crazyskater9/Diplomarbeit/5_TTVerstaerker.tex

\newpage
\section{Tieftöner-Verstärker}\label{kap:5.3}
\subsection{Allgemeines}\label{kap:5.3.1}
Nach dem Filtern des Signals soll dieses vor dem Abstrahlen am Lautsprecher verstärkt werden. Es wurde eine analoge Verstärker-Schaltung verwendet, da diese einfacher und mit weniger Problemen realisiert werden hat können. Mit Hilfe bereits bekannter, bewährter Schaltungen konnte ein Layout für diese Schaltung designet werden. Ein wichtiger Baustein in dieser Schaltung ist der Verstärker \enquote{TDA2030}, wie in Kapitel \ref{kap:5.3.3} beschrieben.  Des weiteren wurden zwei Leistungstransistoren verbaut die höhere Ströme schalten können, falls der maximale Schaltstrom des TDA2030 erreicht wird.

\subsection{Zielsetzung}\label{kap:5.3.2}
Das Eingangssignal soll Verstärkt werden um am Ausgang der Schaltung höhere Spannungs-Amplituden und höheren Ströme aufzuweisen. Es soll nach diesem Schritt möglich sein den Tieftöner in einer der zwei Satellitenboxen mit ausreichend Signal zu versorgen, um einen Schalldruck von zumindest Zimmerlautstärke zu erhalten. 

\subsection{TDA2030}\label{kap:5.3.3}
Der TDA2030 ist ein für den Audio-Frequenzbereich optimierter OPV. Dieser kann symmetrisch sowie auch asymmetrisch versorgt werden. Eine typische Beschaltung ist im Datenblatt auch vorgegeben, welche auch verwendet wurde. Der TDA2030 besitzt ein Pentawatt-Gehäuse, welches deshalb auch eine Kühlfläche besitzt. Diese Kühlfläche hat das selbe Potential wie der mittlere Anschlusspin (Abb. \ref{5.3.3.1}).\\
Es wird auch für geringfügigen Betrieb ein Kühlkörper empfohlen!
\begin{figure} [ht]
	\centering
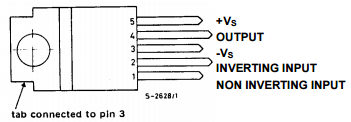
[picture p10: img/Print5/TDA2030Pinning.PNG]
	
	\caption{TDA2030-Pinning}
	\label {fig:abb5.3.3.1}
\end{figure}
\subsubsection{Absolute Maximalwerte}
Diese Werte wurden zu aller erst mit den Bedingungen an der Schaltung verglichen, da sie ein sehr genaue, kurze Übersicht über den Baustein liefern.
\begin{figure} [ht]
	\centering
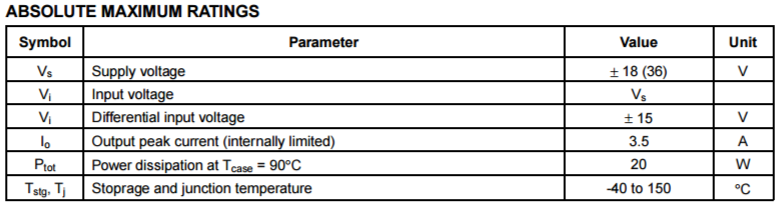
[picture p11: img/Print5/TDA2030MaximumRatings.PNG]
	
	\caption{TDA2030-Pinning}
	\label {fig:abb5.3.3.2}
\end{figure}

\begin{comment}
\begin{figure} [ht]
	\centering	
	
	\caption{Butterworth-Hochpass-Filter 2. Ordnung}
	\label {fig:abb5.2.3.2}
\end{figure}

\subsection{Schaltung}\label{kap:5.2.4}

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

\subsection{PCB}\label{kap:5.2.5}
Es wurden die grundlegenden Regeln zur Leiterplattenentflechtung angewandt (\ref{}). Bei dem Design (Abb. \ref{fig:abb5.2.5.1}) wurde auf hohe Variierbarkeit geachtet um auch zB. Kondensatoren mit unterschiedlichen Footprint verwenden zu können.\\
Es wurden wieder nahe an den IC's ELKOs in der Spannungsversorgungsleitung verbaut, um Störungen zu verhindern.

\begin{figure} [ht]
	\centering	
	
	\caption{Tieftöner- und Hochtönerweichen - PCB}
	\label {fig:abb5.2.5.1}
\end{figure}

\begin{comment}
%% Altium und Einstellungserklärung + Wichtige Layout-Faktoren
%Beim designen des Leiterplattenlayouts wurden die allgemeinen Altium-Einstellungen vorgenommen und auf die zu berücksichtigenden Layoutpunkte geachtet.
Beim \enquote{Layouten} der Schaltung mussten einige wichtige Faktoren berücksichtigt werden.\\
Wie da wären:\\
\begin{itemize}
	\item EMV-Technische-Faktoren, wie kurze Leiterbahnen
	\item Ausnützen der Printfläche
	\item Mehrfach-Footprints ermöglichen für verschiedene Bauteile
	\item Mechanische Aufhängebohrungen vorsehen
	\item Massefläche bei Möglichkeit vorsehen
\end{itemize}
Leiterplattenspezifische Einstellungen wurden aus den Kriterien der schuleigenen Leiterplattenfertigung übernommen. Zu diesen Einstellungen zählen:\\
\begin{itemize}
	\item Leiterbahnbreite
	\item Leiterbahnabstände untereinander
	\item Restring bei Bohrungen
	\item 
\end{itemize}
\end{comment}
