crazyskater9/Diplomarbeit/tex/Anhang.tex

\section{Arbeitsnachweis}\label{sec:8.9}
\responsible{Markus Bointner}
\subsection{Aufschlüsselung - Bointner}
\begin{figure} [H]
	\centering
	
\end{figure}
\begin{figure} [H]
	\centering
	
\end{figure}
\begin{figure} [H]
	\centering
	
\end{figure}

\newpage
\responsible{Andreas Macsek}
\subsection{Aufschlüsselung - Macsek}
\begin{figure} [H]
	\centering
	
\end{figure}
\begin{figure} [H]
	\centering
	
\end{figure}
\begin{figure} [H]
	\centering
	
\end{figure}

\newpage
\section{Fertigungsunterlagen - Elektronik}\label{sec:8.10}
\subsection{0\_BTAdapter}
\subsubsection*{Schaltung}
\begin{figure} [H]
	\centering
	
	\caption{0\_BTAdapter - Schaltung}
	\label {fig:8.10.1}
\end{figure}

\newpage
\subsubsection*{Bestückungsplan}
\begin{figure} [H]
	\centering
	
	\caption{0\_BTAdapter - Bestückungsplan}
	\label {fig:8.10.2}
\end{figure}

\subsubsection*{Stückliste}
\begin{figure} [H]
	\centering
	
	\caption{0\_BTAdapter - Stückliste}
	\label {fig:8.10.3}
\end{figure}

\subsection{1\_BTFrontplatine}
\subsubsection*{Schaltung}
\begin{figure} [H]
	\centering
	
	\caption{1\_BTFrontplatine - Schaltung}
	\label {fig:8.10.4}
\end{figure}

\newpage
\subsubsection*{Bestückungsplan}
\begin{figure} [H]
	\centering
	
	\caption{1\_BTFrontplatine - Bestückungsplan}
	\label {fig:8.10.5}
\end{figure}
\subsubsection*{Stückliste}
\begin{figure} [H]
	\centering
	
	\caption{1\_BTFrontplatine - Stückliste}
	\label {fig:8.10.6}
\end{figure}

\begin{sidewaysfigure}
	\subsection{2\_Hauptplatine}
	\subsubsection*{Schaltung}
	\begin{figure} [H]
		\centering
		
		\caption{2\_Hauptplatine - Schaltung}
		\label {fig:8.10.7}
	\end{figure}
\end{sidewaysfigure}

\begin{sidewaysfigure}
	\subsubsection*{Bestückungsplan}
	\begin{figure} [H]
		\centering
		
		\caption{2\_Hauptplatine - Bestückungsplan}
		\label {fig:8.10.8}
	\end{figure}
\end{sidewaysfigure}

\begin{sidewaysfigure}
	\subsubsection*{Stückliste}
	\begin{figure} [H]
		\centering
		
		\caption{2\_Hauptplatine - Stückliste}
		\label {fig:8.10.9}
	\end{figure}
\end{sidewaysfigure}

\begin{sidewaysfigure}
	\subsection{3\_mTT-Weiche und Addierer}
	\subsubsection*{Schaltung}
	\begin{figure} [H]
		\centering
		
		\caption{3\_mTT-Weiche und Addierer - Schaltung}
		\label {fig:8.10.10}
	\end{figure}
\end{sidewaysfigure}

\begin{sidewaysfigure}
	\subsubsection*{Bestückungsplan}
	\begin{figure} [H]
		\centering
		
		\caption{3\_mTT-Weiche und Addierer - Bestückungsplan}
		\label {fig:8.10.11}
	\end{figure}
\end{sidewaysfigure}

\begin{sidewaysfigure}
	\subsubsection*{Stückliste}
	\begin{figure} [H]
		\centering
		
		\caption{3\_mTT-Weiche und Addierer - Stückliste}
		\label {fig:8.10.12}
	\end{figure}
\end{sidewaysfigure}

\begin{sidewaysfigure}
	\subsection{4\_HTundTT-Weiche}
	\subsubsection*{Schaltung}
	\begin{figure} [H]
		\centering
		
		\caption{4\_HTundTT-Weiche - Schaltung}
		\label {fig:8.10.13}
	\end{figure}
\end{sidewaysfigure}

\begin{sidewaysfigure}
	\subsubsection*{Bestückungsplan}
	\begin{figure} [H]
		\centering
		
		\caption{4\_HTundTT-Weiche - Bestückungsplan}
		\label {fig:8.10.14}
	\end{figure}
\end{sidewaysfigure}

\begin{sidewaysfigure}
	\subsubsection*{Stückliste}
	\begin{figure} [H]
		\centering
		
		\caption{4\_HTundTT-Weiche - Stückliste}
		\label {fig:8.10.15}
	\end{figure}
\end{sidewaysfigure}

\begin{sidewaysfigure}
	\subsection{5\_TTVerstärker}
	\subsubsection*{Schaltung}
	\begin{figure} [H]
		\centering
		
		\caption{5\_TTVerstärker - Schaltung}
		\label {fig:8.10.16}
	\end{figure}
\end{sidewaysfigure}

\begin{sidewaysfigure}
	\subsubsection*{Bestückungsplan}
	\begin{figure} [H]
		\centering
		
		\caption{5\_TTVerstärker - Bestückungsplan}
		\label {fig:8.10.17}
	\end{figure}
\end{sidewaysfigure}

\begin{sidewaysfigure}
	\subsubsection*{Stückliste}
	\begin{figure} [H]
		\centering
		
		\caption{5\_TTVerstärker - Stückliste}
		\label {fig:8.10.18}
	\end{figure}
\end{sidewaysfigure}

\begin{sidewaysfigure}
	\subsection{6\_HTVerstärker}
	\subsubsection*{Schaltung}
	\begin{figure} [H]
		\centering
		
		\caption{6\_HTVerstärker - Schaltung}
		\label {fig:8.10.19}
	\end{figure}
\end{sidewaysfigure}

\subsubsection*{Bestückungsplan}
	\begin{figure} [H]
		\centering
		
		\caption{6\_HTVerstärker - Bestückungsplan}
		\label {fig:8.10.20}
	\end{figure}

\begin{sidewaysfigure}
	\subsubsection*{Stückliste}
	\begin{figure} [H]
		\centering
		
		\caption{6\_HTVerstärker - Stückliste}
		\label {fig:8.10.21}
	\end{figure}
\end{sidewaysfigure}

\newpage
\section{Fertigungsunterlagen - Mechanik}\label{sec:8.11}
Es wurden 19 mm Rohspanplatten verwendet.
\subsection{Subwooferbox}
Die Box hat ein Gesamtinnenvolumen von 72 l, mit Ausnehmung 59 l.\\
Benötigte Platten:
\begin{itemize}
	\item Vorderseite: 400 x 438 x 19 [mm]
	\item Rückseite: 400 x 250 x 19 [mm]
	\item Ober- und Unterseite: 400 x 450 x 19 [mm]
	\item Linke und rechte Seite: 488 x 438 x 19 [mm]
	\item Schacht-Oben: 400 x 239 x 19 [mm]
	\item Schacht-Vorne: 400 x 169 x 19 [mm]
\end{itemize}
In der Vorderseite wird zentriert ein rundes Loch, mit dem Durchmesser 30 cm, für den Subwoofer vorgesehen.\\
Die Rückseite ist verkürzt, um eine Ausnehmung und somit den Platz für den Elektronikeinschub zu gewährleisten.
Dieser Schacht ist von Spanplatten umschlossen, damit das Gehäuse auch ohne Elektronikeinschub luftdicht verschlossen ist.
\begin{figure} [H]
	\centering
	
	\caption{Subwooferbox - 3D}
	\label {fig:8.11.1}
\end{figure}

\subsection{Elektronikeinschub}
Der Einschub hat ein Volumen von 13 l.\\
Benötigte Platten:
\begin{itemize}
	\item Unterseite: 400 x 220 x 19 [mm]
	\item Linke und rechte Seite: 120 x 220 x 19 [mm]
	\item Vorderseite: 400 x 170 x 3 [mm]
\end{itemize}
Die hellen Flächen geben die Ausschnitte/Löcher vor.\\ \\
\begin{figure} [H]
	\centering
	\subfloat{}\quad
	\subfloat{}
	\caption{Elektronikeinschub - 3D (links) \& 2D (rechts)}
	\label{fig:8.11.2}
\end{figure}

\newpage
\subsection{Satellitenbox}
Die Box hat ein Innenvolumen von 9 l.\\
Benötigte Platten:
\begin{itemize}
	\item Vorder- und Rückseite: 180 x 318 x 19 [mm]
	\item Ober- und Unterseite: 180 x 180 x 19 [mm]
	\item Linke und rechte Seite: 318 x 218 x 19 [mm]
\end{itemize}
In der Vorderseite sind zwei runde Löcher vorgesehen um einen Hochton-Lautsprecher mit 6 cm Durchmesser und einen Tieftonlautsprecher mit 15 cm Durchmesser montieren zu können.

\begin{figure} [H]
	\centering
	
	\caption{Subwooferbox - 3D}
	\label {fig:8.11.4}
\end{figure}

\newpage
\section{Datenblätter}\label{sec:8.2}
\subsection{TDA2030}\label{subsec:8.3.5}
\begin{figure} [H]	
	\centering
	
\end{figure}
\includepdf[pagecommand={},pages={2-12}, noautoscale =true, scale = 0.77]{form/tda2030.pdf}
\begin{sidewaysfigure}
	\subsection{Datenblatt - Renkforce B12123}\label{sec:8.7}
	\begin{figure} [H]
		\centering
		
	\end{figure}
\end{sidewaysfigure}
\begin{sidewaysfigure}
	\begin{figure} [H]
		\centering
		
	\end{figure}
\end{sidewaysfigure}

%\newpage
\subsection{Visaton DTW 72-8}\label{sec:8.8}
\begin{figure} [H]	
	\centering
	
\end{figure}

\begin{comment}
\section{Filter}\label{sec:8.4}
Es wurde nach einem möglichst steilen, im Durchlassbereich linearen und einfachen Filter gesucht.
Man hat sich für ein \enquote{Aktives-Filter 2.Ordnung} entschieden, dabei wurde die \enquote{Butterworth-Schaltung} bevorzugt.
Wegen seiner geringen Welligkeit im Durchlassbreich und einer Dämpfung von $\frac{-20dB}{Dek.}$ .
Dies bedeutet, dass bei einer Tiepfass-Filterung eine Frequenz die 10mal größer ist als die Grenzfrequenz einen um $\frac{1}{10}$ kleineren Pegel aufweist, als die Grenzfrequenz.\\
\end{comment}

\section{Ergänzende Informationen}\label{sec:8.1}
\begin{comment}
{\newpage
\section{TDA2030}\label{sec:8.3}
Der TDA2030 ist ein für den Audio-Frequenzbereich optimierter OPV.
Dieser kann symmetrisch sowie auch asymmetrisch versorgt werden.
Eine typische Beschaltung ist im Datenblatt auch vorgegeben, welche auch verwendet wurde.
Der TDA2030 besitzt ein Pentawatt-Gehäuse, welches eine Kühlfläche besitzt.
Diese Kühlfläche hat das selbe Potential wie der mittlere Anschlusspin (Abb. \ref{fig:8.3.1}).\\
Es wird auch für geringfügigen Betrieb ein Kühlkörper empfohlen!
\begin{figure} [H]
\centering

\caption[TDA2030-Pinning]{TDA2030-Pinning\footnotemark}
\label {fig:8.3.1}
%http://www.itisff.it/dip_eln/tda2030.pdf --> SnippingTool
\end{figure}
\footnotetext{http://www.itisff.it/dip\_eln/tda2030.pdf,\\Zugriff: 16.02.2017}
\begin{enumerate}
\item Noninverting Input = Plus-Eingang des Verstärkers
\item Inverting Input = Minus-Eingang des Verstärkers
\item -Vs = negative Versorgungsspannung (bzw. Masse)
\item Output = Verstärkerausgang
\item +Vs = positive Versorgungsspannung		
\end{enumerate}}

%\newpage
\subsection{Absolute Maximalwerte}\label{subsec:8.3.1}
Diese Werte wurden zu aller erst mit den Bedingungen an der Schaltung verglichen, da sie ein sehr genaue, kurze Übersicht über den Baustein liefern. (Abb. \ref{fig:8.3.1.1})
\begin{figure} [H]
\centering

\caption[TDA2030-Maximum Ratings]{TDA2030-Maximum Ratings\footnotemark}
\label {fig:8.3.1.1}
%http://www.itisff.it/dip_eln/tda2030.pdf --> SnippingTool
\end{figure}
\footnotetext{http://www.itisff.it/dip\_eln/tda2030.pdf,\\Zugriff: 16.02.2017}
\end{comment}

\subsection{TDA2030-Grundschaltung}\label{subsec:8.3.2}
Ein wichtiges Bauelement in der Grundschaltung (Abb. \ref{fig:8.3.2.1}) sind die Dioden. Sie schützen den angeschlossenen Lautsprecher vor Überspannungsspitzen.\\
Der Spannungsteiler am Plus-Eingang (Pin1) des OPVs legt den Arbeitspunkt des TDA2030 fest.
In diesem Fall, bei asymmetrischer Versorgung, soll dieser $\frac{Vcc}{2}$ betragen.\\
Das Widerstandsverhältnis am Minus-Eingang (Pin2) des OPVs, von 150 kOhm zu 4,7 kOhm, liefert die Verstärkung der Schaltung.
Hier ist es dementsprechend eine Verstärkung von ungefähr x32 .\\
Viele vereinzelte Kondensatoren sind zum Entstören und gegen mögliches Schwingen der Schaltung vorgesehen.\\
Der Große-Ausgangs-ELKO wird deshalb verbaut, um keine verschleppte Gleichspannung am Lautsprecher unnötigerweise anzulegen.
Gleichspannung ist an einem Lautsprecher weder hörbar (Frequenz = 0 Hz), noch sinnvoll, und kann den Lautsprecher beschädigen.
Der Kondensator lädt sich einmal mit dieser Gleichspannung auf, und lässt die Wechselspannung ohne weiteres passieren.\\\\
Ein weiteres wesentliches Bauelement ist das \enquote{Boucherot-Glied}, ein in Serie geschalteter Kondensator und Widerstand, von der Ausgangsleitung des Verstärkers gegen Masse, noch vor dem Ausgangs-ELKO.
Es dient zur Widerstandsanpassung im höheren Audio-Frequenzbereich, da der Lautsprecher einen induktiven Impedanzabfall aufweist, wird dieser mit dem kapazitiven Impedanzanstieg in diesem Bereich kompensiert.
So bleibt die Impedanz im Arbeitsbereich des Verstärkers im wesentlichen die selbe.
Ein weiterer Vorteil ist, dass Frequenzen über der Grenzfrequenz des \enquote{Boucherot-Glieds} wie ein Kurzschluss behandelt werden. 
Mögliche auftretende Schaltfrequenzen werden so gedämpft, und andere folgende Schaltungen können nicht beeinflusst werden.
\\\\
Die Schaltung ist grundsätzlich für symmetrische und asymmetrische Versorgungsspannung ausgelegt. 
Die Schaltung ist für 4 und 8 Ohm Lautsprecher spezifiziert.
\newpage
\begin{figure} [H]
	\centering
	
	\caption[TDA2030-Grundschaltung]{TDA2030-Grundschaltung\footnotemark}
	\text (Die im Bild vorhandenen Werte müssen nicht der entwickelten Schaltung entsprechen. Es dient nur zur Veranschaulichung der Schaltung.)
	\label {fig:8.3.2.1}
	%http://www.mikrocontroller.net/attachment/79272/Schaltung.png
\end{figure}
\footnotetext{http://www.mikrocontroller.net/attachment/79272/Schaltung.png,\\Zugriff: 16.02.2017}

\newpage
\subsection{TDA2030 mit externem Stromverstärker}\label{subsec:8.3.3}
Durch das Erweitern der TDA2030-Grundschaltung (Kap. \ref{subsec:8.3.2}) mit zwei Leistungstransistoren, wird die Schaltung leistungsfähiger.
Die Transistoren schalten Ströme über den maximalen schaltbaren Strömen des TDA2030. Während des Normalbetriebes fließt kein Strom durch die Transistoren, sobald aber eine Grenze erreicht wird, wird grundsätzlich mit den Transistoren gearbeitet.
Um die Schaltschwelle der Leistungstransistoren festzulegen, wird ein kleiner Widerstand von der Versorgungsspannung gegen den Basis-Anschluss des Transistors geschallten.
Beziehungsweise wird dieser Widerstand von der Negativen Versorgungsspannung, oder in diesem Fall von Masse, gegen den Basis-Anschluss des Leistungstransistors geschaltet.
Des weiteren sind die Leistungstransistoren im besten Fall aus der selben Familie.
Verwendet wird ein PNP-Leistungstransistor für die positive Halbwelle des Signals, und ein NPN-Leistungstransistor für die negative Halbwelle.
\begin{figure} [H]
	\centering
	
	\caption[TDA2030 mit externem Stromverstärker]{TDA2030 mit externem Stromverstärker\footnotemark}
	\text (Die im Bild vorhandenen Werte müssen nicht der entwickelten Schaltung entsprechen. Es dient nur zur Veranschaulichung der Schaltung.)
	\label {fig:8.3.3.1}
	%http://www.audiofanatic.it/Schemi/Tipo/Stato_solido/chip/pic_chip/TDA_2030_BD711_712.jpg
\end{figure}
\footnotetext{http://www.audiofanatic.it/Schemi/Tipo/Stato\_solido/chip/pic\_chip/TDA\_2030\_BD711\_712.jpg,\\Zugriff: 16.02.2017}

\newpage
\subsection{TDA2030 in Brückenschaltung}\label{subsec:8.3.4}
Um noch mehr aus dem TDA2030 herauszuholen, kann man zwei dieser Verstärker in Brücke (Abb. \ref{fig:8.3.4.1}) gegeneinander schalten.
Ein TDA2030 verstärkt das originale Signal, währenddessen der Zweite das um 90° phasenverschobene Signal erhält und dieses verstärkt.
Dies hat zur Folge das, während der eine TDA2030 die positive Halbwelle verstärkt, der zweite die negative Halbwelle verstärkt.
Dies bewirkt einen größeren Hub, da der eine Verstärker bei maximaler Auslenkung die positive Versorgungsspannung erreicht, während der zweite die negative Versorgungsspannung erreicht.
So erhält man mit zwei TDA2030 den doppelten Ausgangspegel des Signals.\\
Einziger Nachteil dieser Konstellation: Zwischen den beiden Verstärkern gibt es keinen Massebezug.
Beim Messen der Schaltung ist Vorsicht geboten, da beim Anschließen der Tastkopf-Masse, je nach anliegendem Signal, der eine oder der andere Verstärker beschädigt werden kann (Kurzschluss!).\\
Es kann in diesem Fall auch die mit externem Stromverstärker erweiterte Schaltung in Brücke geschaltet werden, um noch mehr aus der Sache herauszuholen.
\begin{figure} [H]
	\centering
	
	\caption[TDA2030 in Brückenschaltung]{TDA2030 inBrückenschaltung\footnotemark}
	\text (Die im Bild vorhandenen Werte müssen nicht der entwickelten Schaltung entsprechen. Es dient nur zur Veranschaulichung der Schaltung.)
	\label {fig:8.3.4.1}
	%http://www.itisff.it/dip_eln/tda2030.pdf --> SnippingTool
\end{figure}
\footnotetext{http://www.itisff.it/dip\_eln/tda2030.pdf,\\Zugriff: 16.02.2017}

\subsection{Butterworth-Filter 2. Ordnung}\label{subsec:8.4.1}
Die Grundschaltung eines \enquote{Butterworth-Filters 2. Ordnung} ist für verschiedene Grenzfrequenzen dieselbe, lediglich die Bauteilwerte variieren.
Auch die Schaltung der verschiedenen Grundfilterarten ist unterschiedlich. \\
Die da wären: 
\begin{itemize}
	\item Hochpass-Filter
	\item Tiefpass-Filter
	\item Bandpass-Filter
\end{itemize}
Ein Butterworth-Tiefpass-Filter 2. Ordnung besteht hauptsächlich aus einem OPV, drei Widerständen und zwei Kondensatoren.
Deren Anordnung ist ausschlaggebend für das Tiefpass-Filter (Abb. \ref{fig:8.4.1.1}).
Dieses Filter lässt alle Frequenzen unterhalb seiner Grenzfrequenz durch.\\ 
Bedingt durch das Beschalten des OPVs, wird das Ausgangssignal invertiert, was hier keine gröberen Folgen mit sich bringt.\\ 
Am Plus-Eingang des OPVs wird entweder Masse bei symmetrischer Spannungsversorgung, oder $\frac{Vcc}{2}$ bei asymmetrischer Spannungsversorgung angelegt.
\begin{figure} [H]
	\centering
	
	\caption{Butterworth-Tiefpass-Filter 2. Ordnung}
	\label {fig:8.4.1.1}
	%Selbst generiert in Altium
\end{figure}
Das Bandpass-Filter (Abb. \ref{fig:8.4.1.2}) besteht aus drei Widerständen, zwei Kondensatoren und einem OPV, jedoch mit anderer Anordnung als bei dem Tiefpass-Filter.
Dieses Filter lässt alle Frequenzen oberhalb seiner Unteren-Grenzfrequenz und unterhalb seiner Oberen-Grenzfrequenz durch.
\begin{figure} [H]
	\centering
	
	\caption{Butterworth-Bandpass-Filter 2. Ordnung}
	\label {fig:8.4.1.2}
	%Selbst generiert in Altium	
\end{figure}
Das Hochpass-Filter (Abb. \ref{fig:8.4.1.3}) hat wieder eine ähnliche Konstruktion.
Dieses besteht aus drei Kondensatoren, zwei Widerständen und einem OPV.
Wiederum mit bestimmter Anordnung.
Dieses Filter lässt alle Frequenzen oberhalb seiner Grenzfrequenz durch.
\begin{figure} [H]
	\centering	
	
	\caption{Butterworth-Hochpass-Filter 2. Ordnung}
	\label {fig:8.4.1.3}
	%Selbst generiert in Altium	
\end{figure}

\subsection{Nicht invertierende Verstärker - OPV-Grundschaltung}\label{sec:8.5}
Die hauptsächlichen Eigenschaften eines solchen Verstärkers liegen in der Phasengleichheit am Ein- und Ausgang der Schaltung und am wichtigsten, in der Verstärkung. \\
Um eine Verstärkung zu erhalten, wird am invertierten Eingang (Abb. \ref{fig:8.5.1}), oder umgänglicher am Minus-Eingang des OPV, ein Rückkopplungsnetz aus zwei Widerständen gebaut.
Diese bewirken, dass eine Verstärkung \enquote{Vu} möglich ist.
Diese wird wie folgt berechnet: Vu = $\frac{R2+R1}{R1}$ .
Aus der Formel geht hervor, dass R2 im Verhältnis zu R1 normalerweise größer sein sollte, um eine nennenswerte Verstärkung zu erhalten.
Die Verstärkung funktioniert aus einem einfachen Grund.
Wenn am Eingang ein Signal anliegt, möchte der OPV nach seiner Natur den selben Wert wie am + Eingang auch am - Eingang haben, er regelt nach.
Das heißt, der Spannungsunterschied Upn soll gegen 0 gehen.
Wird nun künstlich das Nachregeln beeinflusst, indem man einen Spannungsteiler einbaut, regelt der OPV den Ausgang höher, als er eigentlich müsste, er Verstärkt also.
Der Verstärker ist jedoch durch seine Versorgungsspannung begrenzt, das soll heißen wenn man eine Verstärkung von 10 erwartet, bei einem Eingangssignal von 1 Volt und einer Versorgungsspannung von 5 Volt, dann ist das Signal nie 10 Volt groß.
Ein OPV-Verstärker kann auch übersteuert werden.
Das passiert, wenn man ihn, wie bereits vorher erläutert, zuviel Eingangssignal liefert, in Abhängigkeit zu der Verstärkung und der Versorgungsspannung.
So kommt es, wenn der OPV übersteuert ein Sinus kein Sinus mehr ist, sonder vielleicht gar zum Rechteck wird, da die Ober- und Untergrenze die positive und negative Versorgungsspannung bietet.
\begin{figure} [H]
	\centering	
	
	\caption[Nicht invertierender Verstärker - OPV-Grundschaltung]{Nicht invertierender Verstärker - OPV-Grundschaltung\footnotemark}
	\label {fig:8.5.1}
	%http://www.elektronik-kompendium.de/sites/slt/schalt/02101511.gif
\end{figure}
\footnotetext{http://www.elektronik-kompendium.de/sites/slt/schalt/02101511.gif,\\Zugriff: 16.02.2017}

\subsubsection*{Asymmetrische Versorgung eines OPV's}\label{subsec:8.5.1}
Beim Arbeiten mit OPV-Verstärkerschaltungen muss die Symmetrie der Verstärkung beachtet werden.
Bei einer asymmetrischen Versorgung muss daher beachtet werden, dass ein bestimmter Arbeitspunkt eingestellt wird.
Dieser ist dazu da, um die Asymmetrie durch die Spannungsversorgung wieder auszugleichen.
Dafür wird am Eingang ein Spannungsteiler dimensioniert, welcher inmitten von diesem $\frac{Vcc}{2}$ erzeugt.
Dies erfolgt über zwei gleichgroße Widerstände, die zumeist im Bereich vom Kilo-Ohm liegen.
Sie werden in Serie von Vcc gegen Masse gelegt, somit kann zwischen den beiden Widerständen $\frac{Vcc}{2}$ abgegriffen werden.
Somit liegt der Eingangssignalgrundpegel inmitten der Versorgungsspannung.
D.h. der Spannungsunterschied zur positiven Versorgungsspannung ist derselbe wie zur negativen Versorgungsspannung (Masse). 

\newpage
\subsection{Welligkeit} \label{sec:8.6}
Die Welligkeit gibt den Toleranzbereich um einen idealen (linearen) Frequenzgang an.
Das bedeutet, wenn ein Weißes-Rauschen mit einem definierten Pegel an der Membran wiedergegeben wird, darf der Pegel über den Frequenzverlauf im Welligkeitsbreich variieren, ohne dass es als kritisch empfunden werden muss. \\
Für Lautsprechermessungen ist eine Welligkeit im \enquote{Consumer-Bereich} von 10 dB und im \enquote{HiFi-Bereich} von 6 dB üblich.
So darf ein Consumer-Lautsprecher bei einem definierten Pegel von 80 dB über den ganzen Messbereich maximal +/- 5 dB variieren, d.h. im Bereich zwischen 75 dB und 85 dB.
Fällt der Pegel viel mehr als der definierte Welligkeitsbereich, wird der Lautsprecher zumeist gefiltert.
Dadurch ist es möglich einen anderen Lautsprecher, ohne Interferenzen, diesen Bereich übernehmen zu lassen und die Schwäche des anderen auszubessern.\\ \\
Ziel eines Lautsprechersystems ist es, über den ganzen Audiobereich, 20 Hz bis 20 kHz, einen linearen bzw. näherungsweise linearen Frequenzgang zu erhalten.

\begin{figure} [H]
	\centering
	
	\caption{PSS 297 58206 (\enquote{TT1}) ohne Volumsverminderung \\Volumen = 13,72 l}
	\label{fig:8.6.1}
\end{figure}

In diesem Fall (Abb. \ref{fig:8.6.1}) würde man diesen Lautsprecher nur von ungefähr 60 Hz bis 400 Hz, unter beachten der Grenzen, spielen lassen.
In der Praxis werden kleinere Ausreißer toleriert, sofern es sich nicht um ein Qualitätsprodukt handelt.\\ \\

\subsection{Einstellungen für die PCB-Entwicklung in \enquote{Altium Designer}}\label{subsec:8.1}
%% Altium und Einstellungserklärung + Wichtige Layout-Faktoren
%Beim designen des Leiterplattenlayouts wurden die allgemeinen Altium-Einstellungen vorgenommen und auf die zu berücksichtigenden Layoutpunkte geachtet.
Beim \enquote{Layouten} der Schaltung in \enquote{Altium Designer} mussten einige wichtige Einstellungen vorab getätigt werden:
\begin{itemize}
	\item Arbeiten mit der Metrischen Einheit \enquote{mm}
	\item Layers benennen nach Vorgaben der Leiterplattenfertigung
	\item Kupferabstände
	\item Kupferbreite
	\item Lochdurchmesser und Restringeinstellungen für Vias
	\item Wärmefallen
	\item Restring für Pads
	\item Lochdurchmesser für Pads
\end{itemize}

Beim Entwickeln einer Leiterplatte musste ständig auf wichtige Faktoren geachtet werden, um eine Durchwegs EMV konforme, elektrisch wie auch mechanisch stabile und Teils variable Schaltung zu erhalten.
Variabel daher, weil es keine Prints für Serienreife sind, welche im Notfall auch mit anderen Bauteilen, als den zuvor Vorgesehenen, bestückt werden können.\\
Zu den Wichtigen Faktoren zählen:
\begin{itemize}
	\item EMV-Technische-Faktoren
	\begin{itemize}
		\item Kurze Leiterbahnen
		\item Durchdachtes Spannungsversorgungsnetz
		\item Kleine Leiterschleifen
		\item Massefläche verwenden
		\item Anordnung der Bauteile
	\end{itemize}
	\item Ausnützen der Printfläche
	\item Mehrfach-Footprints ermöglichen für verschiedene Bauteile
	\item Mechanische Aufhängebohrungen vorsehen (in jeder Ecke des Prints)
	\item Beschriftung bei Möglichkeit vorsehen
\end{itemize}
