crazyskater9/Diplomarbeit/tex/einleitung.tex

In diesem Kapitel wird erläutert, wie die Idee für diese Diplomarbeit entstanden ist und warum sie auch so verwirklicht wurde.

\section{Erste Idee} \label{sec:1.1}
Das Grundkonzept stammt von uns, also Markus Bointner und Andreas Macsek. Da wir beide von Musik begeistert sind, war es eine sehr interessante Idee für uns, selbst ein Lautsprechersystem zu entwickeln. Gleich zu Beginn war klar, dass wir noch ein kleines Extra mit einbauen wollen: eine Bluetooth-Ansteuerung.

\section{Weiterführende Gedanken} \label{sec:1.2}
Um all unsere Ideen zu verwirklichen, haben wir entschieden, diese Diplomarbeit ohne Firma und für den privaten Gebrauch zu entwickeln. Genauer gesagt ist das Lautsprechersystem dafür gedacht, im Freien oder in größeren Räumen Musik für kleinere Menschenmengen bereitzustellen. Das soll auch ohne Netzanschluss funktionieren. Aus diesem Grund entstand dann die Idee einen Akku zu verbauen. Über ein BT-Modul kann sowohl das Musiksignal in das Gerät eingespeist werden, als auch die Signalquelle (Smartphone) bedient werden.
