crazyskater9/Diplomarbeit/tex/Frequenzweichen.tex

%TD - Da die Verstärker in der Hierachie oberbei stehen und aus drei Teilen bestehen, beginnt hier die Section mit 5.4

%TD -- Kapitel 5.4 und 5.5 -- alle Labels darauf aufbauend

\newpage
\section{Frequenzweichen}
\responsible{Andreas Macsek}
In den folgenden Schaltungen kommen Bauteile vor, welche mit einem roten Kreuz durchgestrichen wurden.
Dies bedeutet, dass diese Bauteile nicht benötigt und daher offen gelassen wurden.
\subsection*{Tiefton- und Hochton-Weiche}\label{sec:5.4}
\subsubsection{Allgemeines}\label{subsec:5.4.1}
Für die Satellitenlautsprecher, welche aus einem Hochton-Lautsprecher und einem Tiefton-Lautsprecher bestehen, werden nun die Teilfrequenzbereiche Mitte und Hoch benötigt.
Da es sich bei den Satellitenboxen um ein Paar handelt und diese räumlich weiter entfernt voneinander stehen, können nun Stereo-Effekte verwendet werden.
Daher wird mit dem reinen Stereo-Audio-Eingangssignal gearbeitet.
\\ \\
Eine Aufteilung des Signals in linke und rechte Satellitenbox muss jedoch schon getroffen werden, um die Effekte richtig zu erhalten.
Dafür wird für die linke und rechte Satellitenbox, jeweils bestehend aus Hochton- und Tiefton-Lautsprecher, eine entsprechende Weiche verwendet.
\\ \\
Das Audiosignal soll so gefiltert werden, dass der Hochton-Lautsprecher nur Frequenzen über 1,5kHz und der Tiefton-Lautsprecher Frequenzen bis 6kHz zum Abstrahlen erhält.
Obwohl es den Mono-Subwoofer gibt, der die untersten Frequenzen (<150Hz) abzustrahlen hat, dürfen die Satelliten-Tiefton-Lautsprecher im selbigen Bereich ebenfalls arbeiten.
Somit wird die abstrahlende Fläche vergrößert und freiwerdende absolute Pegel höher.
Bei dem Satelliten-Tiefton-Lautsprecher wird jedoch ein Bandpass vorgesehen, um bei möglichen Resonanzen mit dem Mono-Subwoofer das Audiosignal zu filtern.
\\
Dementsprechend sollen die Weichen gewählt und entwickelt werden.
\\

\subsubsection{Schaltung}\label{subsec:5.4.2}
Das Eingangssignal (Links, Rechts, Masse) wird an einer dreipoligen Stiftleiste angeschlossen (Abb. \ref{fig:5.4.2.1}).
Zuerst gelangt das linke und rechte Signal an jeweils ein Potentiometer, um den Pegel anpassen zu können, es bietet also eine Regelmöglichkeit.
Über das Widerstandsnetzwerk am Plus-Eingang von HTA, welcher mit jedem Plus-Eingang der anderen OPVs verbunden ist, wird der Arbeitspunkt eingestellt (Kap. \ref{subsec:8.5.1}). 

%\\ \\
\newpage
Es folgen die Weichen.
Hochpass-Weiche für Links/Rechts und Tiefpass-Weiche für Links/Rechts.
Ein \enquote{Butterworth-Tiefpass 2. Ordnung} wird im Kapitel \ref{subsec:8.4.1} erklärt.
Der \enquote{Butterworth-Hoch- und Bandpass 2. Ordnung} weist keine groben Unterschiede auf, der Unterschied liegt lediglich in der Bauteilaufteilung.
%\newpage
Nach der Weiche gelangen die frequenzmäßig getrennten Signale zu deren Ausgangspunkt. Es ist für jede Signalleitung eine zweipolige Stiftleiste vorgesehen (Signal \& Masse), da der darauffolgende Verstärker selbige Verbindung als Eingang vorweist.
Die Stiftleisten sind jedoch gruppiert nach Bandpass- und Hochpass-Ausgang.
\begin{figure} [H]
	\centering	
	
	\caption{Butterworth-Bandpass-Weiche 2. Ordnung}
	\label {fig:5.4.2.1}
\end{figure}

\newpage
Eine der Bandpass-Weichen is in Abb. \ref{fig:5.4.2.2} dargestellt.
Gut sichtbar ist die doppelte, parallele Ausführung von Widerständen und Kondensatoren, um auch krumme Werte zu ermöglichen.
%Bedingt durch Parallel-Schaltung von Widerständen und Kondensatoren.\\ 
Der Eingang wurde gespiegelt, um ein schöneres Bild zu erhalten.
Die Spiegelung ist für das PCB-Layout nicht relevant!\\
Bedingt durch die Versorgungsspannung ist auch der Spannungsteiler für $\frac{Vcc}{2}$ am Plus-Eingang des OPVs implementiert.
\begin{figure} [H]
	\centering	
	
	\caption{Butterworth-Bandpass-Weiche 2. Ordnung - aus Abb.\ref{fig:5.4.2.1}}
	\label {fig:5.4.2.2}
\end{figure}
%\newpage
Am B-Teil des OPVs (erkennbar an der Beschriftung: TT\enquote{B}) ist keine Versorgungsspannung einzuzeichnen, da er mit dem A-Teil einen achtpinnigen IC mit zwei integrierten OPVs ergibt.
Die zwei Teile sind über das IC-Gehäuse mit der gleichen Versorgungsspannung verbunden, deshalb ist das einmalige Kennzeichnen ausreichend.\\
\begin{figure} [H]
	\centering	
	
	\caption{Butterworth-Bandpass-Weiche 2. Ordnung - aus Abb.\ref{fig:5.4.2.1}}
	\label {fig:5.4.2.3}
\end{figure}

\newpage
\subsubsection{PCB}\label{subsec:5.4.3}
Es werden die grundlegenden Regeln zur Leiterplattenentflechtung angewandt (Kap. \ref{subsec:8.1}).
Bei dem Design (Abb. \ref{fig:5.4.3.1}) wird auf hohe Variierbarkeit geachtet, um auch zB. Kondensatoren mit unterschiedlichen Gehäuse (engl. \enquote{Footprint}) verwenden zu können.\\
Es wurden ebenfalls nahe an den OPVs ELKOs \enquote{EL401, EL402} zwischen Versorgungsspannung und Masse verbaut, um Störungen zu verhindern.
\begin{figure} [H]
	\centering	
	
	\caption{Tiefton- und Hochtonweichen - PCB}
	\label {fig:5.4.3.1}
\end{figure}

%---------------------------------------------------------------------------------%

\newpage
\subsection*{Mono-Subwoofer-Addier-Schaltung und Mono-Subwoofer-Weiche}\label{sec:5.5}
\subsubsection{Allgemeines}\label{susec:5.5.1}
Das empfangene Audio-Signal muss für das Lautsprecher-System aufgetrennt werden, und zwar in Hoch-, Mitte- und Tiefton-Bereich.
Für den \enquote{Mono-Subwoofer} werden nur die tiefen Frequenzen des Audiosignals verwendet.
Da, wie der Name schon sagt, es sich um einen \enquote{Mono-Subwoofer} handelt, muss das Stereo-Audio-Signal zuvor mittels OPV-Addierschaltung addiert werden, um ein Mono-Audio-Signal zu erhalten.\\
Es wird eine Platine angefertigt, welche über eine OPV-Addierschaltung verfügt und des weiteren das eintreffende Audio-Signal über eine Weiche, passend für den \enquote{Mono-Subwoofer}, filtert.
Diese Schaltung für die Tiefpass-Weiche muss variabel entwickelt werden. Die Tiefpass-Weiche muss unabhängig vom Platinendesign, nur durch Ändern von Bauteilwerten, andere Grenzfrequenzen umsetzen können.

\subsubsection{Schaltung}\label{subsec:5.5.2}
Passend dem Signalverlauf sitzt am Beginn der Schaltung (Abb. \ref{fig:5.5.2.1}) die erste Regelung über zwei Potentiometer.
Anschließend kommt man zu der Addier-Schaltung, welche das Stereo-Audiosignal in ein Mono-Audiosignal wandelt und dadurch Stereo-Effekte wie zB. Balance am \enquote{Mono-Subwoofer} entfernt.\\
Bedingt durch die asymmetrische Spannungsversorgung muss am Plus-Eingang des OPV ein Arbeitspunkt eingestellt werden (Kap. \ref{subsec:8.5.1}).\\
Um Störungen im OPV zu vermeiden, wird sehr nahe an diesem der ELKO \enquote{EL301} zwischen Versorgungsspannung und Masse eingesetzt.\\
Nach Addieren des Stereo-Audiosignals zu einem Mono-Audiosignal kommt dieses zur aktive Tiefpass-Weiche.
Bevor das gefilterte Signal weiter zum Verstärker läuft, wird nochmals die Möglichkeit geboten die Amplitude des Signals anzupassen.
\begin{sidewaysfigure}
	\begin{figure} [H]
		\centering
		
		\caption{Schematic Mono-Subwoofer-Addier-Schaltung und Mono-Subwoofer-Weiche}
		\label {fig:5.5.2.1}
	\end{figure}
\end{sidewaysfigure}

\newpage
\subsubsection{PCB}\label{subsec:5.5.3}
An einer der vier Seiten der Leiterplatte (Abb. \ref{fig:5.5.3.1}, in diesem Fall: Unten) wurden alle wesentlichen Ein- und Ausgänge platziert: eine dreipolige Eingangsstiftleiste für Rechts, Links und Masse sowie eine zweipolige Ausgangsstiftleiste für Signal und Masse.
Es dürfen bei Ein- und Ausgang noch Stiftleisten verwendet werden, da es sich hier noch um geringe Spannungen und Ströme handelt.\\
Des weiteren darf die Spannungsversorgung nicht fehlen.
Wegen größeren Spannungen wurden massivere Stecker verwendet.
In diesem Fall handelt es sich um steckbare Pol-Klemmen.
Zum Testen wurde ein zusätzlicher Masse-Printstift angebracht, um bei Messungen mit einem Oszilloskop einen besseren Massebezugspunkt zu erhalten.\\
Die Bauteile wurden nach Möglichkeit gestaffelt bzw. gruppiert auf der Leiterplatte platziert, um den Platzbedarf zu minimieren.\\
Es wurde grundsätzlich auf jeder Platine versucht, mithilfe einer geeigneten Beschriftung die Handhabung für Außenstehende mit der Platine ebenfalls zu ermöglichen. Masse wurde selten beschriftet, da eine Massefläche verwendet wurde und daher die Masseverbindungen sehr gut ersichtlich sind.
\begin{figure} [H]
	\centering
	
	\caption{PCB}
	\label {fig:5.5.3.1}
\end{figure}
