crazyskater9/Diplomarbeit/tex/BetriebswirtschaftlicherTeil.tex

\section{Kostenrechnung}	
\begin{figure} [H]
	\centering
	
\end{figure}
\begin{figure} [H]
	\centering
	
\end{figure}
\begin{figure} [H]
\centering

\end{figure}
\begin{figure} [H]
	\centering
	
\end{figure}
