crazyskater9/Diplomarbeit/tex/danksagungen.tex

\newpage
\begin{acknowledgements}
    Wir bedanken uns bei
    \subparagraph{Prof. Dipl.-Ing. Dr. Herbert Wagner} für die tatkräftige Unterstützung und das ermöglichen eines einwandfreien Arbeitens an unserer Diplomarbeit und dem Projekt.
    %\subparagraph{FL Ing. DEFG} für ...
\end{acknowledgements}
