crazyskater9/Diplomarbeit/form/betreuungsprotokoll.docx

Betreuungsprotokoll zur Diplomarbeit lfd. Nr.:

Themenstellung:

Kandidaten/Kandidatinnen:

Jahrgang:

Betreuer/in:

Ort:

Datum:

Zeit:

Besprechungsinhalt:

Name | Notiz

Aufgaben:

Name | Notiz | zu erledigen bis

HTBLuVA St. Pölten Elektronik und Technische Informatik Ausbildungsschwerpunkte Wireless- & Embedded Systems Reife- und Diplomprüfung
