crazyskater9/Diplomarbeit/CD/Messungen/HT.pdf

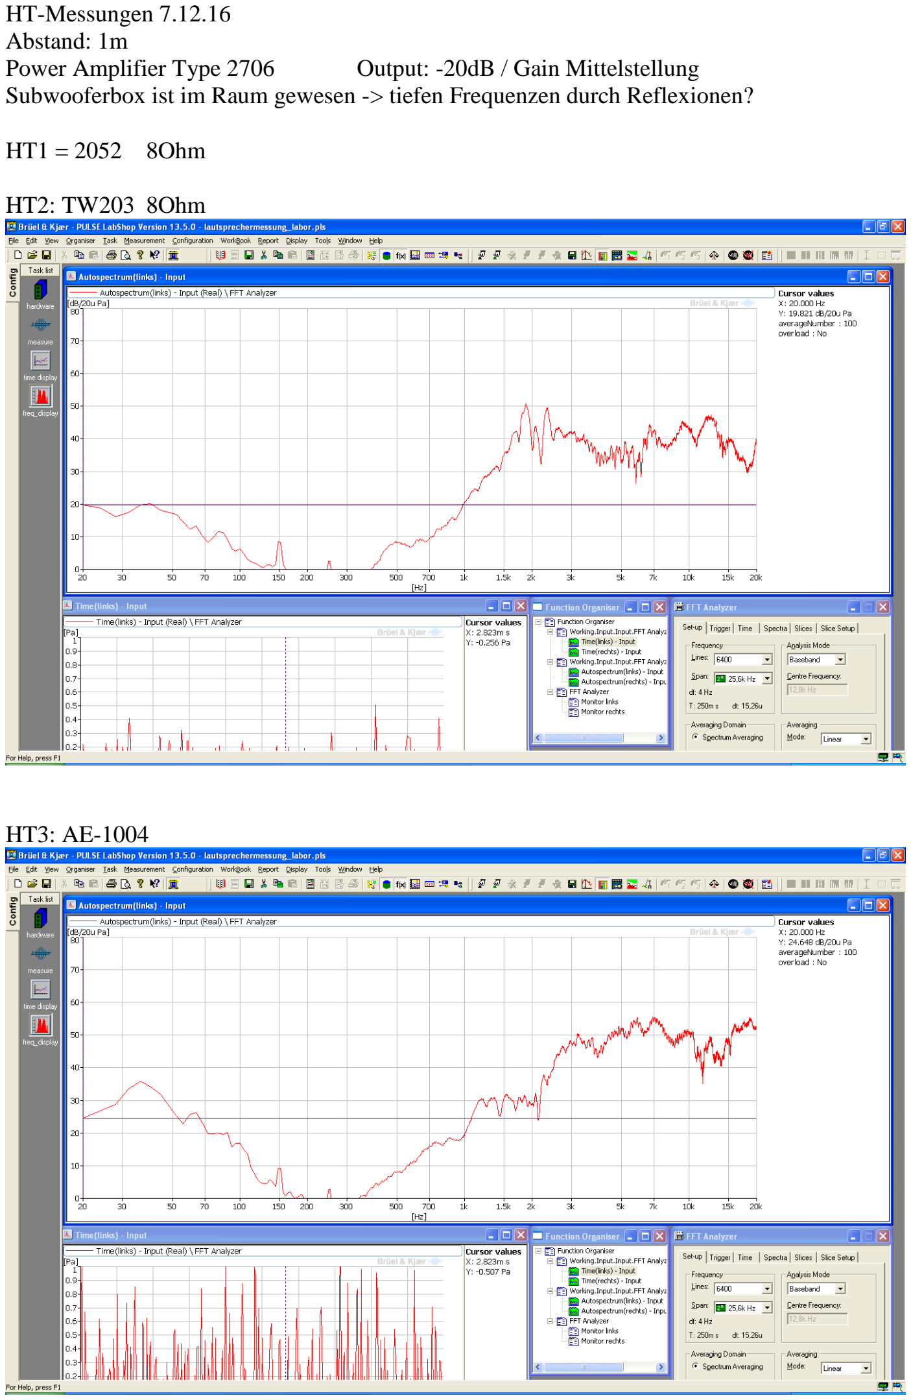
[picture p14: page 1]

HT-Messungen 7.12.16
Abstand: 1m
Power Amplifier Type 2706 | Output: -20dB / Gain Mittelstellung
Subwooferbox ist im Raum gewesen -> tiefen Frequenzen durch Reflexionen?

HT1 = 2052 8Ohm

HT2: TW203 8Ohm

HT3: AE-1004

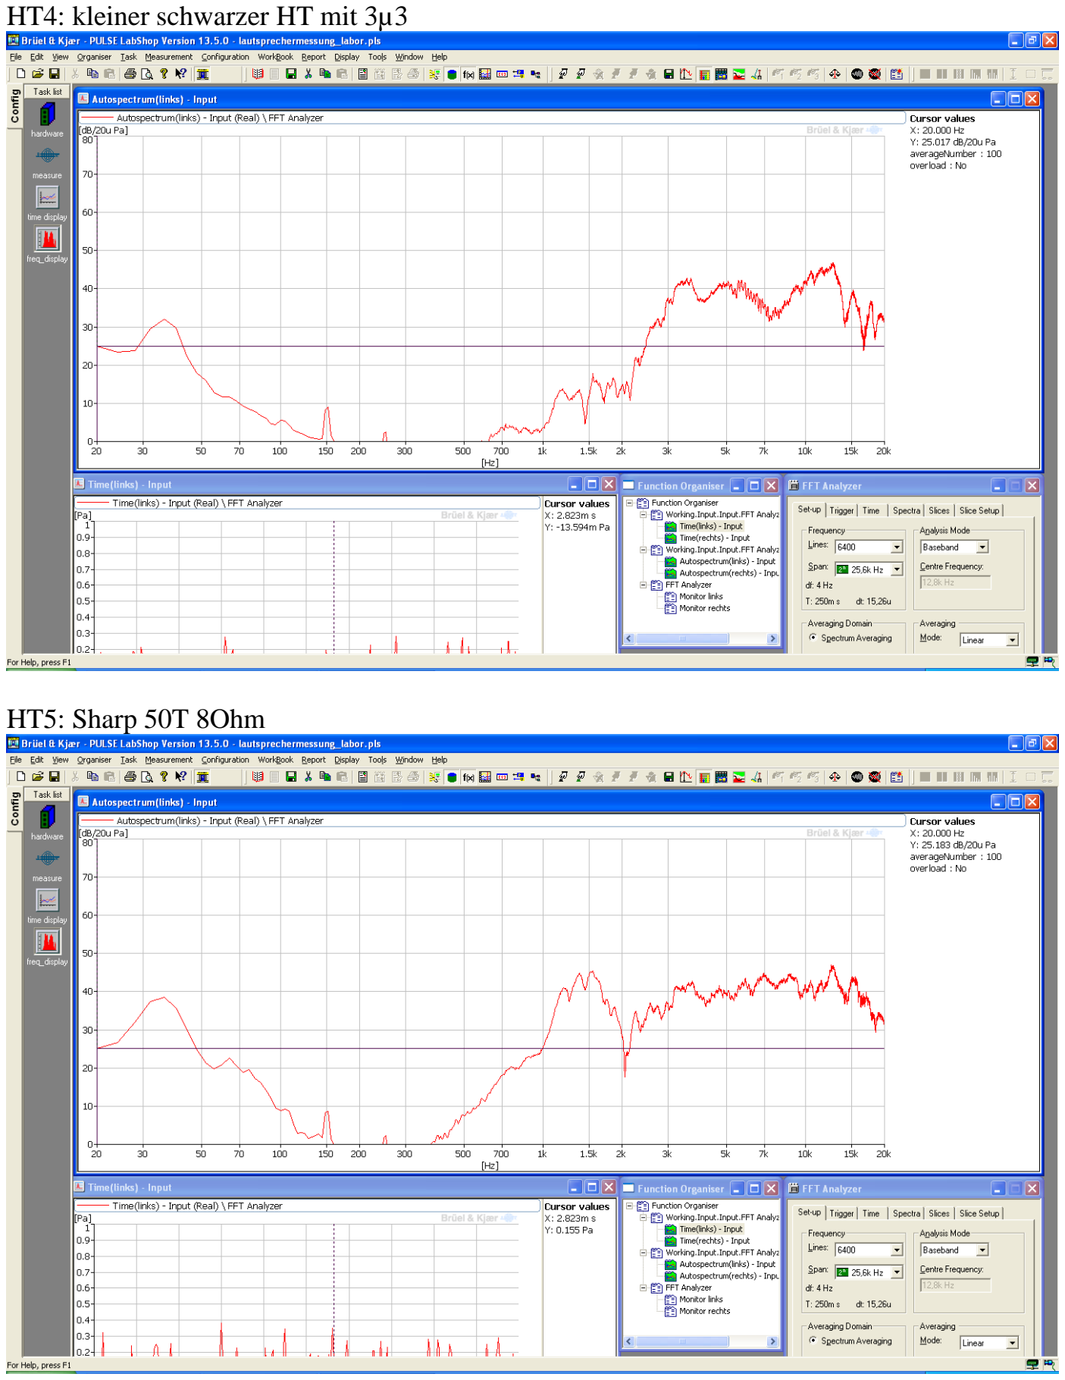
[picture p15: page 2]

HT4: kleiner schwarzer HT mit 3µ3

HT5: Sharp 50T 8Ohm

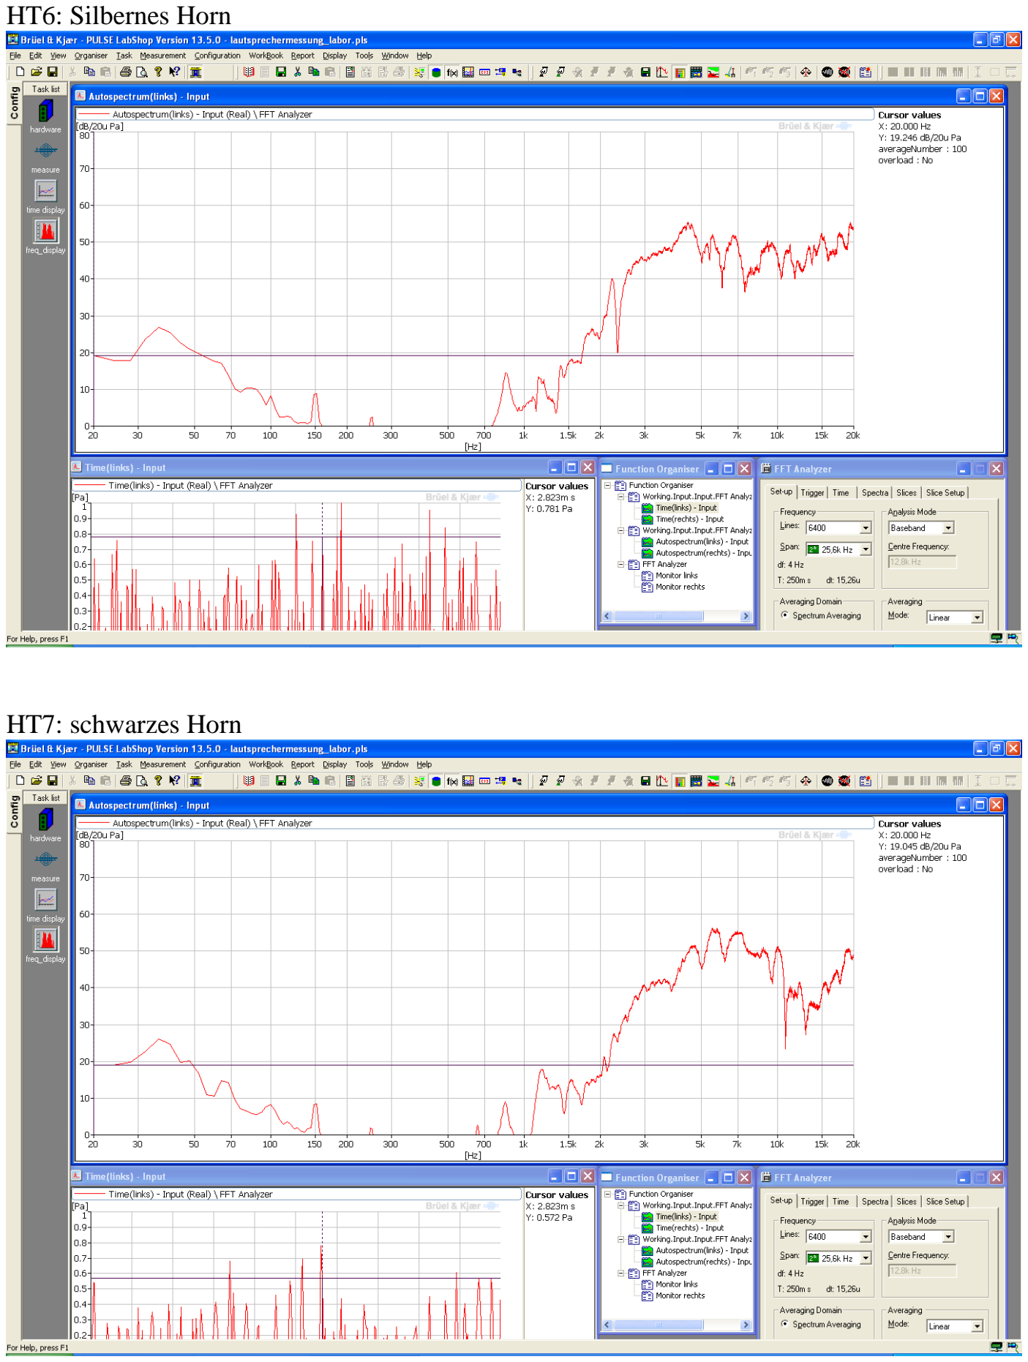
[picture p16: page 3]

HT6: Silbernes Horn

HT7: schwarzes Horn
