crazyskater9/Diplomarbeit/CD/Messungen/LautsprecherMessungen.pdf

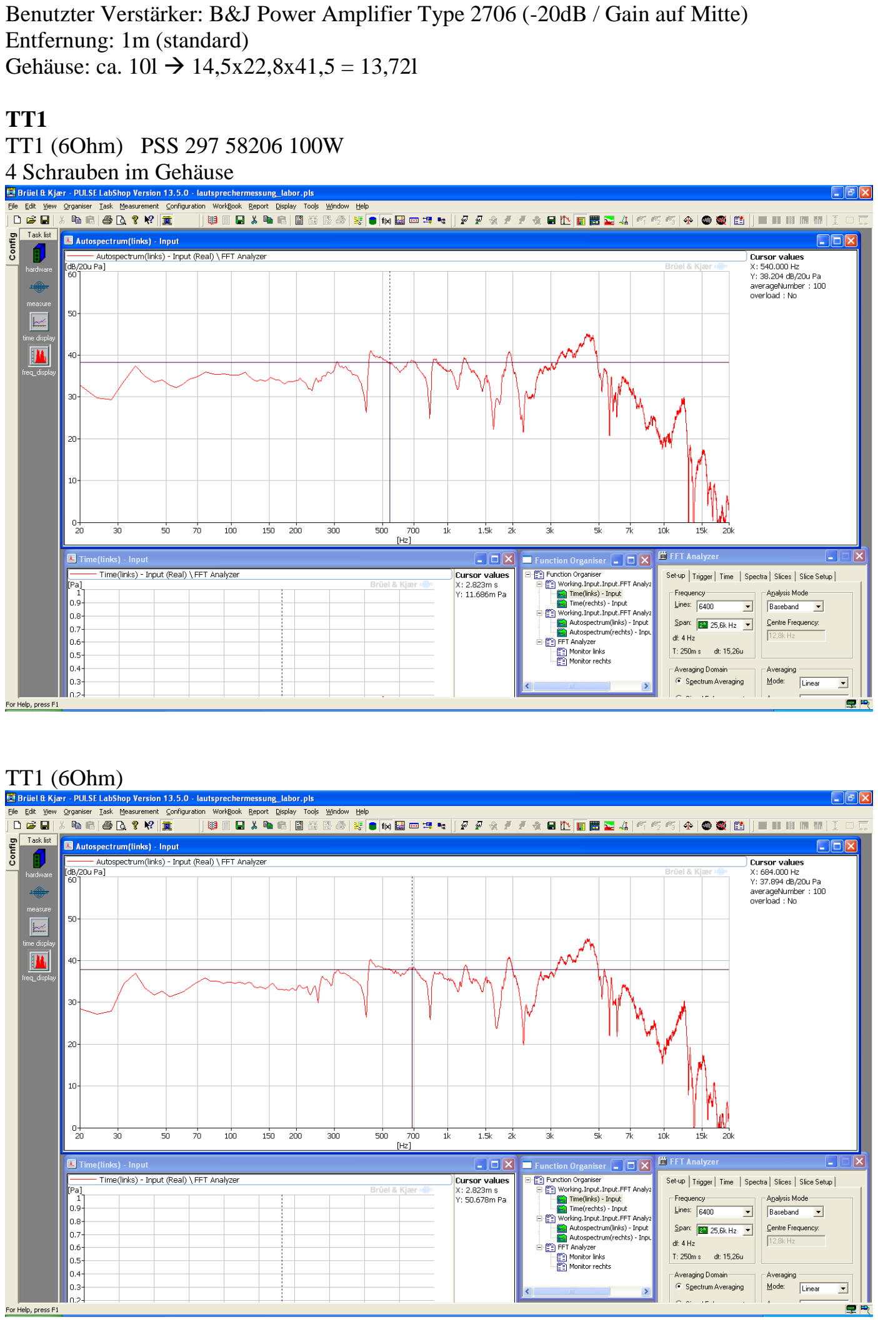
[picture p17: page 1]

Benutzter Verstärker: B&J Power Amplifier Type 2706 (-20dB / Gain auf Mitte) Entfernung: 1m (standard)
Gehäuse: ca. 10l → 14,5x22,8x41,5 = 13,72l

TT1
TT1 (6Ohm) PSS 297 58206 100W
4 Schrauben im Gehäuse

TT1 (6Ohm)

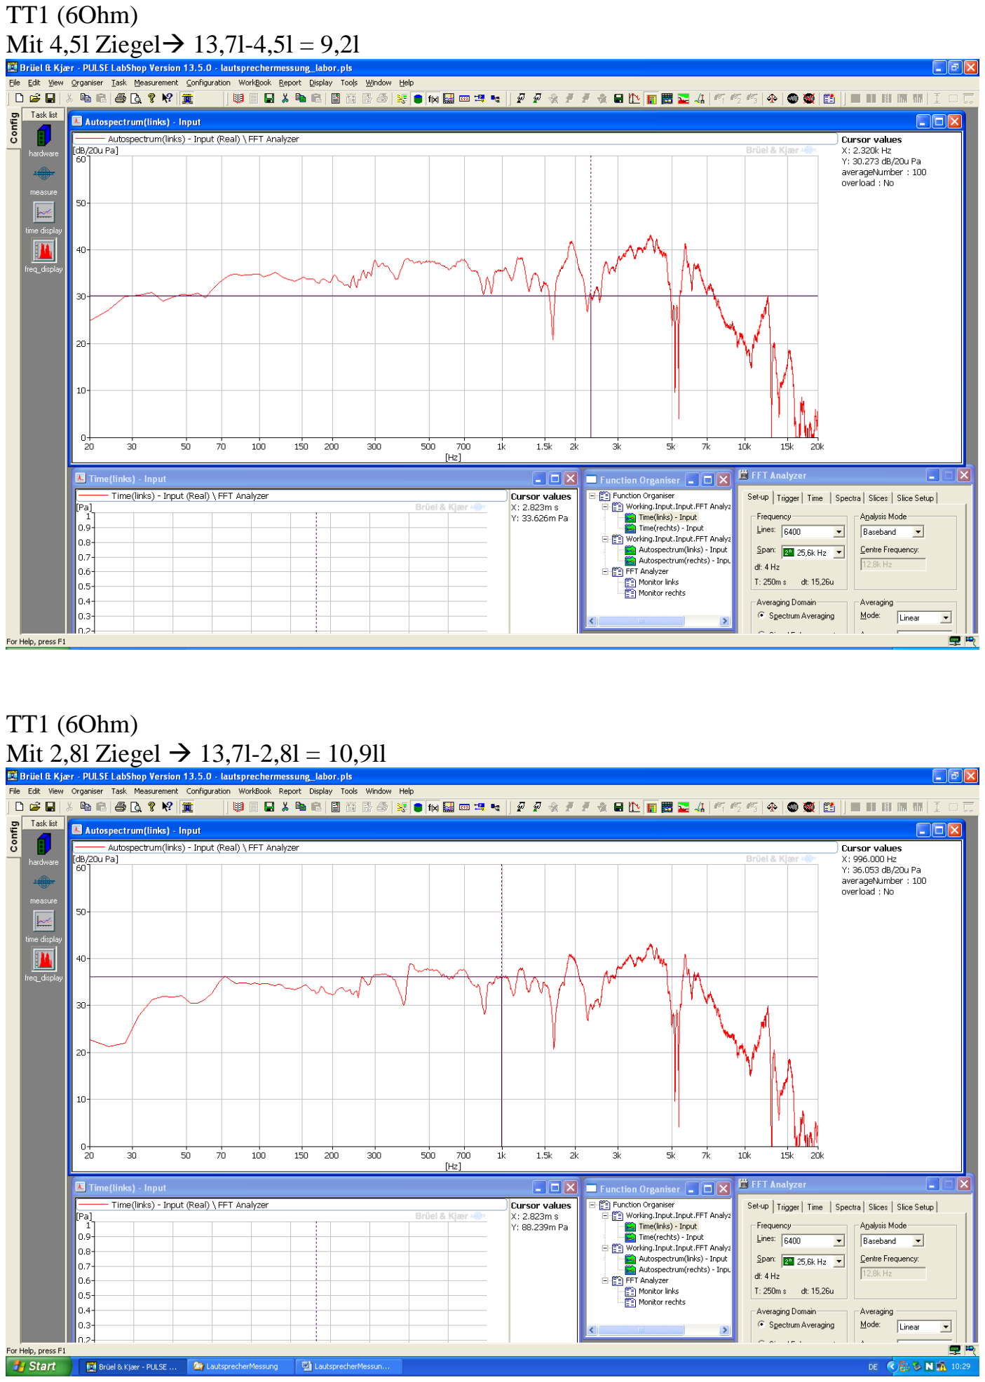
[picture p18: page 2]

TT1 (6Ohm)
Mit 4,5l Ziegel→ 13,7l-4,5l = 9,2l

TT1 (6Ohm)
Mit 2,8l Ziegel → 13,7l-2,8l = 10,9ll

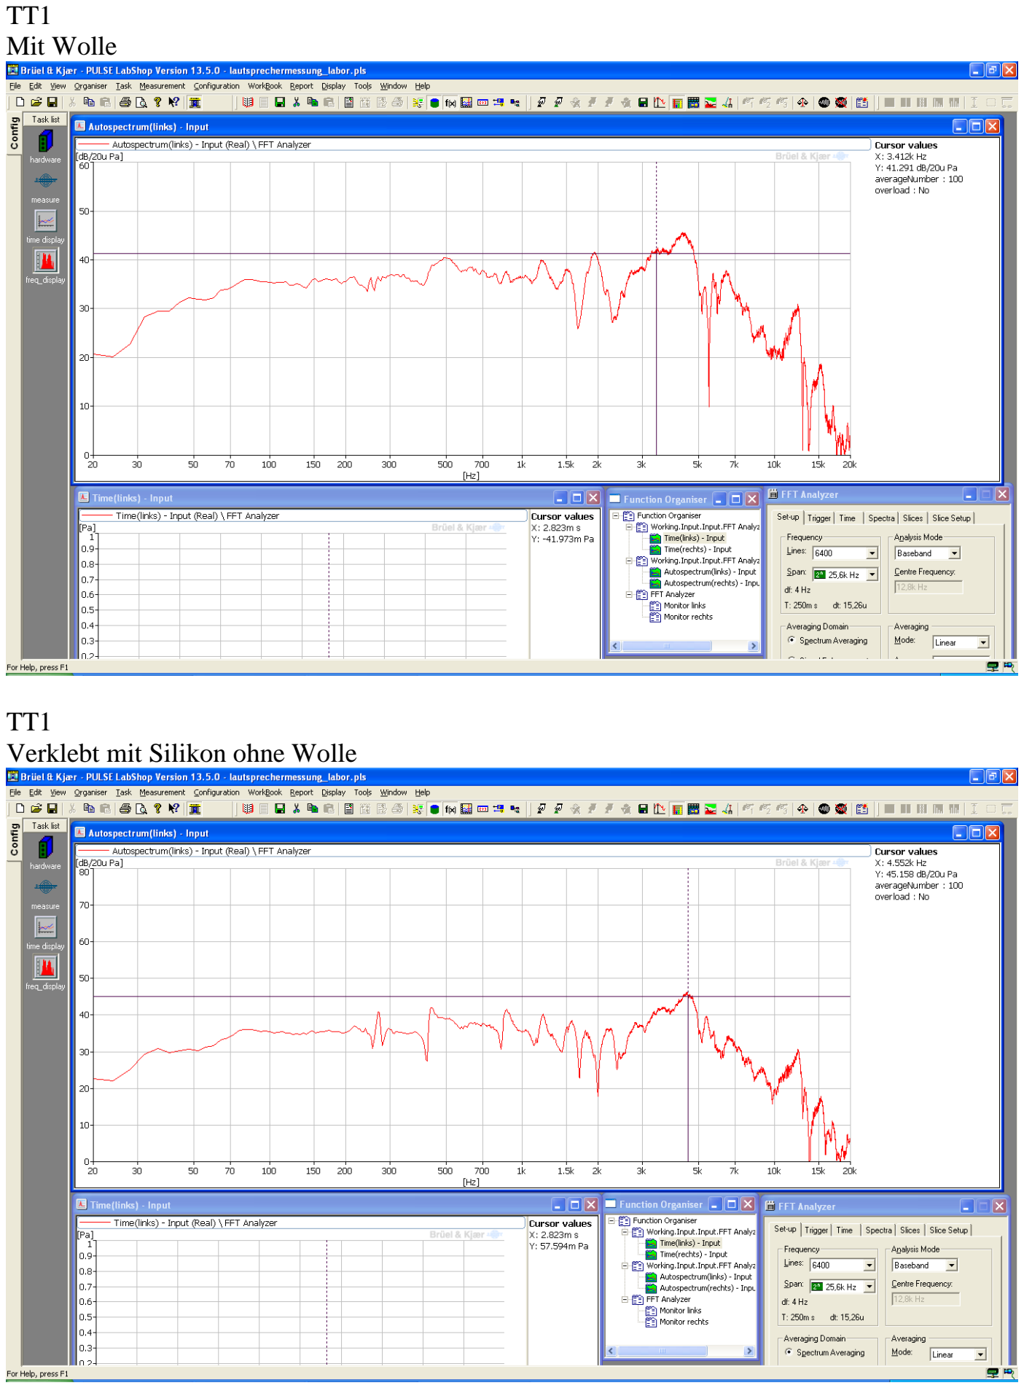
[picture p19: page 3]

TT1
Mit Wolle

TT1
Verklebt mit Silikon ohne Wolle

TT1
Verklebt mit Silikon mit Wolle

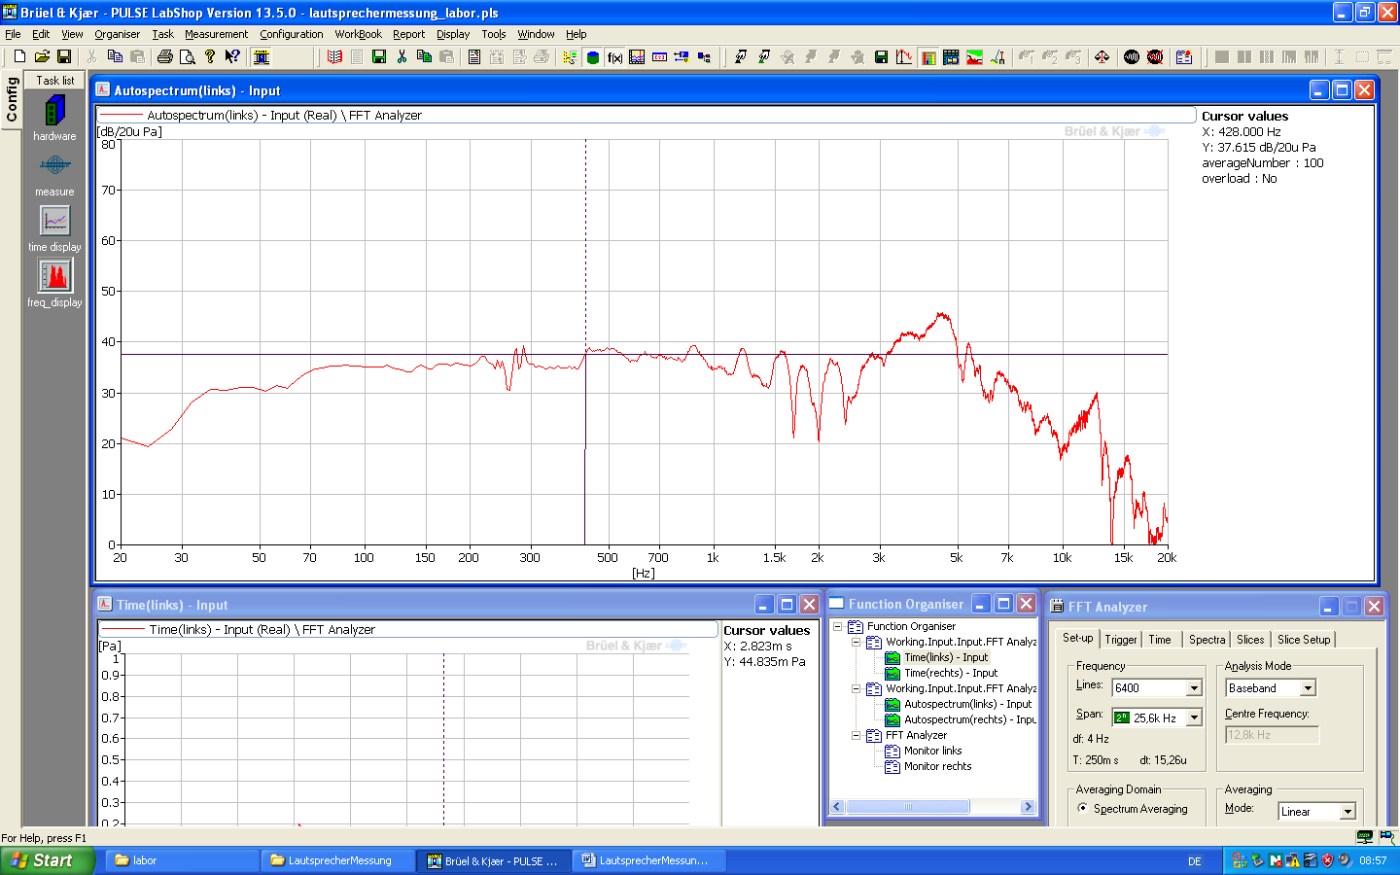
[picture p20: figure]
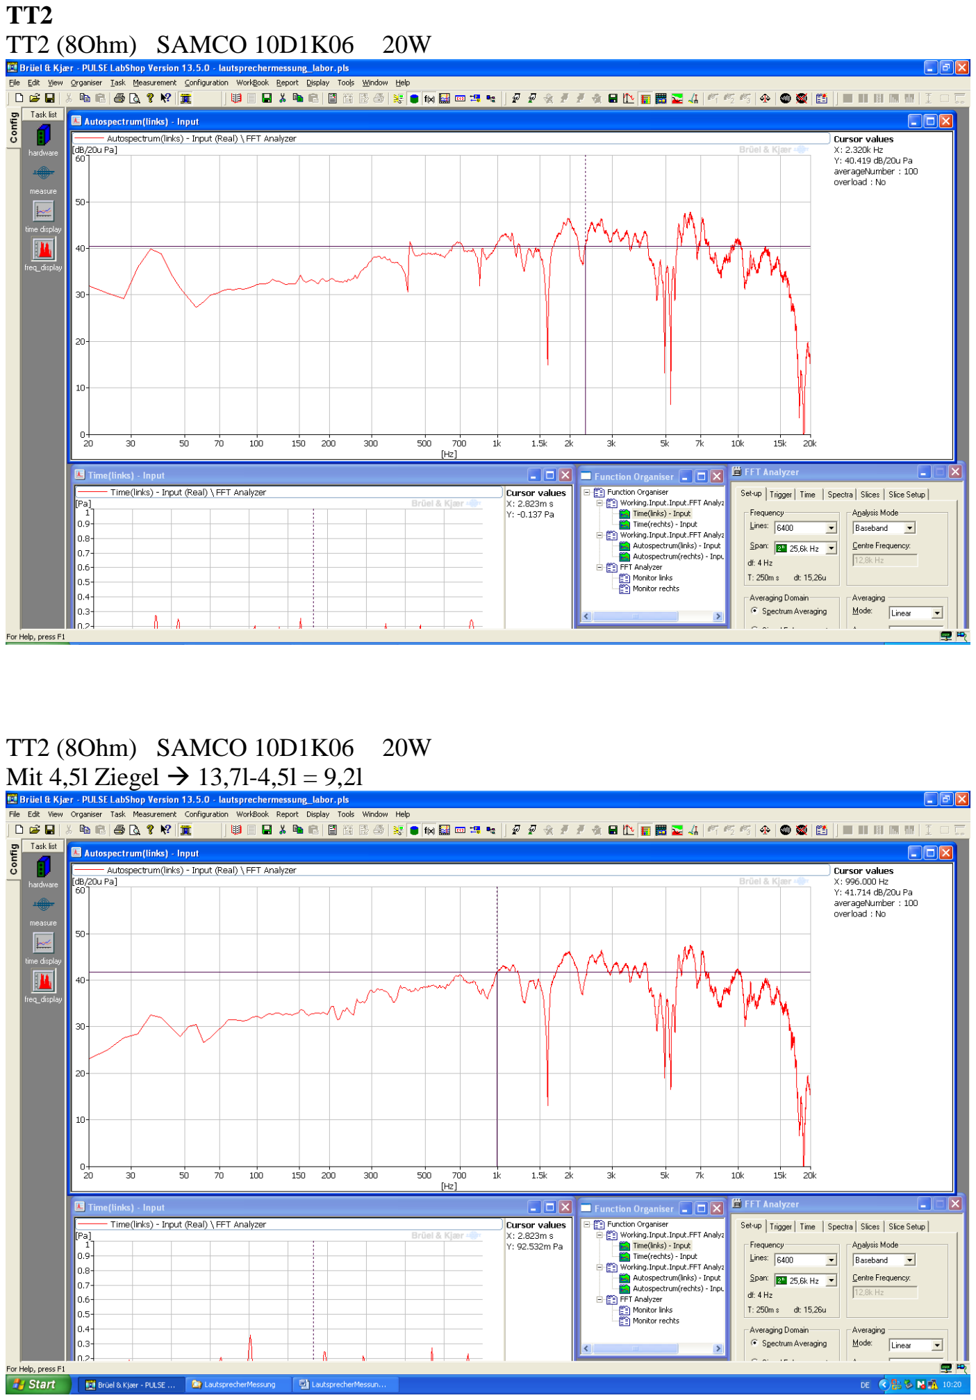
[picture p21: page 5]

TT2
TT2 (8Ohm) SAMCO 10D1K06 | 20W
TT2 (8Ohm) SAMCO 10D1K06 | 20W
Mit 4,5l Ziegel → 13,7l-4,5l = 9,2l

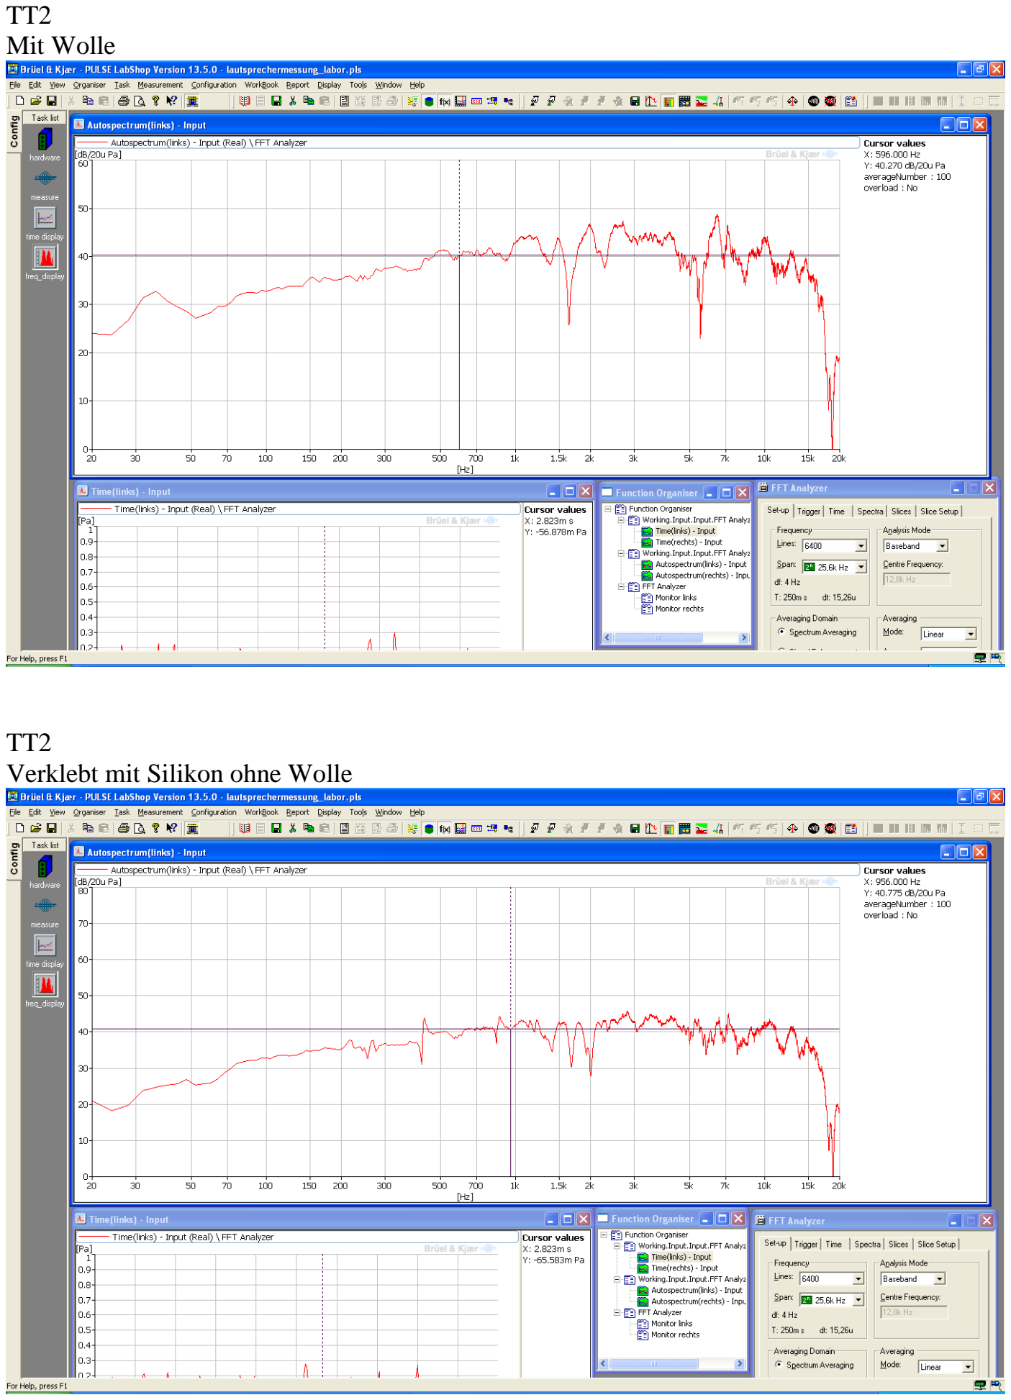
[picture p22: page 6]

TT2
Mit Wolle

TT2
Verklebt mit Silikon ohne Wolle

TT2
Verklebt mit Silikon mit Wolle

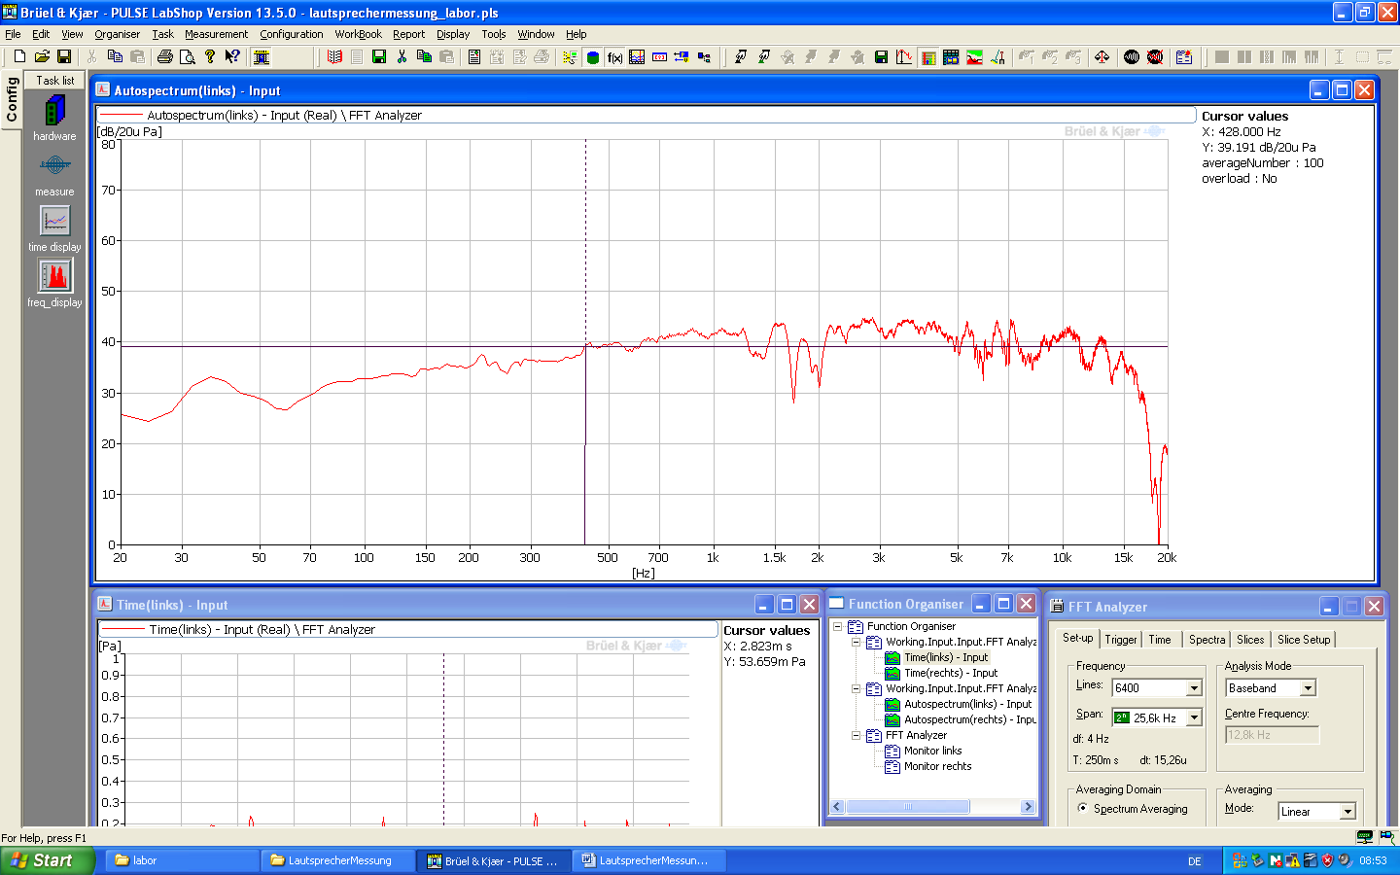
[picture p23: figure]

HT1 8Ohm
auf 0,5m

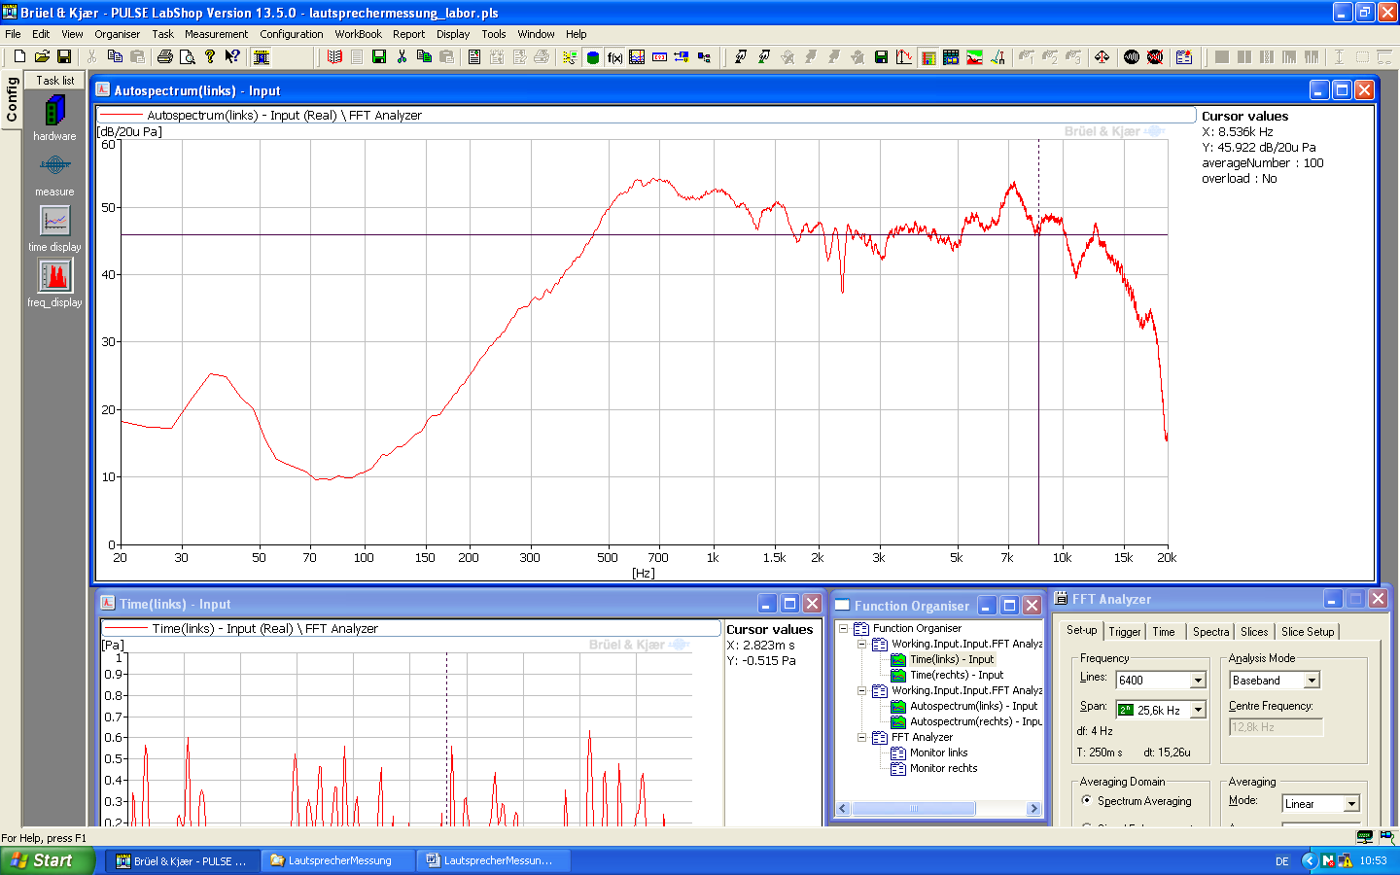
[picture p24: figure]
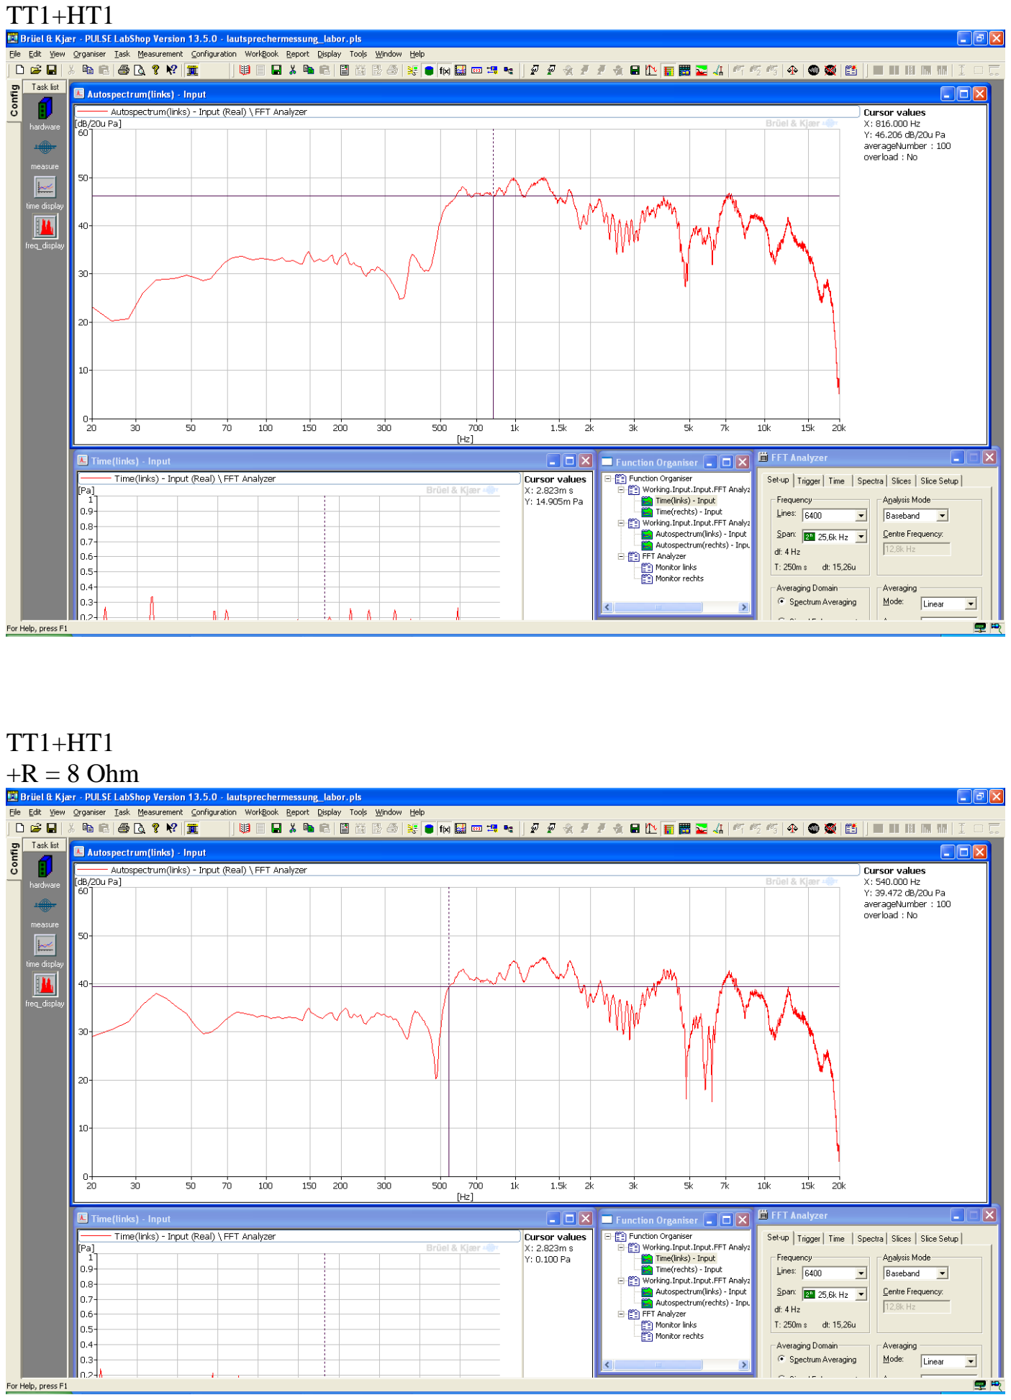
[picture p25: page 9]

TT1+HT1

TT1+HT1
+R = 8 Ohm

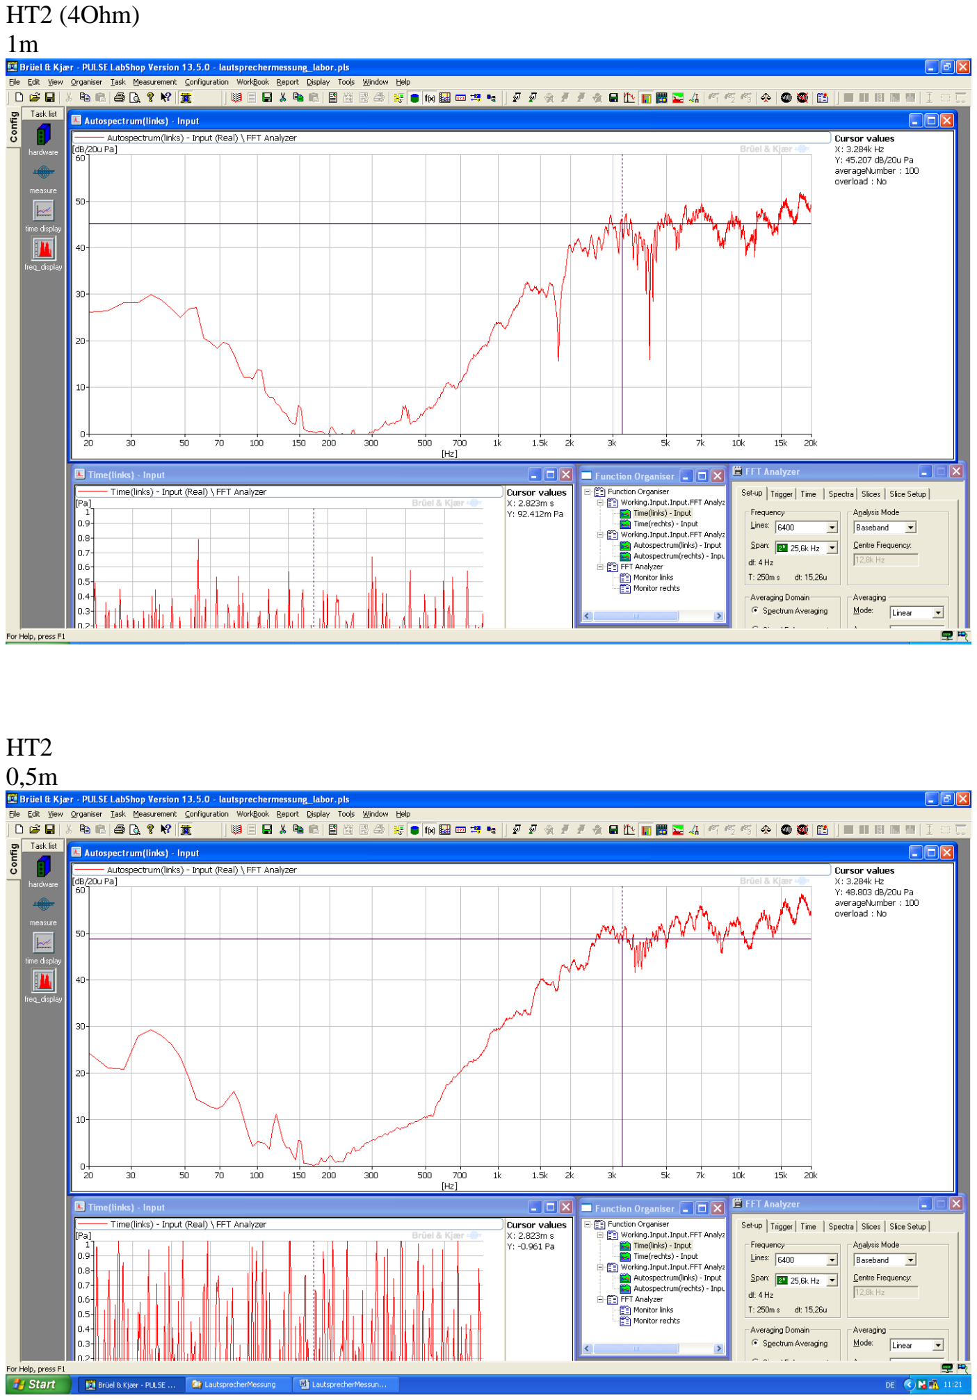
[picture p26: page 10]

HT2 (4Ohm)
1m

HT2
0,5m

TT1+HT2 (mit 4Ohm)
0,5m

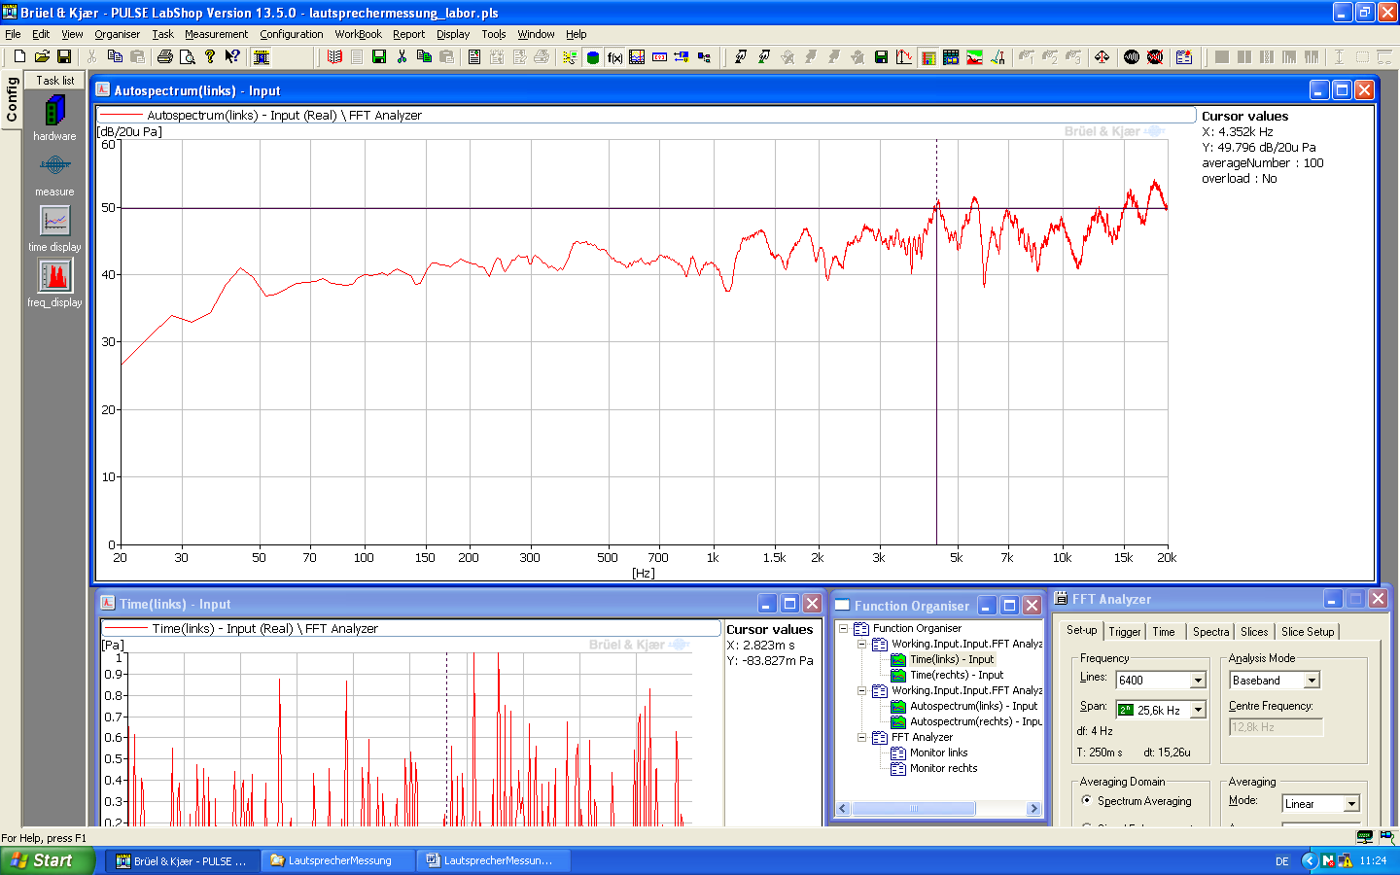
[picture p27: figure]
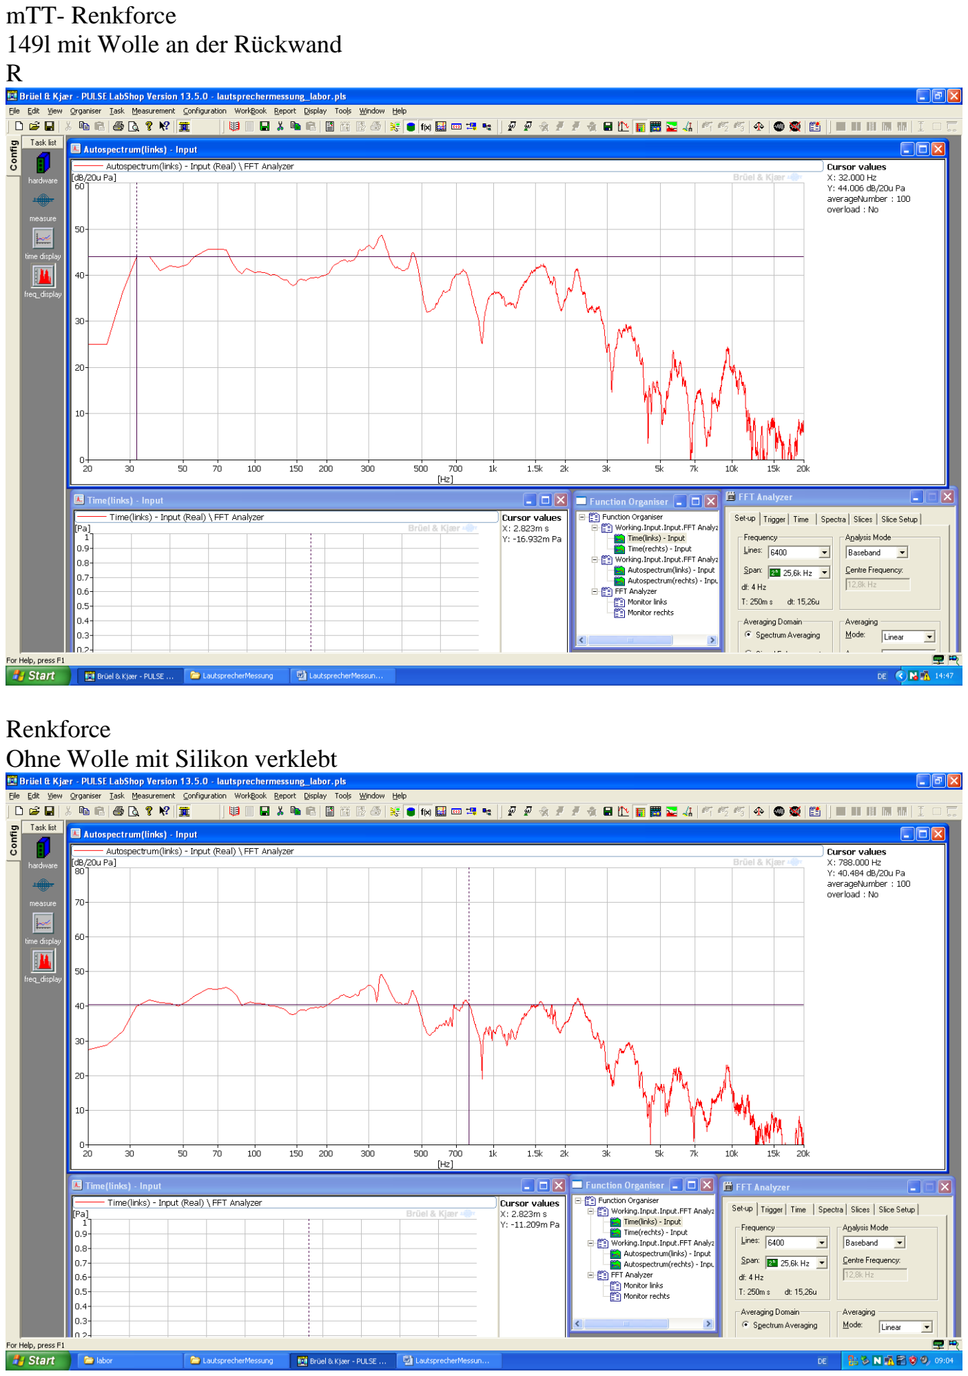
[picture p28: page 12]

mTT- Renkforce
149l mit Wolle an der Rückwand R

Renkforce
Ohne Wolle mit Silikon verklebt

Renkforce
Mit Wolle und Silikon

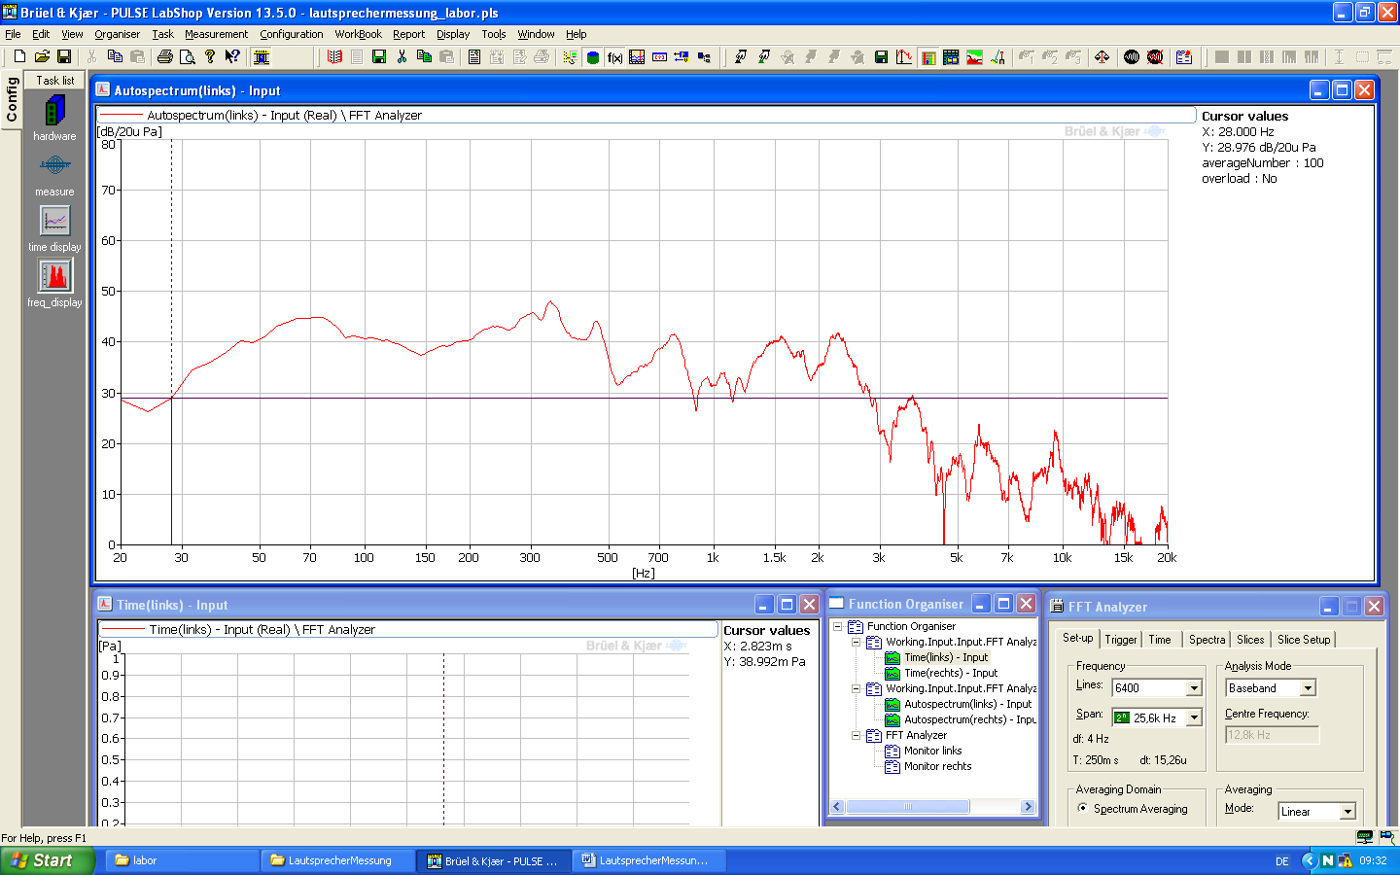
[picture p29: figure]
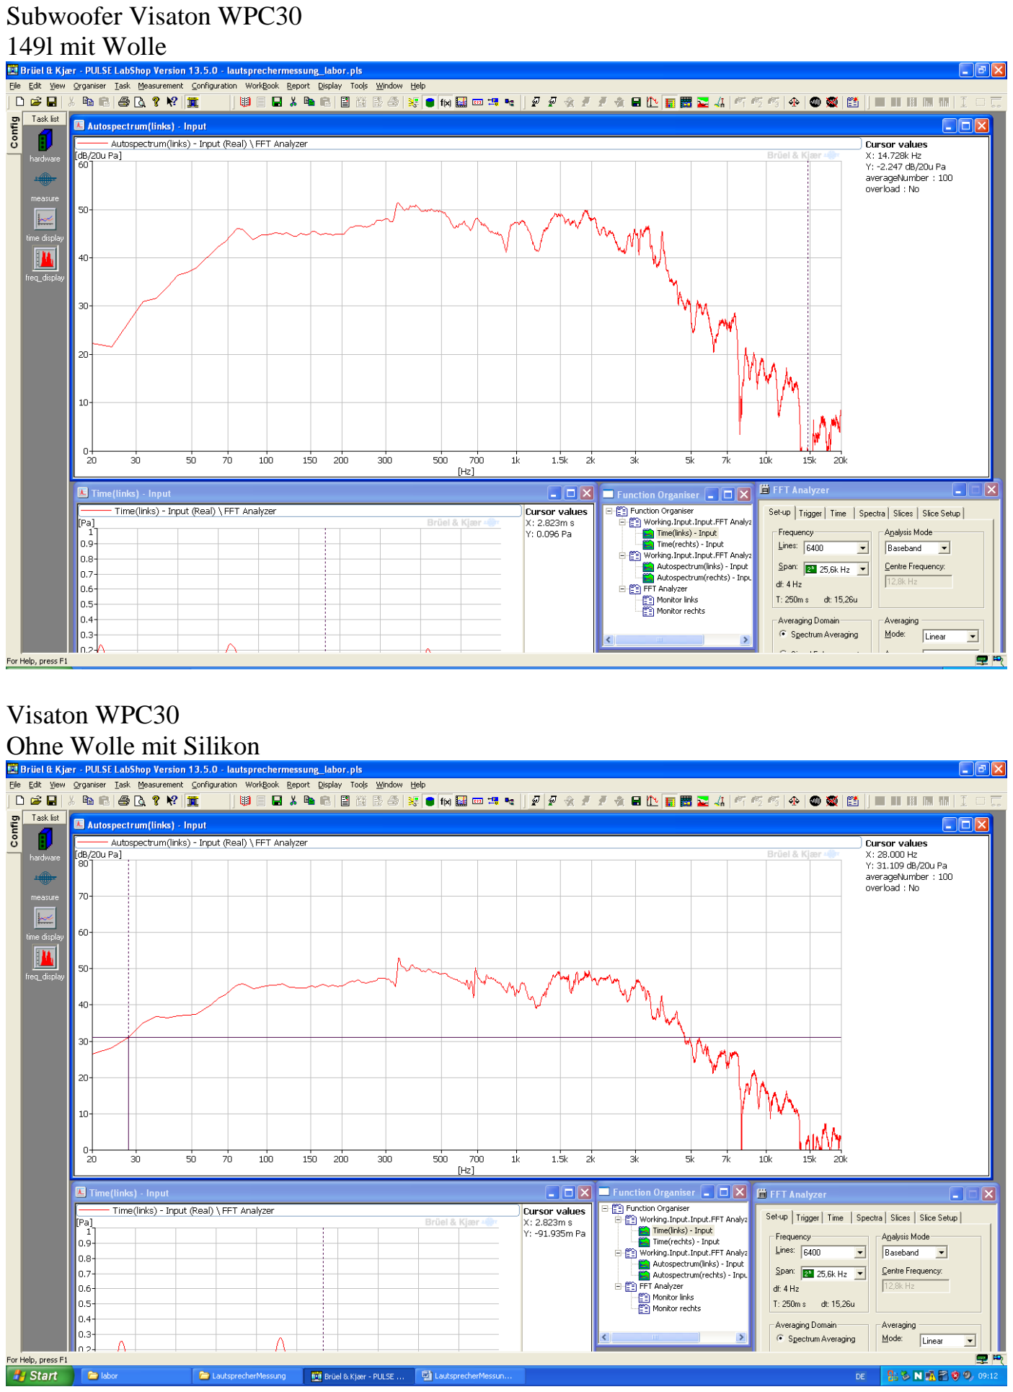
[picture p30: page 14]

Subwoofer Visaton WPC30
149l mit Wolle

Visaton WPC30
Ohne Wolle mit Silikon

Visaton WPC30
Mit Wolle und Silikon

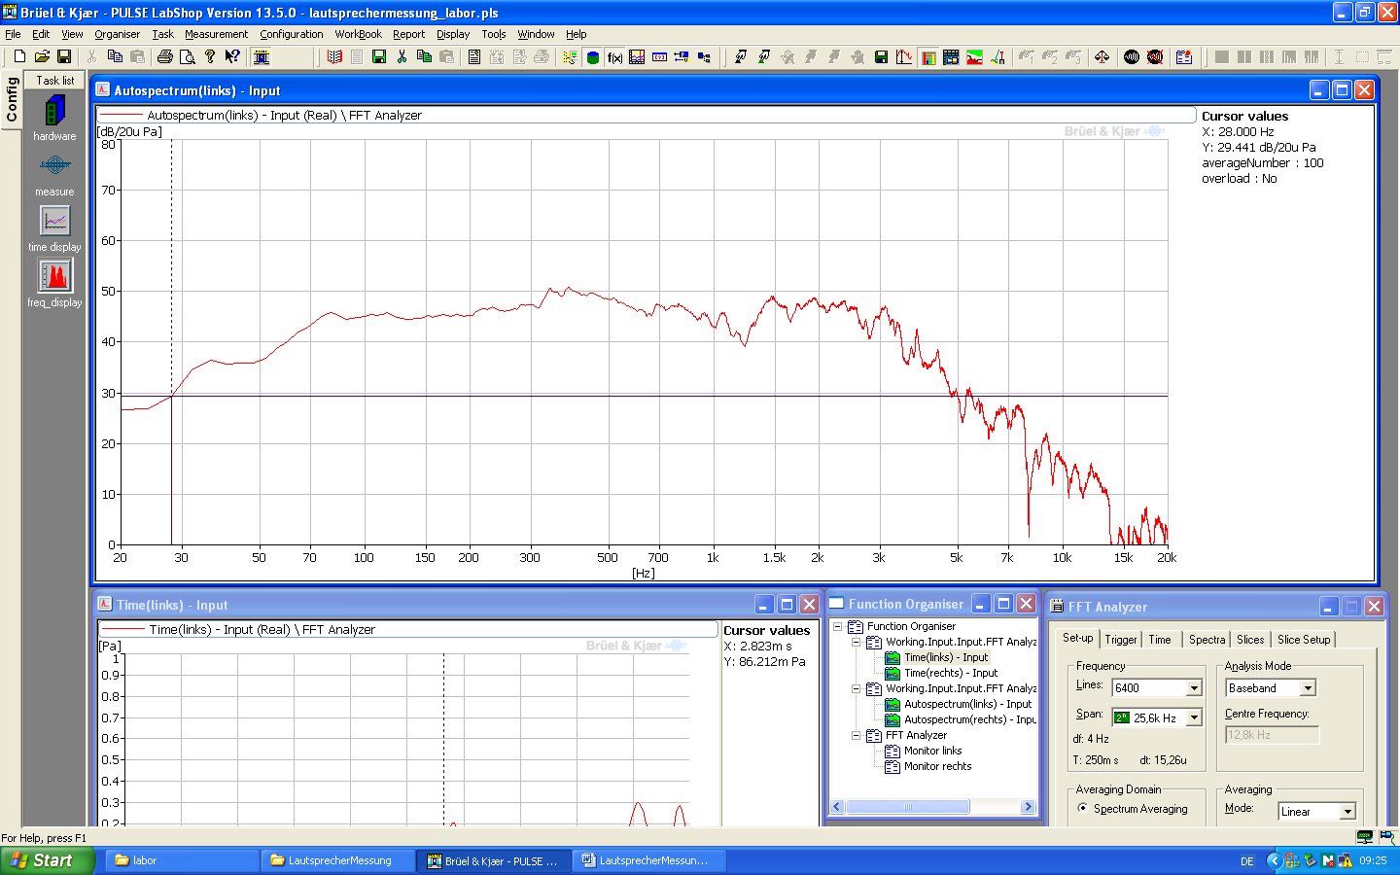
[picture p31: figure]
