crazyskater9/Diplomarbeit/tex/HT_Messungen.tex

%TD -- Kapitel 4.3 -- alle Labels darauf aufbauend

\newpage
\section{Lautsprecher für Hochton-Bereich}\label{sec:4.3}
Je ein Hochton-Lautsprecher wird in eine Satelliten-Box verbaut.
Während für die Tiefton-Lautsprecher das Volumen noch sehr wichtig ist, weil es den Frequenzgang des Lautsprechers beeinflussen kann, spielt das Volumen für die Hochton-Lautsprecher keine große Rolle mehr.
Dies ist bedingt dadurch, dass sich der Schall des Hochton-Lautsprechers hauptsächlich in Abstrahlrichtung der Membran ausbreitet.
%Das kommt daher, dass der Schall nur aus Richtung der Hochton-Lautsprecher-Membran abgestrahlt wird.
Die Box wird also durch hohe Töne nicht in Schwingung versetzt.
\\ \\
Folgende Hochton-Lautsprecher wurden gemessen:
\begin{itemize}
	\item TW203
	\item AE-1004
	\item Sharp 50T
	\item DT4810ASZR
	\item U2275
	\item Visaton DTW 72-8 (zugekauft)
\end{itemize}
Um vergleichbare Messungen zu erhalten, wurden alle Hochton-Lautsprecher mit einer Entfernung von 1 m zum Mikrofon gemessen.
Außerdem wurden alle Lautsprecher in einer Höhe von 1 m platziert, um Reflexionen mit dem Boden des Messraums zu verhindern.
Vor allem aus dem Grund, da es sich beim Boden um ein Metallgitter handelt.
In den Auslassungen des Gitters könnte es zu möglichen Resonanzen oder Reflexionen kommen, die das Messergebnis verfälschen.
\newpage

\begin{figure} [H]
	\centering
	
	\caption{Frequenzgang \enquote{TW203}}
	\label{fig:4.3.1}
\end{figure}

\begin{figure} [H]
	\centering
	
	\caption{Frequenzgang \enquote{AE-1004}}
	\label{fig:4.3.2}
\end{figure}

\begin{figure} [H]
	\centering
	
	\caption{Frequenzgang \enquote{Sharp 50T}}
	\label{fig:4.3.3}
\end{figure}

\begin{figure} [H]
	\centering
	
	\caption{Frequenzgang \enquote{DT4810AZSR}}
	\label{fig:4.3.4}
\end{figure}

\begin{figure} [H]
	\centering
	
	\caption{Frequenzgang \enquote{U2275}}
	\label{fig:4.3.5}
\end{figure}

\begin{figure} [H]
	\centering
	
	\caption{Frequenzgang \enquote{Visaton DTW 72-8}}
	\label{fig:4.3.6}
\end{figure}
\newpage
Im Bereich unter 500 Hz sind bei den Messungen relativ hohe Pegel aufgetreten.
In diesem Frequenzbereich kann ein Hochton-Lautsprecher auf Grund der dafür zu kleinen Membranfläche nicht solche hohen Schalldruckpegel erzeugen.
Daraus ist zu schließen, dass diese Pegel durch verschiedene Störeinflüsse auf die Messung erzeugt wurden.
Diese Einflüsse könnten sein: Beeinflussung der Messung durch das 50 Hz Stromnetz, äußere Einflüsse auf den reflexionsarmen Raum (Trittschall), usw.
\\ \\
Da viele dieser gemessenen Frequenzgänge eine hohe Welligkeit oder erst bei relativ hohen Frequenzen einen angemessenen Schalldruckpegel aufweisen, wurde von uns der Hochton-Lautsprecher \enquote{Visaton DTW 72-8} (Frequenzgang: Abb. \ref{fig:4.3.6}) zugekauft und für das Projekt ausgewählt.
\\ \\
Dieser Lautsprecher weist einen angemessenen Schalldruckpegel bei relativ geringer Welligkeit auf und ist daher optimal.
Außerdem könnte er bereits ab ca. 1 kHz verwendet werden.

\begin{figure} [H]
	\centering
	
	\caption[Lautsprecher \enquote{Visaton DTW 72-8}]{Lautsprecher \enquote{Visaton DTW 72-8}\footnotemark}
	\label{fig:4.3.7}
\end{figure}
\footnotetext{http://www.visaton.de/de/chassis\_zubehoer/ht\_kalotten/dtw72\_8.html,\\Zugriff: 13.03.2017}
%http://www.visaton.de/de/chassis_zubehoer/ht_kalotten/dtw72_8.html
