crazyskater9/Diplomarbeit/tex/Lautsprechermessungen.tex

\section{Allgemeines}\label{sec:5.1}
Um die Charakteristika eines Lautsprechers zu beurteilen ist es wichtig den genauen Frequenzgang eines Lautsprecherchassis zu wissen. Dieser sagt aus, wie sich ein Lautsprecher bei bestimmten Frequenzen verhält. Der von uns gemessene Frequenzbereich beginnt bei 20Hz und endet bei 20kHz. Dieser Bereich wurde gewählt, da auch das menschliche Gehör nur in diesen Frequenzen aktiv ist.
\begin{figure} [H]
	\centering
	
	\caption{Beispiel eines Frequenzganges (Tieftöner PSS 297 58206)}
	\label{fig:5.1.1}
\end{figure}
Anhand dieses Beispiels kann man bereits sehr gut erkennen, wie sich der Schalldruckpegel (hier in dB angegeben) in Abhängigkeit der Frequenz verändert.\newpage
Da der gemessene Lautsprecher in diesem Fall ein Tieftöner ist, sinkt der Pegel ab einer gewissen Frequenz sehr stark ab. Das bedeutet, dass diese Frequenzen wenig oder gar nicht von dem Lautsprecher abgestrahlt werden - also nicht hörbar sind.\\
Die Qualität des Frequenzganges eines Lautsprechers hängt nun nicht direkt von dem absoluten Schalldruckpegel ab, sondern viel mehr von den relativen Schwankungen. Der absolute Pegel wird nämlich vom Signal des Verstärkers - im weiteren Sinne vom Benutzer - festgelegt. Das Wichtige dabei ist, was der Lautsprecher aus diesem Signal macht und so entsteht ein Frequenzgang.\\
In diesem Fall werden hohe Frequenzen vom Lautsprecher \enquote{gedämpft} und somit nicht abgestrahlt.

\subsection{Andere wichtige Eigenschaften eines Lautsprechers}\label{subsec:5.1.1}
Ein Lautsprecher wird aber nicht nur durch seinen Frequenzgang definiert. Es gibt viele andere Eigenschaften, die auch unter dem Namen \enquote{Thiele-Small-Parameter} bekannt sind:
% Quelle: https://de.wikipedia.org/wiki/Thiele-Small-Parameter
\begin{itemize}
	\item Äquivalentvolumen $ V_{as} $
	\item Resonanzfrequenz $ F_{ms} $
	\item Elektrische Güte $ Q_{es} $
	\item Mechanische Güte $ Q_{ms} $
	\item Gesamtgüte $ Q_{ts} $
	\item Bewegte Masse $ M_{ms} $
	\item Membranfläche $ S_{d} $
	\item Nachgiebigkeit der Aufhängung $ C_{ms} $
	\item Gleichstromwiderstand $ R_{e} $
	\item Induktivität der Schwingspule $ L_{e} $
	\item Verschiebevolumen $ V_{d} $
	\item maximale Auslenkung $ X_{max} $
	\item Kraftfaktor \emph{B × l}
	\item mechanischer Verlustwiderstand $ R_{ms} $
\end{itemize}
Diese Eigenschaften, sowie auch die Impedanz \emph{Z}, beschreiben ebenfalls das Verhalten eines Lautsprechers. Sie wurden aber nicht von uns gemessen, weil der Fokus unseres Projekts eher an der Optimierung des Frequenzganges liegt. Die Thiele-Small-Paramter sind aber nicht veränderbar, also auch nicht optimierbar.

\section{Messaufbau}\label{sec:5.2}
Um überhaupt präzise Messungen an Lautsprechern durchführen zu können, benötigt man einen geeigneten Messraum. Die HTBLuVA St. Pölten verfügt glücklicherweise über so einen schalldichten Raum. Dieser ist innen mit schalldämpfenden Material ausgekleidet und dämpft somit jede Schallwelle in ihm. 
\begin{figure} [H]
	\centering
	%\includegraphics[width=1\textwidth]{img/LSMessung/schalldichterraum.png}
	\caption{Schalldichter Raum in der HTBLuVA St. Pölten}
	\label{fig:5.2.1}
\end{figure}
In diesem Raum wurden alle Lautsprecher gemessen. Um nun auch ein passendes Mess-Signal erzeugen zu können ist noch weiteres Equipment nötig:
\begin{itemize}
	\item Mess-Software \enquote{PULSE LabShop Version 13.5.0} von \enquote{Brüel \& Kj\ae r}
	\item USB-Dongle zur Aktivierung der Software
	\item Messmodul von \enquote{Brüel \& Kj\ae r}
	\item Signal-Verstärker
	\item Mess-Mikrofon
	\item Optional: Oszilloskop
	\item Optional: Einstellbares Filter als Frequenzweiche
\end{itemize}

\newpage
\subsection{Software}\label{subsec:5.2.1}
Als Software wurde \enquote{PULSE LabShop Version 13.5.0} von \enquote{Brüel \& Kj\ae r} verwendet. Der Mess-PC basierte auf dem Betriebssystem \enquote{Windows XP}. Um diese Software ordnungsgemäß verwenden zu können wird noch ein kleiner USB-Dongle benötigt. Nur mir diesem Dongle lässt sich die Software aktivieren.
\begin{figure} [H]
	\centering
	
	\caption{Auschnitt aus der Software \enquote{PULSE LabShop}}
	\label{fig:5.2.1.1}
\end{figure}
In der Abbildung \ref{fig:5.2.1.1} ist bereits ein gemessener Frequenzgang eines Tieftöners zu sehen. Das liegt daran, dass bei den Messungen eine abgespeicherte Datei inklusive allen Einstellungen verwendet wurde, da man sonst immer wieder die nötigen Einstellungen treffen müsste. Die Software ist damit auf alle verwendeten Komponenten abgestimmt und sendet auch das richtige Mess-Signal aus. Mit einem Klick auf die Start-Taste beginnt die Messung. Es werden insgesamt 100 Messungen gemittelt um einen möglichst genauen Frequenzgang aufnehmen zu können. Dies dauert in etwa 20s. \\
All diese Einstellungen sind je nach Wunsch veränderbar. Genau wie auch die Angaben und Einheiten der 2 Achsen. Die Frequenzachse ist logarithmisch von 20Hz bis 20kHz dargestellt. Die Achse des Schalldruckpegels ist in der Einheit dB angegeben. In diesem Beispiel (Abb. \ref{fig:5.2.1.1}) ist der Bereich von 0dB bis 80dB gewählt. Diese Einstellung wurde von uns später geändert auf 0dB bis 60dB um möglichst vergleichbare Messungen zu erzeugen.

\newpage
\subsection{Messmodul}\label{subsec:5.2.2}
Das Modul ist über ein Ethernet-Kabel mit dem PC und somit mit der Software verbunden. Sobald der Befehl zum Start der Messung kommt, beginnt das Modul das Mess-Signal auszusenden und gleichzeitig über ein Mikrofon die Ergebnisse aufzunehmen.\\
Das Mess-Signal besteht aus einem \enquote{weißen Rauschen}. Dieses Signal ist optimal für die Messung von Lautsprechern, da alle Frequenzen mit gleichem Pegel ausgesendet wird.
% Quelle: https://upload.wikimedia.org/wikipedia/commons/c/c1/White_noise.svg
% Quelle: https://upload.wikimedia.org/wikipedia/commons/3/3c/White_noise_spectrum.svg
\begin{figure} [H]
	\centering
	\subfloat{}
	\subfloat{}
	\caption{Zeitfunktion und Spektrum von \enquote{weißem Rauschen}}
	\label{fig:5.2.2.1}
\end{figure}
\begin{figure} [H]
	\centering
	%\includegraphics[width=1\textwidth]{img/LSMessung/modul.png}
	\caption{Messmodul}
	\label{fig:5.2.2.2}
\end{figure}

\newpage
\subsection{Mikrofon}\label{subsec:5.2.3}
Um den Schalldruckpegel möglichst präzise messen zu können wird auch ein dementsprechend genaues Mikrofon benötigt. Das bei uns verwendete Mikrofon war das \enquote{Brüel \& Kj\ae r Type 2669}. \\
Ebenfalls wichtig ist die Ausrichtung des Mikrofons. Es sollte immer auf Höhe der Mitte des Lautsprechers angebracht werden. Die Entfernung muss bei verschiedenen Lautsprechern gleich bleiben, um vergleichbare Messungen zu ermöglichen. Bei einem Zwei-Weg-System (Hoch- und Tieftöner) haben wir das Mikrofon (vertikal gesehen) zwischen den Lautsprechern befestigt.
\begin{figure} [H]
	\centering
	
	\caption{Messmikrofon \enquote{Brüel \& Kj\ae r Type 2669}}
	\label{fig:5.2.3.1}
\end{figure}
