crazyskater9/Diplomarbeit/CD/Messungen/20161214-LautsprecherMessungen.pdf

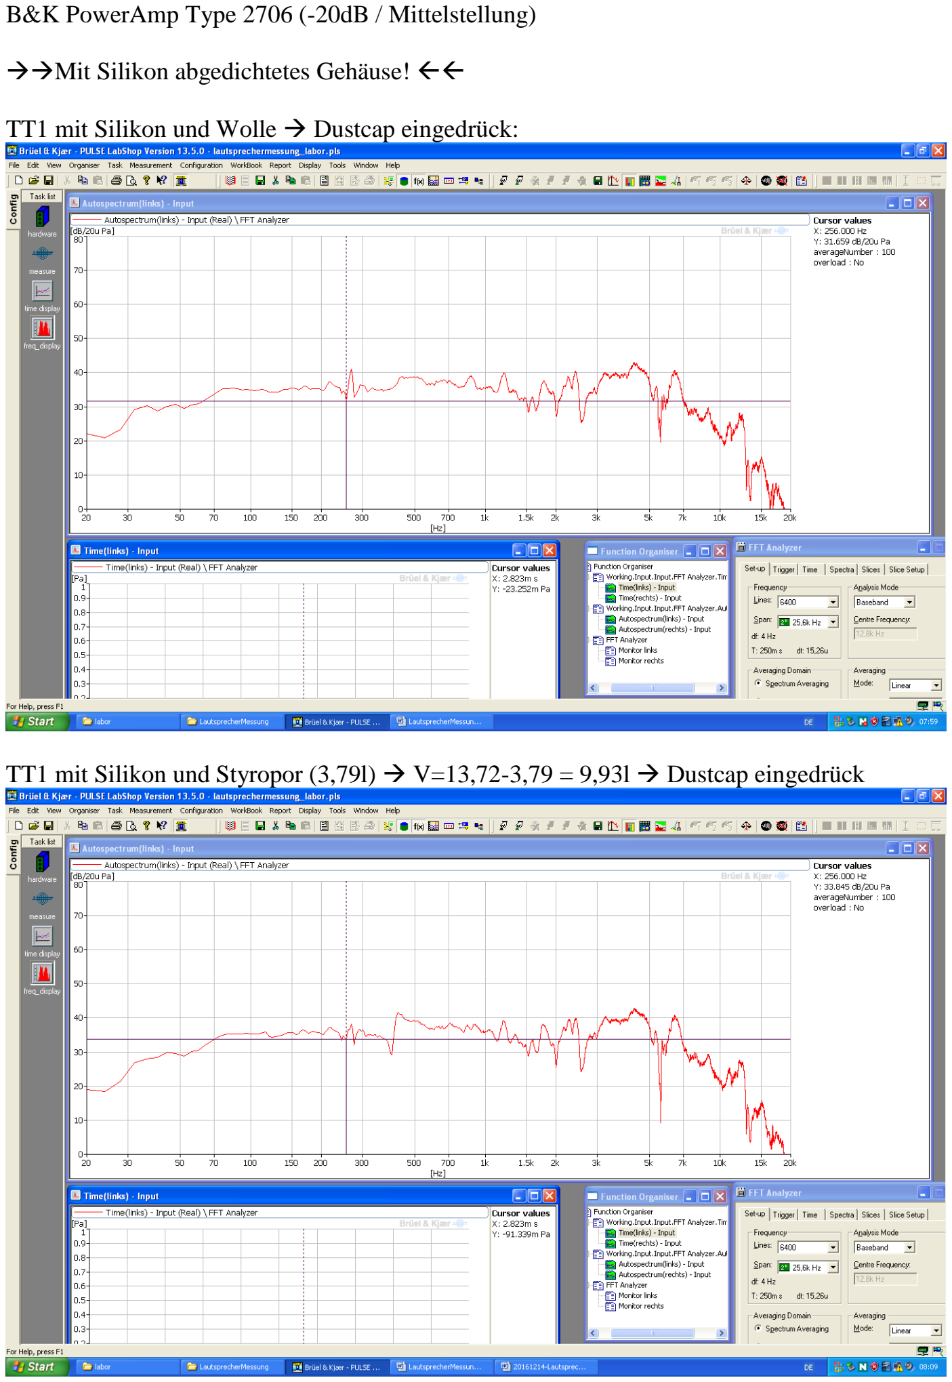
[picture p33: page 1]

B&K PowerAmp Type 2706 (-20dB / Mittelstellung)

→→Mit Silikon abgedichtetes Gehäuse!

TT1 mit Silikon und Wolle → Dustcap eingedrück:

TT1 mit Silikon und Styropor (3,79l) → V=13,72-3,79 = 9,93l → Dustcap eingedrück

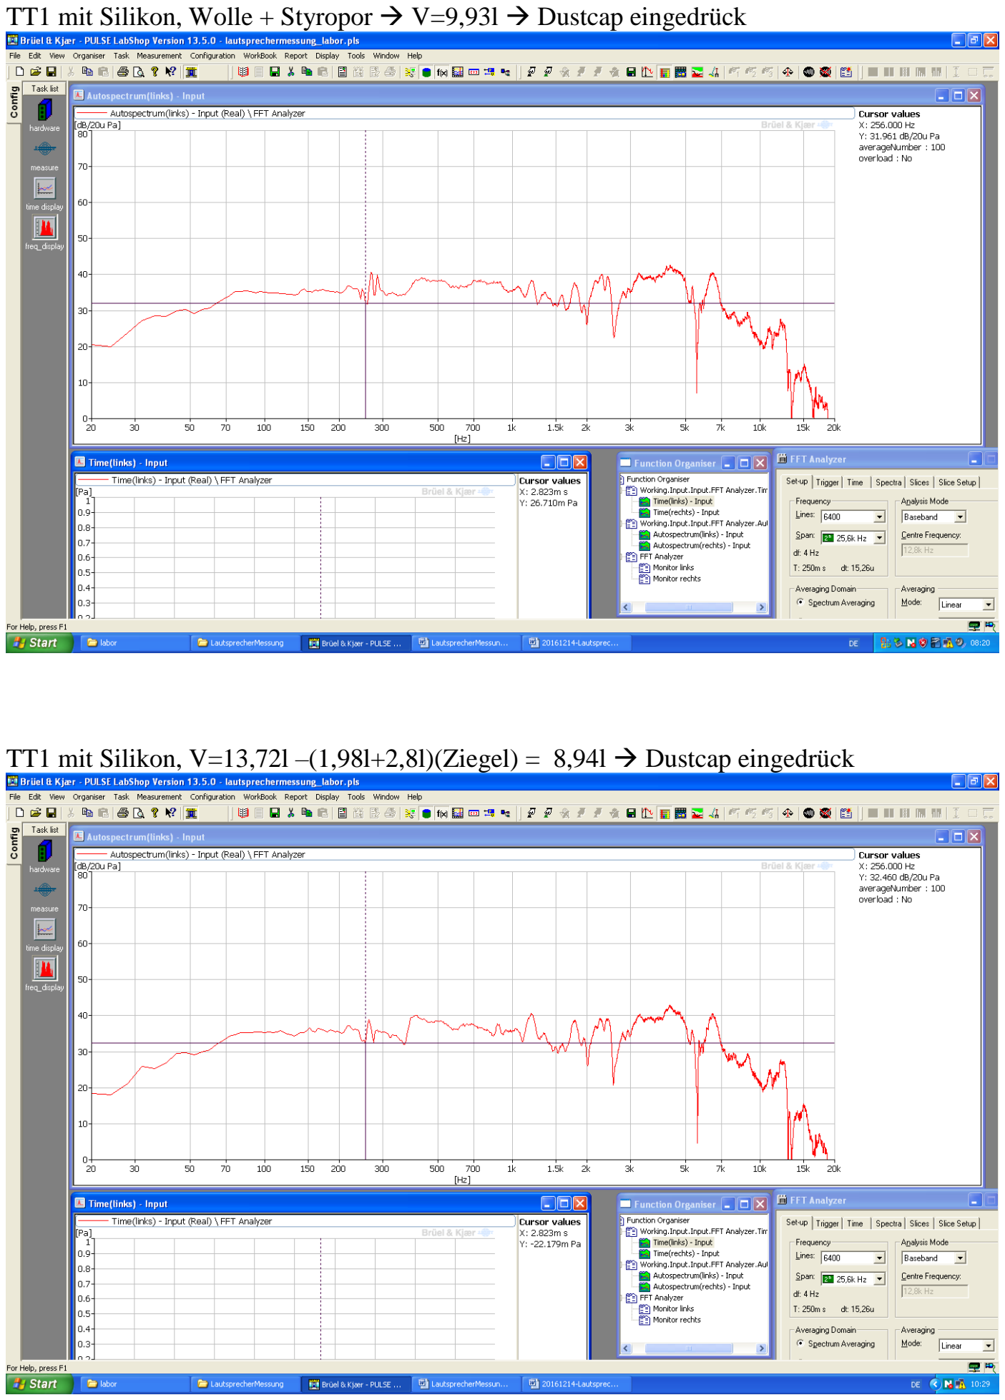
[picture p34: page 2]

TT1 mit Silikon, Wolle + Styropor → V=9,93l → Dustcap eingedrück

TT1 mit Silikon, V=13,72l –(1,98l+2,8l)(Ziegel) = 8,94l → Dustcap eingedrück

→→Mit Silikon abgedichtetes Gehäuse! TT2 (SAMCO)
Mit V = 9,93l

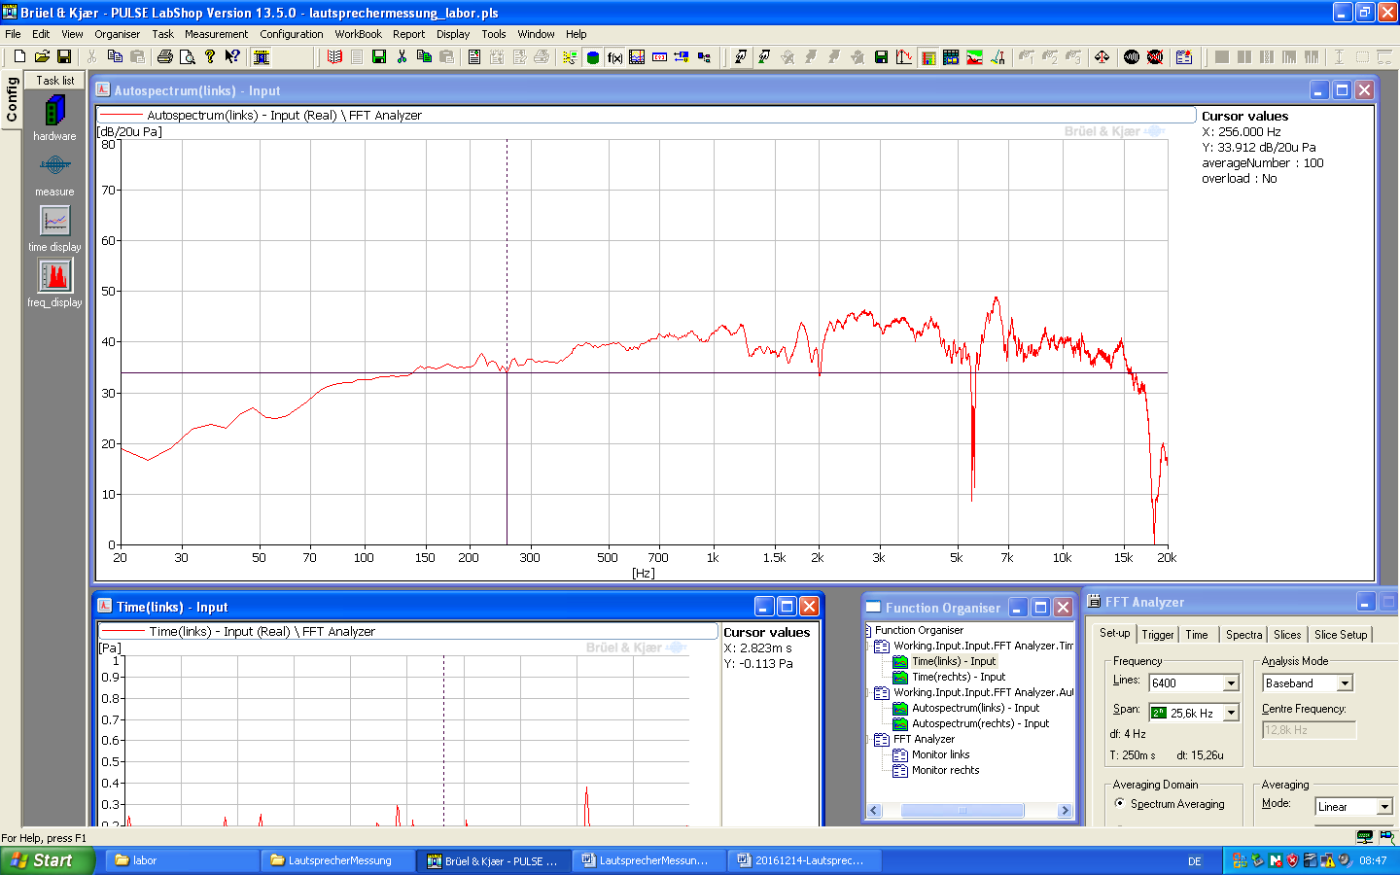
[picture p35: figure]

TT2 mit Wolle + V = 9,93l

→→ TT3 wurde erst verwendet wo das Gehäuse bereits mit Silikon abgedichtet wurde! TT3 AutoLS-Infinity
V= 13,72l

TT3 AutoLS-Infinity
V= 13,72l – mit Wolle

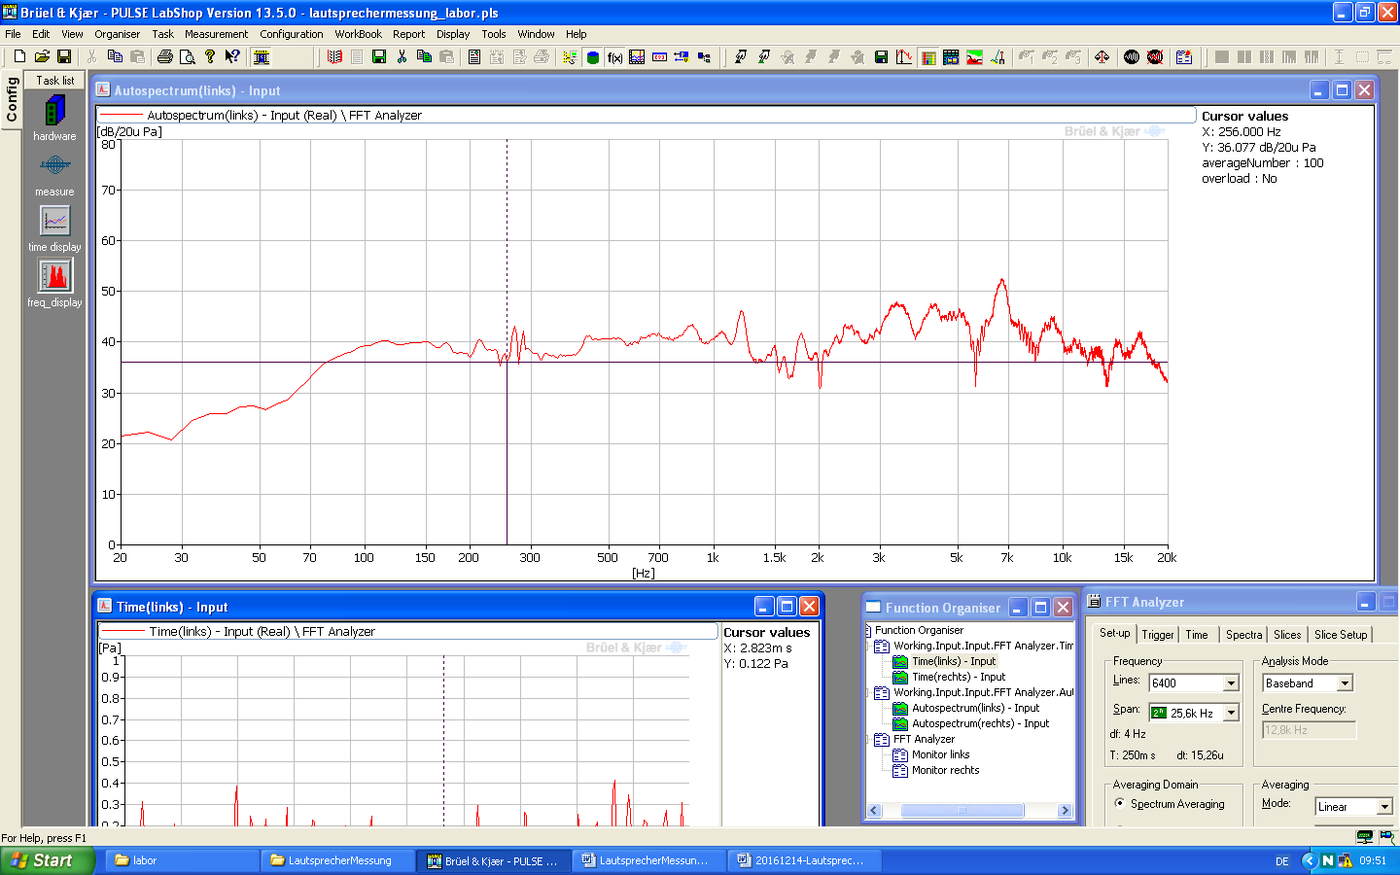
[picture p36: figure]

TT3 AutoLS-Infinity
V=13,72l -3,79l(Styropor) = 9,93l

TT3 AutoLS-Infinity
V=13,72l-3,97l(Styropor) = 9,93l mit Wolle

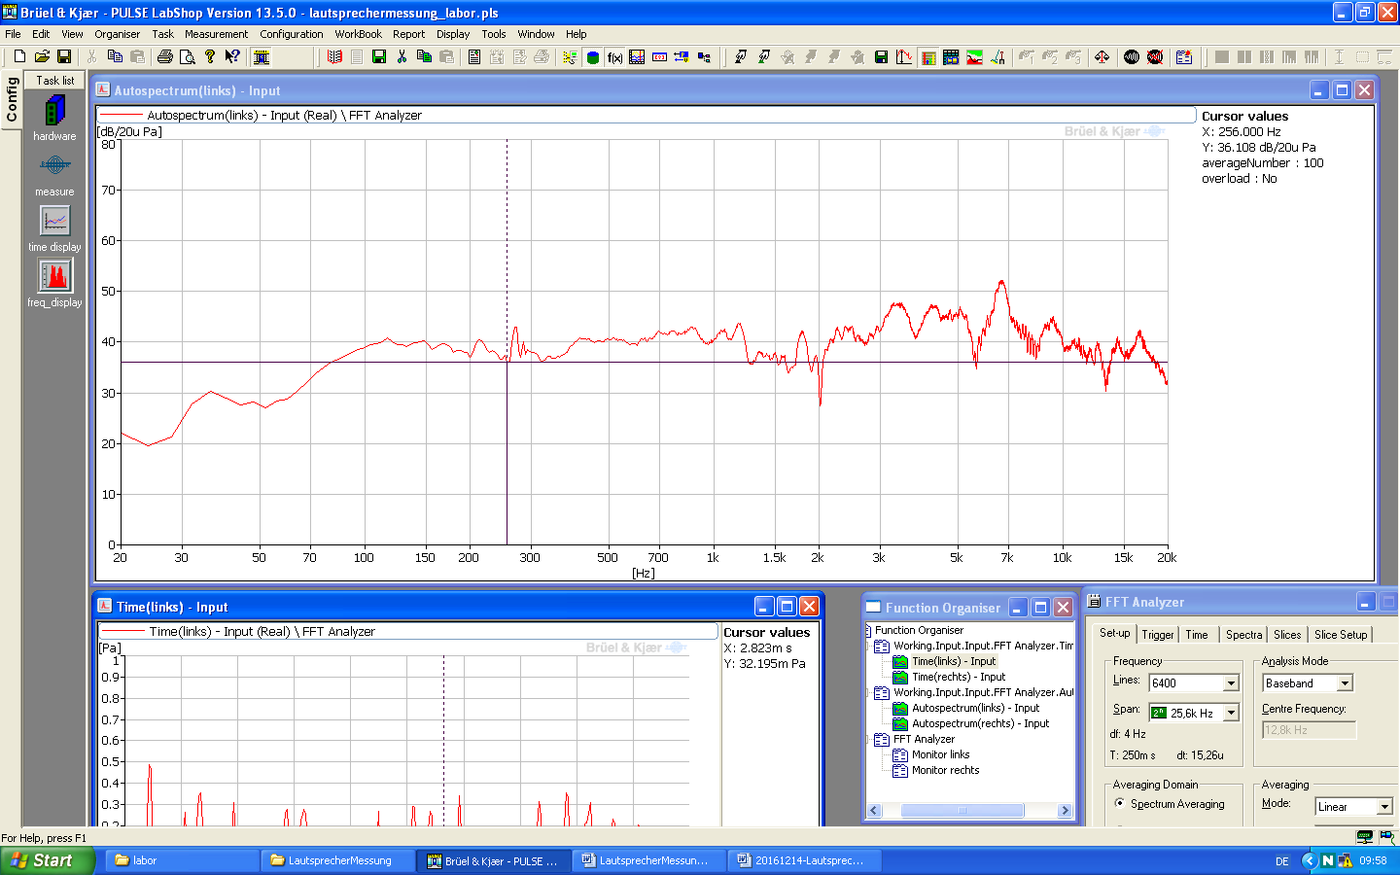
[picture p37: figure]

TT3 AutoLS-Infinity
V=13,72l- (1,98l+2,8l)(Ziegel) =8,94l

HT 16Ohm
U-2275

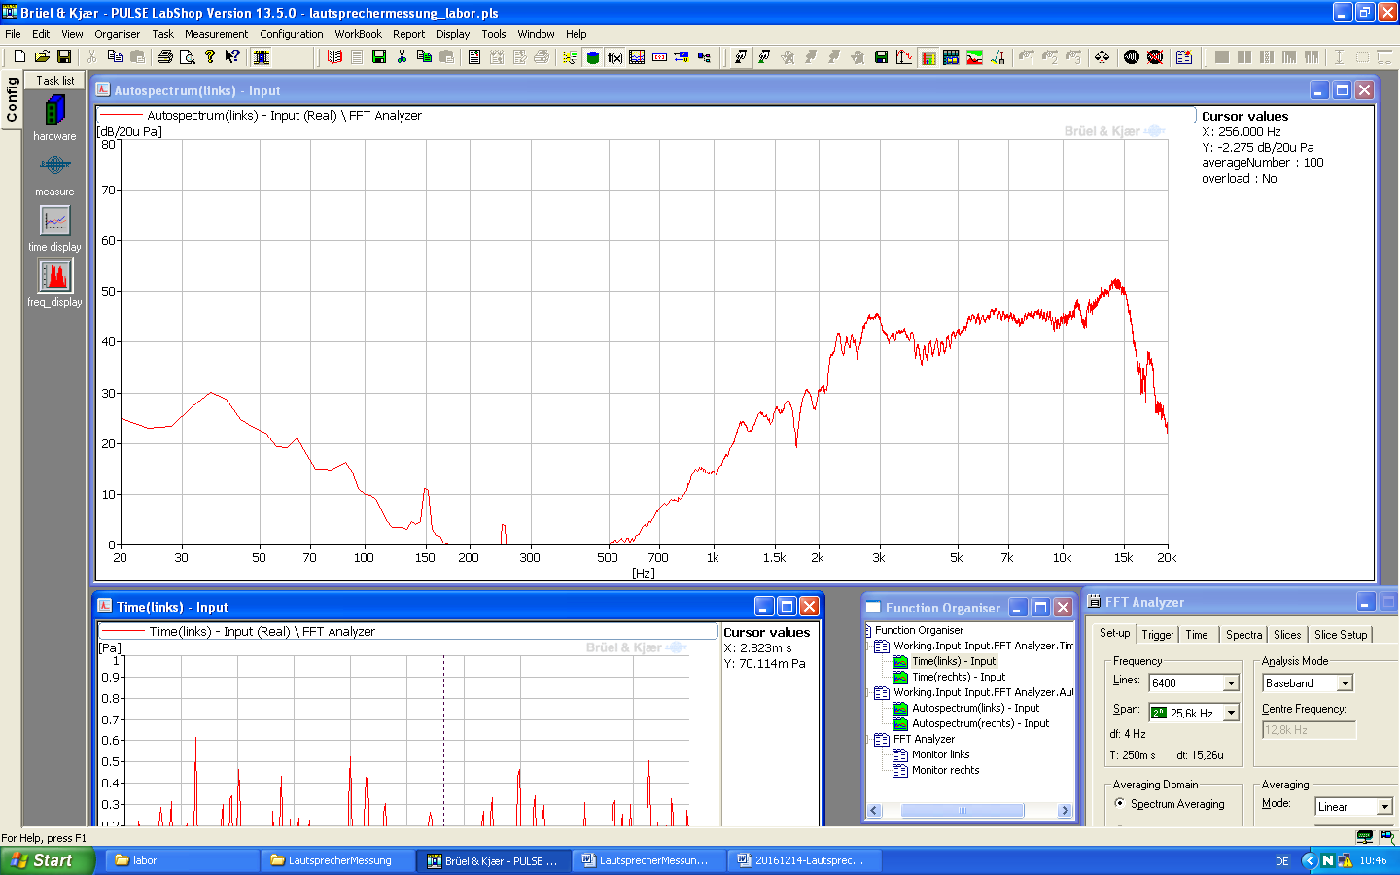
[picture p38: figure]
