crazyskater9/Diplomarbeit/form/ArbeitsnachweisBointner1von3.PNG

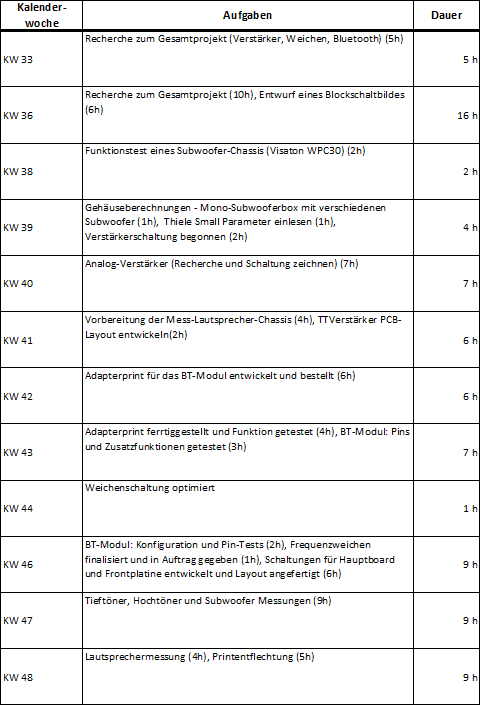
form/ArbeitsnachweisBointner1von3.PNG
