crazyskater9/Diplomarbeit/form/ArbeitsnachweisBointner2von3.PNG

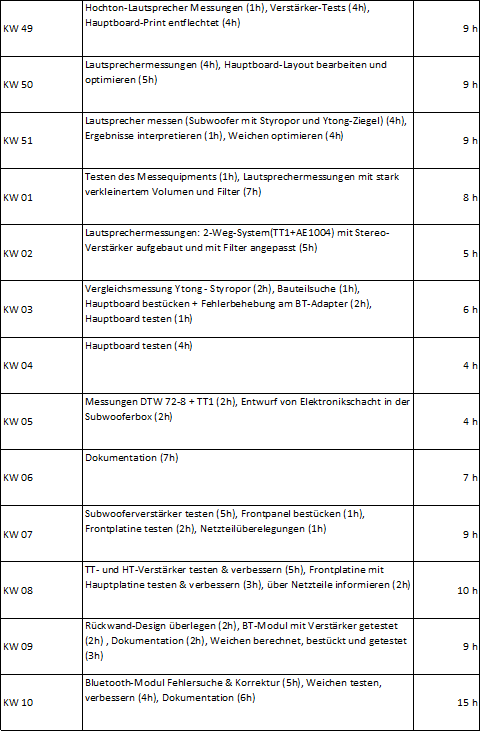
form/ArbeitsnachweisBointner2von3.PNG
