crazyskater9/Diplomarbeit/form/ArbeitsnachweisBointner3von3.PNG

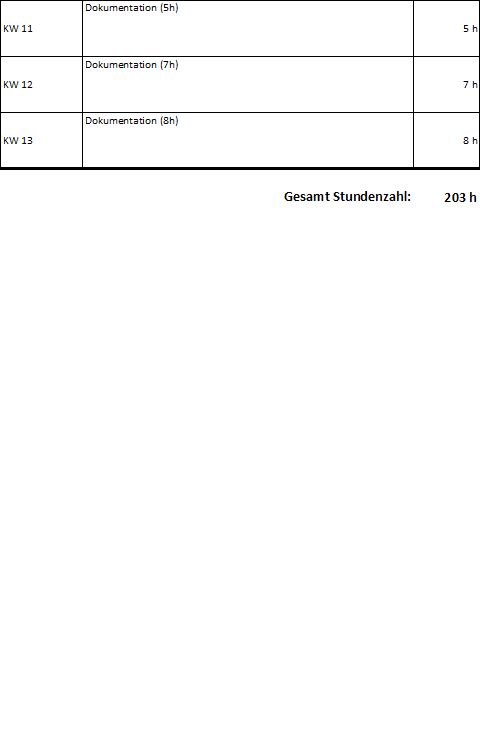
form/ArbeitsnachweisBointner3von3.PNG
