crazyskater9/Diplomarbeit/form/ArbeitsnachweisMacsek1von3.PNG

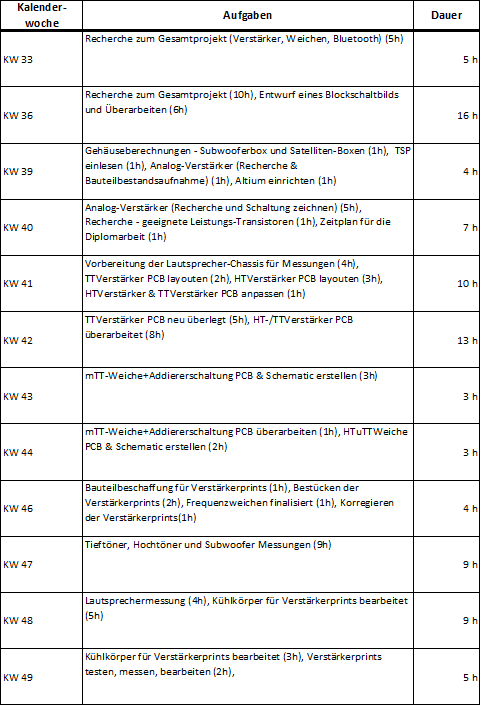
form/ArbeitsnachweisMacsek1von3.PNG
