crazyskater9/Diplomarbeit/form/ArbeitsnachweisMacsek2von3.PNG

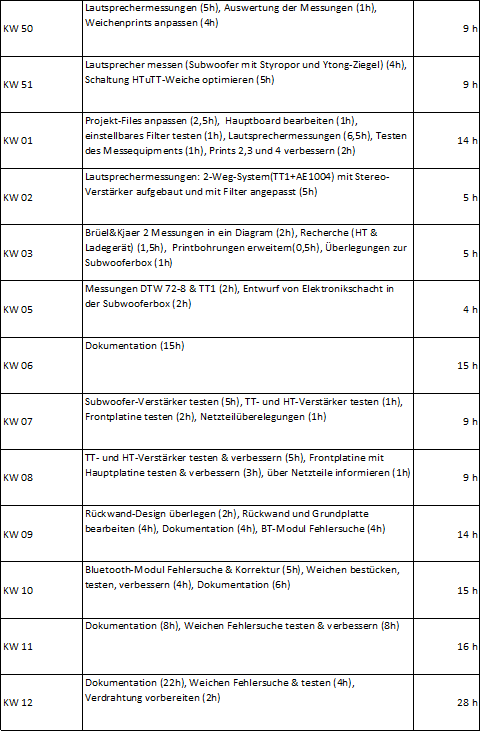
form/ArbeitsnachweisMacsek2von3.PNG
