crazyskater9/Diplomarbeit/form/ArbeitsnachweisMacsek3von3.PNG

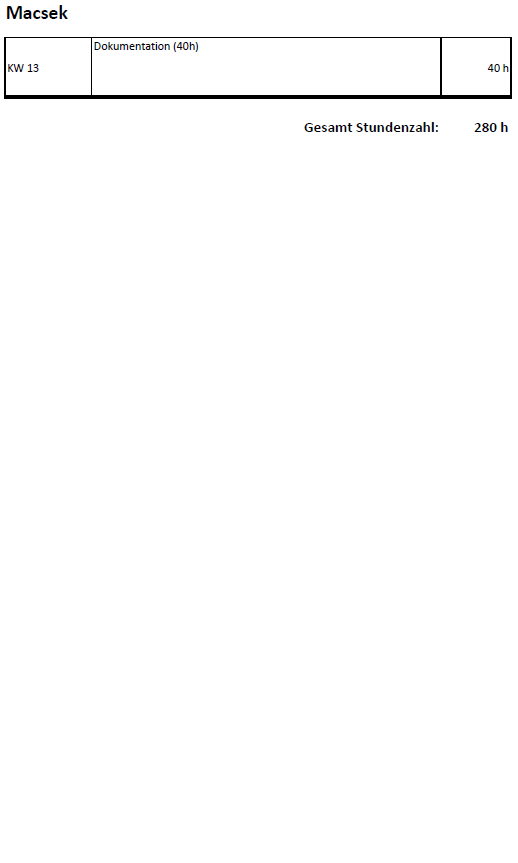
form/ArbeitsnachweisMacsek3von3.PNG
