crazyskater9/Diplomarbeit/form/BEP.PNG

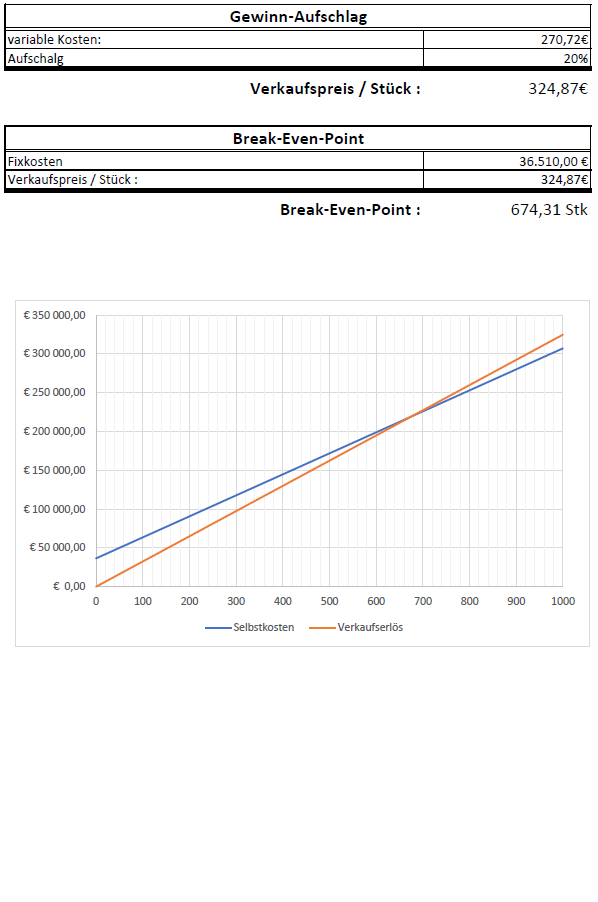
form/BEP.PNG
