crazyskater9/Diplomarbeit/form/Fixkosten.PNG

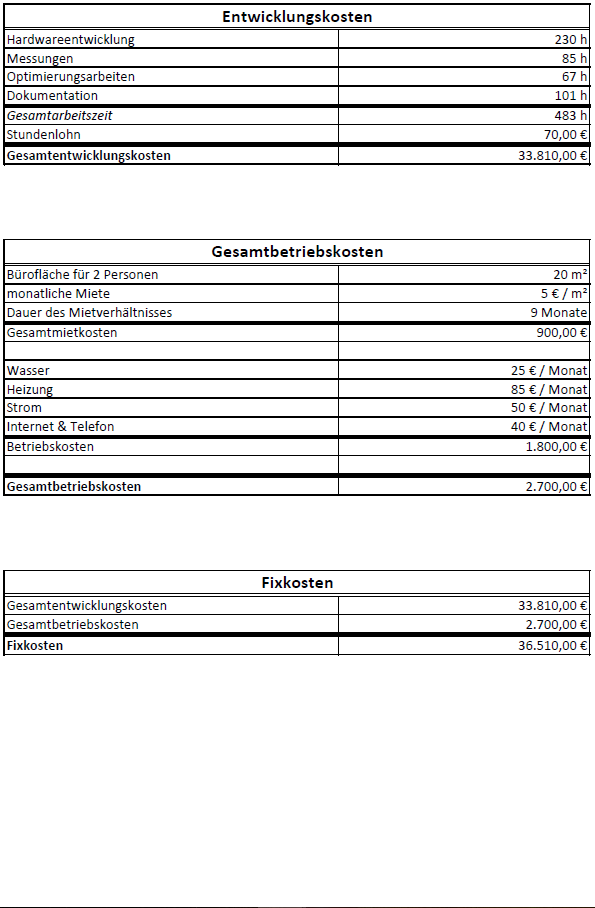
form/Fixkosten.PNG
