crazyskater9/Diplomarbeit/form/Materialkosten1.PNG

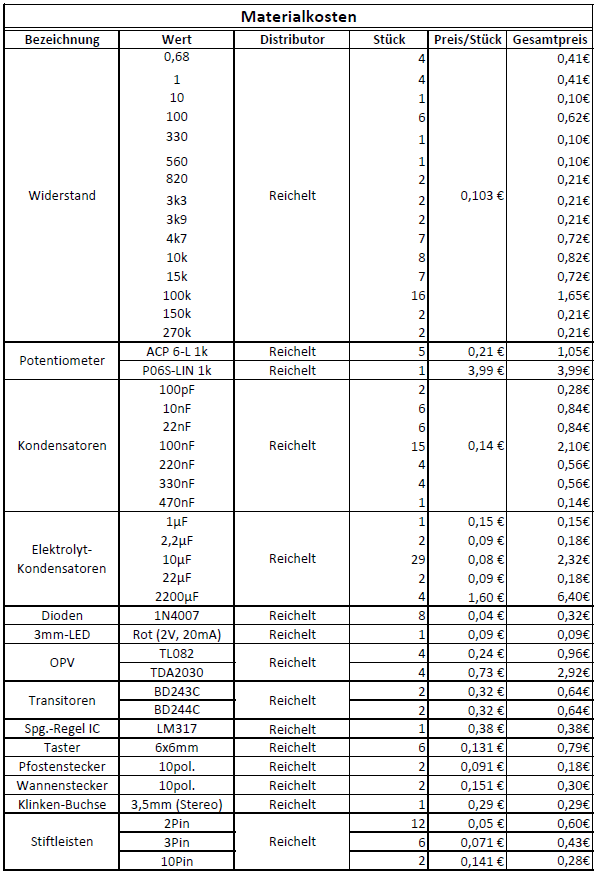
form/Materialkosten1.PNG
