crazyskater9/Diplomarbeit/form/Materialkosten2.PNG

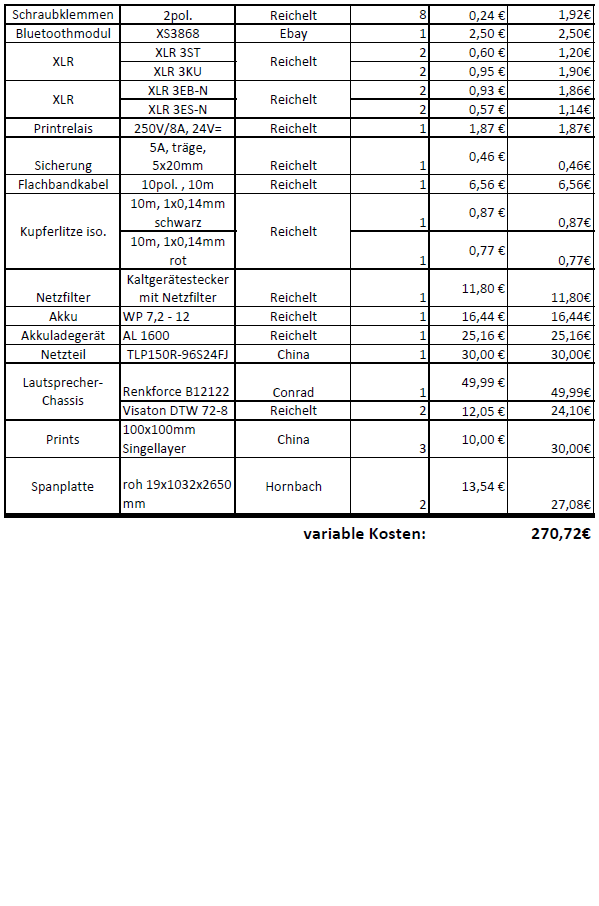
form/Materialkosten2.PNG
