crazyskater9/Diplomarbeit/form/tda2030first.PNG

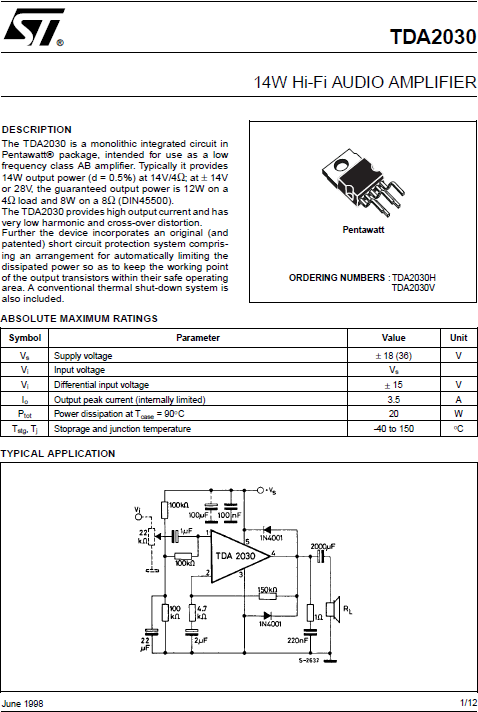
form/tda2030first.PNG
