crazyskater9/Diplomarbeit/form/VIS_DTW72.PNG

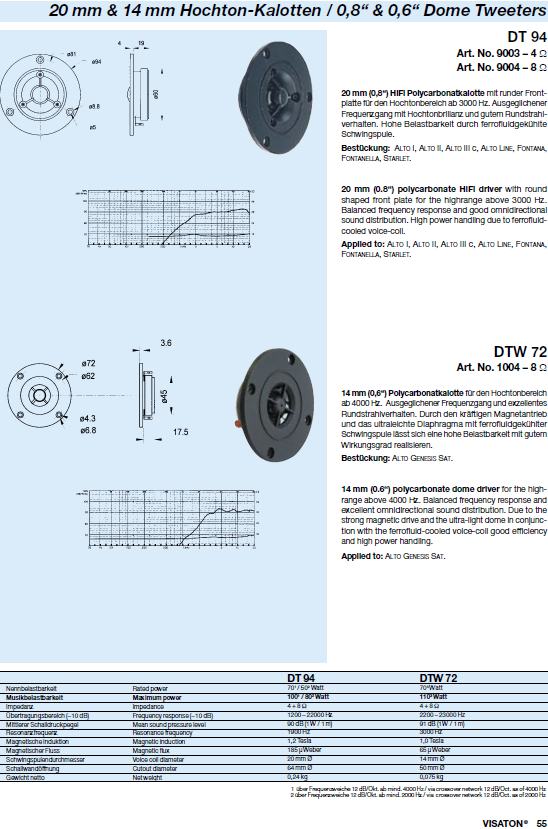
form/VIS_DTW72.PNG
