crazyskater9/Diplomarbeit/img/blockschaltbild.png

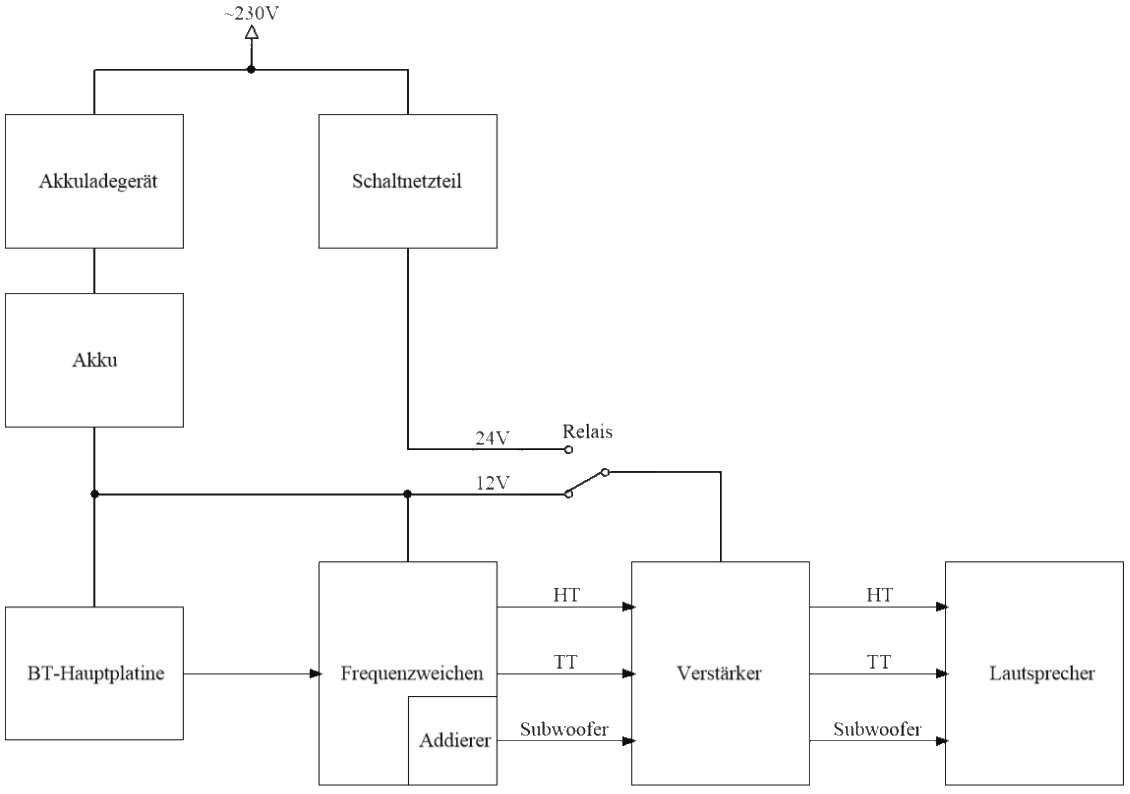
img/blockschaltbild.png
