crazyskater9/Diplomarbeit/img/blockschaltbild_eng.png

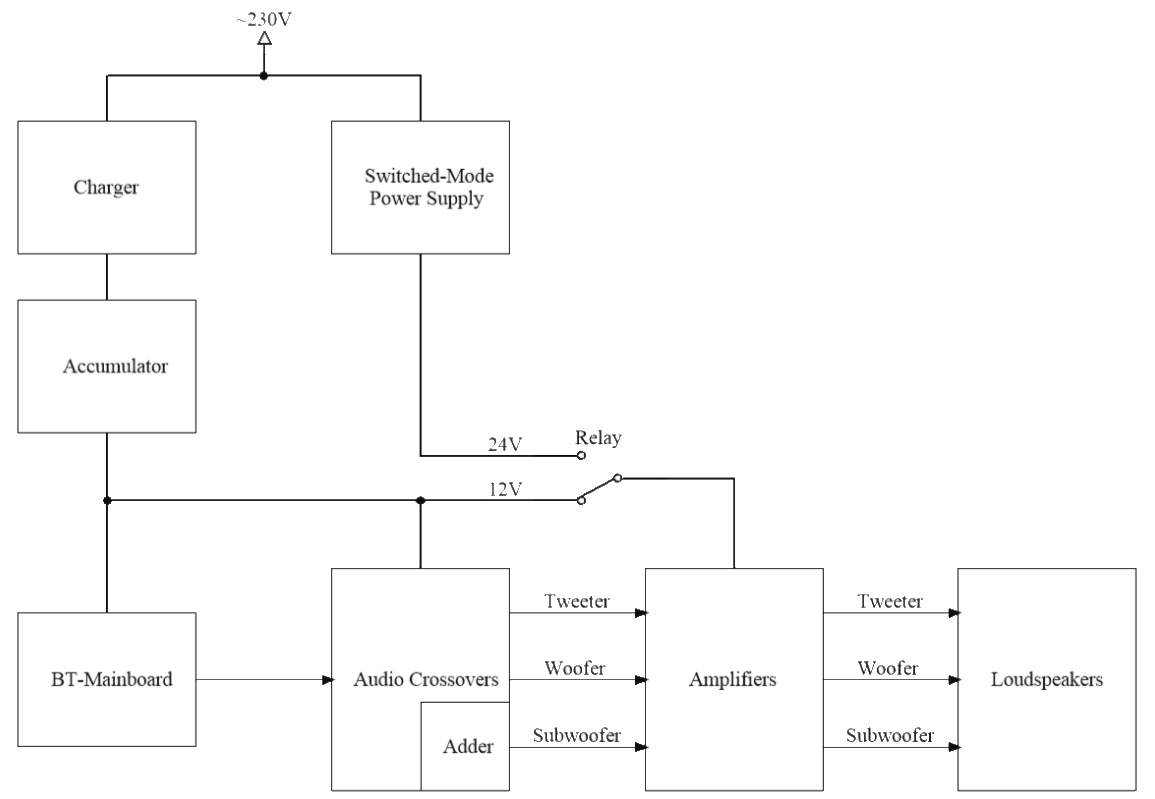
img/blockschaltbild_eng.png
