crazyskater9/Diplomarbeit/img/BTModul/adapter_Best.png

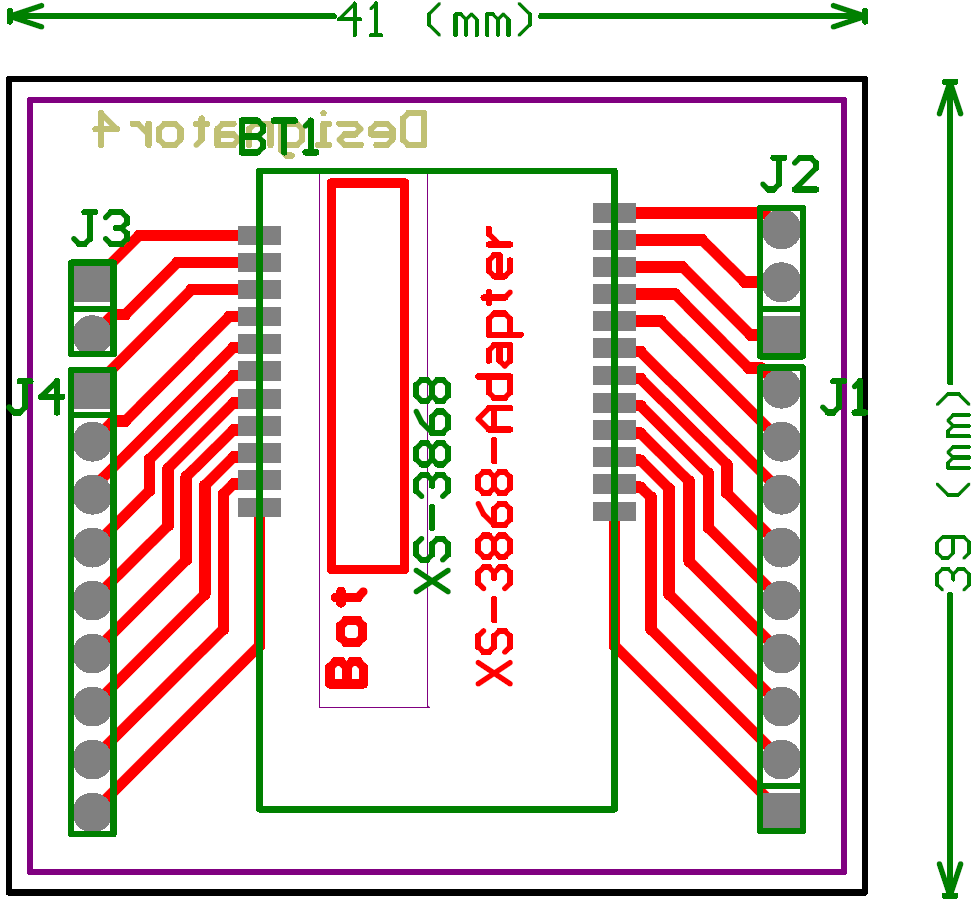
img/BTModul/adapter_Best.png
