crazyskater9/Diplomarbeit/img/BTModul/adapter_pcb.png

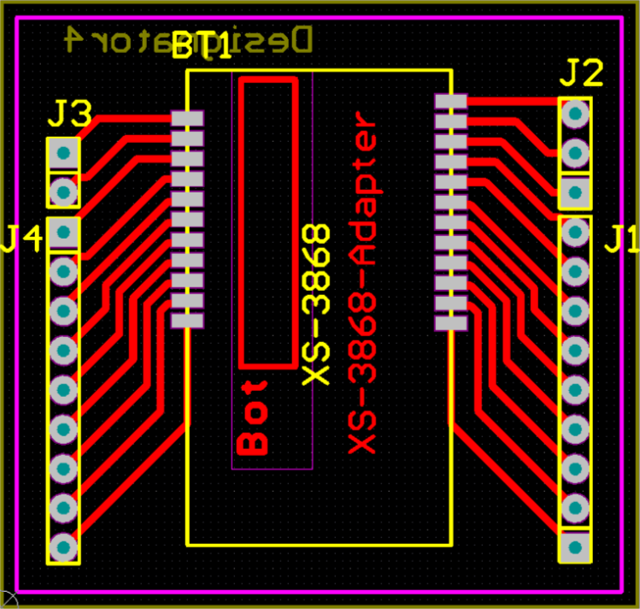
img/BTModul/adapter_pcb.png
