crazyskater9/Diplomarbeit/img/BTModul/adapter_sch.png

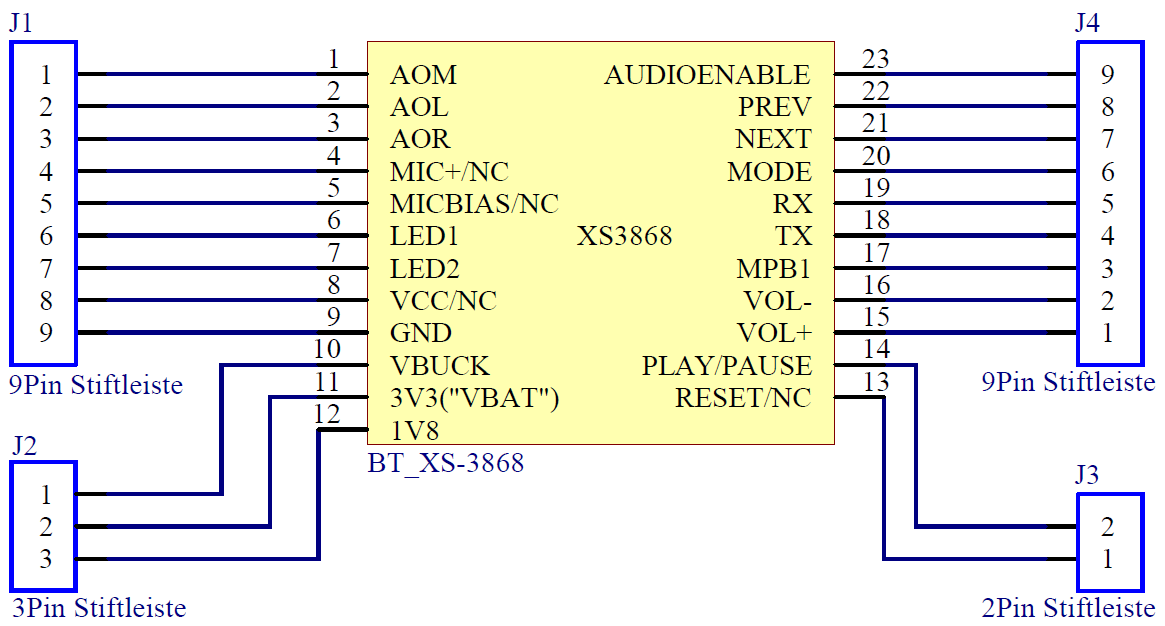
img/BTModul/adapter_sch.png
