crazyskater9/Diplomarbeit/img/BTModul/blockschaltbild.png

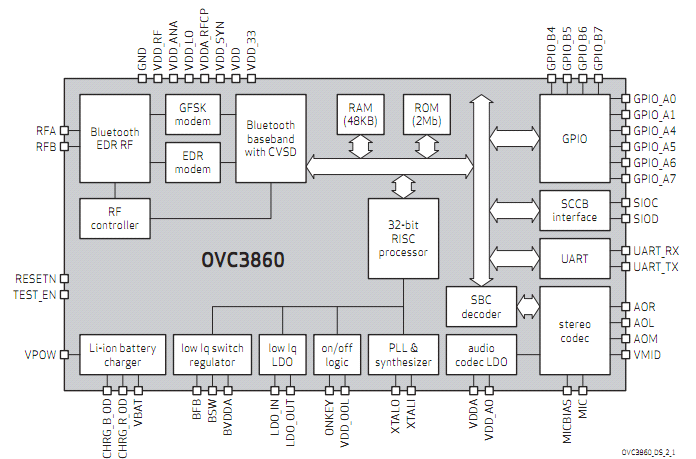
img/BTModul/blockschaltbild.png
