crazyskater9/Diplomarbeit/img/BTModul/front_best.png

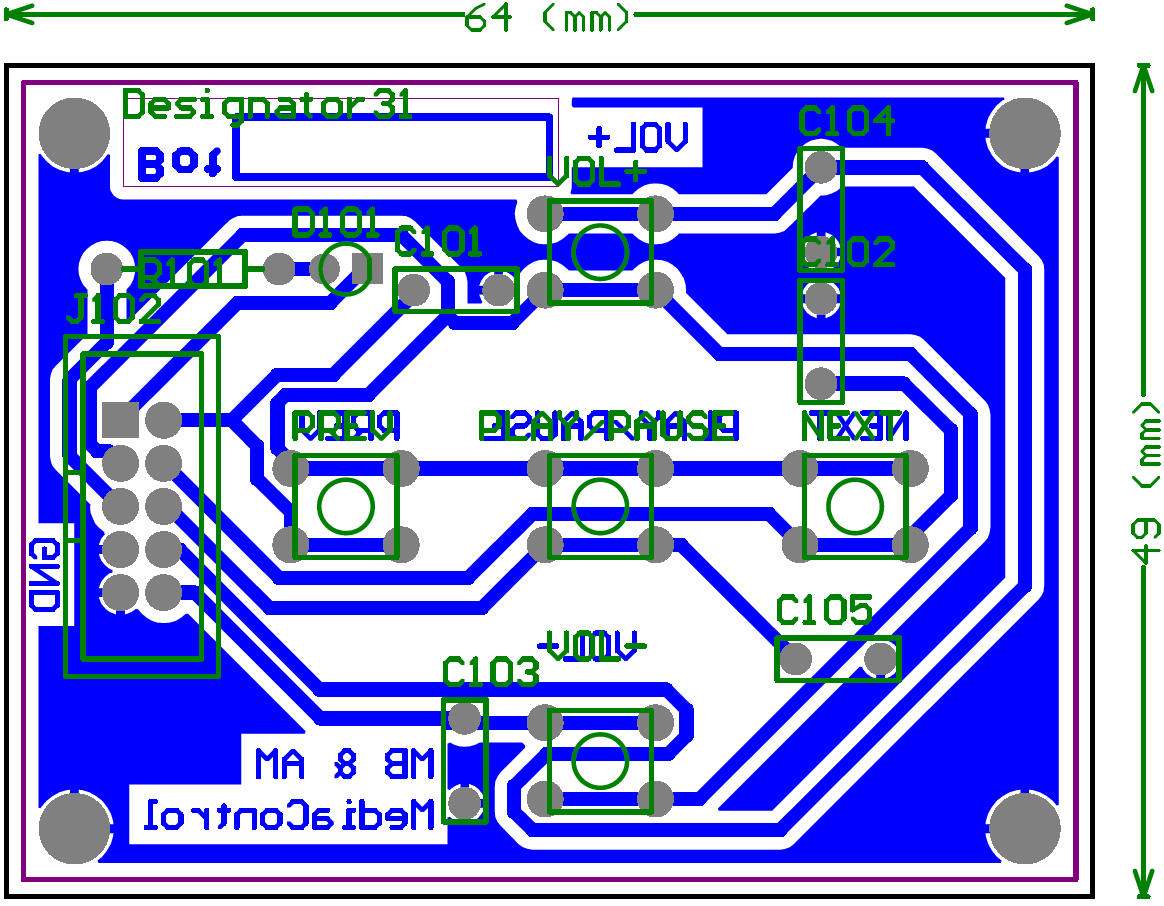
img/BTModul/front_best.png
