crazyskater9/Diplomarbeit/img/BTModul/front_blist.png

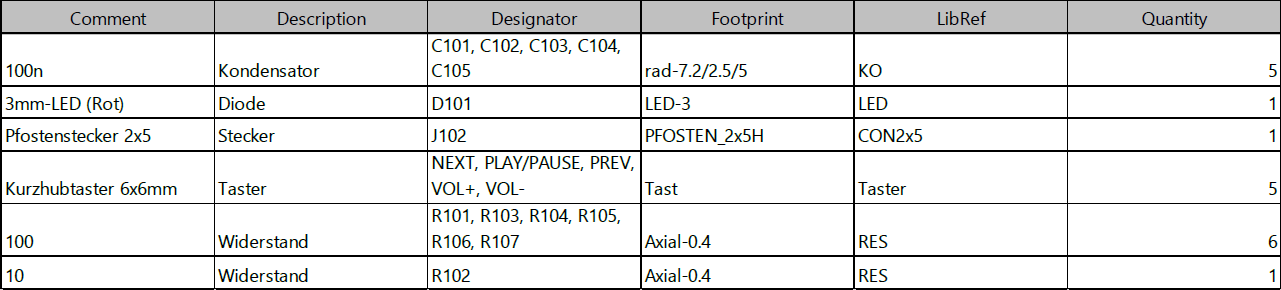
img/BTModul/front_blist.png
