crazyskater9/Diplomarbeit/img/BTModul/front_pcb.png

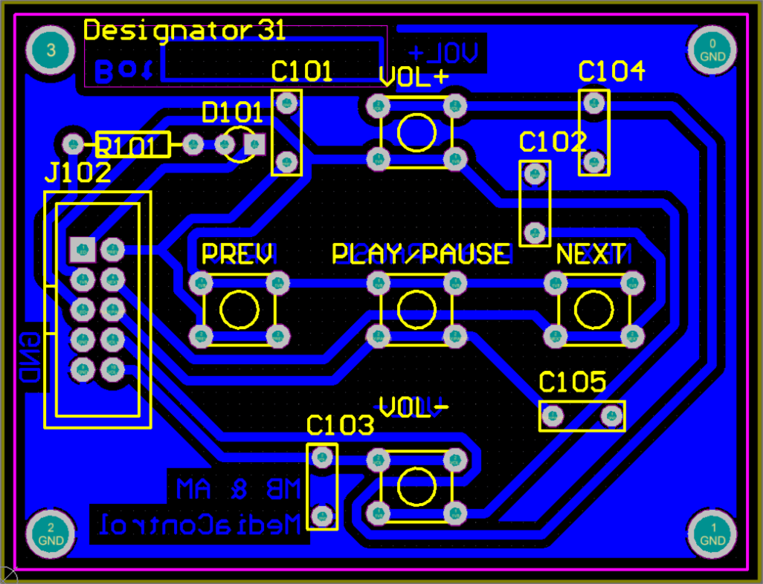
img/BTModul/front_pcb.png
