crazyskater9/Diplomarbeit/img/BTModul/front_sch.png

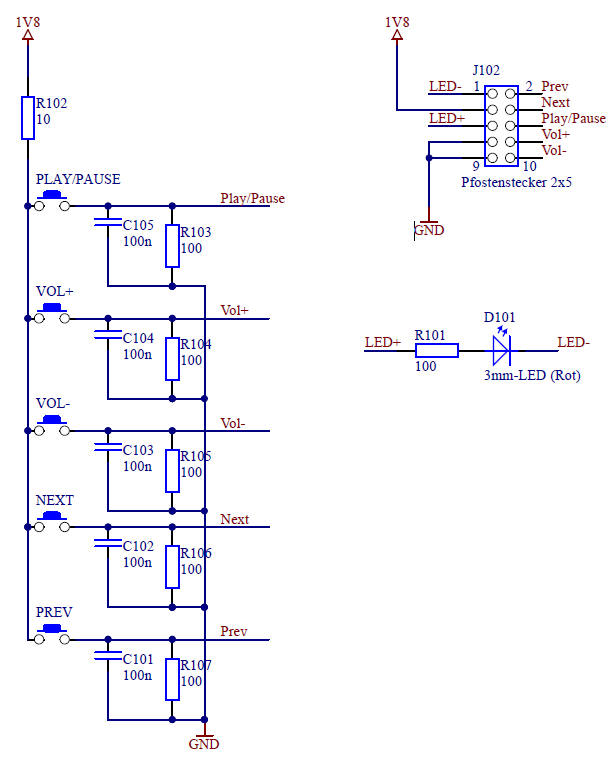
img/BTModul/front_sch.png
