crazyskater9/Diplomarbeit/img/BTModul/hauptboard_Best.PNG

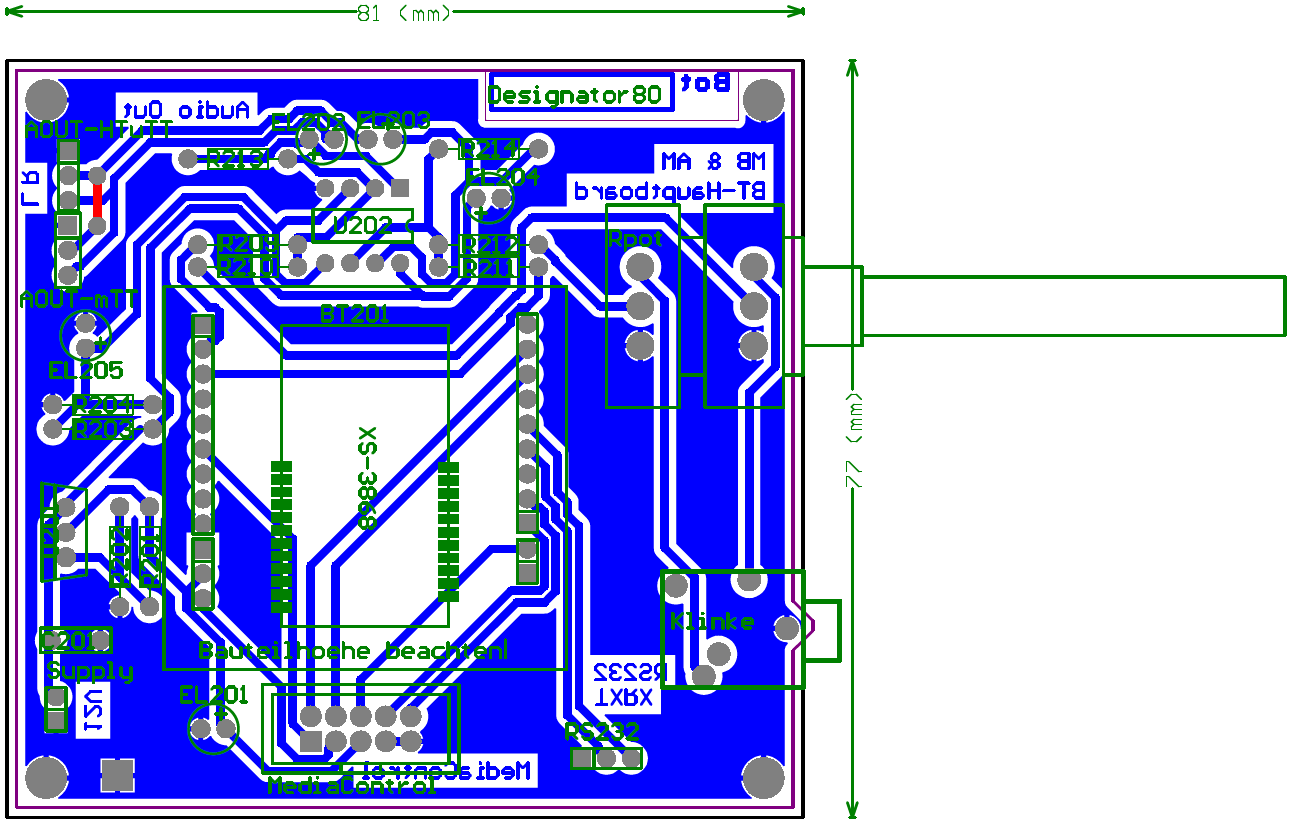
img/BTModul/hauptboard_Best.PNG
