crazyskater9/Diplomarbeit/img/BTModul/hauptboard_Blist.PNG

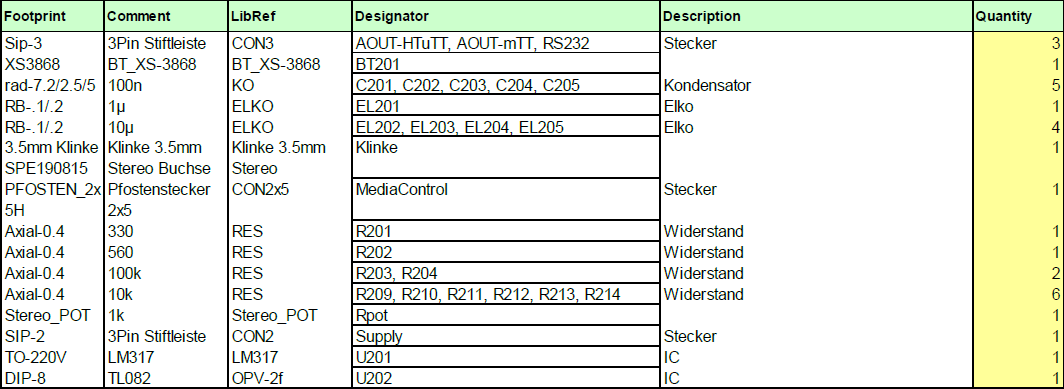
img/BTModul/hauptboard_Blist.PNG
