crazyskater9/Diplomarbeit/img/BTModul/hauptboard_pcb.png

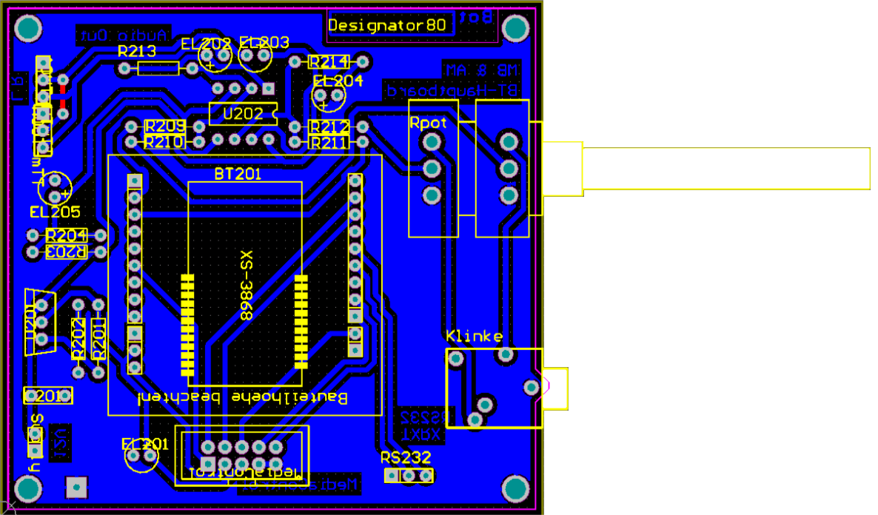
img/BTModul/hauptboard_pcb.png
