crazyskater9/Diplomarbeit/img/BTModul/hauptboard_sch1.png

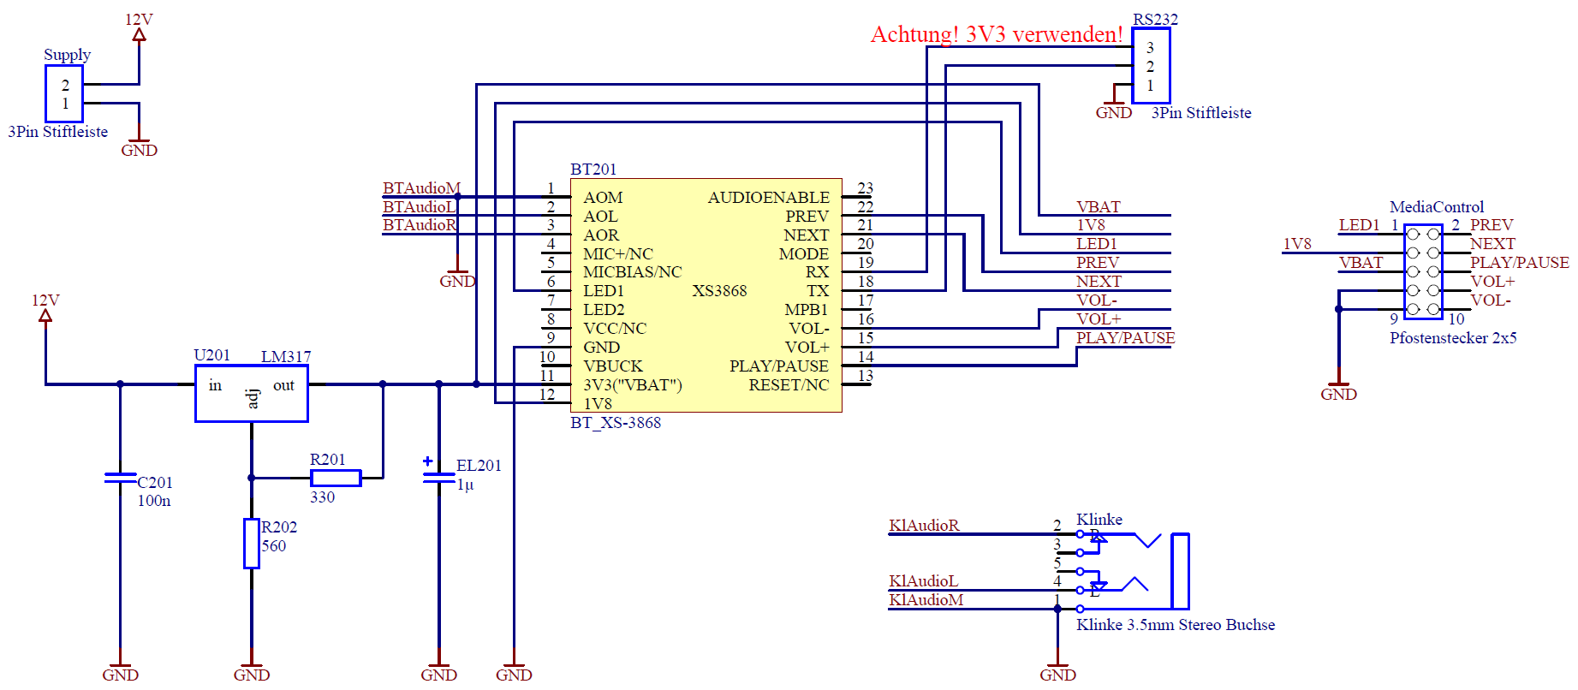
img/BTModul/hauptboard_sch1.png
