crazyskater9/Diplomarbeit/img/BTModul/hauptboard_sch2.png

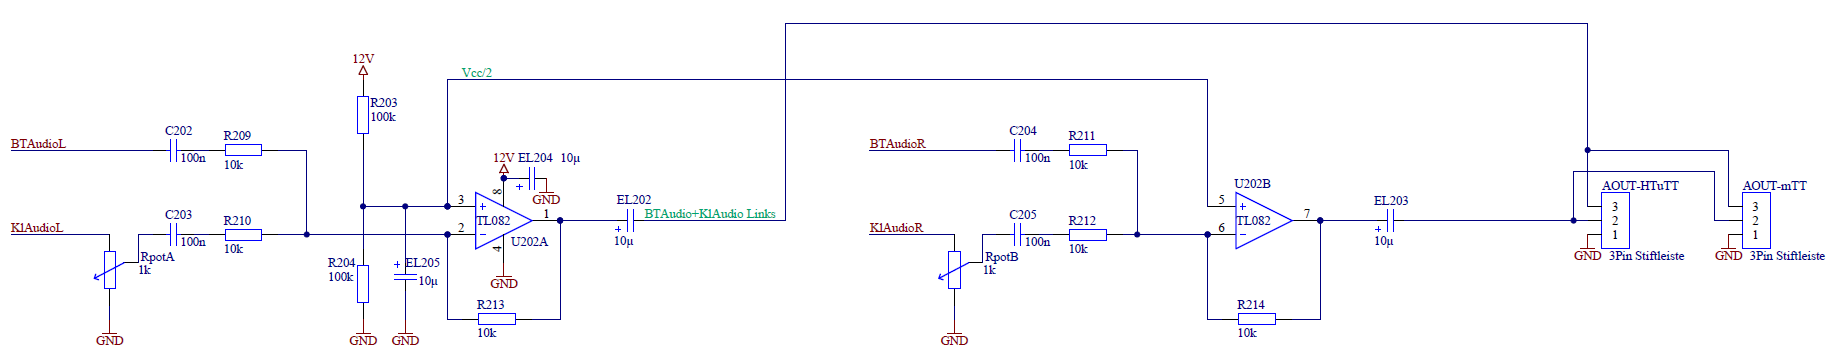
img/BTModul/hauptboard_sch2.png
