crazyskater9/Diplomarbeit/img/BTModul/hauptboard_sch2_zoom.png

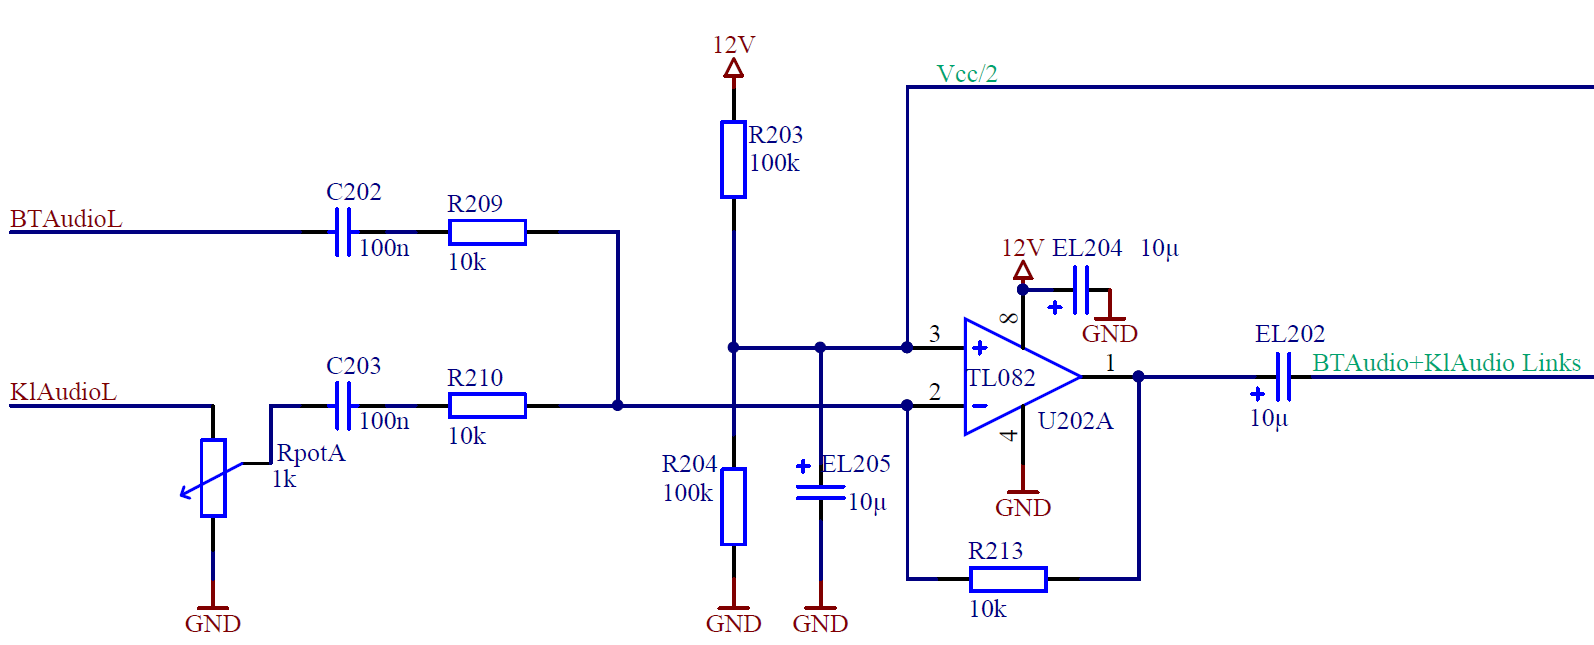
img/BTModul/hauptboard_sch2_zoom.png
