crazyskater9/Diplomarbeit/img/BTModul/hauptboard_sch.PNG

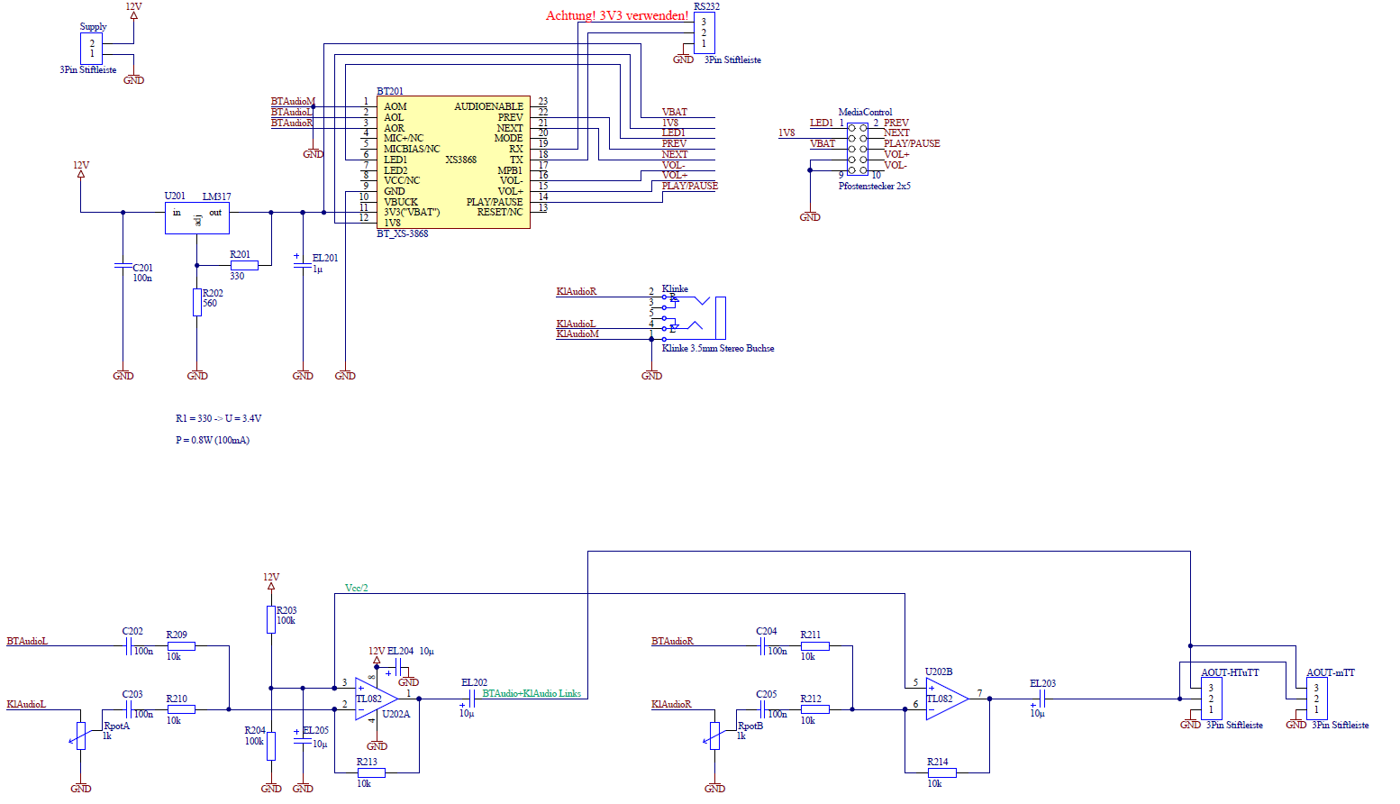
img/BTModul/hauptboard_sch.PNG
