crazyskater9/Diplomarbeit/img/BTModul/IMG_20161124_121114.jpg

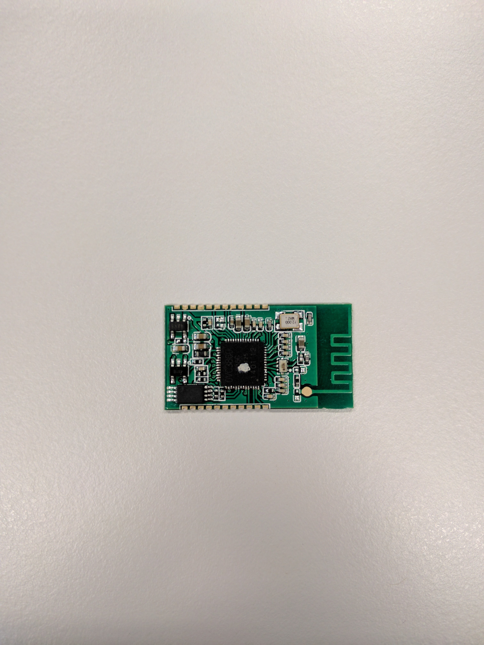
img/BTModul/IMG_20161124_121114.jpg
