crazyskater9/Diplomarbeit/img/BTModul/XS3868_Pinbelegung.png

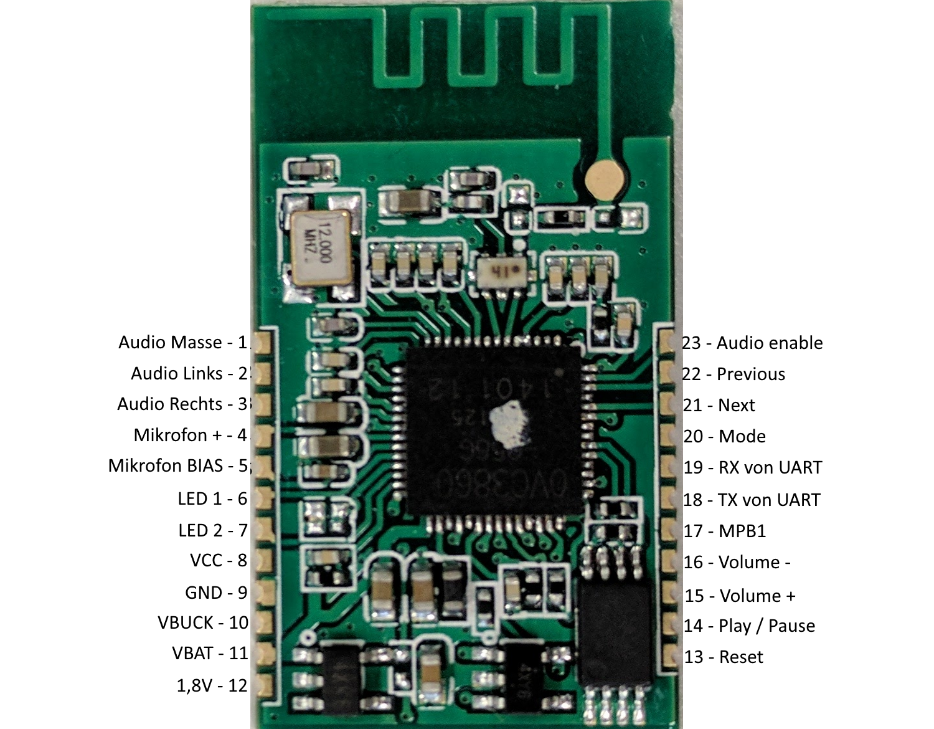
img/BTModul/XS3868_Pinbelegung.png
