crazyskater9/Diplomarbeit/img/BTModul/XS3868_Prinzipschaltung.png

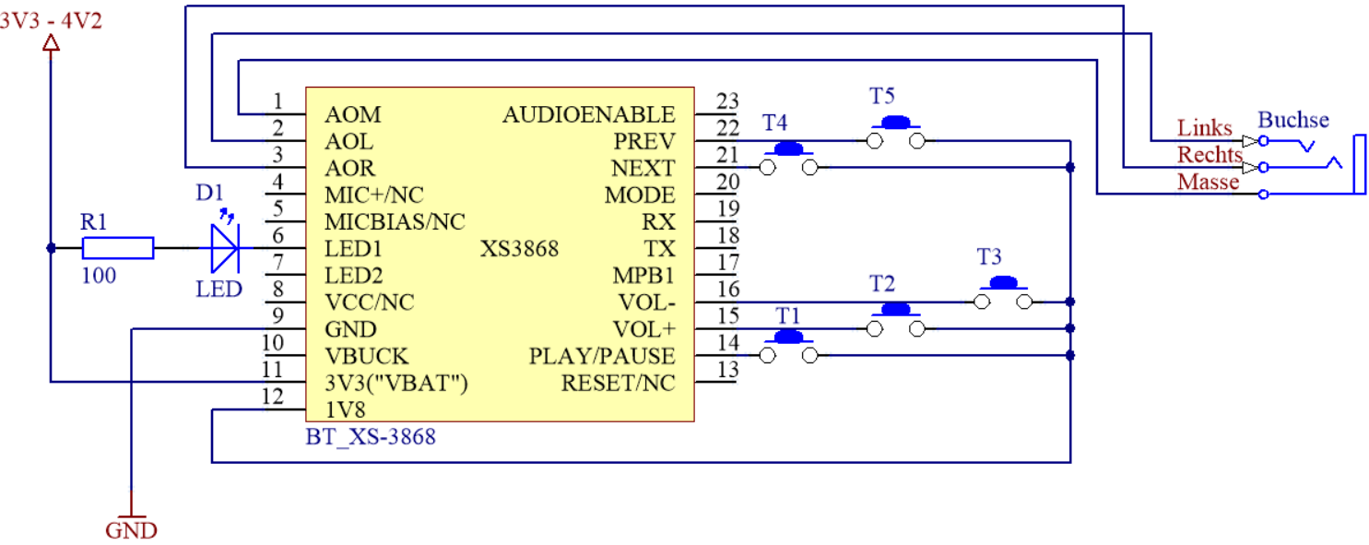
img/BTModul/XS3868_Prinzipschaltung.png
