crazyskater9/Diplomarbeit/img/Fertigungsunterlagen/Elektronikschacht2D.PNG

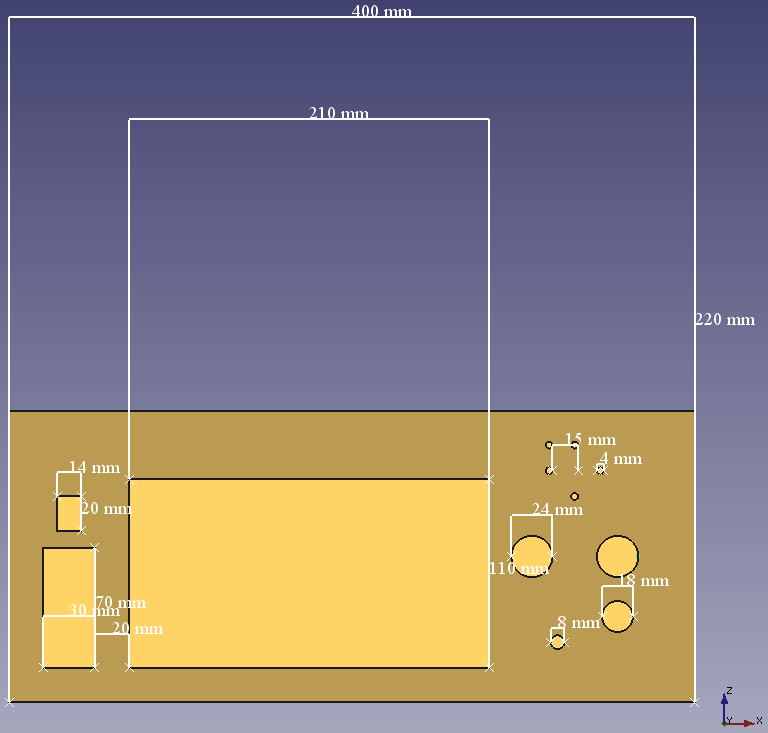
img/Fertigungsunterlagen/Elektronikschacht2D.PNG
