crazyskater9/Diplomarbeit/img/Fertigungsunterlagen/Elektronikschacht3D.PNG

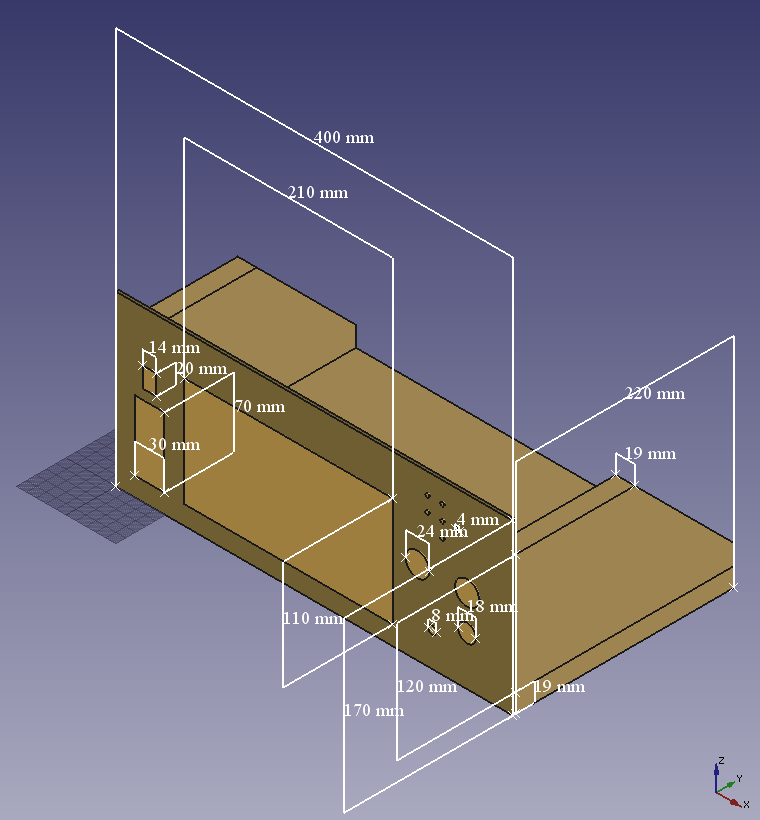
img/Fertigungsunterlagen/Elektronikschacht3D.PNG
