crazyskater9/Diplomarbeit/img/Fertigungsunterlagen/Satellitenbox.png

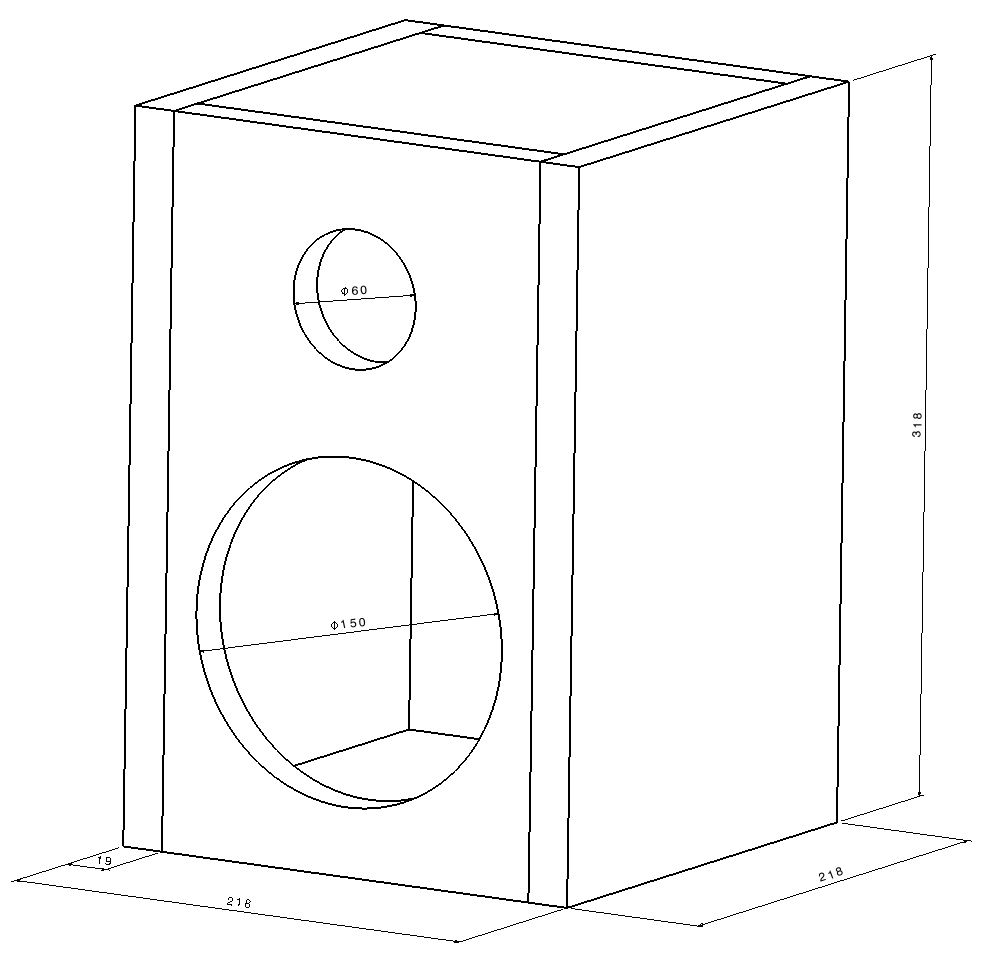
img/Fertigungsunterlagen/Satellitenbox.png
