crazyskater9/Diplomarbeit/img/Fertigungsunterlagen/Subwooferbox.png

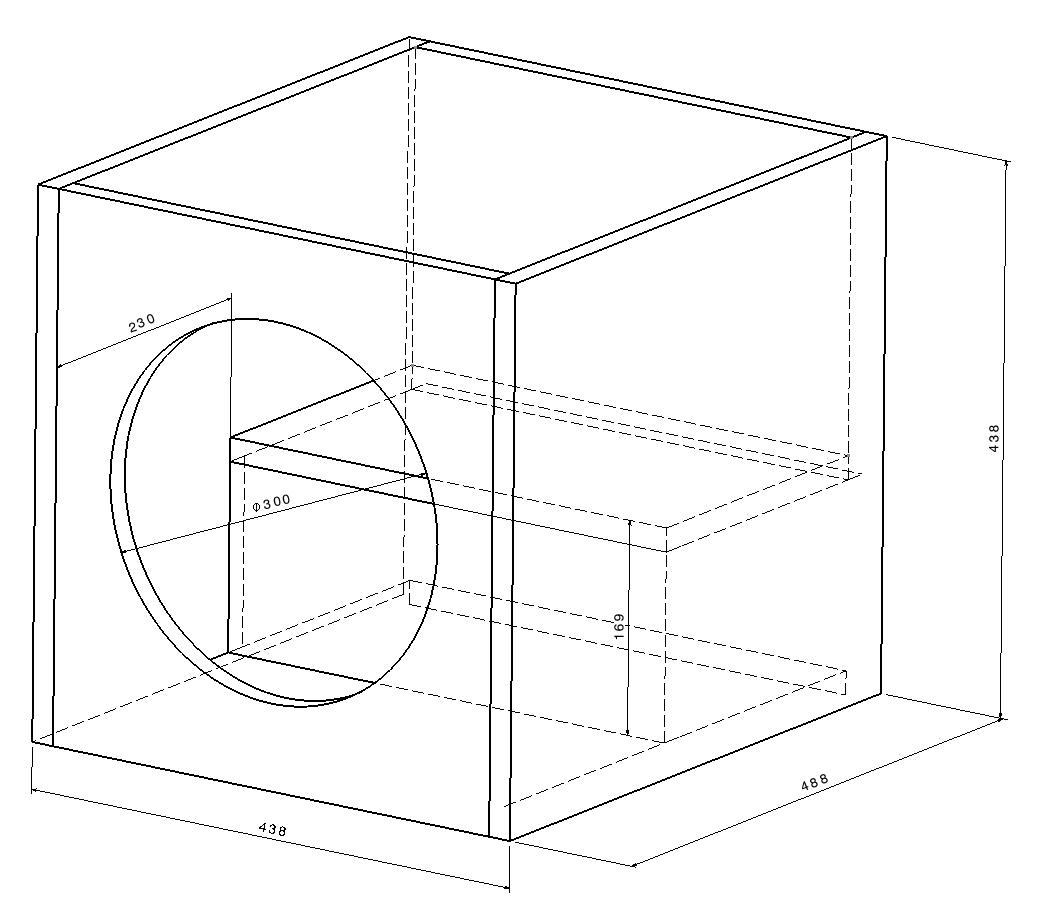
img/Fertigungsunterlagen/Subwooferbox.png
