crazyskater9/Diplomarbeit/img/Grundlagen/Bluetooth/BT-phone.png

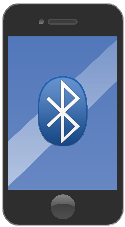
img/Grundlagen/Bluetooth/BT-phone.png
