crazyskater9/Diplomarbeit/img/Grundlagen/Bluetooth/BT-uebertragung-cut.jpg

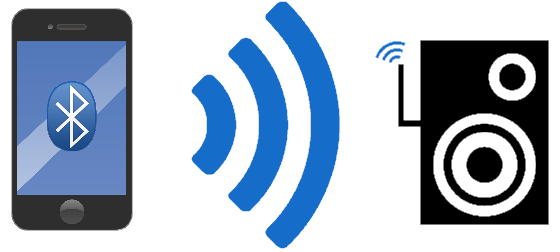
img/Grundlagen/Bluetooth/BT-uebertragung-cut.jpg
