crazyskater9/Diplomarbeit/img/Grundlagen/Bluetooth/BT-übertragung.png

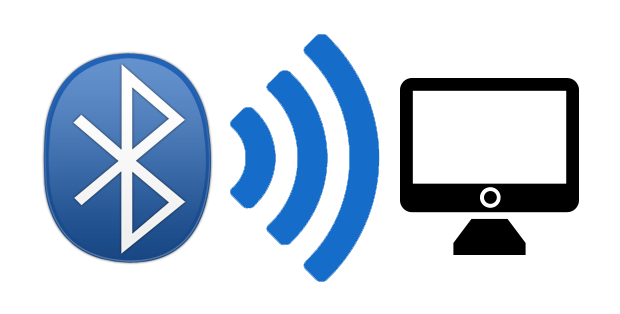
img/Grundlagen/Bluetooth/BT-übertragung.png
