crazyskater9/Diplomarbeit/img/Grundlagen/Bluetooth/lautsprecher.png

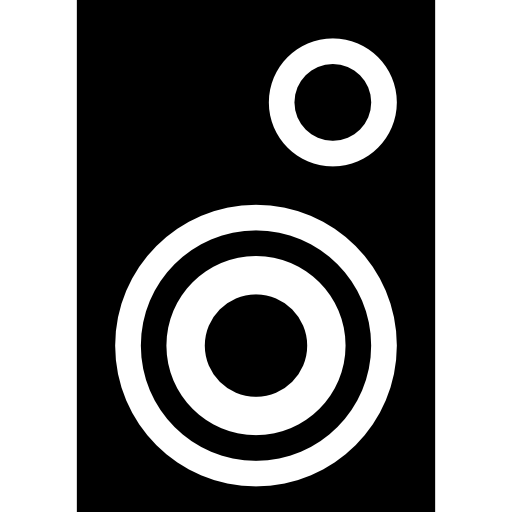
img/Grundlagen/Bluetooth/lautsprecher.png
