crazyskater9/Diplomarbeit/img/Grundlagen/Mehrweg-Lautsprechersysteme/DOLBY_Digital_5.1.png

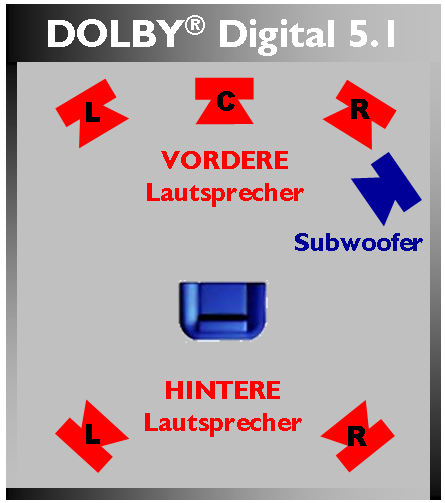
img/Grundlagen/Mehrweg-Lautsprechersysteme/DOLBY_Digital_5.1.png
