crazyskater9/Diplomarbeit/img/Grundlagen/Mehrweg-Lautsprechersysteme/DOLBYDigital2.0-cut.png

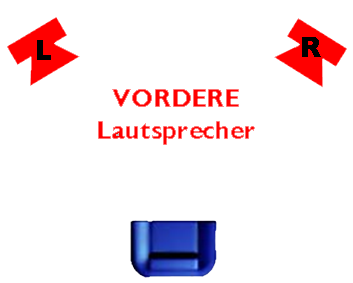
img/Grundlagen/Mehrweg-Lautsprechersysteme/DOLBYDigital2.0-cut.png
