crazyskater9/Diplomarbeit/img/Grundlagen/Mehrweg-Lautsprechersysteme/DOLBYDigital2.1-cut.png

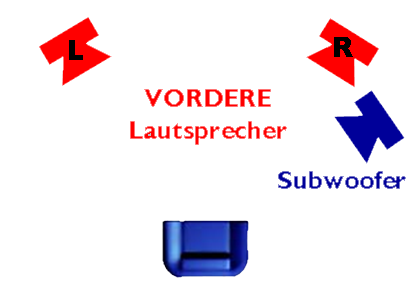
img/Grundlagen/Mehrweg-Lautsprechersysteme/DOLBYDigital2.1-cut.png
