crazyskater9/Diplomarbeit/img/Grundlagen/Mehrweg-Lautsprechersysteme/DOLBYDigital5.1-cut.png

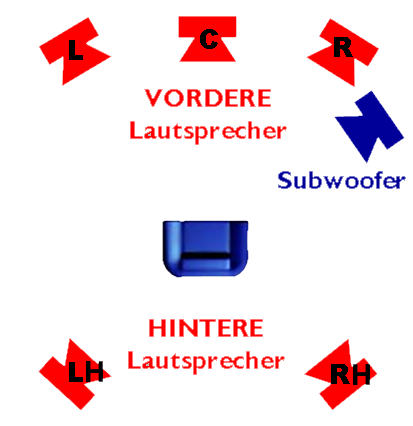
img/Grundlagen/Mehrweg-Lautsprechersysteme/DOLBYDigital5.1-cut.png
