crazyskater9/Diplomarbeit/img/Grundlagen/Mehrweg-Lautsprechersysteme/Frequenzbereiche-Audio-cut.jpg

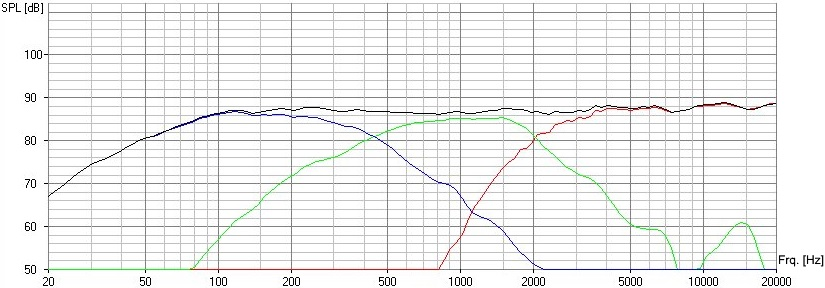
img/Grundlagen/Mehrweg-Lautsprechersysteme/Frequenzbereiche-Audio-cut.jpg
