crazyskater9/Diplomarbeit/img/Grundlagen/Mehrweg-Lautsprechersysteme/Frequenzbereiche-Audio-Weiche - Kopie.jpg

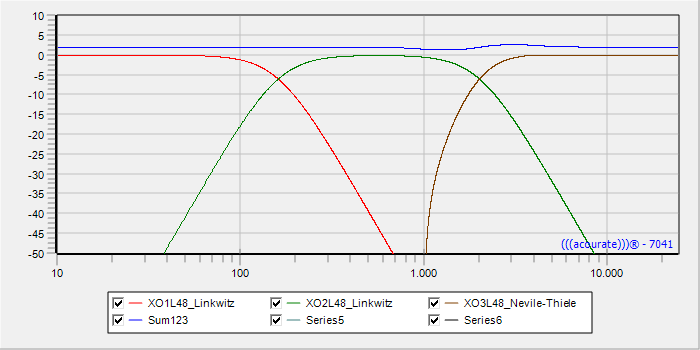
img/Grundlagen/Mehrweg-Lautsprechersysteme/Frequenzbereiche-Audio-Weiche - Kopie.jpg
