crazyskater9/Diplomarbeit/img/Grundlagen/Mehrweg-Lautsprechersysteme/Frequenzbereiche-Audio-Weiche-cut.jpg

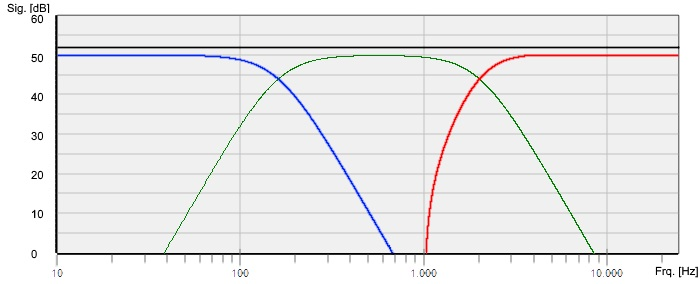
img/Grundlagen/Mehrweg-Lautsprechersysteme/Frequenzbereiche-Audio-Weiche-cut.jpg
