crazyskater9/Diplomarbeit/img/Grundlagen/Mehrweg-Lautsprechersysteme/Frequenzbereiche-Audio.jpg

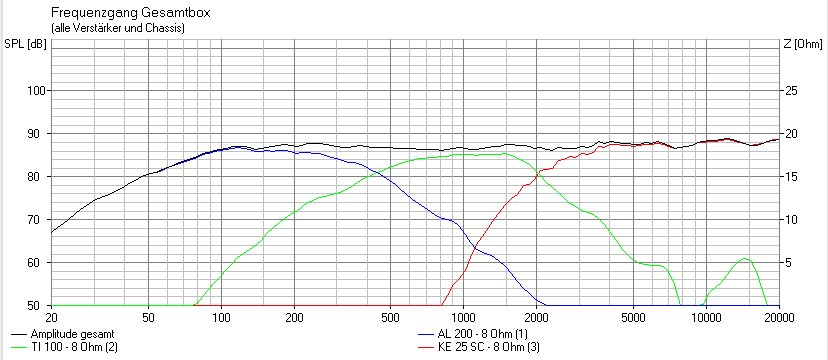
img/Grundlagen/Mehrweg-Lautsprechersysteme/Frequenzbereiche-Audio.jpg
