crazyskater9/Diplomarbeit/img/Grundlagen/Mehrweg-Lautsprechersysteme/opt-20-aufstellung.jpg

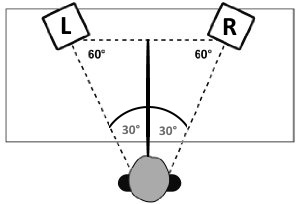
img/Grundlagen/Mehrweg-Lautsprechersysteme/opt-20-aufstellung.jpg
