crazyskater9/Diplomarbeit/img/Grundlagen/OPV-Verstaerker/OPV-VerstaerkerGrundschaltung.gif

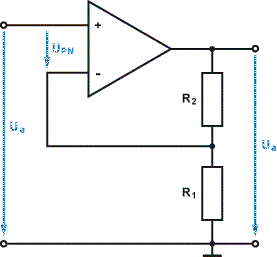
img/Grundlagen/OPV-Verstaerker/OPV-VerstaerkerGrundschaltung.gif
