crazyskater9/Diplomarbeit/img/Grundlagen/TDA2030/TDA2030-Grundschaltung.png

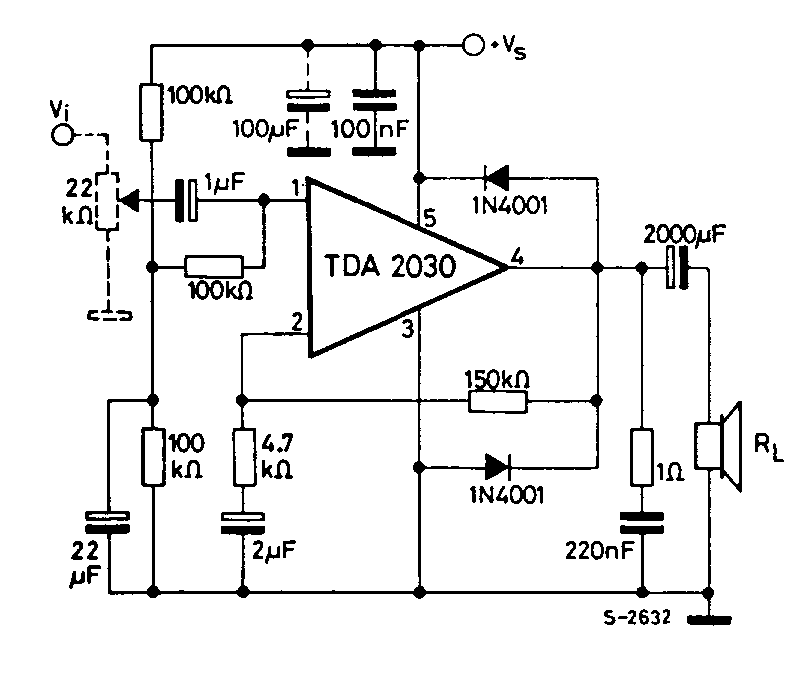
img/Grundlagen/TDA2030/TDA2030-Grundschaltung.png
