crazyskater9/Diplomarbeit/img/Grundlagen/TDA2030/TDA2030-H-Bruecke.PNG

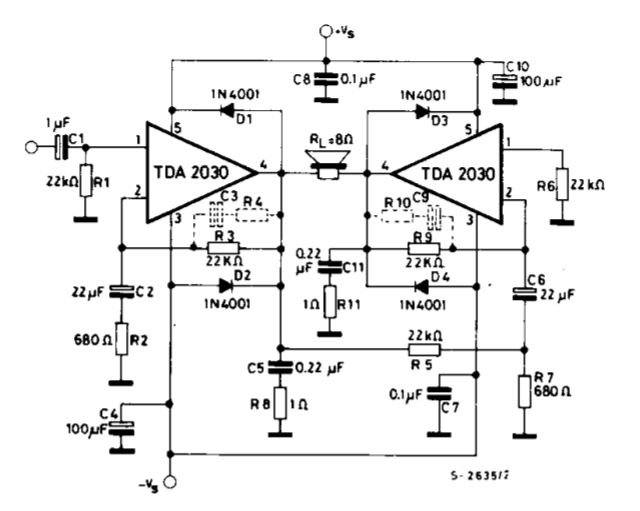
img/Grundlagen/TDA2030/TDA2030-H-Bruecke.PNG
