crazyskater9/Diplomarbeit/img/Grundlagen/TDA2030/TDA2030-Leistungstransschaltung.jpg

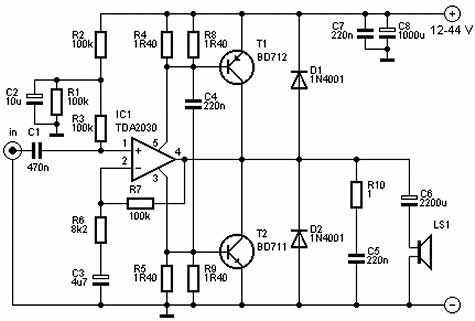
img/Grundlagen/TDA2030/TDA2030-Leistungstransschaltung.jpg
