crazyskater9/Diplomarbeit/img/Grundlagen/Versorgung.png

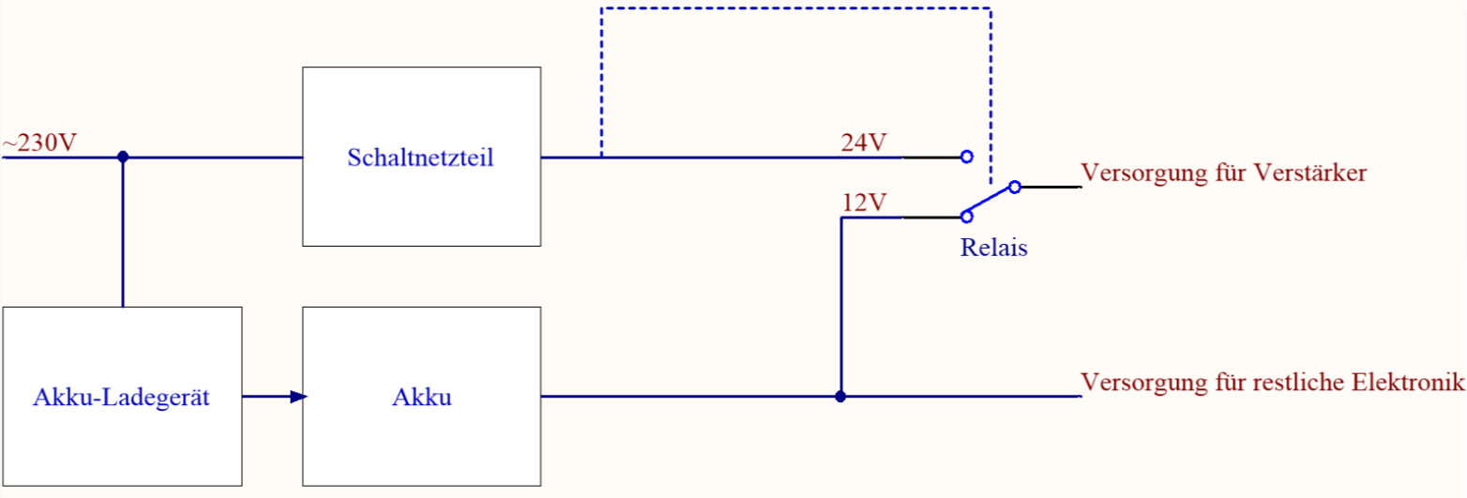
img/Grundlagen/Versorgung.png
