crazyskater9/Diplomarbeit/img/Grundlagen/VersorgungV2.png

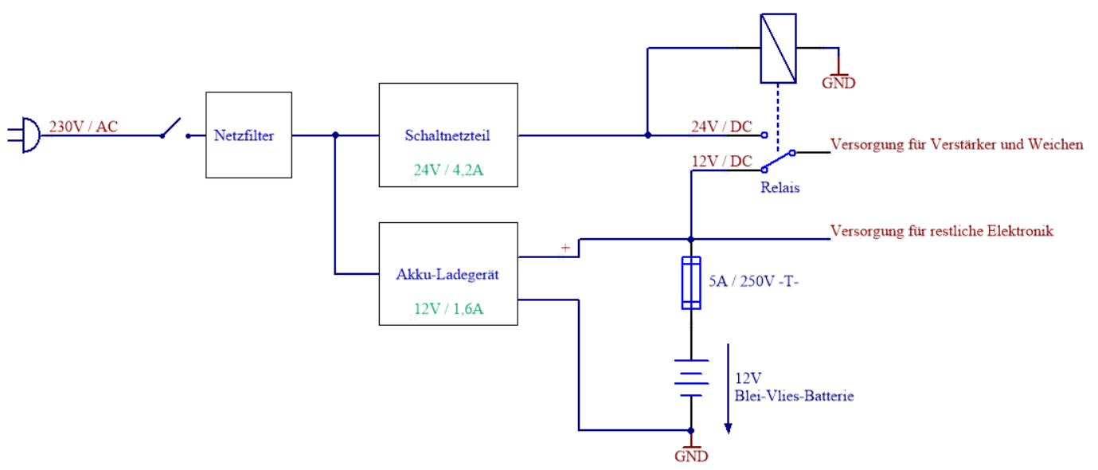
img/Grundlagen/VersorgungV2.png
