crazyskater9/Diplomarbeit/img/LSMessung/akkustiklabor1.jpg

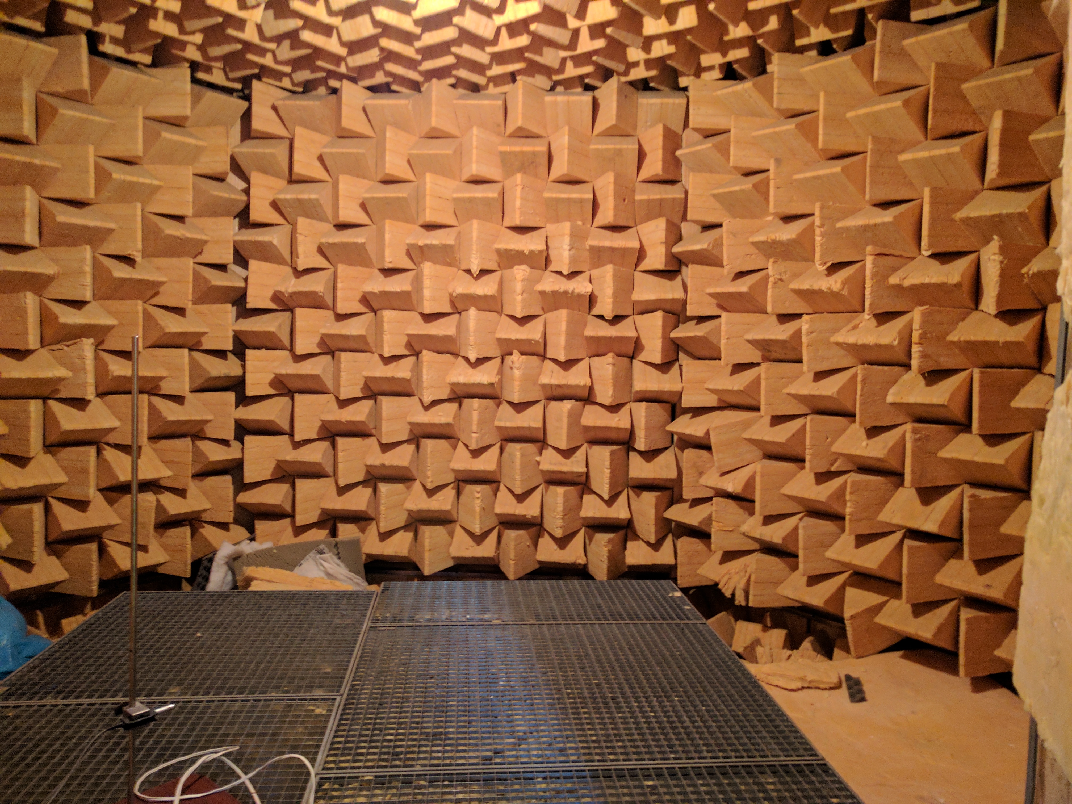
img/LSMessung/akkustiklabor1.jpg
