crazyskater9/Diplomarbeit/img/LSMessung/akkustiklabor2.jpg

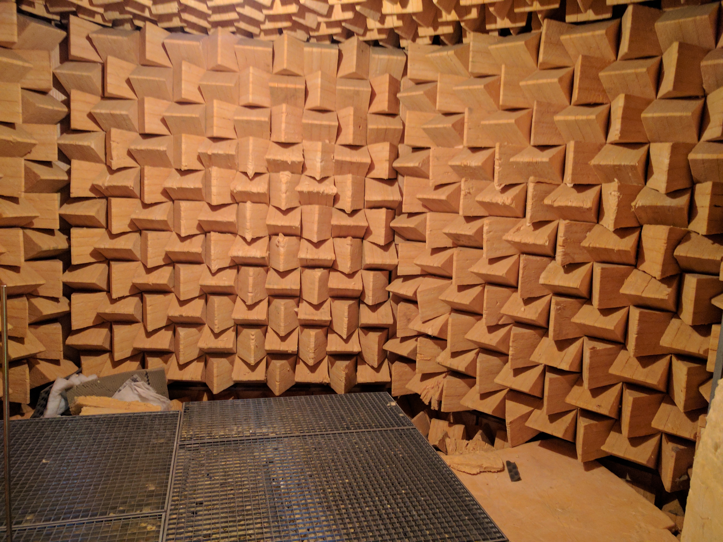
img/LSMessung/akkustiklabor2.jpg
