crazyskater9/Diplomarbeit/img/LSMessung/HT/AE1004_1m_erhoeht.png

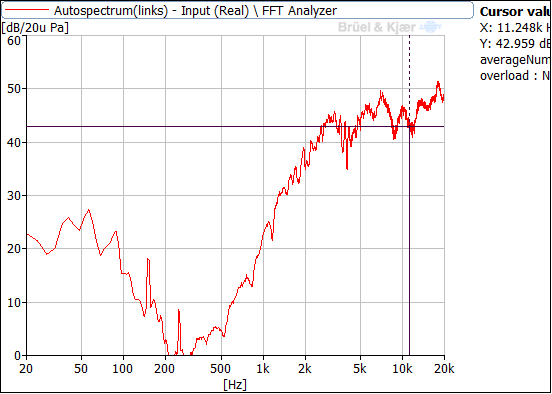
img/LSMessung/HT/AE1004_1m_erhoeht.png
