crazyskater9/Diplomarbeit/img/LSMessung/HT/DT4810ASZR_1m_erhoeht.png

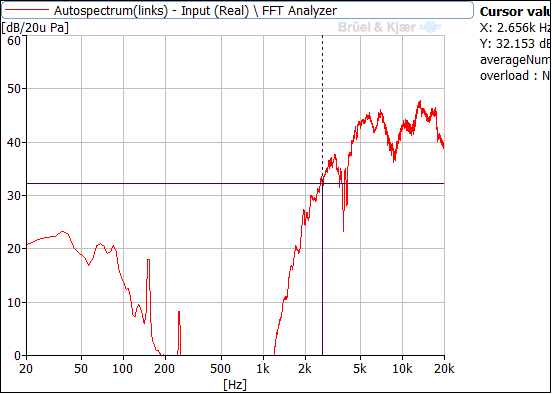
img/LSMessung/HT/DT4810ASZR_1m_erhoeht.png
