crazyskater9/Diplomarbeit/img/LSMessung/HT/dtw72.jpg

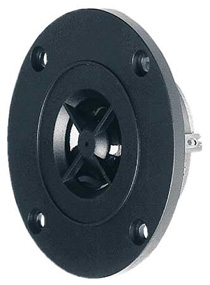
img/LSMessung/HT/dtw72.jpg
