crazyskater9/Diplomarbeit/img/LSMessung/HT/Sharp_1m_erhoeht.png

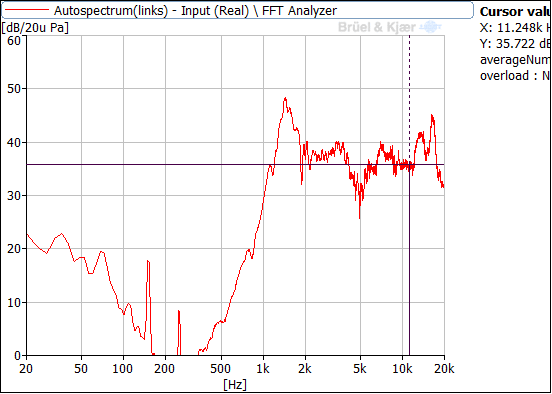
img/LSMessung/HT/Sharp_1m_erhoeht.png
