crazyskater9/Diplomarbeit/img/LSMessung/HT/TW203_1m_erhoeht.png

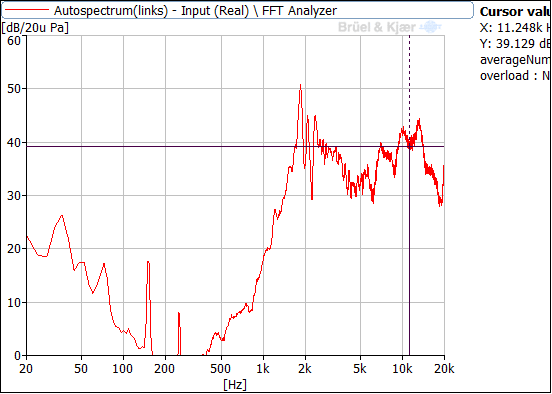
img/LSMessung/HT/TW203_1m_erhoeht.png
