crazyskater9/Diplomarbeit/img/LSMessung/HT/U2275_1m_erhoeht.png

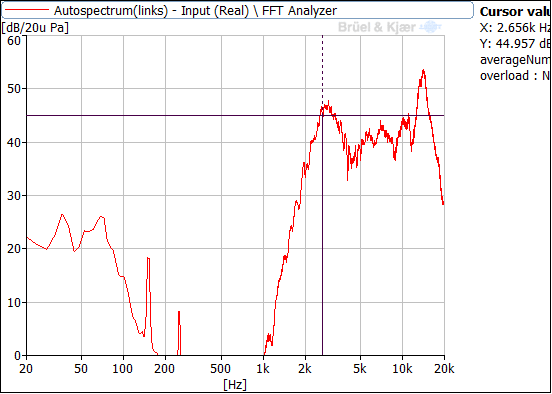
img/LSMessung/HT/U2275_1m_erhoeht.png
