crazyskater9/Diplomarbeit/img/LSMessung/HT/VisatonDTW72.png

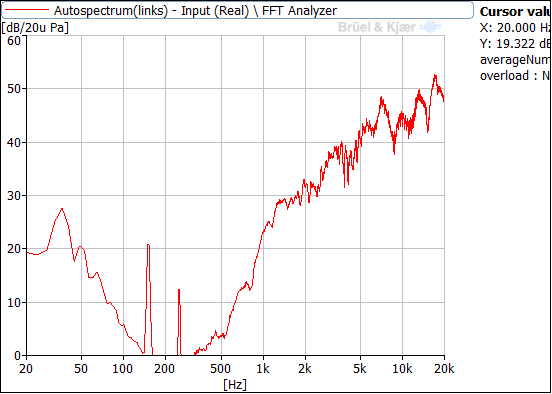
img/LSMessung/HT/VisatonDTW72.png
