crazyskater9/Diplomarbeit/img/LSMessung/mikro.jpg

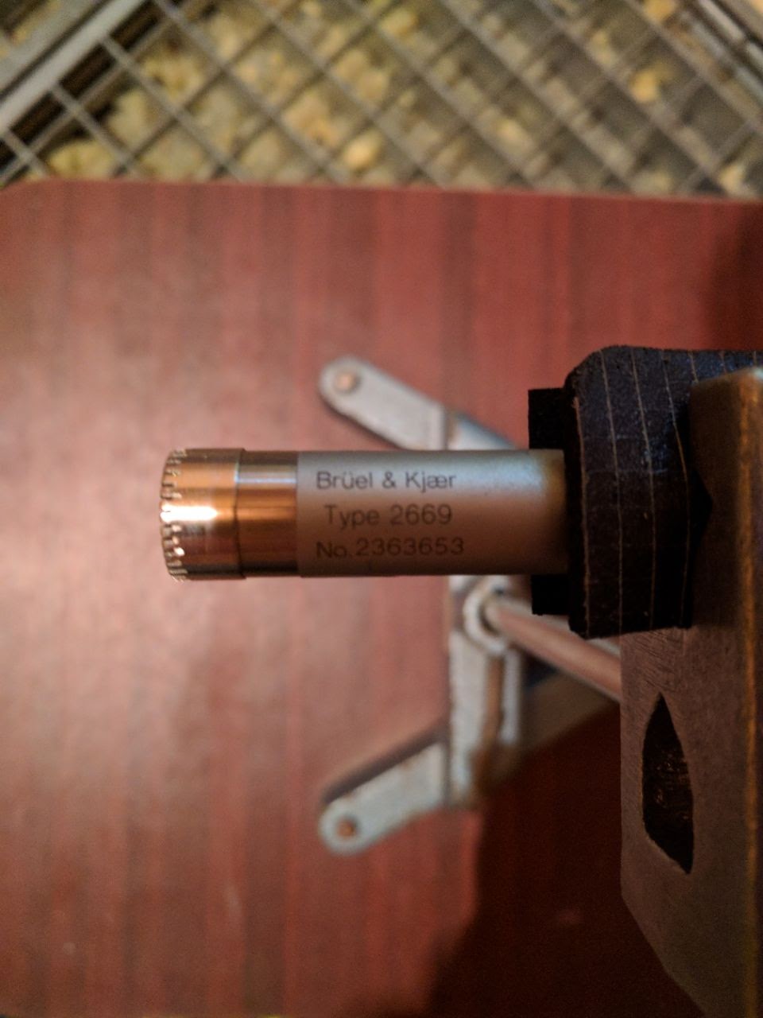
img/LSMessung/mikro.jpg
