crazyskater9/Diplomarbeit/img/LSMessung/mikro.png

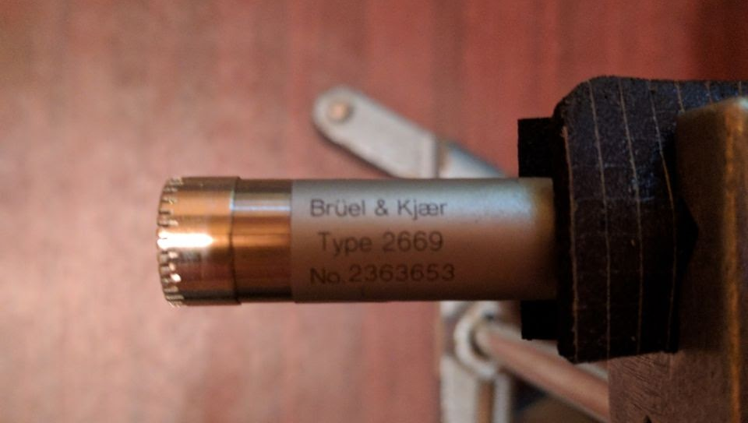
img/LSMessung/mikro.png
