crazyskater9/Diplomarbeit/img/LSMessung/mikroV2.png

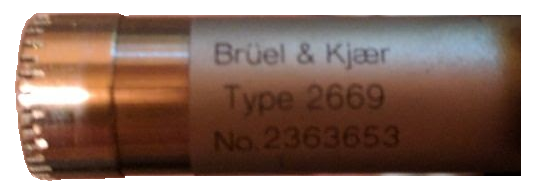
img/LSMessung/mikroV2.png
