crazyskater9/Diplomarbeit/img/LSMessung/modul_front.jpg

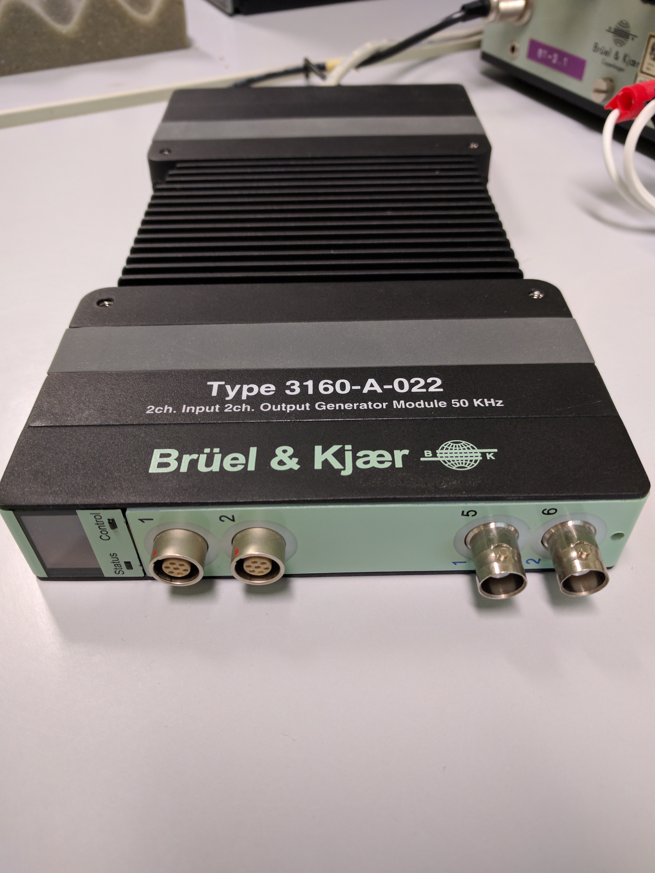
img/LSMessung/modul_front.jpg
