crazyskater9/Diplomarbeit/img/LSMessung/modul_front.png

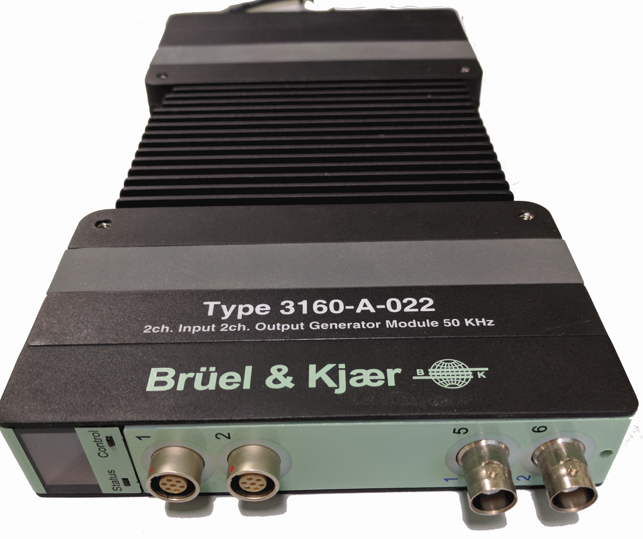
img/LSMessung/modul_front.png
