crazyskater9/Diplomarbeit/img/LSMessung/modul_oben.jpg

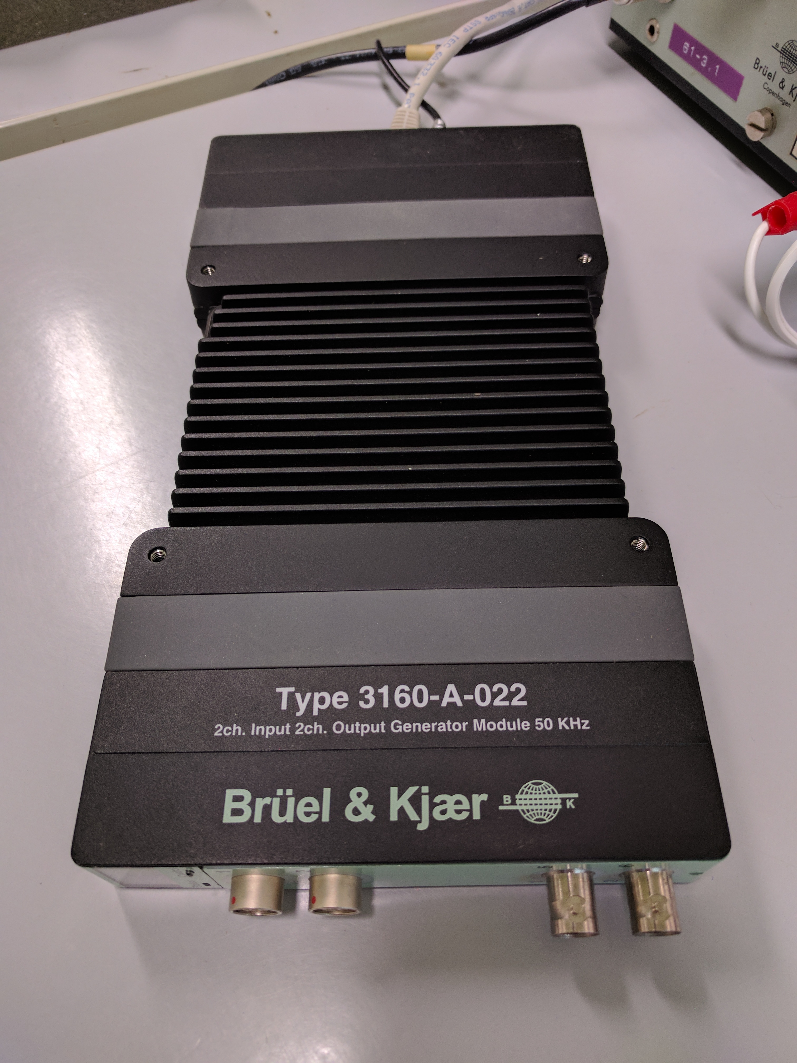
img/LSMessung/modul_oben.jpg
