crazyskater9/Diplomarbeit/img/LSMessung/TT1_9,17l_bestes.png

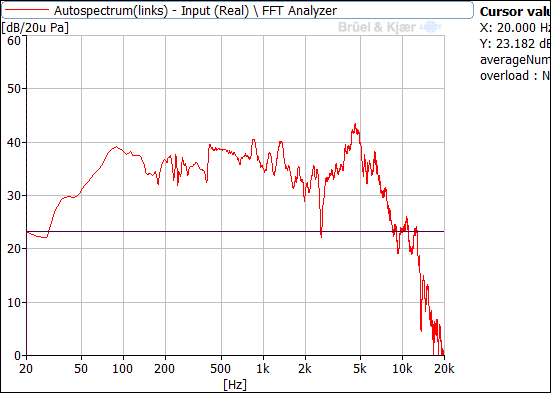
img/LSMessung/TT1_9,17l_bestes.png
