crazyskater9/Diplomarbeit/img/LSMessung/TT/370335_BB_00_FB.EPS_1000.jpg

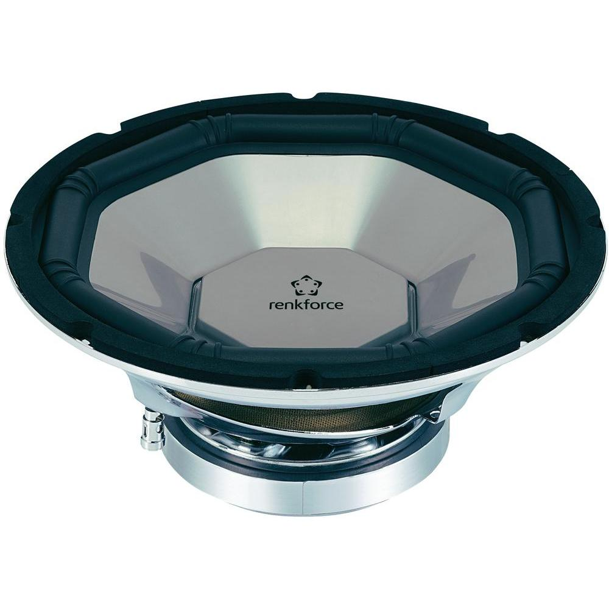
img/LSMessung/TT/370335_BB_00_FB.EPS_1000.jpg
