crazyskater9/Diplomarbeit/img/LSMessung/TT/Renkforce-Datasheet1.PNG

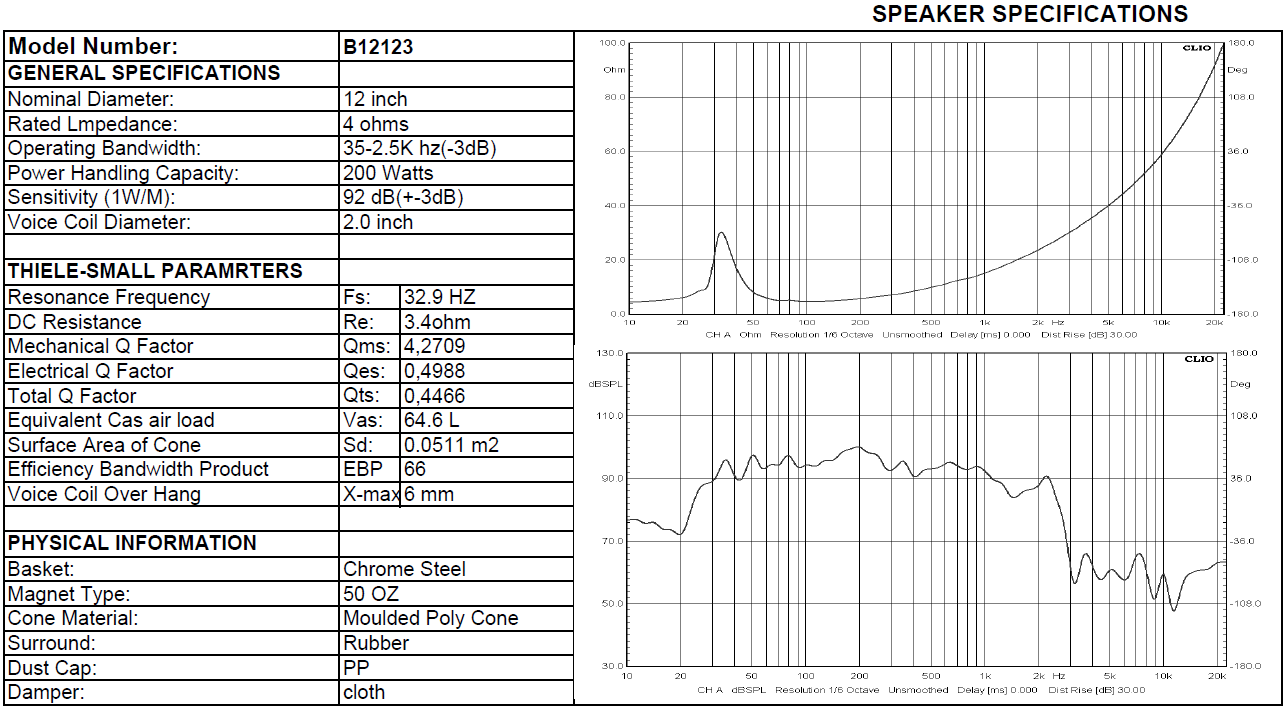
img/LSMessung/TT/Renkforce-Datasheet1.PNG
