crazyskater9/Diplomarbeit/img/LSMessung/TT/Renkforce-Datasheet2.PNG

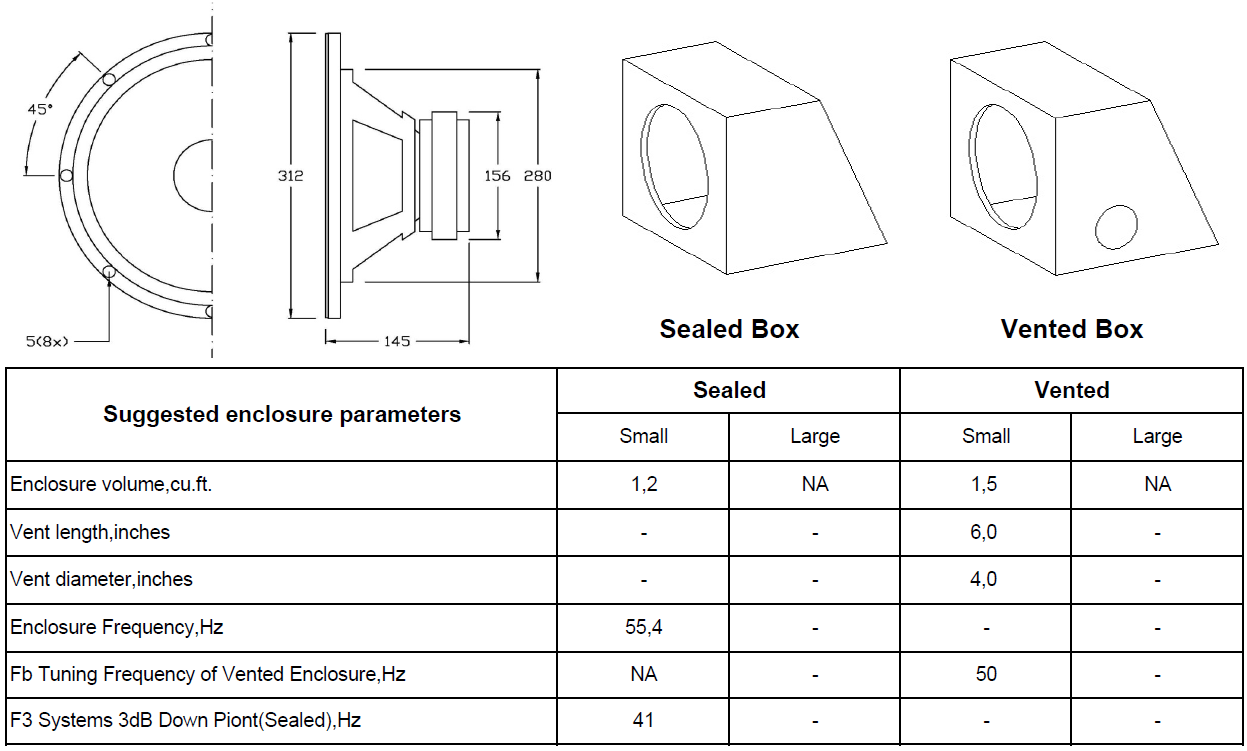
img/LSMessung/TT/Renkforce-Datasheet2.PNG
