crazyskater9/Diplomarbeit/img/LSMessung/TT/RenkforceMitWolleMitSilikonV2.png

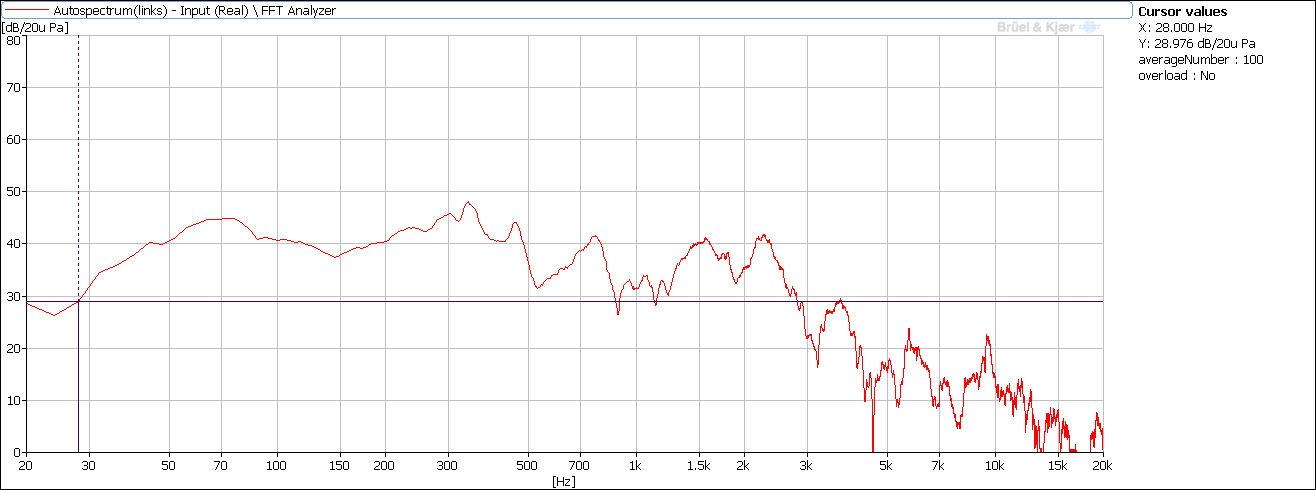
img/LSMessung/TT/RenkforceMitWolleMitSilikonV2.png
