crazyskater9/Diplomarbeit/img/LSMessung/TT/RenkforceOhneWolleMitSilikon.png

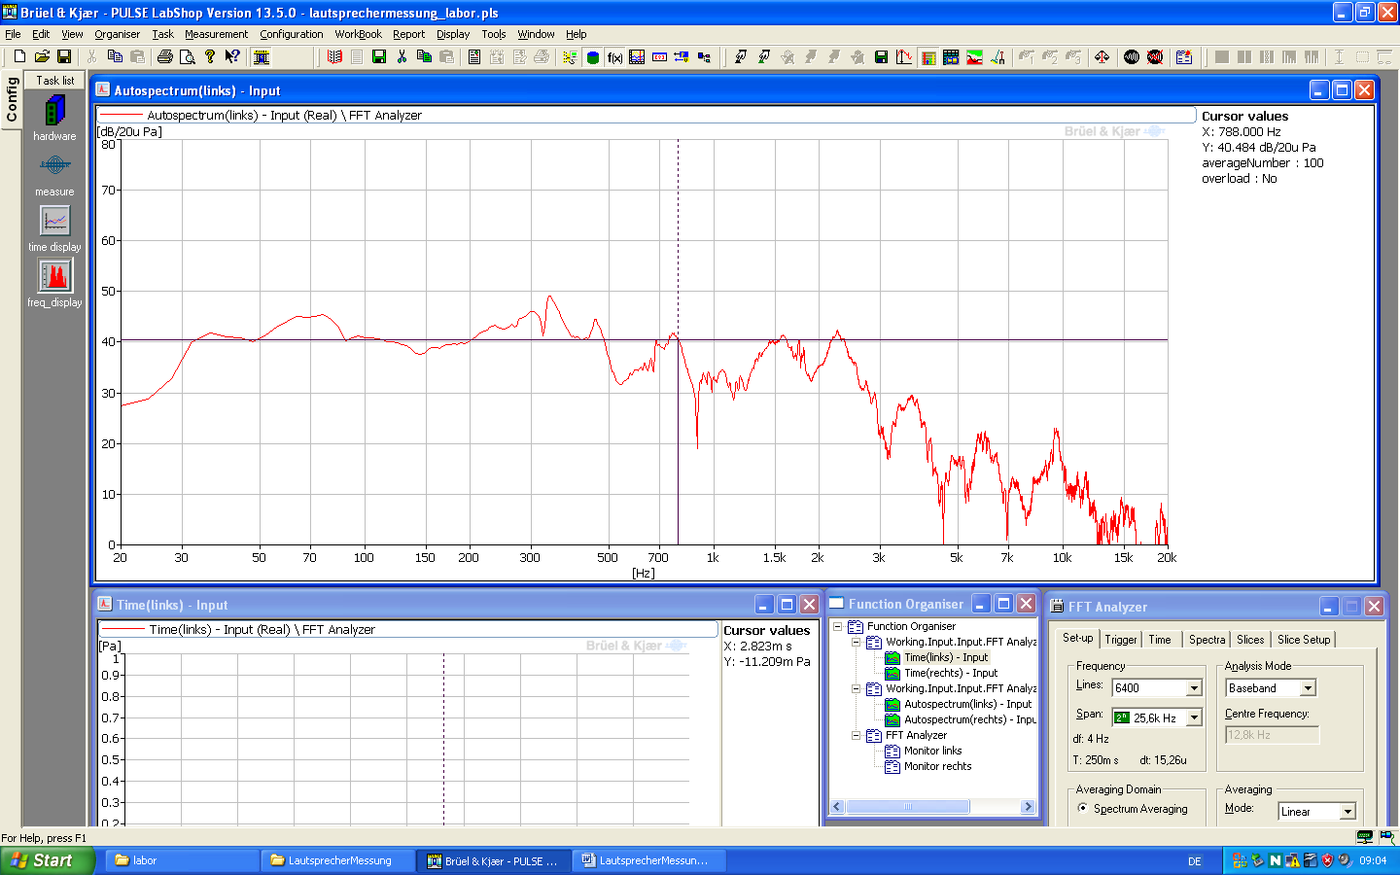
img/LSMessung/TT/RenkforceOhneWolleMitSilikon.png
