crazyskater9/Diplomarbeit/img/LSMessung/TT/RenkforceOhneWolleMitSilikonV2.png

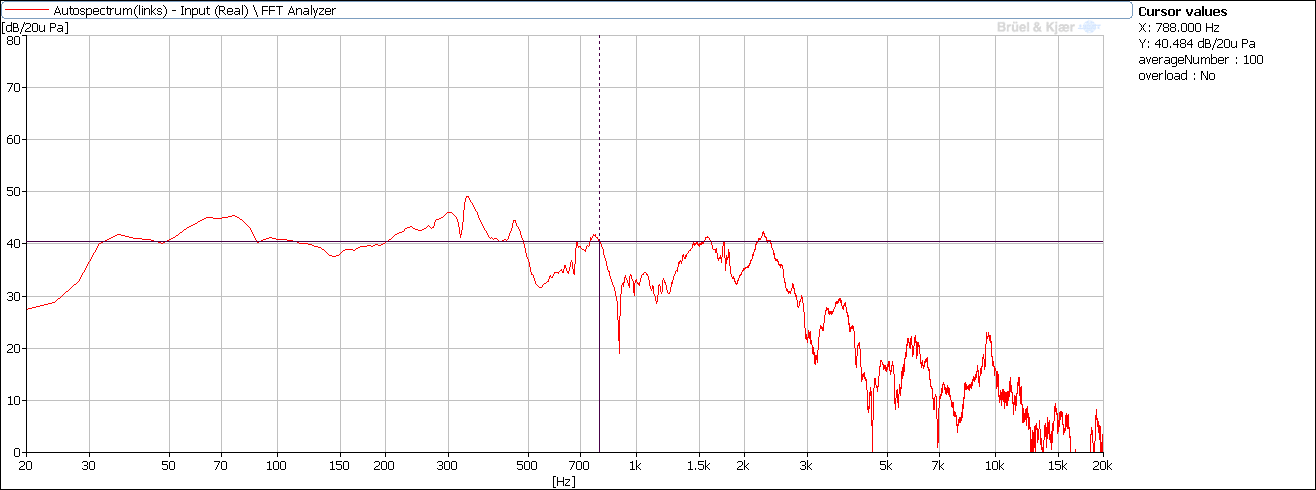
img/LSMessung/TT/RenkforceOhneWolleMitSilikonV2.png
