crazyskater9/Diplomarbeit/img/LSMessung/TT/TT1mitSilikon.png

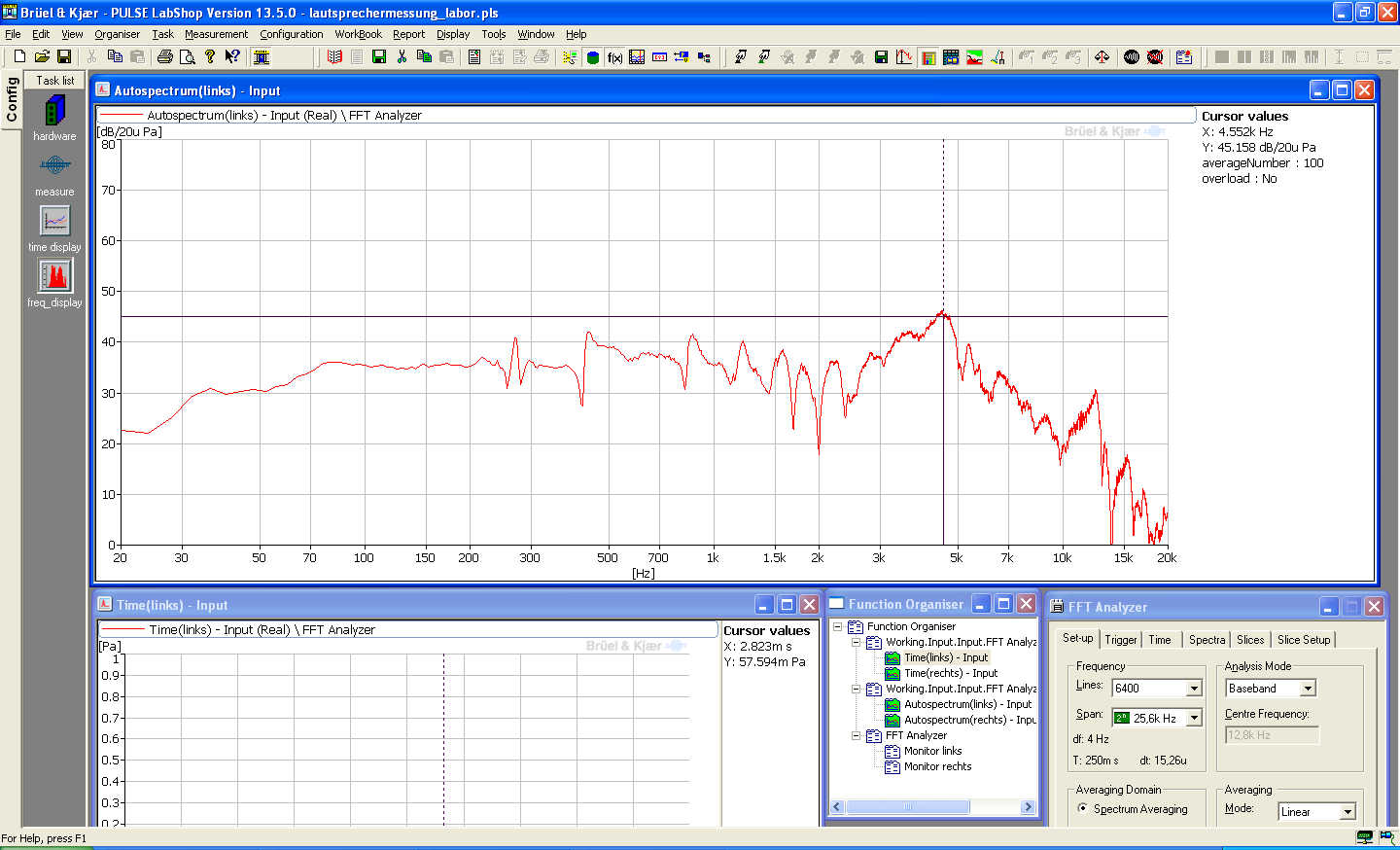
img/LSMessung/TT/TT1mitSilikon.png
