crazyskater9/Diplomarbeit/img/LSMessung/TT/TT1mitSilikonUndWolleV2.png

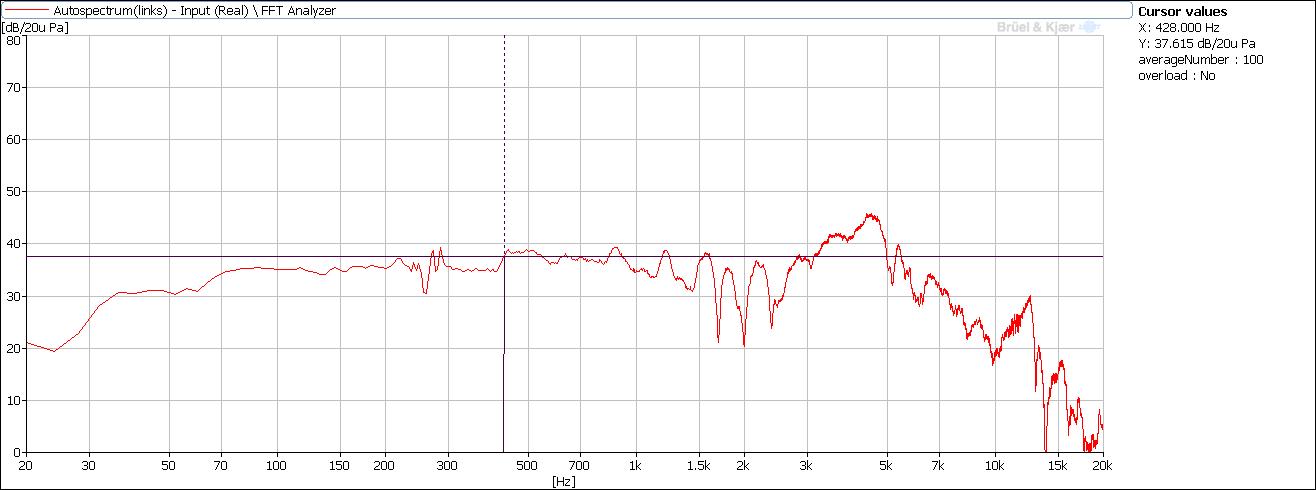
img/LSMessung/TT/TT1mitSilikonUndWolleV2.png
