crazyskater9/Diplomarbeit/img/LSMessung/TT/TT1mitSilikonV2.png

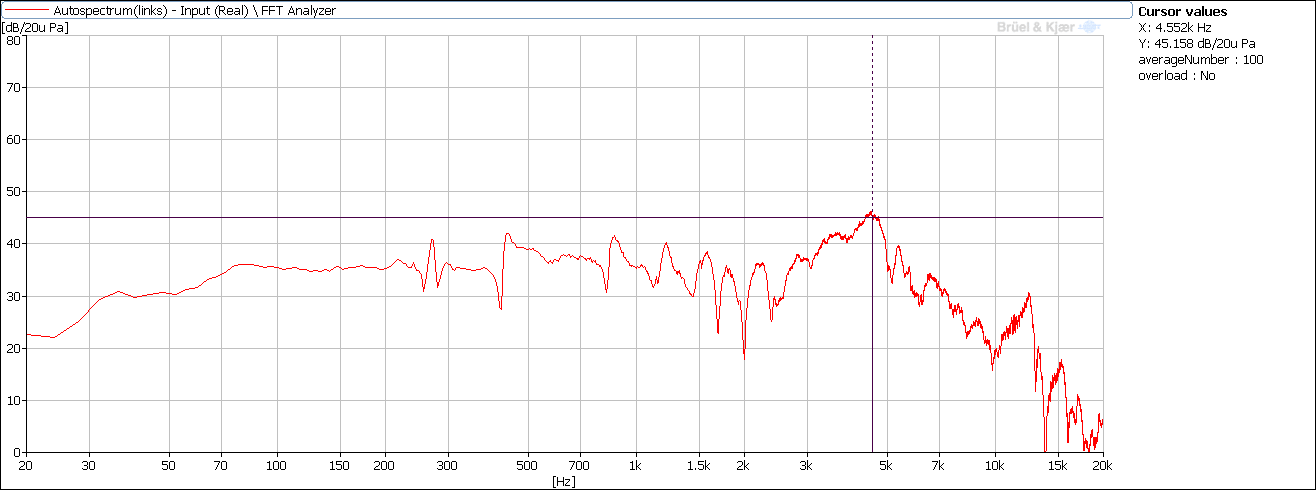
img/LSMessung/TT/TT1mitSilikonV2.png
