crazyskater9/Diplomarbeit/img/LSMessung/TT/TT2mitSilikon_mitWolleV2.png

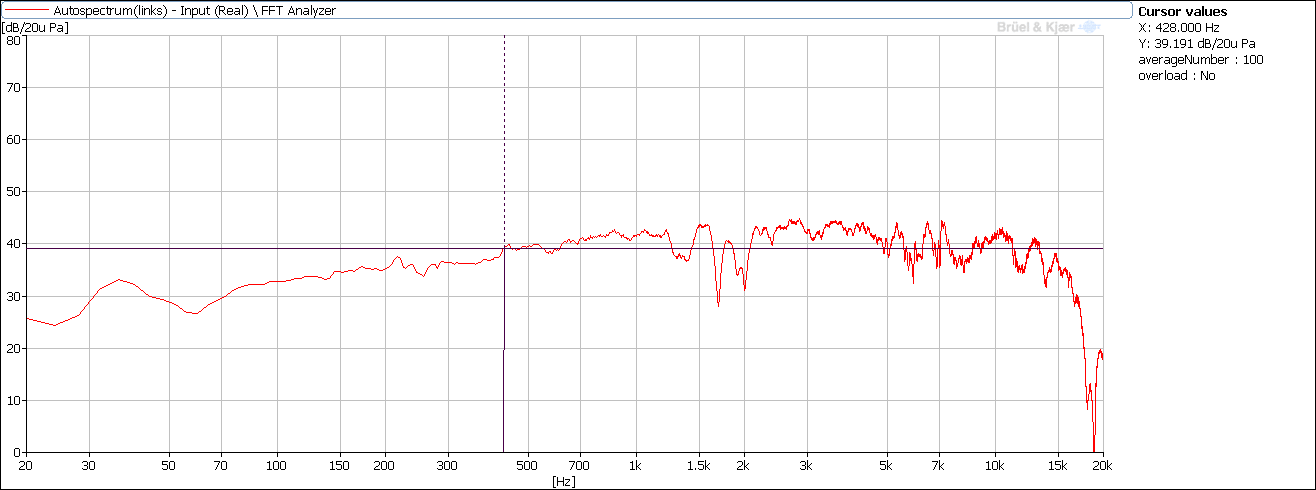
img/LSMessung/TT/TT2mitSilikon_mitWolleV2.png
