crazyskater9/Diplomarbeit/img/LSMessung/TT/TT2mitSilikon_ohneWolle.png

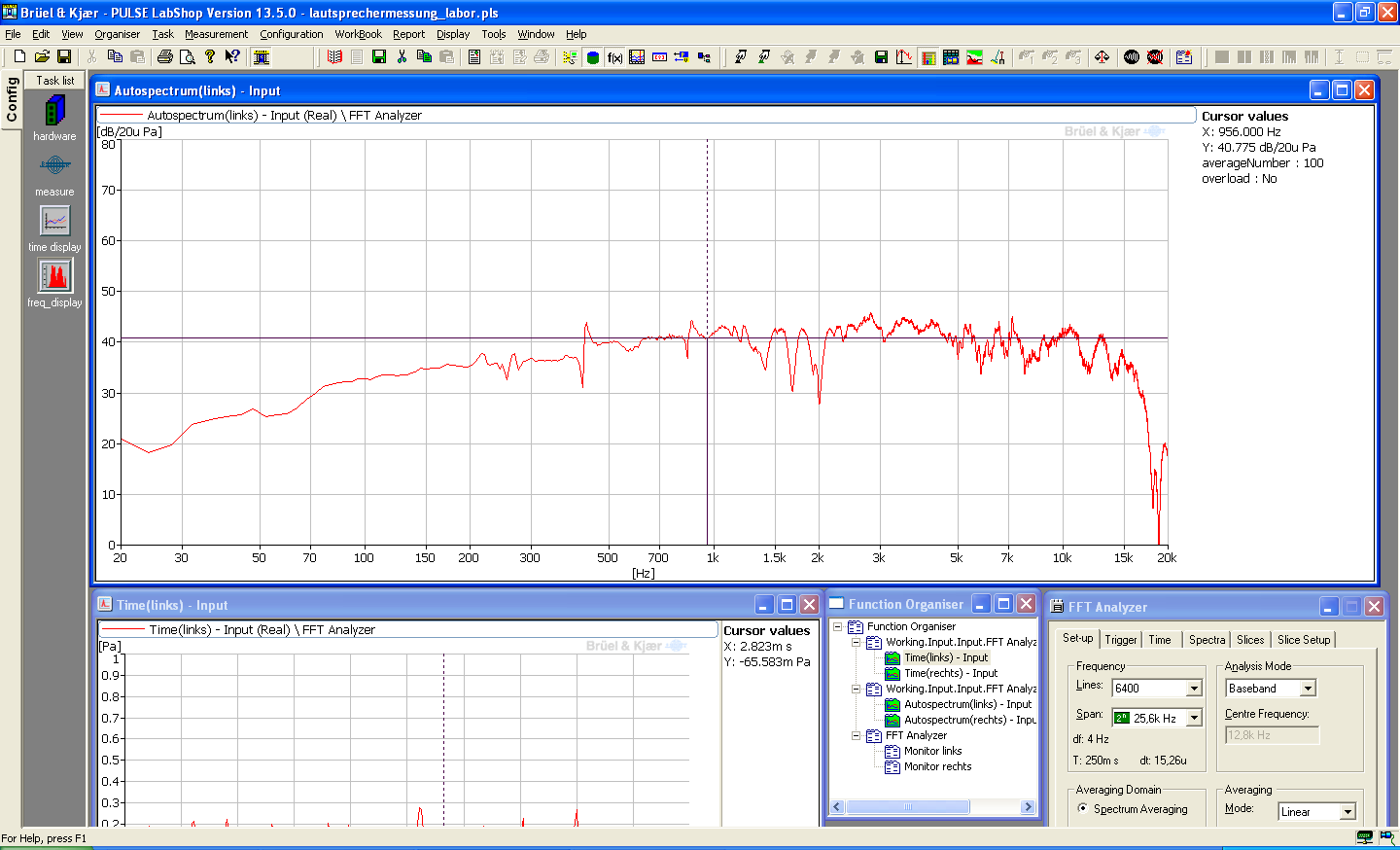
img/LSMessung/TT/TT2mitSilikon_ohneWolle.png
