crazyskater9/Diplomarbeit/img/LSMessung/TT/TT2mitSilikon_ohneWolleV2.png

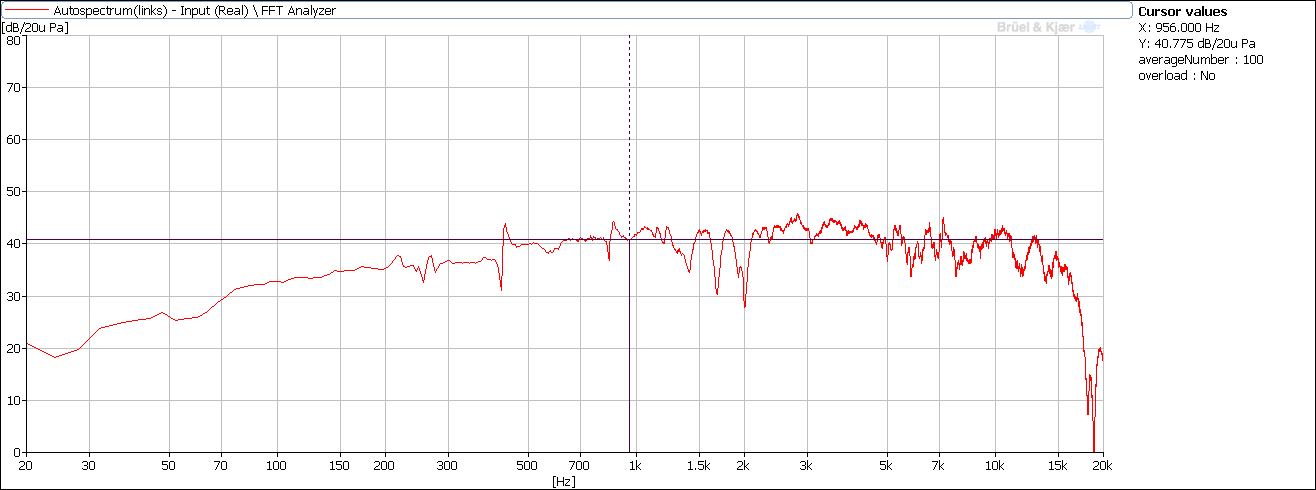
img/LSMessung/TT/TT2mitSilikon_ohneWolleV2.png
