crazyskater9/Diplomarbeit/img/LSMessung/TT/VisatonMitSilikonMitWolleV2.png

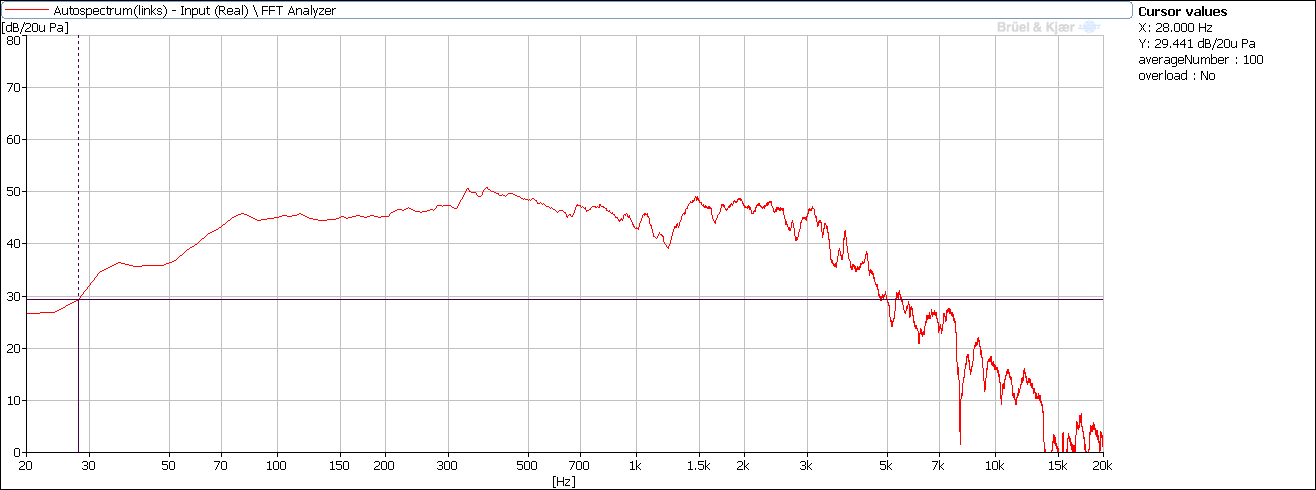
img/LSMessung/TT/VisatonMitSilikonMitWolleV2.png
