crazyskater9/Diplomarbeit/img/LSMessung/verstaerker1.png

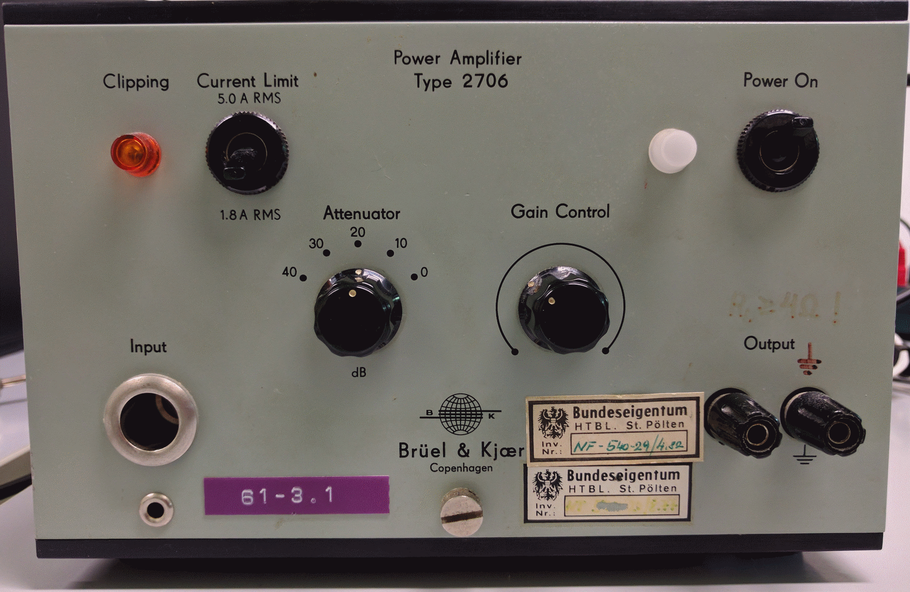
img/LSMessung/verstaerker1.png
