crazyskater9/Diplomarbeit/img/LSMessung/verstaerker1V2.png

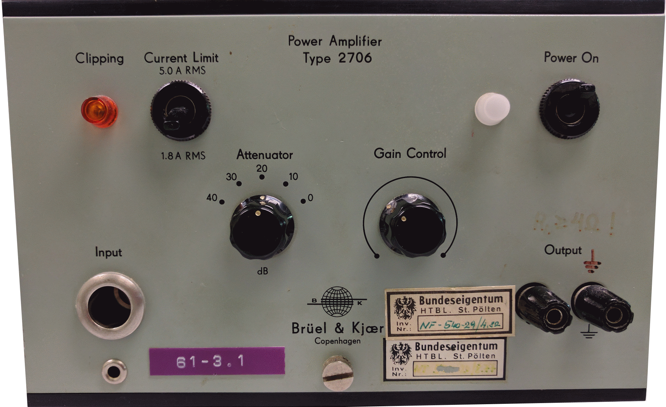
img/LSMessung/verstaerker1V2.png
