crazyskater9/Diplomarbeit/img/LSMessung/verstärker1.jpg

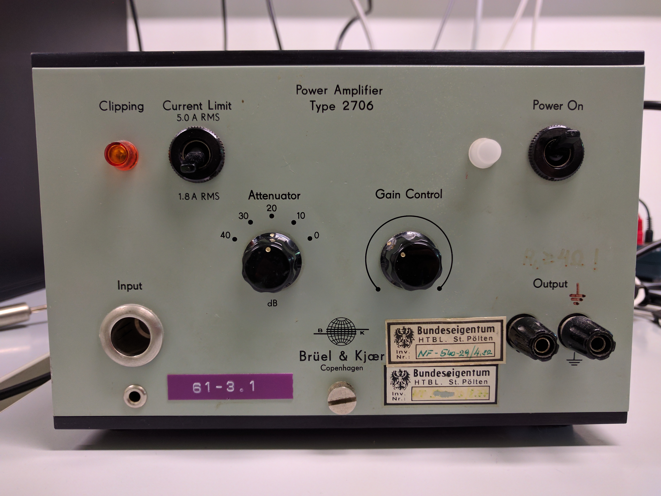
img/LSMessung/verstärker1.jpg
