crazyskater9/Diplomarbeit/img/LSMessung/White_noise.png

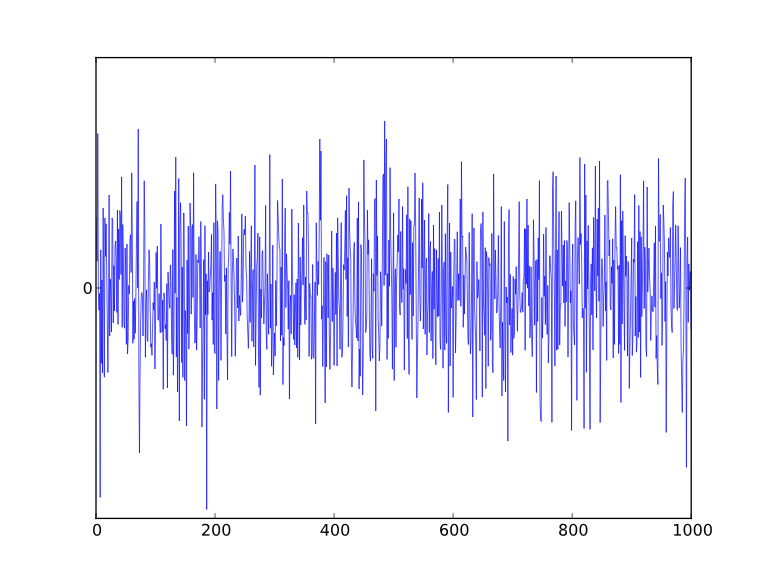
img/LSMessung/White_noise.png
