crazyskater9/Diplomarbeit/img/LSMessung/White_noise_spectrum.png

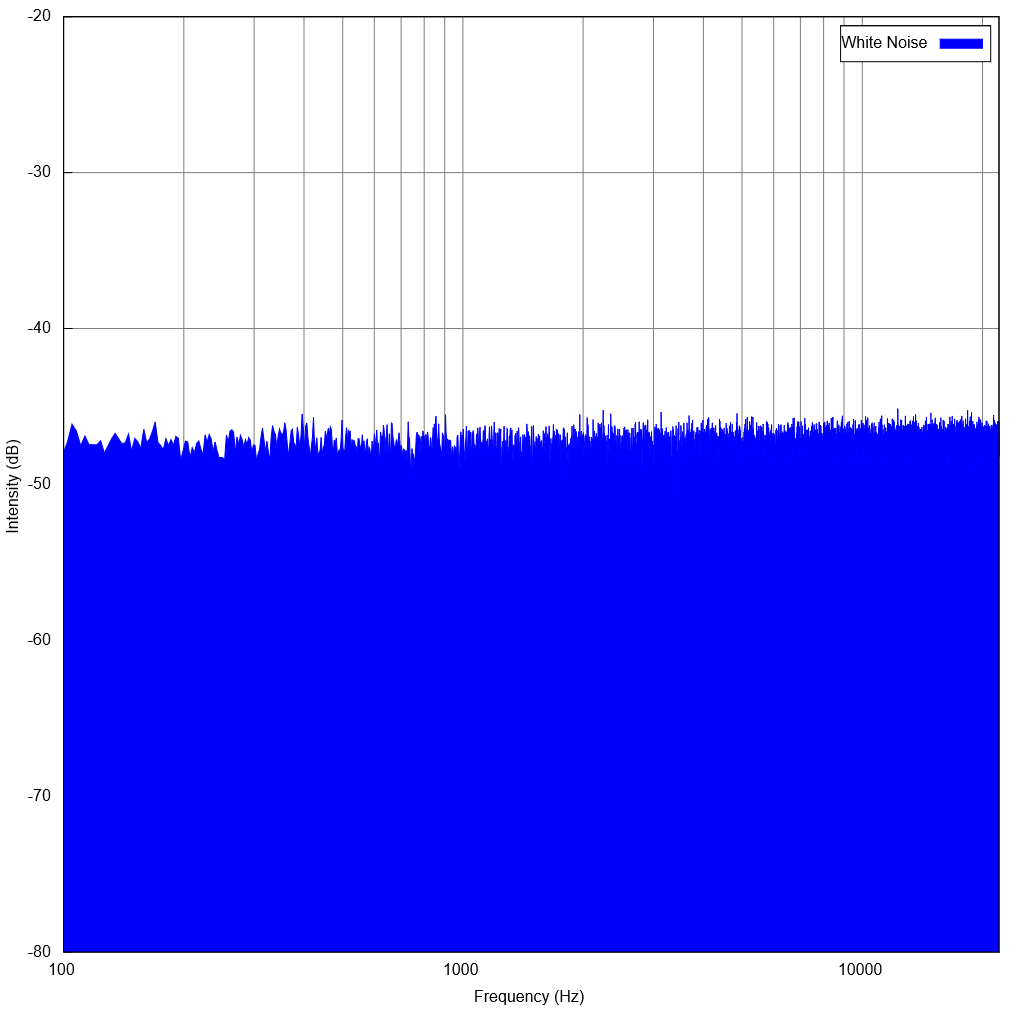
img/LSMessung/White_noise_spectrum.png
