crazyskater9/Diplomarbeit/img/Optimierung/Sub/RenkforceStyro_47l.png

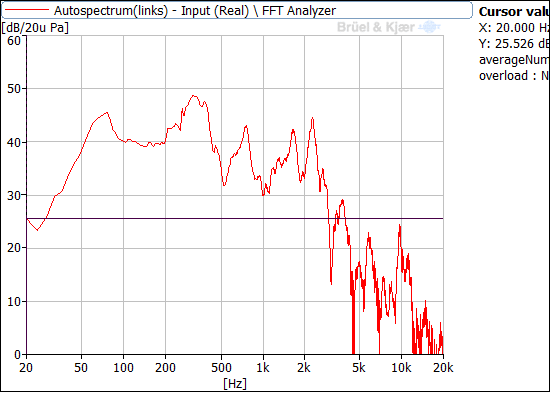
img/Optimierung/Sub/RenkforceStyro_47l.png
