crazyskater9/Diplomarbeit/img/Optimierung/Sub/RenkforceStyro_113l_Wolle.png

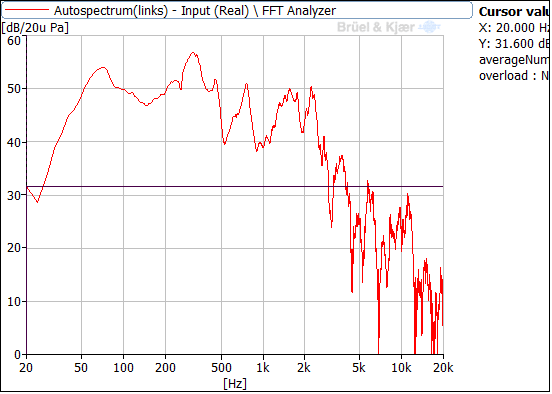
img/Optimierung/Sub/RenkforceStyro_113l_Wolle.png
