crazyskater9/Diplomarbeit/img/Optimierung/Sub/RenkforceStyro_113l_Wolle_Angepasst.png

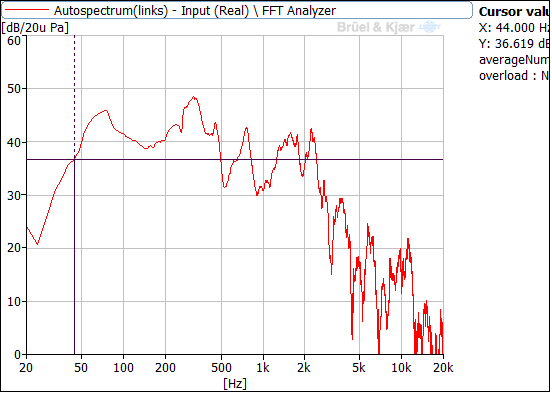
img/Optimierung/Sub/RenkforceStyro_113l_Wolle_Angepasst.png
