crazyskater9/Diplomarbeit/img/Optimierung/TT/TT1_ohneAllem_Schraubzwinge.png

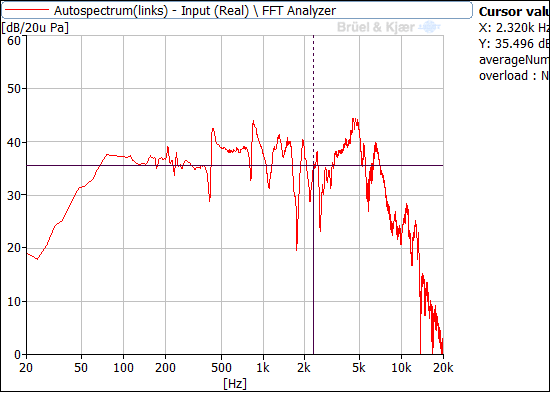
img/Optimierung/TT/TT1_ohneAllem_Schraubzwinge.png
