crazyskater9/Diplomarbeit/img/Optimierung/TT/TT1_ohneAllem_welligkeit.png

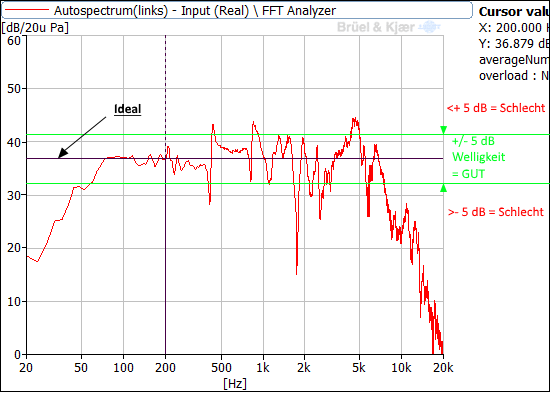
img/Optimierung/TT/TT1_ohneAllem_welligkeit.png
