crazyskater9/Diplomarbeit/img/Optimierung/Vergleich/VergleichYtognStyro_500Hz.png

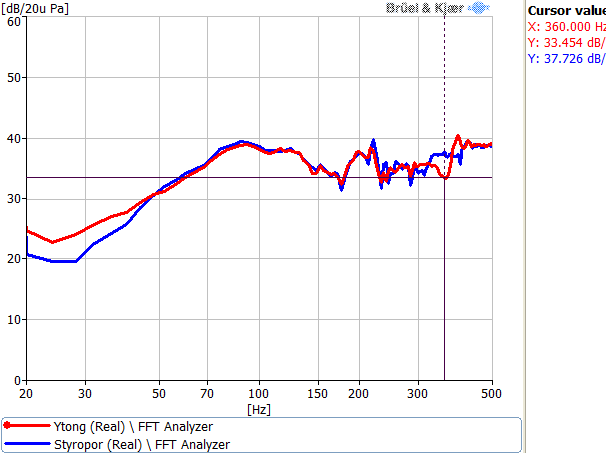
img/Optimierung/Vergleich/VergleichYtognStyro_500Hz.png
