crazyskater9/Diplomarbeit/img/Optimierung/Vergleich/VergleichYtognStyro_Abweichung_500Hz.png

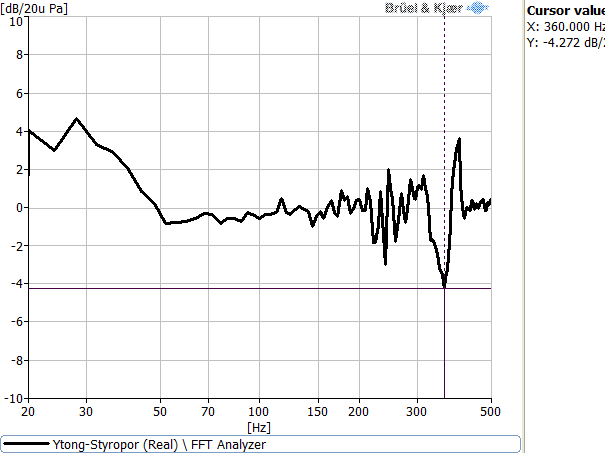
img/Optimierung/Vergleich/VergleichYtognStyro_Abweichung_500Hz.png
