crazyskater9/Diplomarbeit/img/Optimierung/Vergleich/VergleichYtognStyro_Abweichung_full.png

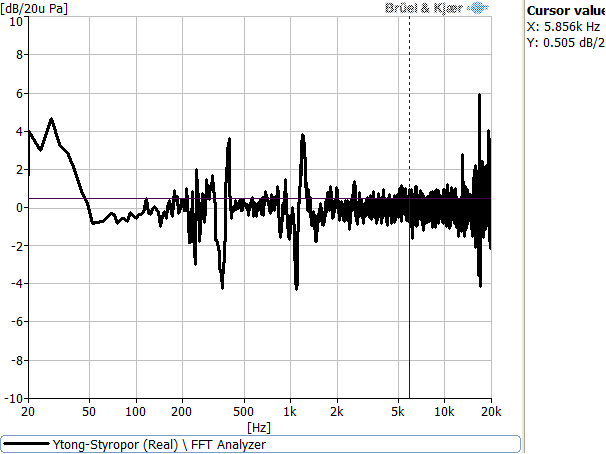
img/Optimierung/Vergleich/VergleichYtognStyro_Abweichung_full.png
