crazyskater9/Diplomarbeit/img/Optimierung/Vergleich/VergleichYtognStyro_full.png

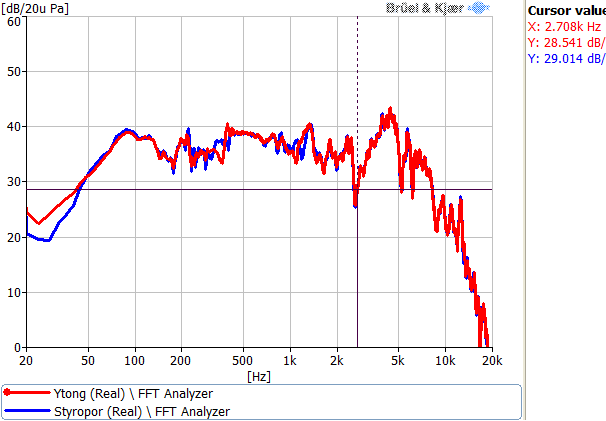
img/Optimierung/Vergleich/VergleichYtognStyro_full.png
