crazyskater9/Diplomarbeit/img/Optimierung/Vergleich/VergleichYtognStyroOhne_500Hz.png

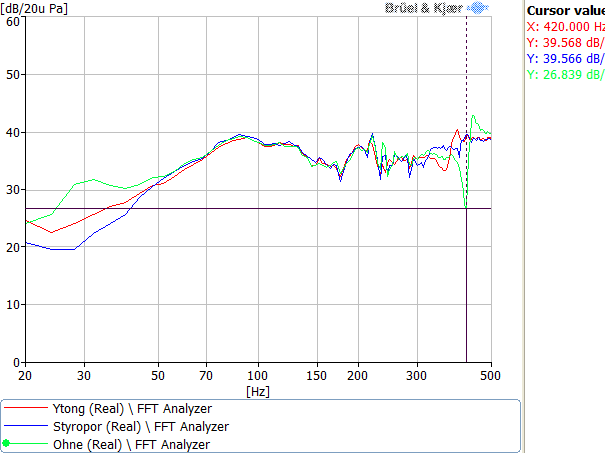
img/Optimierung/Vergleich/VergleichYtognStyroOhne_500Hz.png
