crazyskater9/Diplomarbeit/img/Optimierung/Vergleich/VergleichYtognStyroOhne_full.png

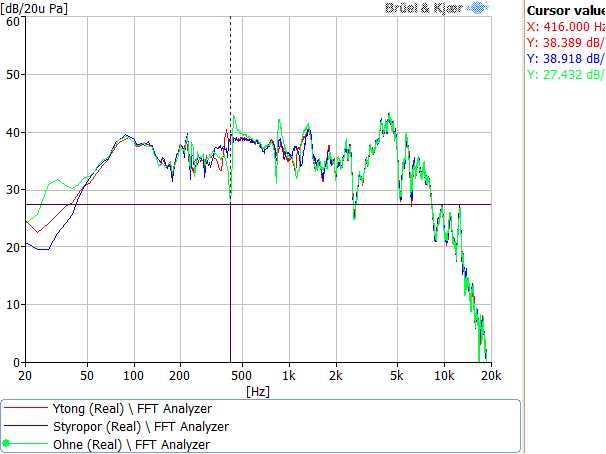
img/Optimierung/Vergleich/VergleichYtognStyroOhne_full.png
