crazyskater9/Diplomarbeit/img/Print3/3mTTWeicheruAddiererDiplSchematicTeil1.png

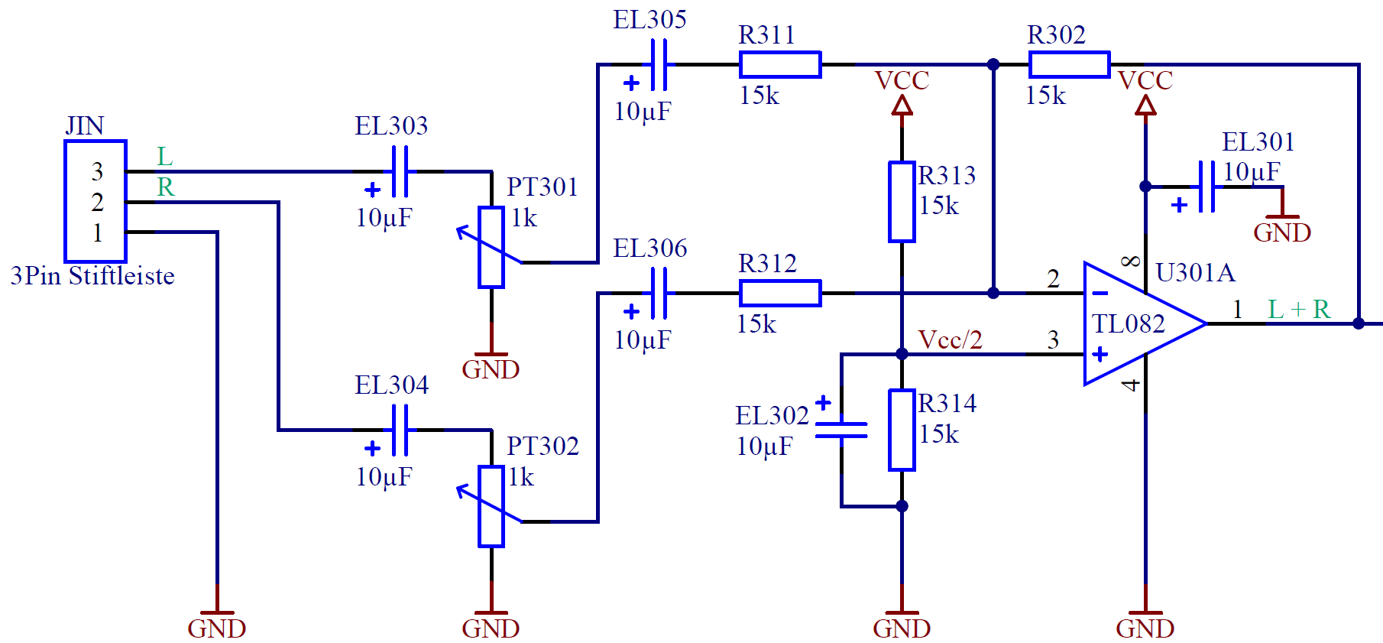
img/Print3/3mTTWeicheruAddiererDiplSchematicTeil1.png
