crazyskater9/Diplomarbeit/img/Print3/3mTTWeicheruAddiererDiplSchematicTeil2.png

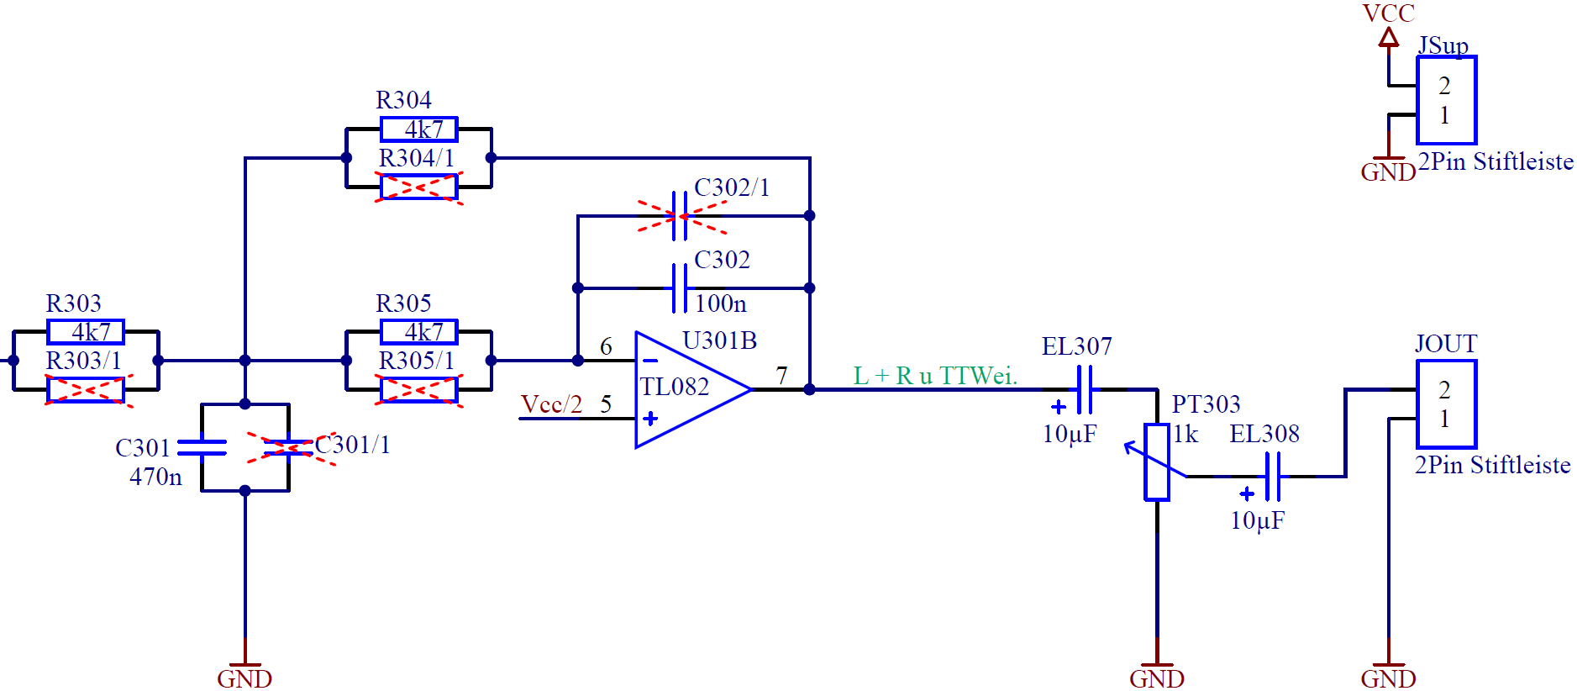
img/Print3/3mTTWeicheruAddiererDiplSchematicTeil2.png
