crazyskater9/Diplomarbeit/img/smartphone18.png

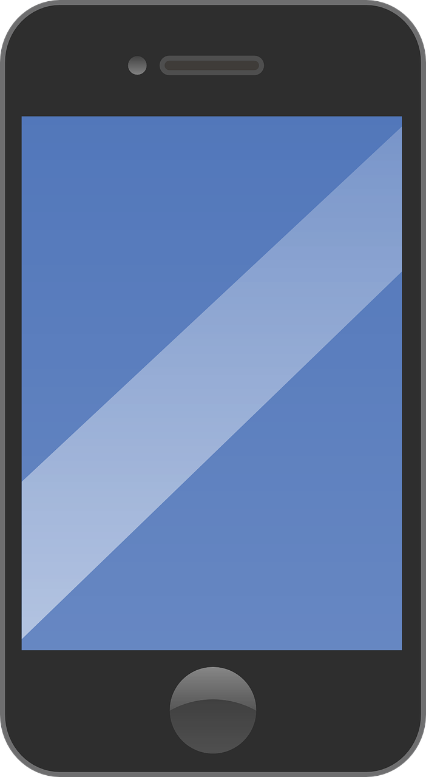
img/smartphone18.png
