crazyskater9/Diplomarbeit/img/SubwooferAmpLayout.png

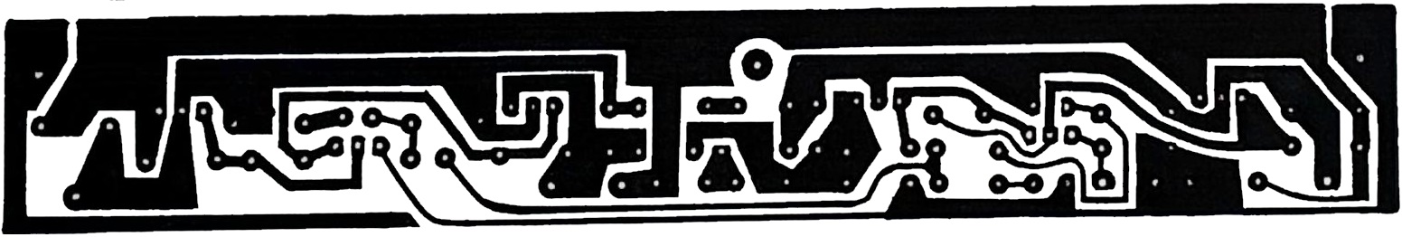
img/SubwooferAmpLayout.png
