crazyskater9/Diplomarbeit/img/VerwendeteTools/FilterPro.jpg

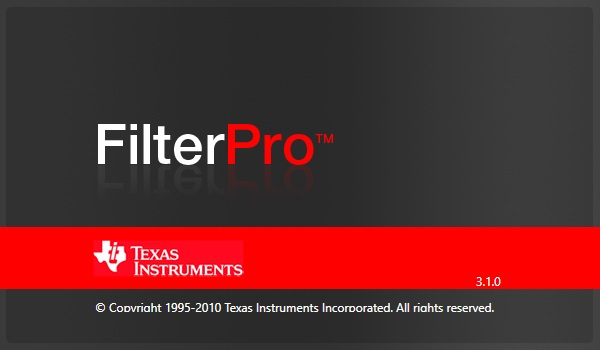
img/VerwendeteTools/FilterPro.jpg
