crazyskater9/Diplomarbeit/form/Arbeitsnachweis.xlsx

Sheet: Tabelle1
Markus Bointner | Summe: | 185.00 | Andreas Macsek | Summe: | 249.00 | Kosten |  | MB | AM
 |  |  |  |  |  | BT-Modul 2x Ebay | 6 € | 6 €
Datum | Arbeit | Zeit / h | Datum | Arbeit | Zeit / h | Renkforce Subwoofer | 45.94 € |  | 45.94 €
2016-08-15 | Recherche | 5 | 2016-08-15 | Recherche | 5 | Taster für Frontpanel, DTW 72-8, 12V Blei-Akku ladegerät | 57.48 € |  | 57.48 €
2016-09-06 | Recherche+Blockschaltbild | 4 | 2016-09-06 | Recherche+Blockschaltbild | 4 | XLR-Stecker+Buchsen, Blei-Vlies-Akku | 34.73 € |  | 34.73 €
2016-09-07 | Recherche | 4 | 2016-09-07 | Recherche | 4 | Bluetooth Modul Amazon | 9.24 € |  | 9.24 €
2016-09-08 | Recherche+BlockschaltbildV2 | 4 | 2016-09-08 | Recherche+BlockschaltbildV2 | 4 | Bluetooth Module Ebay | 10.14 € |  | 10.14 €
2016-09-09 | Recherche | 4 | 2016-09-09 | Recherche | 4 | Dipl-Bücher (5 + 2Goldfolien) | €33.00
2016-09-21 | Visaton WPC30 getestet | 1 | 2016-09-28 | Gehäuseberechnungen (Visaton+Renkforce) & TSP-Recherche | 2
2016-09-28 | Gehäuseberechnungen (Visaton+Renkforce) & TSP-Recherche | 2 |  | analoge Verstärker Schaltung - Recherche & Bauteilsuche + Suche entsprechender Altium Libarys | 2
 | Schaltung zeichnen | 2 | 2016-10-05 | Verstärker Recherche und Schaltung zeichnen | 5
2016-10-04 | Verstärkerschaltung weiterzeichnen | 2 |  | Recherche (für geeignete Transistoren) | 1
2016-10-05 | Verstärker Recherche und Schaltung zeichnen | 5 | 2016-10-06 | Zeitplan für die Diplomarbeit | 1
2016-10-12 | Messchassis vorbereitet | 4.00 | 2016-10-12 | Vorbereitung der Messungschassis | 4
2016-10-13 | PCB-Layout TT-Verstärker | 2 |  | TTVerstärker PCB vorbereitet | 1.5
2016-10-19 | Bluetoothmodul gezeichnet, Adapterprint entwickelt und in Auftrag gegeben | 6 | 2016-10-15 | HTVerstärker PCB-Layouten | 3
2016-10-26 | Bluetoothmoduladapter fertiggestellt und Funktion getestet | 4 |  | HTVerstärker&TTVerstärker Layout anpassen | 1
2016-10-27 | BT-Modul: Pins getestet, Zusatzfunktionen getestet | 3 | 2016-10-17 | TTVErstärker PCB neu überlegt | 5
2016-11-02 | Weichen optimiert | 1 | 2016-10-19 | HT/TTVerstärker PCB verbessert | 8
16/11/2016 | BT-Modul: Konfiguration und Pin-Tests (LED) | 2 | 2016-10-30 | mTT-Weiche+Addierer PCB+Schem | 3.5
 | Frequenzweichen finalisiert & in Auftrag gegegben | 1 | 2016-11-02 | mTT-Weiche+Addierer PCB bearbeitet | 0.75
 | BT-Modul: Schaltung für Hauptboard & Frontplatine entwickelt Hauptboard & Frontplatine entflechtet und fast finalisiert | 6 |  | HTuTTWeiche PCB+Schem | 2.25
23/11/16 | Tieftöner, Hochtöner und Subwoofer gemessen | 9 | 2016-11-16 | Bauteil Beschaffung für VerstärkerPrints | 1
30/11/16 | Lautsprechermessung und Printentflechtung | 9 |  | Bestücken der VerstärkerPrints | 2
2016-12-07 | HT gemessen | 1 |  | Frequenzweichen finalisiert & in Auftrag gegegben | 1
 | Verstärker testen | 4 |  | Korregieren der Verstärkerprints | 1
 | Hauptboard-Print entflechten | 4 | 2016-11-23 | Tieftöner, Hochtöner und Subwoofer gemessen | 9
14/12/2016 | Lautsprecher messen | 4 | 2016-11-30 | Lautsprechermessung | 4
 | Hauptboard bearbeiten und optimieren | 5 |  | Kühlkörper für Satelitenprints bearbeitet | 5
21/12/2016 | Lautsprecher messen (subwoofer mit styropor und ytong) | 4 | 2016-12-07 | Kühlkörper für Satelitenprints bearbeitet | 3
 | Ergebnisse interpretieren | 1 |  | Satelitenprints testen, messen, bearbeiten | 2
 | Schaltungen optimieren (Weichen) | 4 | 2016-12-14 | Lautsprechermessungen | 5
2017-01-07 | Lautschprecher Messungen mit stark verkleinertem Volumen und verschiedenen Filter davorgeschaltet | 6.5 |  | Auswertung der Messungen | 1
 | Testen des Messequipments | 1 |  | Weichenprints anpassen | 4
2017-01-11 | Weitere Messungen: 2weg System(TT1+AE1004) mit stereo verstärker aufgebaut und mit filter angepasst | 5 | 2016-12-21 | Lautsprecher messen (subwoofer mit styropor und ytong) | 4
2017-01-18 | Vergleichsmessung Ytong - Styropor | 2 |  | Schaltung optimieren (HTuTT-Weiche) | 5
 | Bauteile für Hauptboard suchen | 1 | 2017-01-04 | Files adaptieren und Fabri.Outs gener. | 1.5
 | Hauptboard bestücken + Fehlerbehebung von BT-Adapter | 2 |  | 4_TTuHTWeichen verbessern und für Printerei vorbereiten | 1
 | Hauptboard testen | 1 | 2017-01-06 | 3_mTTWeiche.. Vorbereiten für Printerei und 2_Hauptboard bearbeiten | 1
2017-01-25 | Testen des BT-Hauptboards | 4 | 2017-01-07 | Einstellbares Filter testen | 1
2017-02-01 | Messen des Hochtöners DTW72 + in Verbindung mit TT1 | 2 |  | Kontrollmessungen --> Filter einbauen | 1
 | Entwurf für Elektronikschacht in der Subwooferbox | 2 |  | Lautsprecher Messungen | 5.5
2017-02-08 | Dokumentation - Einleitung, Gesamtprojekt, Grundlagen | 2 | 2017-01-08 | Prints laut Infos verbessern(2/3/4) | 2
2017-02-10 | Dokumentation - Lautsprechermessung | 3 | 2017-01-11 | Testen des Messequipments | 1
2017-02-11 | Dokumentation- Messaufbau fertiggestellt | 1.5 |  | Weitere Messungen: 2weg System(TT1+AE1004) mit stereo verstärker aufgebaut und mit filter angepasst | 5
15/02/2017 | Subwooferverstärker zum laufen gebracht | 5 | 2017-01-18 | Brül&Kjer 2 Messungen in ein Dia. | 2
 | Frontpanel bestückt | 1 |  | Prints 2,3,4 zur Bestückung vorbereitet | 2
 | Frontpanel getestet | 2 |  | Research (HT, Ladegerät) | 1
 | Netzteilplanung | 1 |  | Sonstige(Printbohrungen) | 0.5
22/02/2017 | HT- und TT-Verstärker getestet und verbessert | 5 |  | Überlegungen zur Wooferbox | 1
 | Frontpanel mit neuem BT-Modul getestet und optimiert | 3 | 2017-02-01 | Messen des Hochtöners DTW72 + in Verbindung mit TT1 | 2
 | Über Netzteile informiert und getestet | 2 |  | Entwurf für Elektronikschacht in der Subwooferbox | 2
2017-01-03 | Rückwand-Design festgelegt | 2 | 2017-02-06 | Dokumentation(3_mTTWeiche…) Beginn | Schreiben und Einarbeiten in Latex | 3.5
 | BT-Modul mit Verstärker getestet | 2 | 2017-02-08 | Dokumentation(3_mTTWeiche…) Erweitern, (4_TTuHT…) Begonnen | 3.5
 | Dokumentation | 2 |  | Dokumentation(4_TTuHT…) Erweitern, (5_TTVerst…) Begonnen | 2
 | Weichen berechnet, bestückt und getestet | 3 | 2017-02-10 | Dokumentation| Grundlagen zu Grundlagen, Dateien anpassen und korregieren | 1.5
2017-03-08 | Fehlerbehebungen und Präventivmaßnahmen an BT-Modul, Hauptplatine und Frontpanel | 5 |  | Dokumentation| Grundlagen zu Grundlagen und anpassen, 3_mTT komplett und 4_TTuHT.. Begonen anzupassen | 3.5
 | Testen, Fehlererkennung und -behebung der Frequenzweichen | 4 | 11.02.217 | Dokumentation | Grundlagen OPV-Verstärker ergänzen, 5_TTVerst… ergänzen | 1.5
2017-03-11 | Dokumentation - neue Struktur, Grundlagen | 4 | 2017-02-15 | Subwooferverstärker zum laufen gebracht | 5
2017-03-12 | Dokumentation - Anpassungen | 2 |  | TT und Ht Verstärker testen | 1
2017-03-13 | Dokumentation - Hochtöner | 2 |  | Frontpanel getestet | 2
 |  |  |  | Netzteilplanung | 1
 |  |  | 2017-02-22 | HT- und TT-Verstärker getestet und verbessert | 5
 |  |  |  | Frontpanel mit neuem BT-Modul getestet und optimiert | 3
 |  |  |  | Über Netzteile informiert und getestet | 1
 |  |  |  | Kühlkörper von Monobassverstärker für Sat.prints bearbeitet | 1
 |  |  | 2017-03-01 | Rückwand-Design festgelegt | 2
 |  |  |  | Rückwand und Grundplatte bearbeiten | 4
 |  |  |  | Dokumentation | 2
 |  |  | 2017-03-03 | BluetoothModul - Fehlersuche | 4
 |  |  |  | Dokumentation: TT_Messungen | 1
 |  |  | 2017-03-04 | Dokumentation: TT_Messungen | 1
 |  |  | 2017-03-08 | BluetoothModul - Fehlersuche | 2
 |  |  |  | BluetoothModul Anapssen und Testen | 3
 |  |  |  | Weichen bestücken | 1
 |  |  |  | Weichen testen | 2
 |  |  |  | Weichen adaptieren | 1
 |  |  | 2017-03-11 | Dokumentation: Inhaltsverzeichnis + Anpassen der Kapitel | 4.5
 |  |  | 2017-03-12 | Doku (SchemBilder angepasst) | 1.5
 |  |  | 2017-03-13 | Doku (Labels, kleinere Adaptionen) | 2
 |  |  | 2017-03-15 | Weichen testen, Fehlersuchen, anpsassen | 8
 |  |  | 2017-03-18 | Doku (SchemBilder angepasst, ZiegelStyro Vergleich, SubOptimierung) | 4
 |  |  |  | Doku (TTOptimierung, WIR) | 3.5
 |  |  | 2017-03-22 | Weichen getestet | 4
 |  |  |  | Vorbereiten der Verbindungskabel | 3
 |  |  |  | Dokubesprechung /- verbesserung mit Wagner | 2
 |  |  |  | Dokubesprechung /- verbesserung alleine | 3
 |  |  | 2017-03-23 | Doku(Mehrweg-LS-Sys, Blockschaktbild) | 5
 |  |  | 2017-03-24 | Doku(5.1 erklären, BT) | 2
 |  |  |  | Doku(Kap. 3 ergänzen) | 1
 |  |  | 2017-03-25 | Doku(Überarbeiten + WIR) | 3.5
 |  |  |  | Doku(Überarbeiten + Kap.4 über) | 2.5
 |  |  | 2017-03-26 | Doku(4.2 & 4.3 & 4.4 korrektur) | 2.5
 |  |  | 2017-03-27 | Doku(Kapitel 3 ausbessern Wagner) | 2

Sheet: Macsek
Kalender-woche | Aufgaben | Dauer
KW 33 | Recherche zum Gesamtprojekt (Verstärker, Weichen, Bluetooth) (5h) | 5 h
KW 36 | Recherche zum Gesamtprojekt (10h), Entwurf eines Blockschaltbilds und Überarbeiten (6h) | 16 h
KW 39 | Gehäuseberechnungen - Subwooferbox und Satelliten-Boxen (1h), TSP einlesen (1h), Analog-Verstärker (Recherche & Bauteilbestandsaufnahme) (1h), Altium einrichten (1h) | 4 h
KW 40 | Analog-Verstärker (Recherche und Schaltung zeichnen) (5h), Recherche - geeignete Leistungs-Transistoren (1h), Zeitplan für die Diplomarbeit (1h) | 7 h
KW 41 | Vorbereitung der Lautsprecher-Chassis für Messungen (4h), TTVerstärker PCB layouten (2h), HTVerstärker PCB layouten (3h), HTVerstärker & TTVerstärker PCB anpassen (1h) | 10 h
KW 42 | TTVerstärker PCB neu überlegt (5h), HT-/TTVerstärker PCB überarbeitet (8h) | 13 h
KW 43 | mTT-Weiche+Addiererschaltung PCB & Schematic erstellen (3h) | 3 h
KW 44 | mTT-Weiche+Addiererschaltung PCB überarbeiten (1h), HTuTTWeiche PCB & Schematic erstellen (2h) | 3 h
KW 46 | Bauteilbeschaffung für Verstärkerprints (1h), Bestücken der Verstärkerprints (2h), Frequenzweichen finalisiert (1h), Korregieren der Verstärkerprints(1h) | 4 h
KW 47 | Tieftöner, Hochtöner und Subwoofer Messungen (9h) | 9 h
KW 48 | Lautsprechermessung (4h), Kühlkörper für Verstärkerprints bearbeitet (5h) | 9 h
KW 49 | Kühlkörper für Verstärkerprints bearbeitet (3h), Verstärkerprints testen, messen, bearbeiten (2h), | 5 h
KW 50 | Lautsprechermessungen (5h), Auswertung der Messungen (1h), Weichenprints anpassen (4h) | 9 h
KW 51 | Lautsprecher messen (Subwoofer mit Styropor und Ytong-Ziegel) (4h), Schaltung HTuTT-Weiche optimieren (5h) | 9 h
KW 01 | Projekt-Files anpassen (2,5h), Hauptboard bearbeiten (1h), einstellbares Filter testen (1h), Lautsprechermessungen (6,5h), Testen des Messequipments (1h), Prints 2,3 und 4 verbessern (2h) | 14 h
KW 02 | Lautsprechermessungen: 2-Weg-System(TT1+AE1004) mit Stereo-Verstärker aufgebaut und mit Filter angepasst (5h) | 5 h
KW 03 | Brüel&Kjaer 2 Messungen in ein Diagram (2h), Recherche (HT & Ladegerät) (1,5h), Printbohrungen erweitern(0,5h), Überlegungen zur Subwooferbox (1h) | 5 h
KW 05 | Messungen DTW 72-8 & TT1 (2h), Entwurf von Elektronikschacht in der Subwooferbox (2h) | 4 h
KW 06 | Dokumentation (15h) | 15 h
KW 07 | Subwoofer-Verstärker testen (5h), TT- und HT-Verstärker testen (1h), Frontplatine testen (2h), Netzteilüberelegungen (1h) | 9 h
KW 08 | TT- und HT-Verstärker testen & verbessern (5h), Frontplatine mit Hauptplatine testen & verbessern (3h), über Netzteile informieren (1h) | 9 h
KW 09 | Rückwand-Design überlegen (2h), Rückwand und Grundplatte bearbeiten (4h), Dokumentation (4h), BT-Modul Fehlersuche (4h) | 14 h
KW 10 | Bluetooth-Modul Fehlersuche & Korrektur (5h), Weichen bestücken, testen, verbessern (4h), Dokumentation (6h) | 15 h
KW 11 | Dokumentation (8h), Weichen Fehlersuche testen & verbessern (8h) | 16 h
KW 12 | Dokumentation (22h), Weichen Fehlersuche & testen (4h), Verdrahtung vorbereiten (2h) | 28 h
KW 13 | Dokumentation (40h) | 40 h
 | Gesamt Stundenzahl: | 280 h

Sheet: Bointner
Kalender-woche | Aufgaben | Dauer
KW 33 | Recherche zum Gesamtprojekt (Verstärker, Weichen, Bluetooth) (5h) | 5 h
KW 36 | Recherche zum Gesamtprojekt (10h), Entwurf eines Blockschaltbildes (6h) | 16 h
KW 38 | Funktionstest eines Subwoofer-Chassis (Visaton WPC30) (2h) | 2 h
KW 39 | Gehäuseberechnungen - Mono-Subwooferbox mit verschiedenen Subwoofer (1h), Thiele Small Parameter einlesen (1h), Verstärkerschaltung begonnen (2h) | 4 h
KW 40 | Analog-Verstärker (Recherche und Schaltung zeichnen) (7h) | 7 h
KW 41 | Vorbereitung der Mess-Lautsprecher-Chassis (4h), TTVerstärker PCB-Layout entwickeln(2h) | 6 h
KW 42 | Adapterprint für das BT-Modul entwickelt und bestellt (6h) | 6 h
KW 43 | Adapterprint ferrtiggestellt und Funktion getestet (4h), BT-Modul: Pins und Zusatzfunktionen getestet (3h) | 7 h
KW 44 | Weichenschaltung optimiert | 1 h
KW 46 | BT-Modul: Konfiguration und Pin-Tests (2h), Frequenzweichen finalisiert und in Auftrag gegeben (1h), Schaltungen für Hauptboard und Frontplatine entwickelt und Layout angefertigt (6h) | 9 h
KW 47 | Tieftöner, Hochtöner und Subwoofer Messungen (9h) | 9 h
KW 48 | Lautsprechermessung (4h), Printentflechtung (5h) | 9 h
KW 49 | Hochton-Lautsprecher Messungen (1h), Verstärker-Tests (4h), Hauptboard-Print entflechtet (4h) | 9 h
KW 50 | Lautsprechermessungen (4h), Hauptboard-Layout bearbeiten und optimieren (5h) | 9 h
KW 51 | Lautsprecher messen (Subwoofer mit Styropor und Ytong-Ziegel) (4h), Ergebnisse interpretieren (1h), Weichen optimieren (4h) | 9 h
KW 01 | Testen des Messequipments (1h), Lautsprechermessungen mit stark verkleinertem Volumen und Filter (7h) | 8 h
KW 02 | Lautsprechermessungen: 2-Weg-System(TT1+AE1004) mit Stereo-Verstärker aufgebaut und mit Filter angepasst (5h) | 5 h
KW 03 | Vergleichsmessung Ytong - Styropor (2h), Bauteilsuche (1h), Hauptboard bestücken + Fehlerbehebung am BT-Adapter (2h), Hauptboard testen (1h) | 6 h
KW 04 | Hauptboard testen (4h) | 4 h
KW 05 | Messungen DTW 72-8 + TT1 (2h), Entwurf von Elektronikschacht in der Subwooferbox (2h) | 4 h
KW 06 | Dokumentation (7h) | 7 h
KW 07 | Subwooferverstärker testen (5h), Frontpanel bestücken (1h), Frontplatine testen (2h), Netzteilüberelegungen (1h) | 9 h
KW 08 | TT- und HT-Verstärker testen & verbessern (5h), Frontplatine mit Hauptplatine testen & verbessern (3h), über Netzteile informieren (2h) | 10 h
KW 09 | Rückwand-Design überlegen (2h), BT-Modul mit Verstärker getestet (2h) , Dokumentation (2h), Weichen berechnet, bestückt und getestet (3h) | 9 h
KW 10 | Bluetooth-Modul Fehlersuche & Korrektur (5h), Weichen testen, verbessern (4h), Dokumentation (6h) | 15 h
KW 11 | Dokumentation (5h) | 5 h
KW 12 | Dokumentation (7h) | 7 h
KW 13 | Dokumentation (8h) | 8 h
 | Gesamt Stundenzahl: | 203 h
