crazyskater9/Diplomarbeit/img/Print3/3mTTWeicheruAddierer-Best.PNG

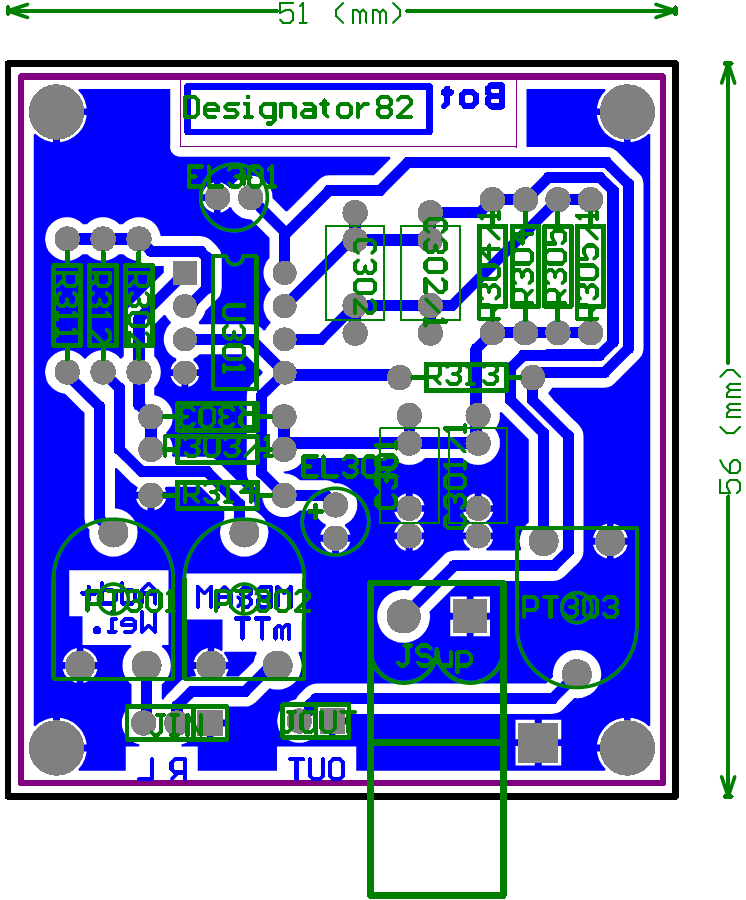
img/Print3/3mTTWeicheruAddierer-Best.PNG
