crazyskater9/Diplomarbeit/img/Print3/3mTTWeicheruAddierer-Blist.PNG

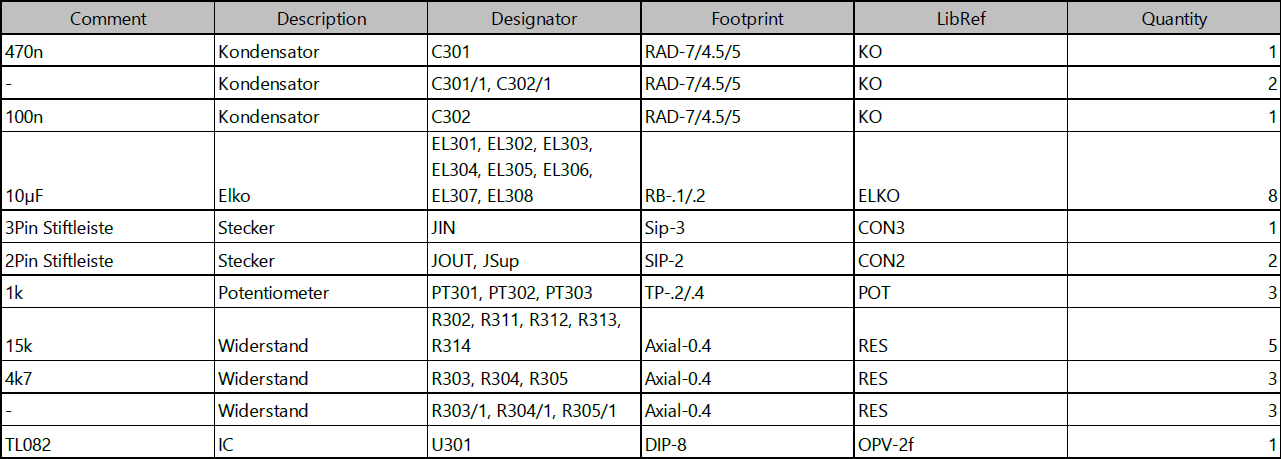
img/Print3/3mTTWeicheruAddierer-Blist.PNG
