crazyskater9/Diplomarbeit/img/Print4/4_TTuHTWeiche-Best.PNG

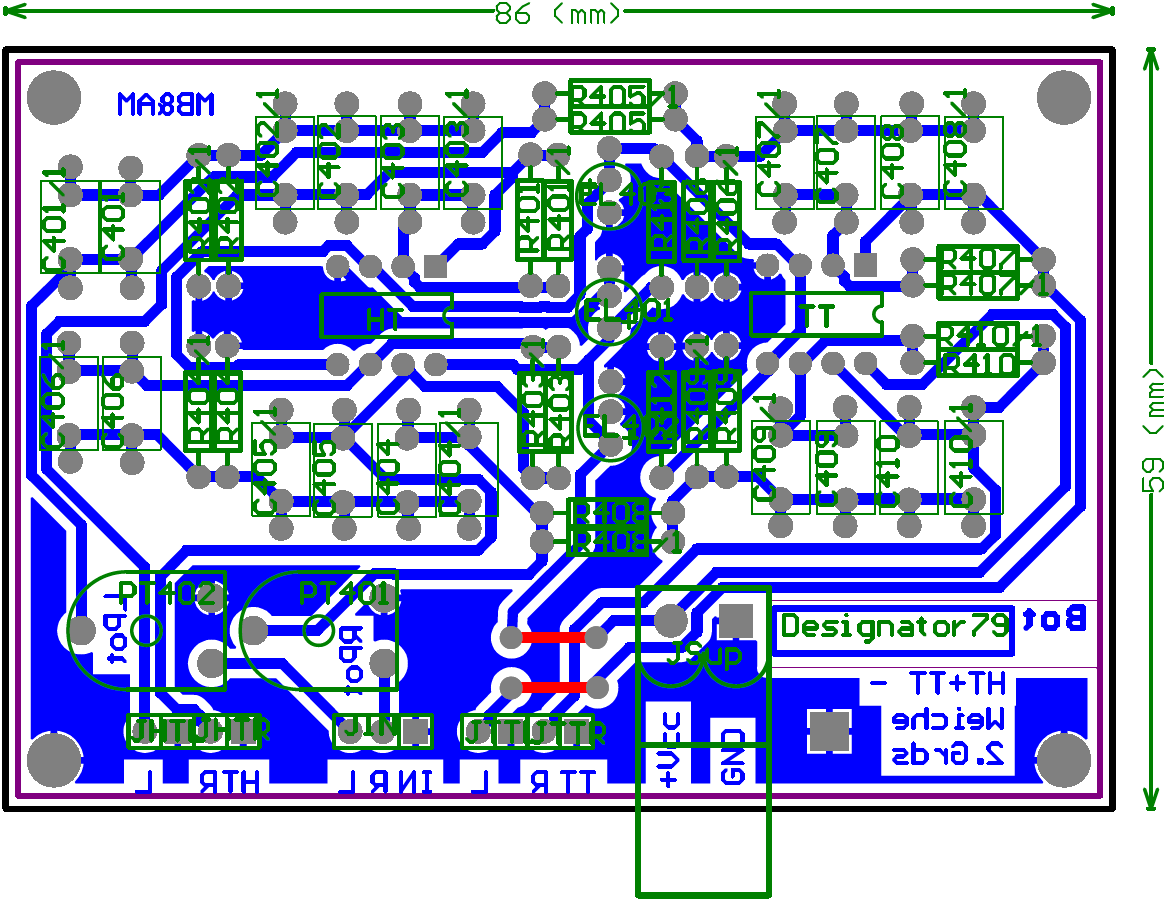
img/Print4/4_TTuHTWeiche-Best.PNG
