crazyskater9/Diplomarbeit/img/Print5/5_TTVerstaerker-Best.PNG

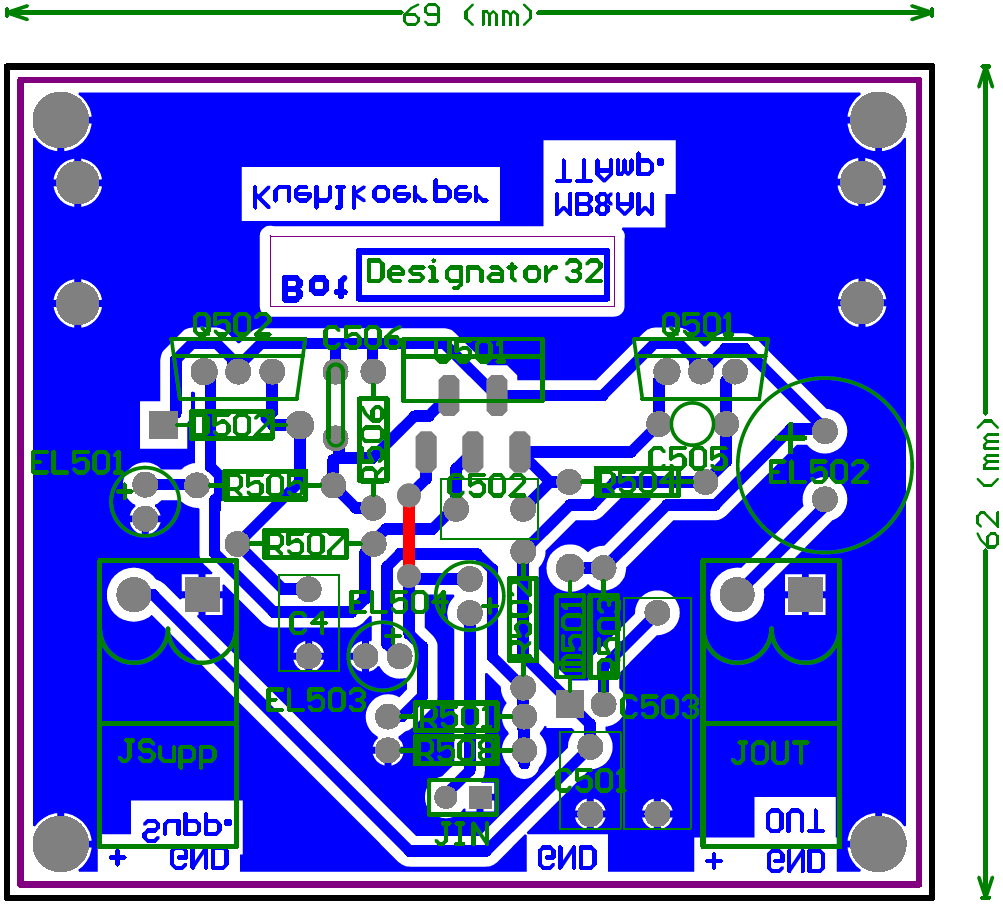
img/Print5/5_TTVerstaerker-Best.PNG
