crazyskater9/Diplomarbeit/img/Print5/5_TTVerstaerker-Blist.PNG

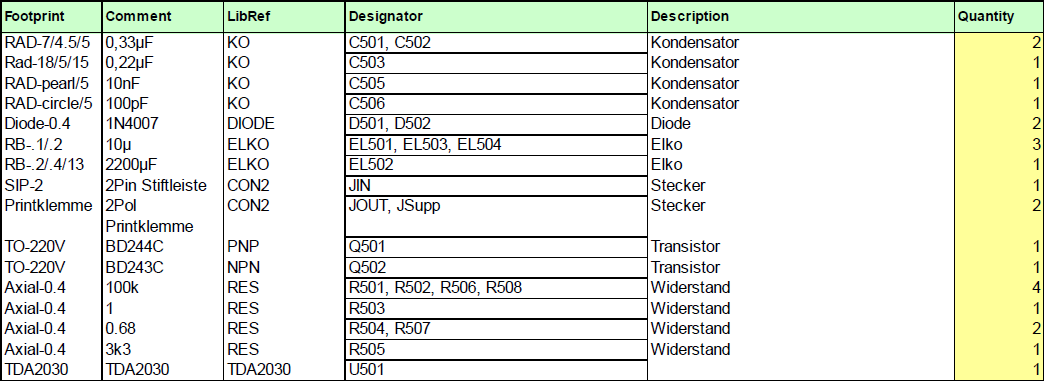
img/Print5/5_TTVerstaerker-Blist.PNG
