crazyskater9/Diplomarbeit/img/Print5/5_TTVerstaerker-PCB.PNG

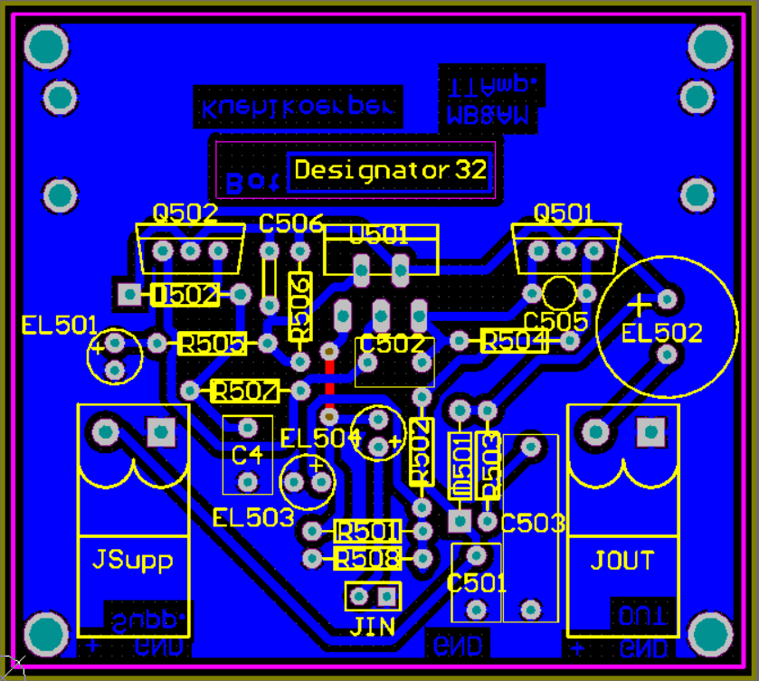
img/Print5/5_TTVerstaerker-PCB.PNG
