crazyskater9/Diplomarbeit/img/Print5/5_TTVerstaerker-Schem.PNG

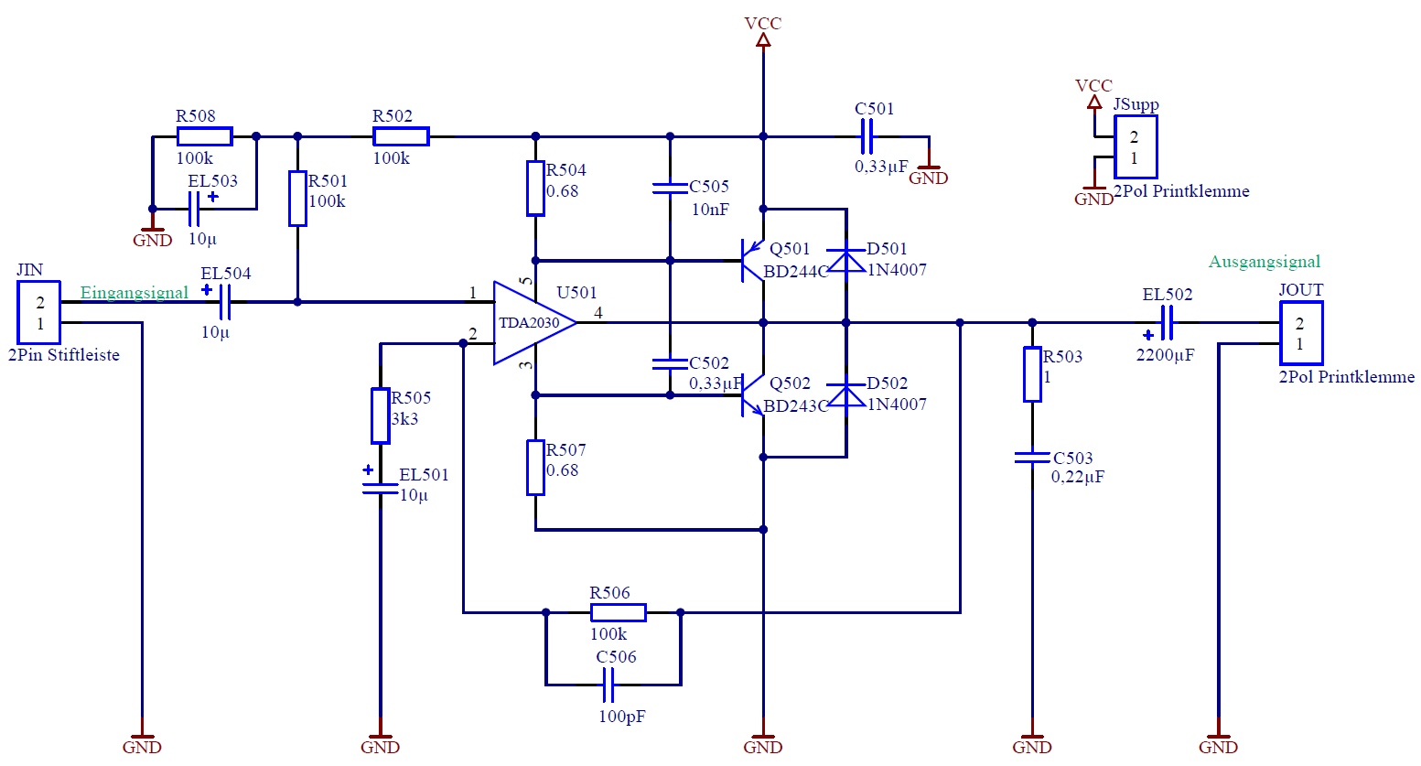
img/Print5/5_TTVerstaerker-Schem.PNG
