crazyskater9/Diplomarbeit/img/Print6/HTVerstaerker-Best.PNG

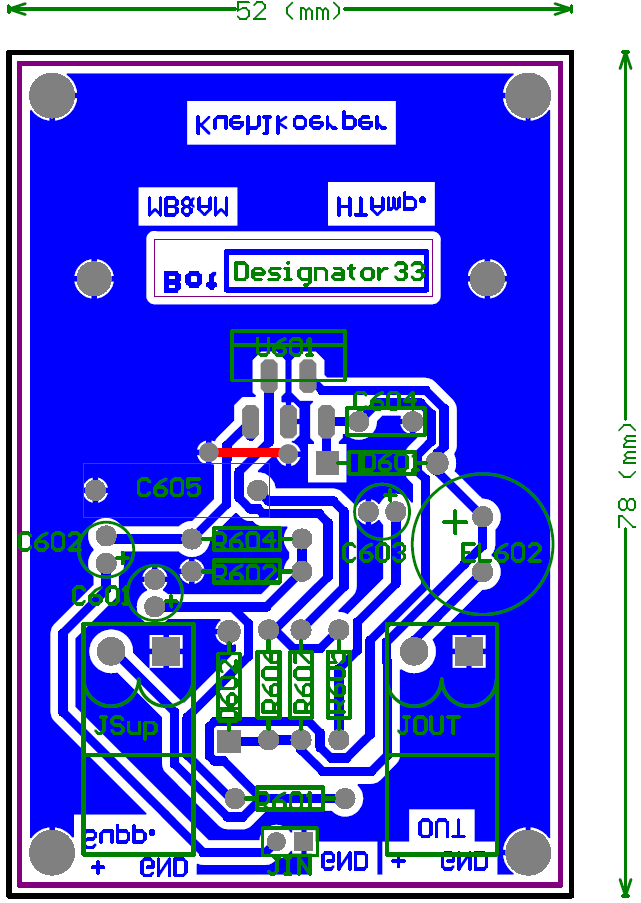
img/Print6/HTVerstaerker-Best.PNG
