crazyskater9/Diplomarbeit/img/Print6/HTVerstaerker-BList.PNG

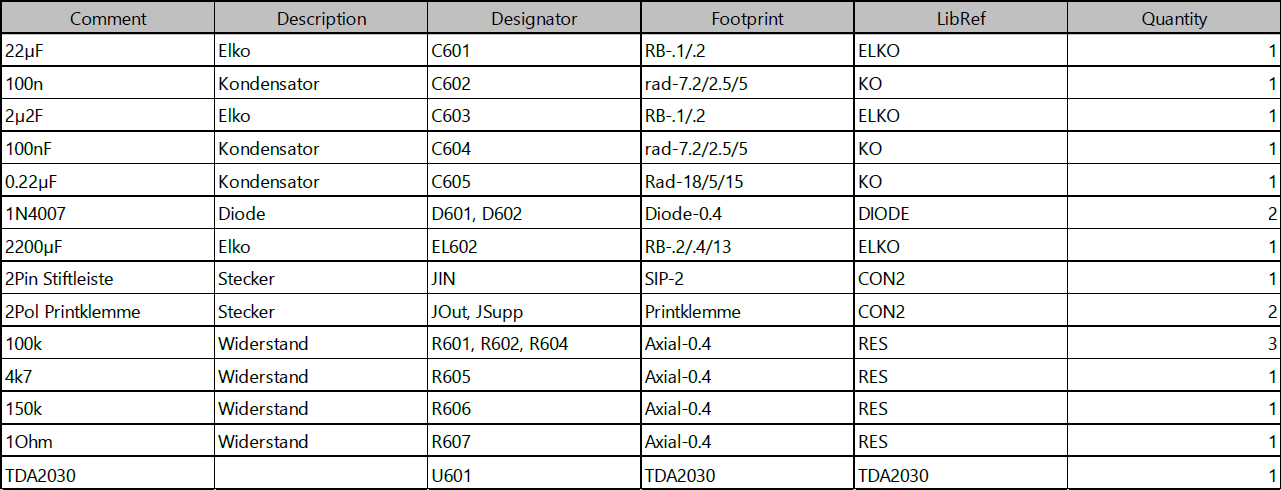
img/Print6/HTVerstaerker-BList.PNG
