crazyskater9/Diplomarbeit/img/Print6/HTVerstaerker-PCB.PNG

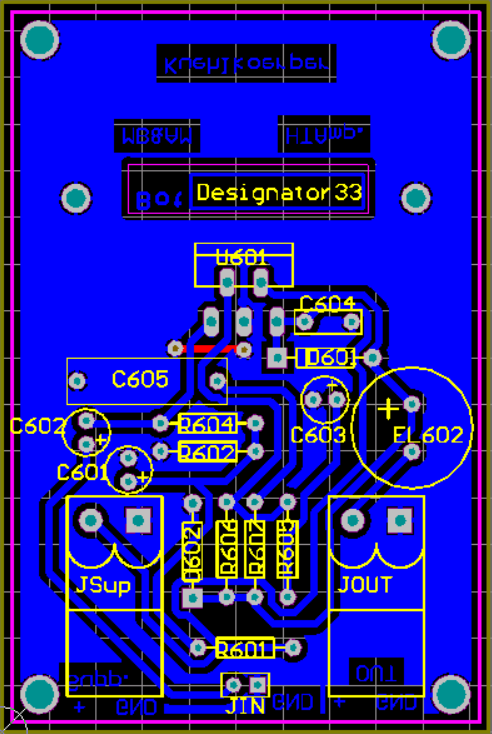
img/Print6/HTVerstaerker-PCB.PNG
