crazyskater9/Diplomarbeit/img/Print6/HTVerstaerker-Schem.PNG

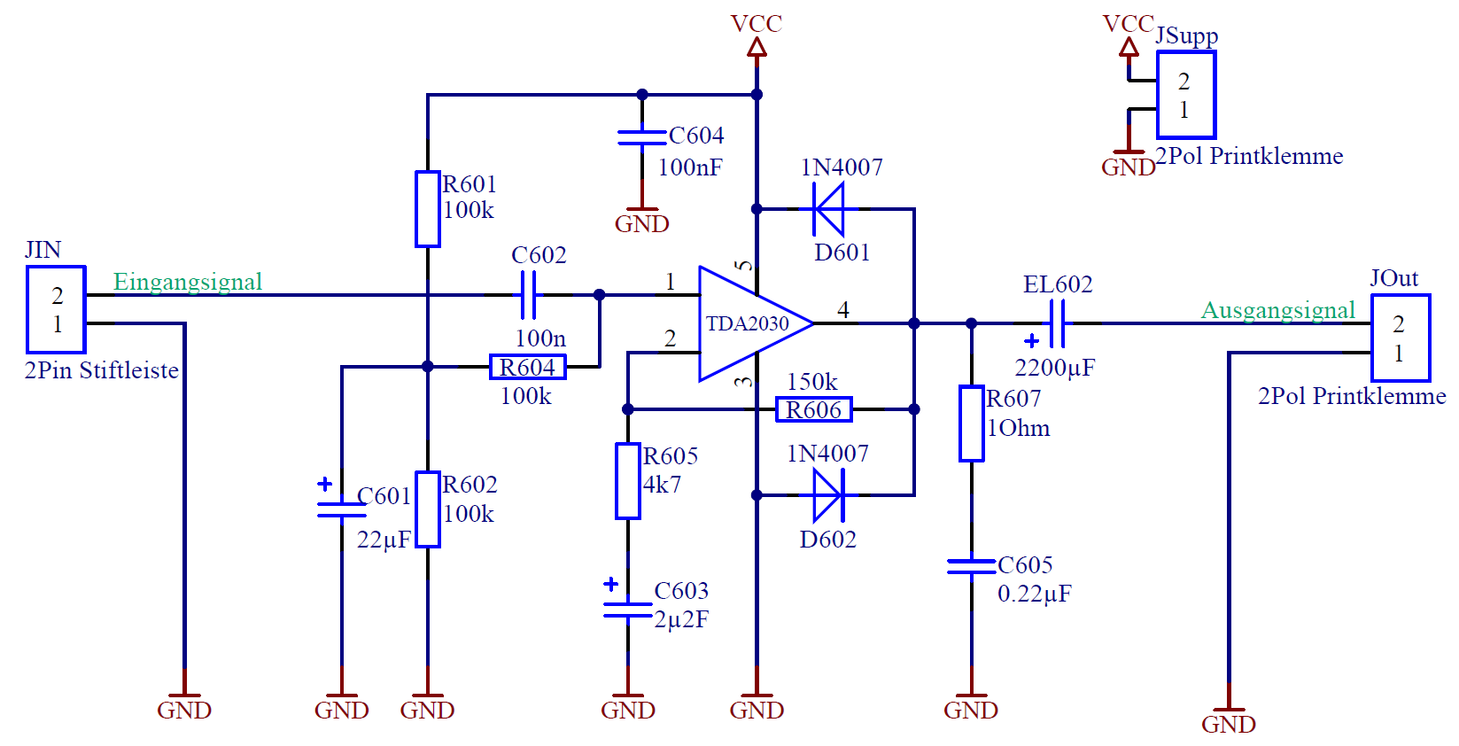
img/Print6/HTVerstaerker-Schem.PNG
