crazyskater9/Diplomarbeit/form/betreuungsprotokoll_1.pdf

### HTBLuVA St. Pölten Reife- und

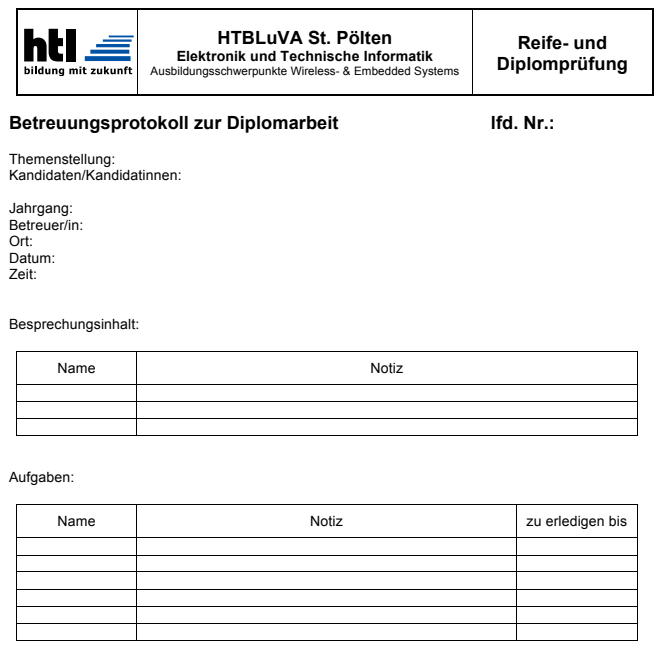
[picture p155: page 1]
Diplomprüfung; Betreuungsprotokoll zur Diplomarbeit; lfd. Nr.:; Themenstellung: Kandidaten/Kandidatinnen:; Jahrgang: Betreuer/in: Ort: Datum: Zeit:; Besprechungsinhalt:; Aufgaben:; Name; Notiz; zu erledigen bis

Elektronik und Technische Informatik
Ausbildungsschwerpunkte Wireless- & Embedded Systems
