crazyskater9/Diplomarbeit/CD/Messungen/20161221-LautsprecherMessungen.pdf

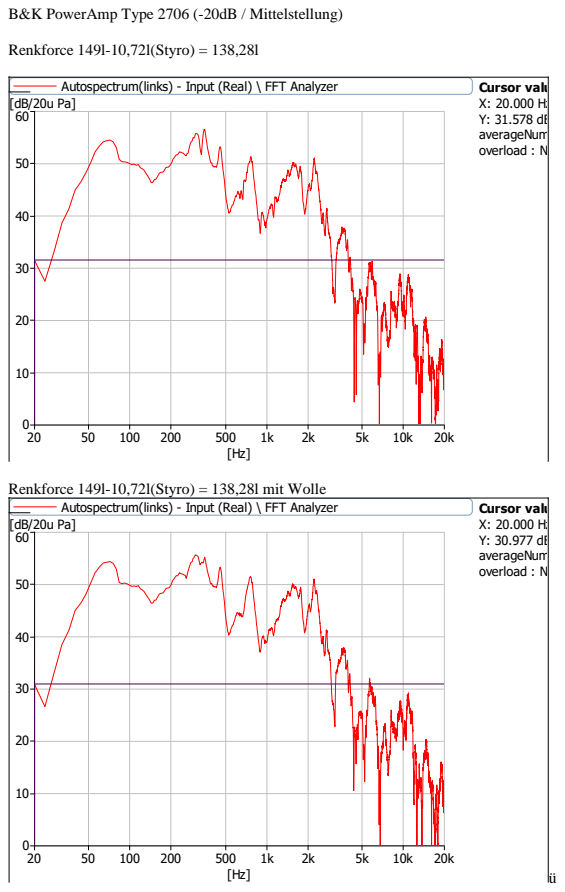
[picture p156: page 1]
Renkforce 149l-10,72l(Styro) = 138,28l; Cursor values X: 20.000 Hz Y: 31.578 dB/20u Pa averageNumber : 100 overload : No; Cursor values X: 20.000 Hz Y: 30.977 dB/20u Pa averageNumber : 100 overload : No

B&K PowerAmp Type 2706 (-20dB / Mittelstellung)

Autospectrum(links) - Input (Real) \ FFT Analyzer

Renkforce 149l-10,72l(Styro) = 138,28l mit Wolle

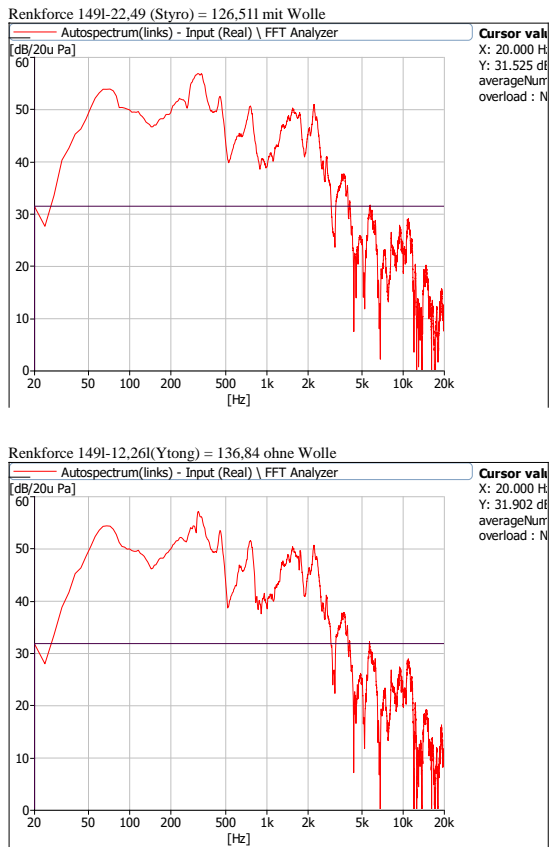
[picture p157: page 2]
Cursor values X: 20.000 Hz Y: 31.525 dB/20u Pa averageNumber : 100 overload : No; Cursor values X: 20.000 Hz Y: 31.902 dB/20u Pa averageNumber : 100 overload : No

Renkforce 149l-22,49 (Styro) = 126,51l mit Wolle

Autospectrum(links) - Input (Real) \ FFT Analyzer

Renkforce 149l-12,26l(Ytong) = 136,84 ohne Wolle

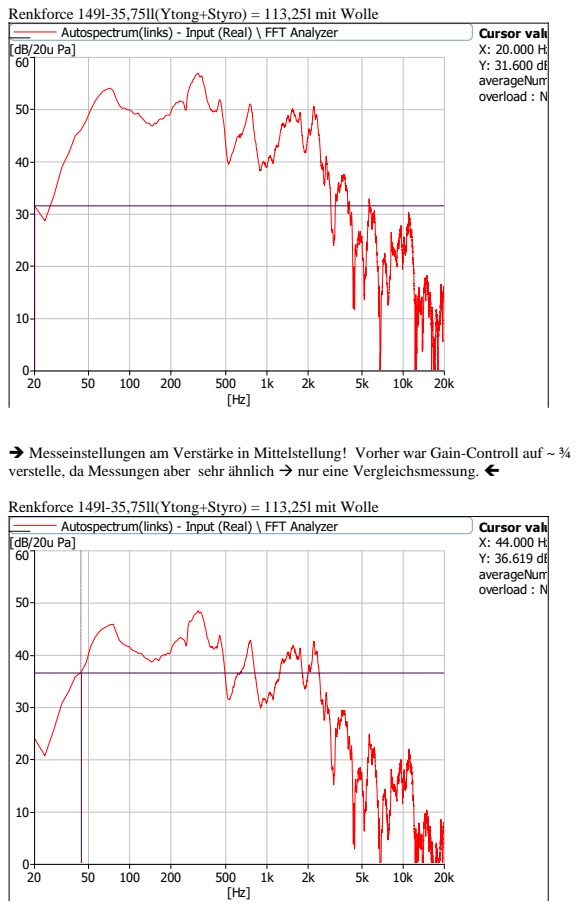
[picture p158: page 3]
Cursor values X: 20.000 Hz Y: 31.600 dB/20u Pa averageNumber : 100 overload : No; Cursor values X: 44.000 Hz Y: 36.619 dB/20u Pa averageNumber : 100 overload : No

Renkforce 149l-35,75ll(Ytong+Styro) = 113,25l mit Wolle

Autospectrum(links) - Input (Real) \ FFT Analyzer

→ Messeinstellungen am Verstärke in Mittelstellung! Vorher war Gain-Controll auf ~ ¾
verstelle, da Messungen aber sehr ähnlich → nur eine Vergleichsmessung.

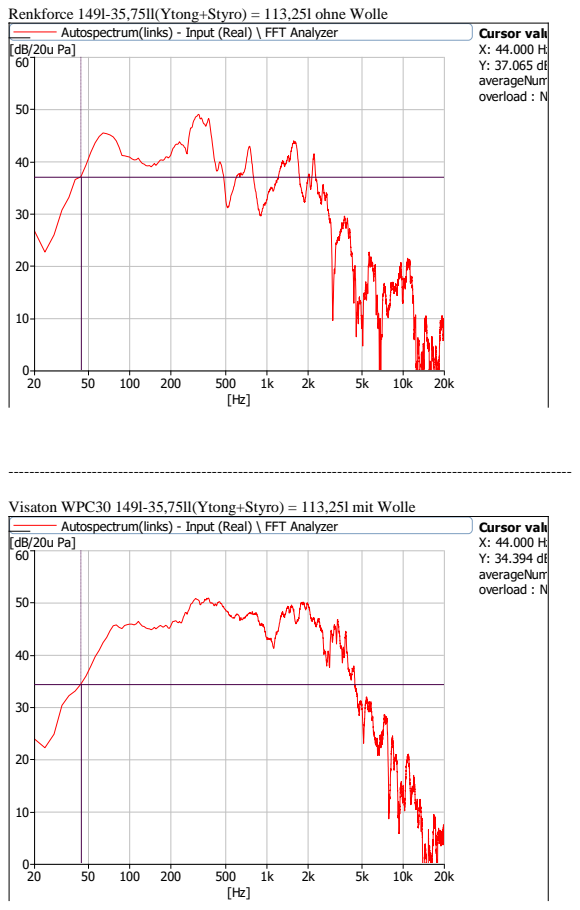
[picture p159: page 4]
Cursor values X: 44.000 Hz Y: 37.065 dB/20u Pa averageNumber : 100 overload : No; Cursor values X: 44.000 Hz Y: 34.394 dB/20u Pa averageNumber : 100 overload : No

Renkforce 149l-35,75ll(Ytong+Styro) = 113,25l ohne Wolle

Autospectrum(links) - Input (Real) \ FFT Analyzer

Visaton WPC30 149l-35,75ll(Ytong+Styro) = 113,25l mit Wolle

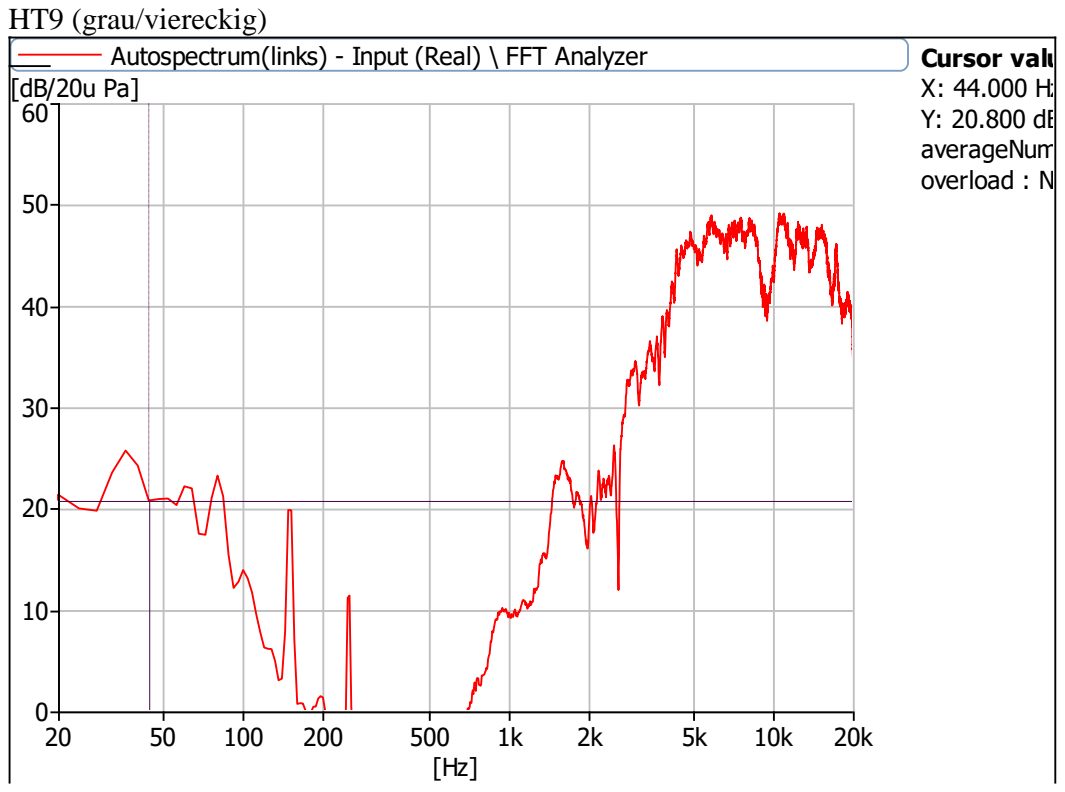
[picture p160: page 5]
HT9 (grau/viereckig); Cursor values X: 44.000 Hz Y: 20.800 dB/20u Pa averageNumber : 100 overload : No

Autospectrum(links) - Input (Real) \ FFT Analyzer
