crazyskater9/Diplomarbeit/CD/Messungen/20170107-SubwooferMessung.pdf

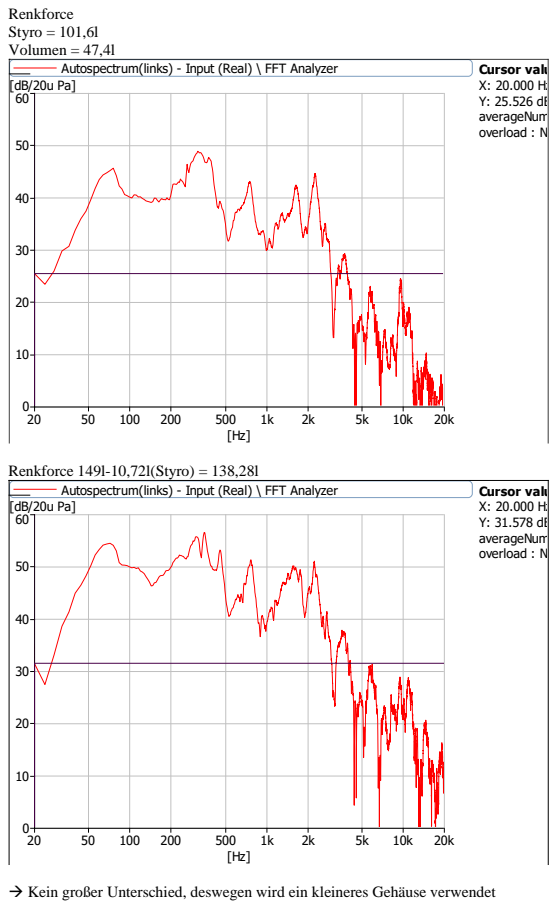
[picture p161: page 1]
Renkforce Styro = 101,6l Volumen = 47,4l; Cursor values X: 20.000 Hz Y: 25.526 dB/20u Pa averageNumber : 100 overload : No; Renkforce 149l-10,72l(Styro) = 138,28l; Cursor values X: 20.000 Hz Y: 31.578 dB/20u Pa averageNumber : 100 overload : No

Autospectrum(links) - Input (Real) \ FFT Analyzer

→ Kein großer Unterschied, deswegen wird ein kleineres Gehäuse verwendet

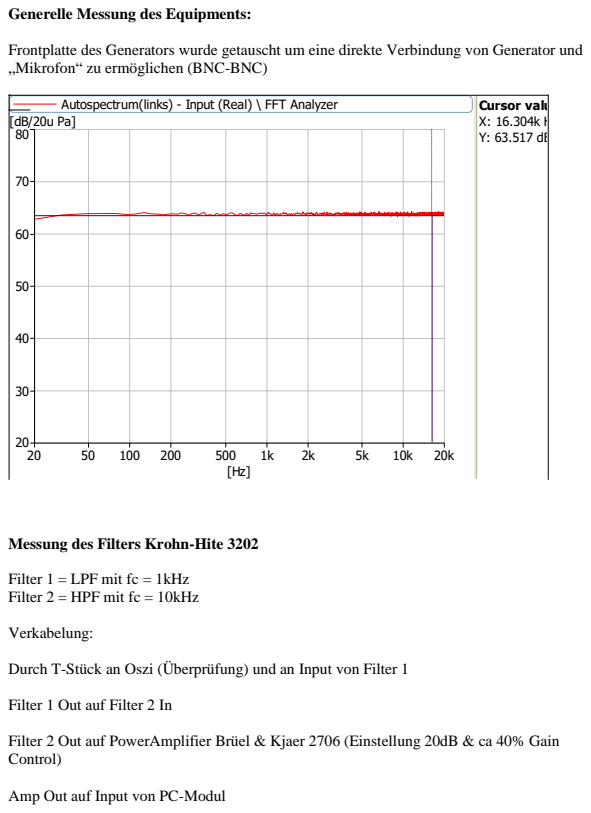
[picture p162: page 2]
Cursor values X: 16.304k Hz Y: 63.517 dB/20u Pa; Verkabelung:

Generelle Messung des Equipments:

Frontplatte des Generators wurde getauscht um eine direkte Verbindung von Generator und
„Mikrofon“ zu ermöglichen (BNC-BNC)

Autospectrum(links) - Input (Real) \ FFT Analyzer

Messung des Filters Krohn-Hite 3202

Filter 1 = LPF mit fc = 1kHz
Filter 2 = HPF mit fc = 10kHz

Durch T-Stück an Oszi (Überprüfung) und an Input von Filter 1

Filter 1 Out auf Filter 2 In

Filter 2 Out auf PowerAmplifier Brüel & Kjaer 2706 (Einstellung 20dB & ca 40% Gain
Control)

Amp Out auf Input von PC-Modul

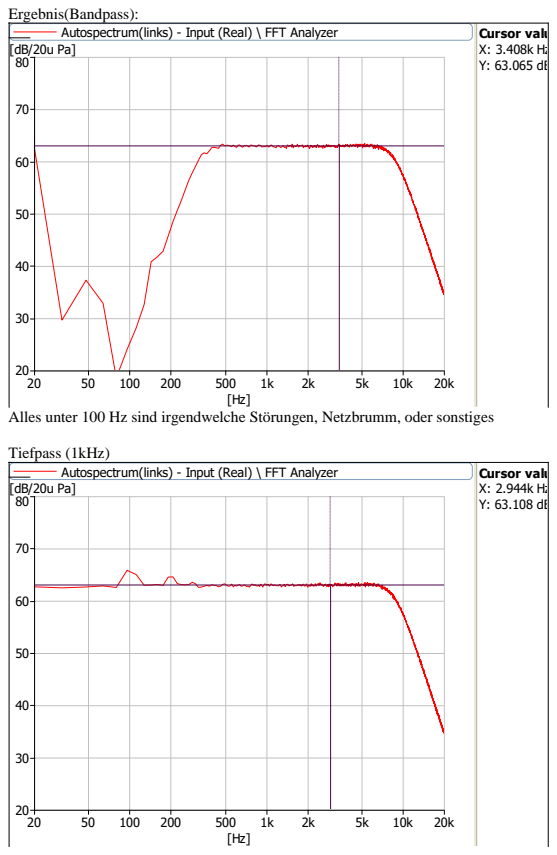
[picture p163: page 3]
Ergebnis(Bandpass):; Cursor values X: 3.408k Hz Y: 63.065 dB/20u Pa; Tiefpass (1kHz); Cursor values X: 2.944k Hz Y: 63.108 dB/20u Pa

Autospectrum(links) - Input (Real) \ FFT Analyzer

Alles unter 100 Hz sind irgendwelche Störungen, Netzbrumm, oder sonstiges

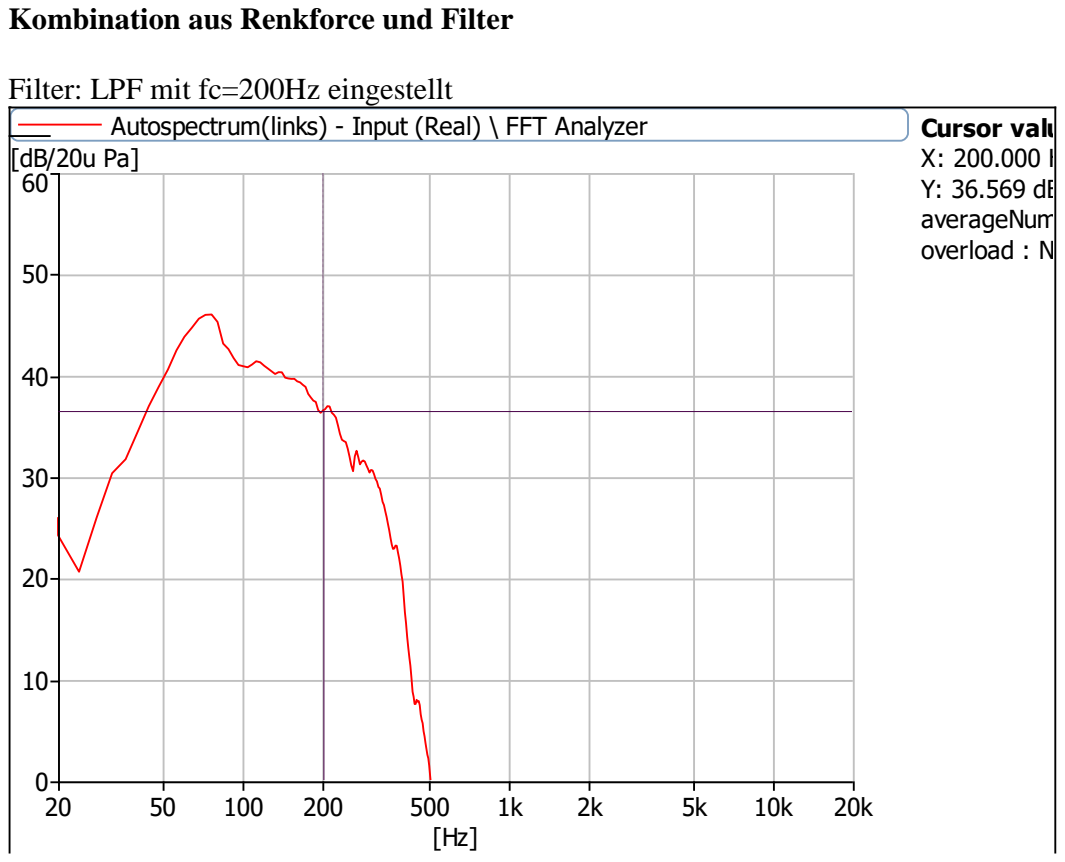
[picture p164: page 4]
Cursor values X: 200.000 Hz Y: 36.569 dB/20u Pa averageNumber : 100 overload : No

Kombination aus Renkforce und Filter

Filter: LPF mit fc=200Hz eingestellt

Autospectrum(links) - Input (Real) \ FFT Analyzer

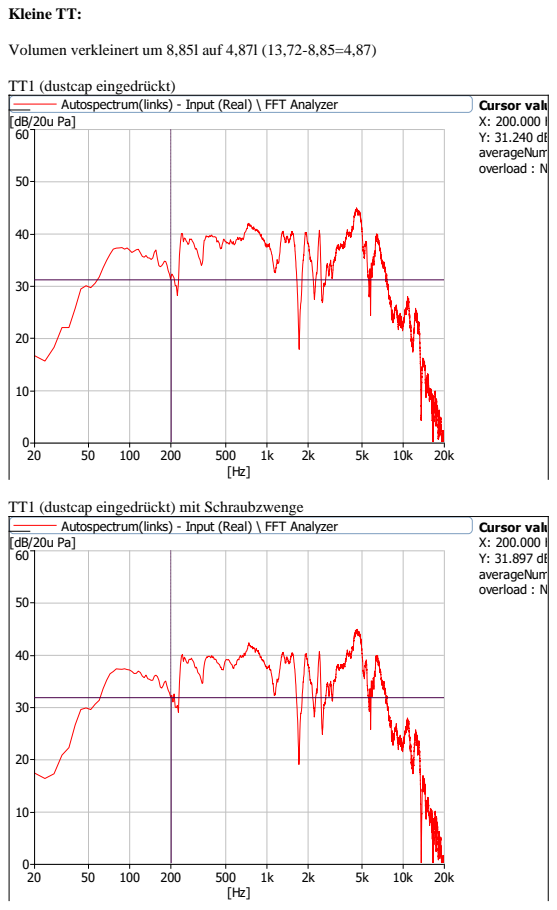
[picture p165: page 5]
Kleine TT:; TT1 (dustcap eingedrückt); Cursor values X: 200.000 Hz Y: 31.240 dB/20u Pa averageNumber : 100 overload : No; Cursor values X: 200.000 Hz Y: 31.897 dB/20u Pa averageNumber : 100 overload : No

Volumen verkleinert um 8,85l auf 4,87l (13,72-8,85=4,87)

Autospectrum(links) - Input (Real) \ FFT Analyzer

TT1 (dustcap eingedrückt) mit Schraubzwenge

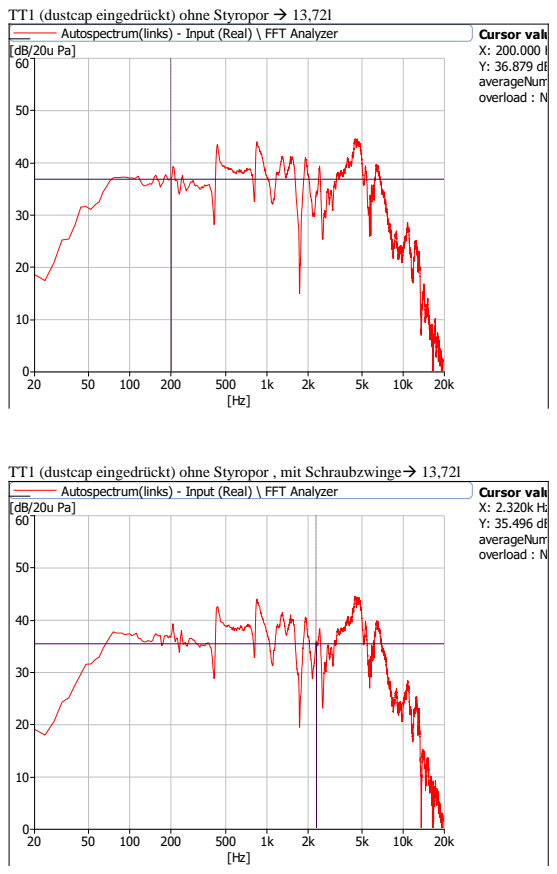
[picture p166: page 6]
Cursor values X: 200.000 Hz Y: 36.879 dB/20u Pa averageNumber : 100 overload : No; Cursor values X: 2.320k Hz Y: 35.496 dB/20u Pa averageNumber : 100 overload : No

TT1 (dustcap eingedrückt) ohne Styropor → 13,72l

Autospectrum(links) - Input (Real) \ FFT Analyzer

TT1 (dustcap eingedrückt) ohne Styropor , mit Schraubzwinge→ 13,72l

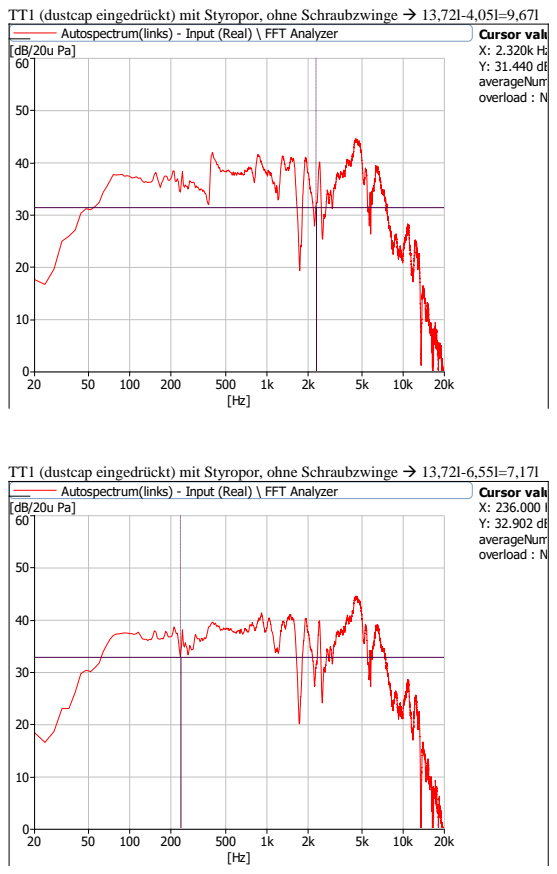
[picture p167: page 7]
Cursor values X: 2.320k Hz Y: 31.440 dB/20u Pa averageNumber : 100 overload : No; Cursor values X: 236.000 Hz Y: 32.902 dB/20u Pa averageNumber : 100 overload : No

TT1 (dustcap eingedrückt) mit Styropor, ohne Schraubzwinge → 13,72l-4,05l=9,67l

Autospectrum(links) - Input (Real) \ FFT Analyzer

TT1 (dustcap eingedrückt) mit Styropor, ohne Schraubzwinge → 13,72l-6,55l=7,17l

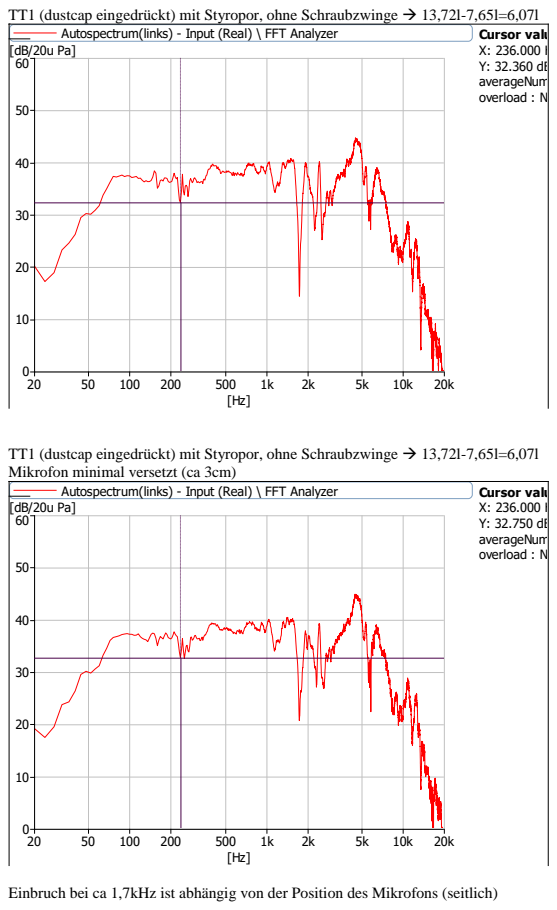
[picture p168: page 8]
Cursor values X: 236.000 Hz Y: 32.360 dB/20u Pa averageNumber : 100 overload : No; Cursor values X: 236.000 Hz Y: 32.750 dB/20u Pa averageNumber : 100 overload : No

TT1 (dustcap eingedrückt) mit Styropor, ohne Schraubzwinge → 13,72l-7,65l=6,07l

Autospectrum(links) - Input (Real) \ FFT Analyzer

Mikrofon minimal versetzt (ca 3cm)

Einbruch bei ca 1,7kHz ist abhängig von der Position des Mikrofons (seitlich)

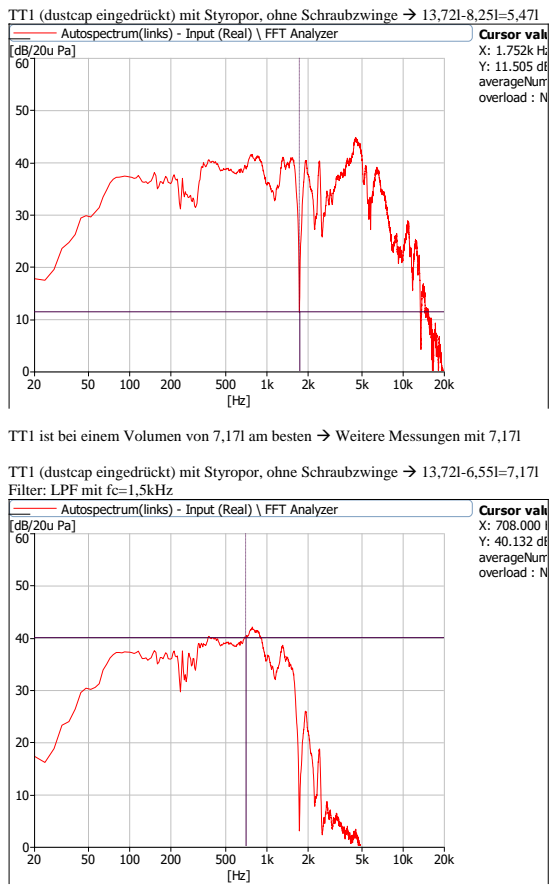
[picture p169: page 9]
Cursor values X: 1.752k Hz Y: 11.505 dB/20u Pa averageNumber : 100 overload : No; Cursor values X: 708.000 Hz Y: 40.132 dB/20u Pa averageNumber : 100 overload : No

TT1 (dustcap eingedrückt) mit Styropor, ohne Schraubzwinge → 13,72l-8,25l=5,47l

Autospectrum(links) - Input (Real) \ FFT Analyzer

TT1 ist bei einem Volumen von 7,17l am besten → Weitere Messungen mit 7,17l

TT1 (dustcap eingedrückt) mit Styropor, ohne Schraubzwinge → 13,72l-6,55l=7,17l
Filter: LPF mit fc=1,5kHz
