crazyskater9/Diplomarbeit/CD/Messungen/20170111-Messung.pdf

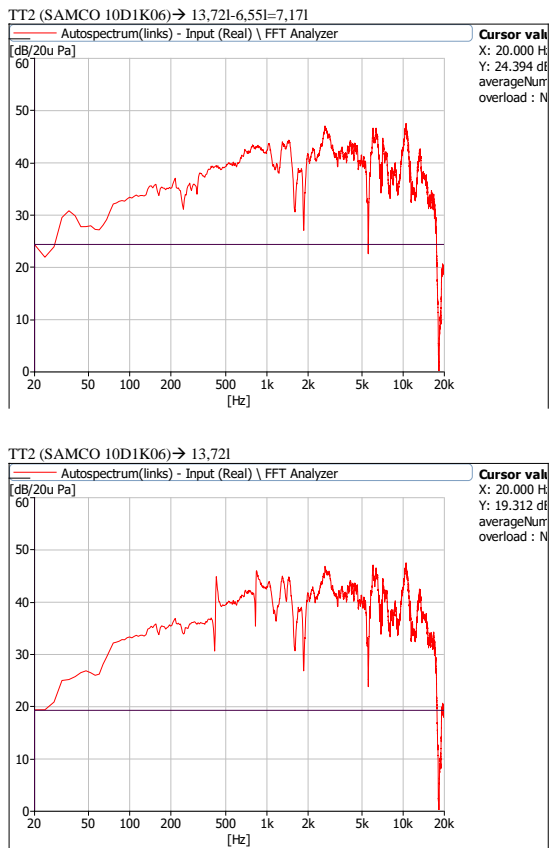
[picture p170: page 1]
TT2 (SAMCO 10D1K06)→ 13,72l-6,55l=7,17l; Cursor values X: 20.000 Hz Y: 24.394 dB/20u Pa averageNumber : 100 overload : No; TT2 (SAMCO 10D1K06)→ 13,72l; Cursor values X: 20.000 Hz Y: 19.312 dB/20u Pa averageNumber : 100 overload : No

Autospectrum(links) - Input (Real) \ FFT Analyzer

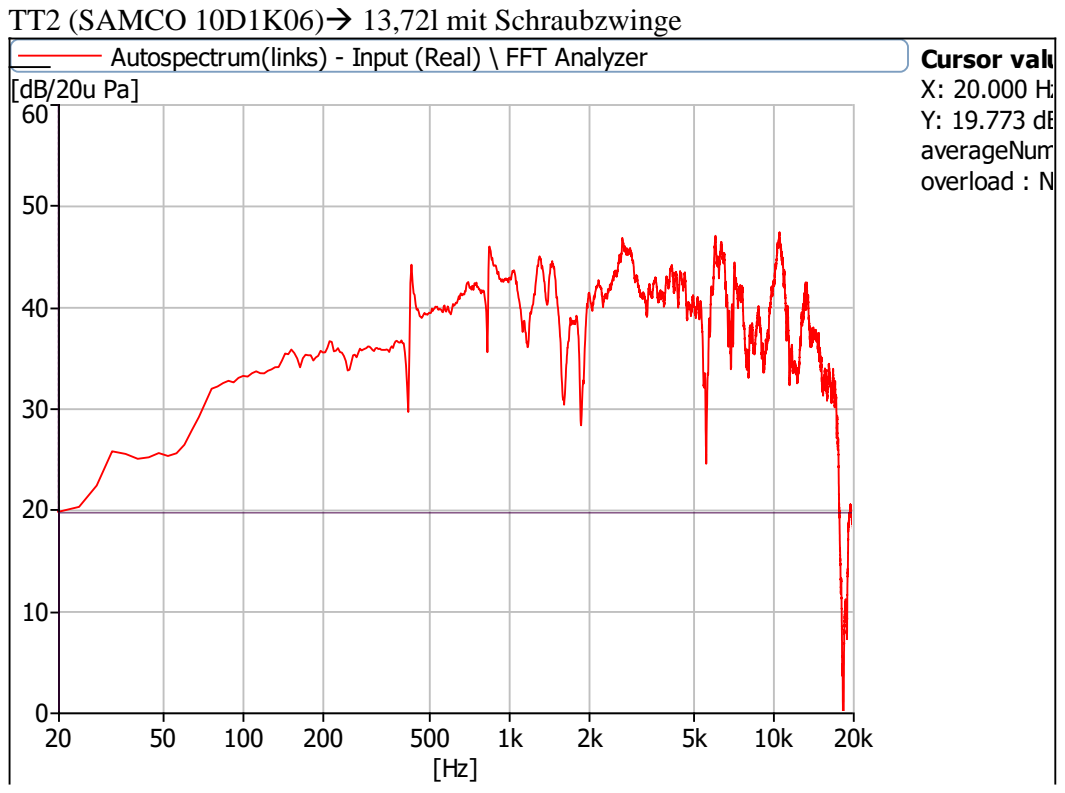
[picture p171: page 2]
Cursor values X: 20.000 Hz Y: 19.773 dB/20u Pa averageNumber : 100 overload : No

TT2 (SAMCO 10D1K06)→ 13,72l mit Schraubzwinge

Autospectrum(links) - Input (Real) \ FFT Analyzer

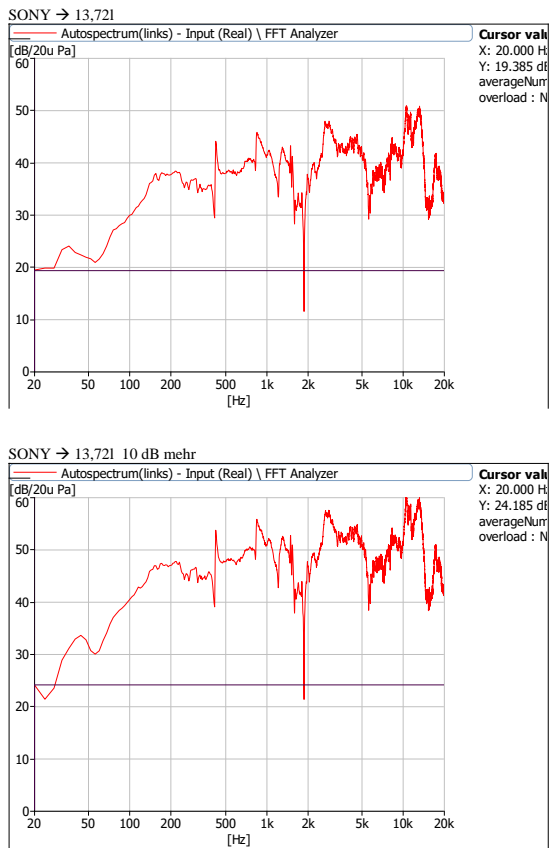
[picture p172: page 3]
SONY → 13,72l; Cursor values X: 20.000 Hz Y: 19.385 dB/20u Pa averageNumber : 100 overload : No; Cursor values X: 20.000 Hz Y: 24.185 dB/20u Pa averageNumber : 100 overload : No

Autospectrum(links) - Input (Real) \ FFT Analyzer

SONY → 13,72l 10 dB mehr

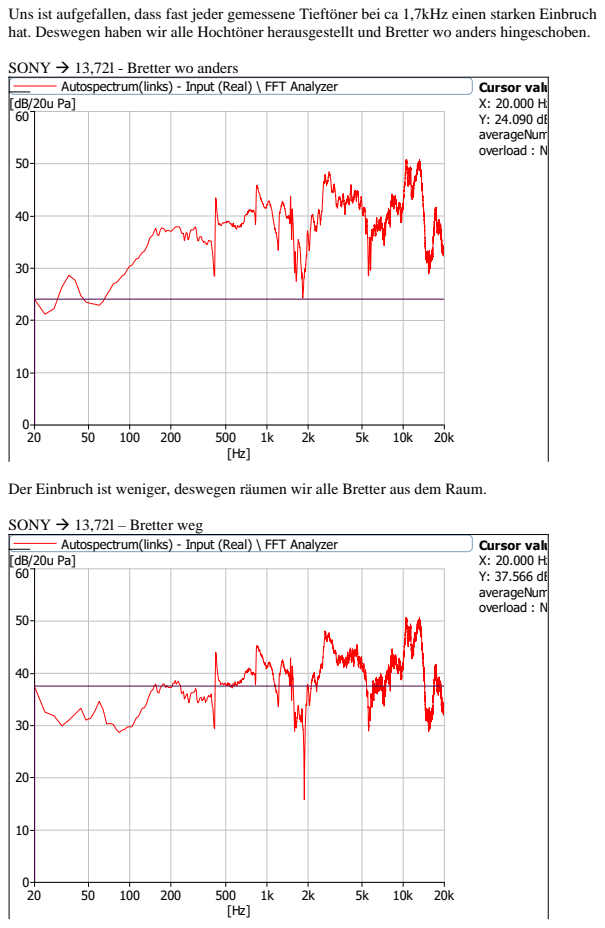
[picture p173: page 4]
Cursor values X: 20.000 Hz Y: 24.090 dB/20u Pa averageNumber : 100 overload : No; Cursor values X: 20.000 Hz Y: 37.566 dB/20u Pa averageNumber : 49 overload : No

Uns ist aufgefallen, dass fast jeder gemessene Tieftöner bei ca 1,7kHz einen starken Einbruch
hat. Deswegen haben wir alle Hochtöner herausgestellt und Bretter wo anders hingeschoben.

SONY → 13,72l - Bretter wo anders

Autospectrum(links) - Input (Real) \ FFT Analyzer

Der Einbruch ist weniger, deswegen räumen wir alle Bretter aus dem Raum.

SONY → 13,72l – Bretter weg

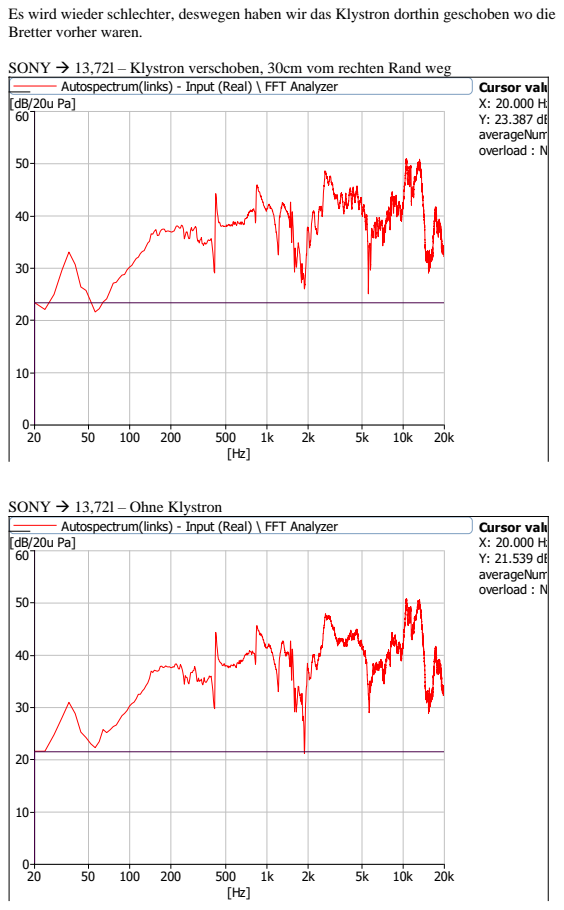
[picture p174: page 5]
Cursor values X: 20.000 Hz Y: 23.387 dB/20u Pa averageNumber : 100 overload : No; Cursor values X: 20.000 Hz Y: 21.539 dB/20u Pa averageNumber : 100 overload : No

Es wird wieder schlechter, deswegen haben wir das Klystron dorthin geschoben wo die
Bretter vorher waren.

SONY → 13,72l – Klystron verschoben, 30cm vom rechten Rand weg

Autospectrum(links) - Input (Real) \ FFT Analyzer

SONY → 13,72l – Ohne Klystron

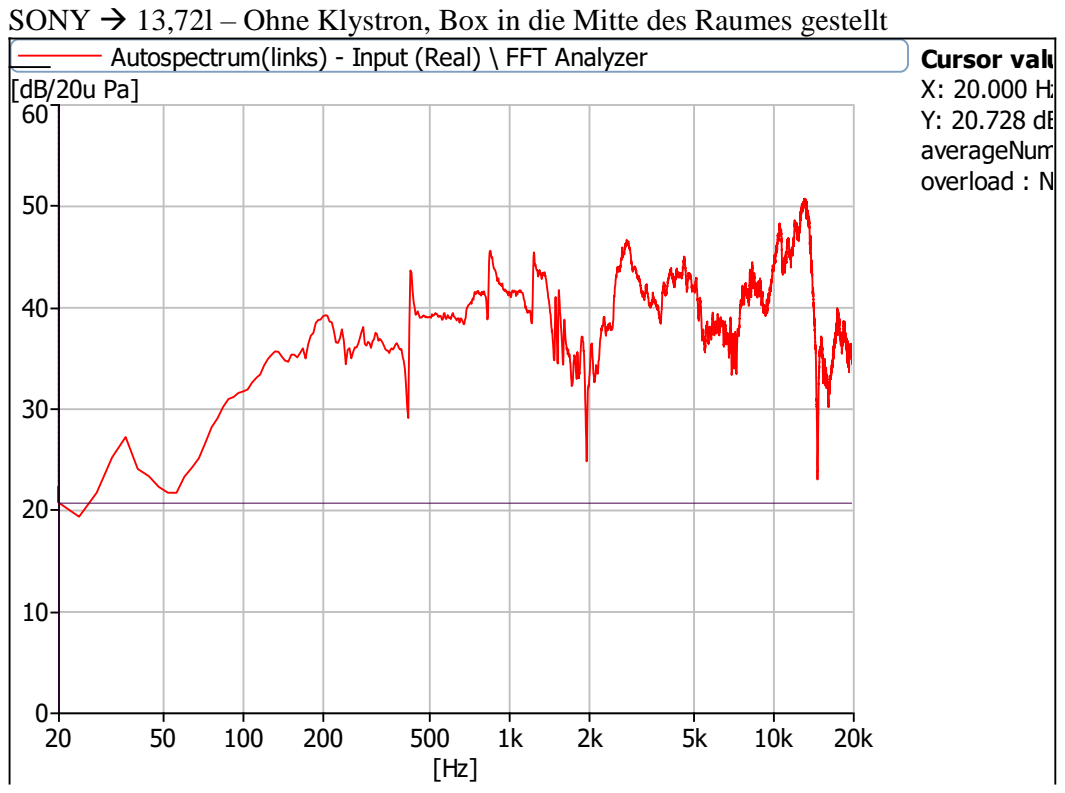
[picture p175: page 6]
Cursor values X: 20.000 Hz Y: 20.728 dB/20u Pa averageNumber : 100 overload : No

SONY → 13,72l – Ohne Klystron, Box in die Mitte des Raumes gestellt

Autospectrum(links) - Input (Real) \ FFT Analyzer

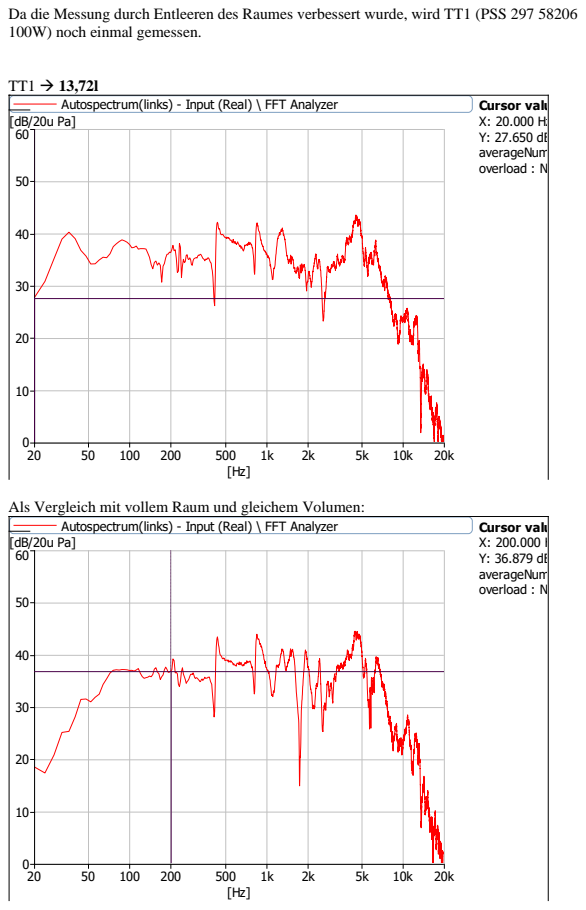
[picture p176: page 7]
Cursor values X: 20.000 Hz Y: 27.650 dB/20u Pa averageNumber : 100 overload : No; Cursor values X: 200.000 Hz Y: 36.879 dB/20u Pa averageNumber : 100 overload : No

Da die Messung durch Entleeren des Raumes verbessert wurde, wird TT1 (PSS 297 58206
100W) noch einmal gemessen.

Autospectrum(links) - Input (Real) \ FFT Analyzer

Als Vergleich mit vollem Raum und gleichem Volumen:

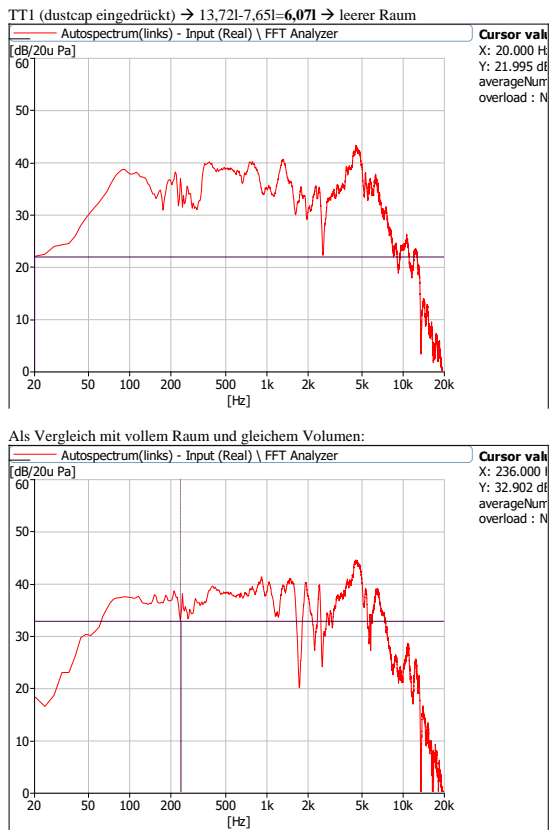
[picture p177: page 8]
Cursor values X: 20.000 Hz Y: 21.995 dB/20u Pa averageNumber : 100 overload : No; Cursor values X: 236.000 Hz Y: 32.902 dB/20u Pa averageNumber : 100 overload : No

TT1 (dustcap eingedrückt) → 13,72l-7,65l=6,07l → leerer Raum

Autospectrum(links) - Input (Real) \ FFT Analyzer

Als Vergleich mit vollem Raum und gleichem Volumen:

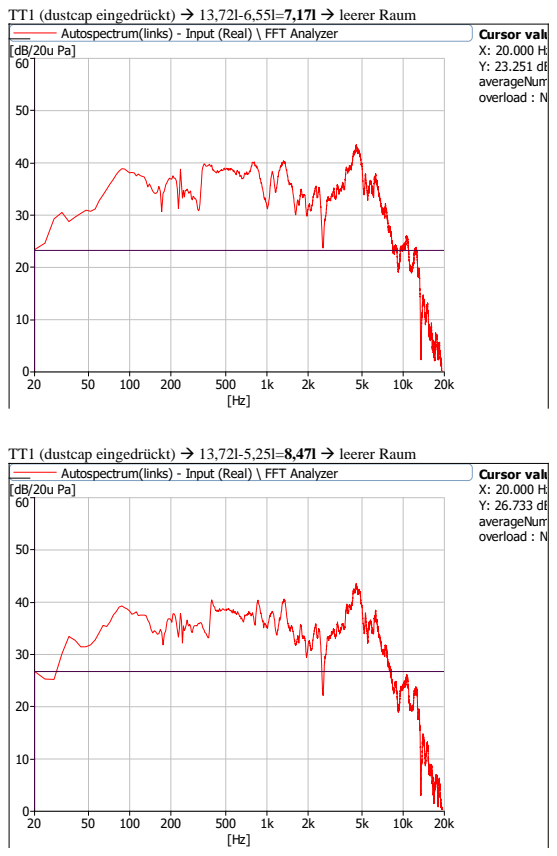
[picture p178: page 9]
Cursor values X: 20.000 Hz Y: 23.251 dB/20u Pa averageNumber : 100 overload : No; Cursor values X: 20.000 Hz Y: 26.733 dB/20u Pa averageNumber : 100 overload : No

TT1 (dustcap eingedrückt) → 13,72l-6,55l=7,17l → leerer Raum

Autospectrum(links) - Input (Real) \ FFT Analyzer

TT1 (dustcap eingedrückt) → 13,72l-5,25l=8,47l → leerer Raum

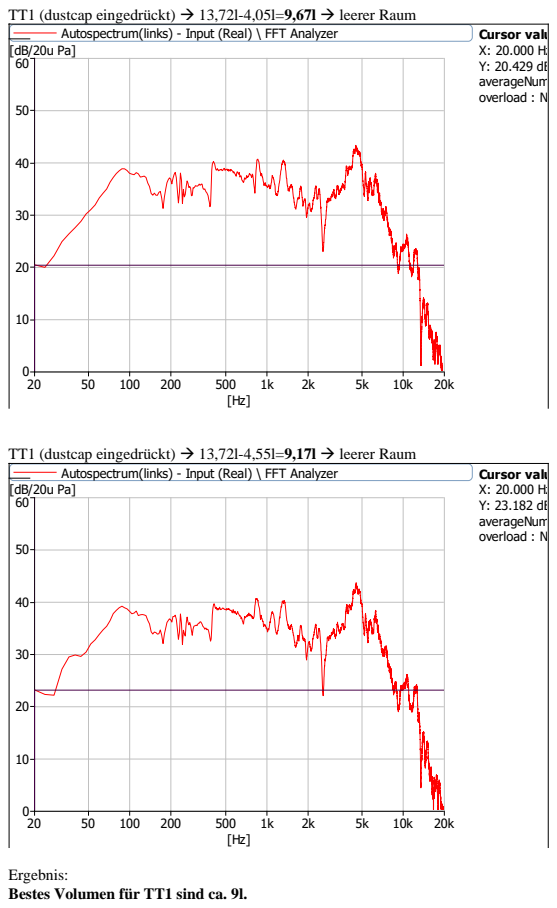
[picture p179: page 10]
Cursor values X: 20.000 Hz Y: 20.429 dB/20u Pa averageNumber : 100 overload : No; Cursor values X: 20.000 Hz Y: 23.182 dB/20u Pa averageNumber : 100 overload : No

TT1 (dustcap eingedrückt) → 13,72l-4,05l=9,67l → leerer Raum

Autospectrum(links) - Input (Real) \ FFT Analyzer

TT1 (dustcap eingedrückt) → 13,72l-4,55l=9,17l → leerer Raum

Ergebnis:
Bestes Volumen für TT1 sind ca. 9l.

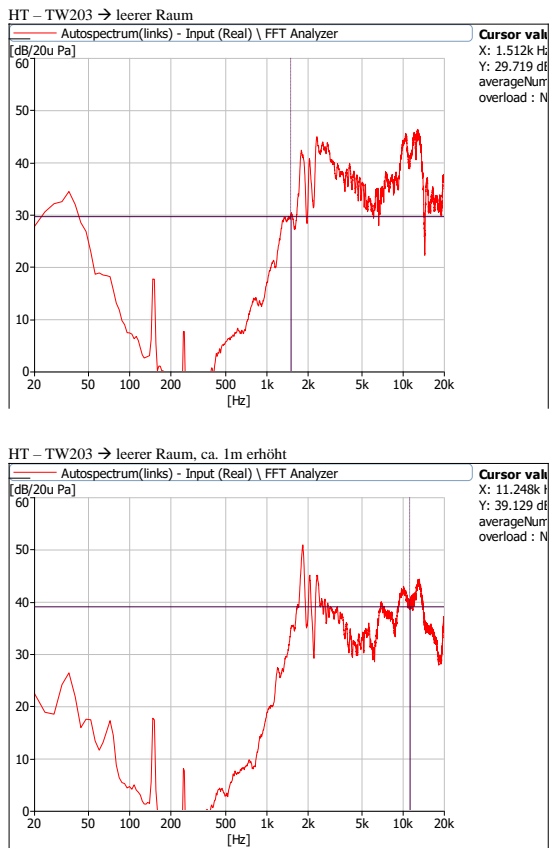
[picture p180: page 11]
Cursor values X: 1.512k Hz Y: 29.719 dB/20u Pa averageNumber : 100 overload : No; Cursor values X: 11.248k Hz Y: 39.129 dB/20u Pa averageNumber : 100 overload : No

HT – TW203 → leerer Raum

Autospectrum(links) - Input (Real) \ FFT Analyzer

HT – TW203 → leerer Raum, ca. 1m erhöht

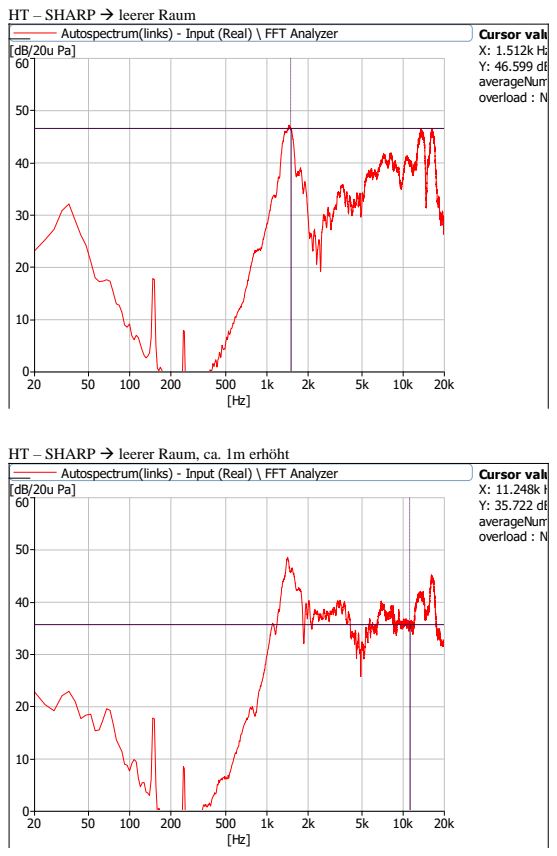
[picture p181: page 12]
Cursor values X: 1.512k Hz Y: 46.599 dB/20u Pa averageNumber : 100 overload : No; Cursor values X: 11.248k Hz Y: 35.722 dB/20u Pa averageNumber : 100 overload : No

HT – SHARP → leerer Raum

Autospectrum(links) - Input (Real) \ FFT Analyzer

HT – SHARP → leerer Raum, ca. 1m erhöht

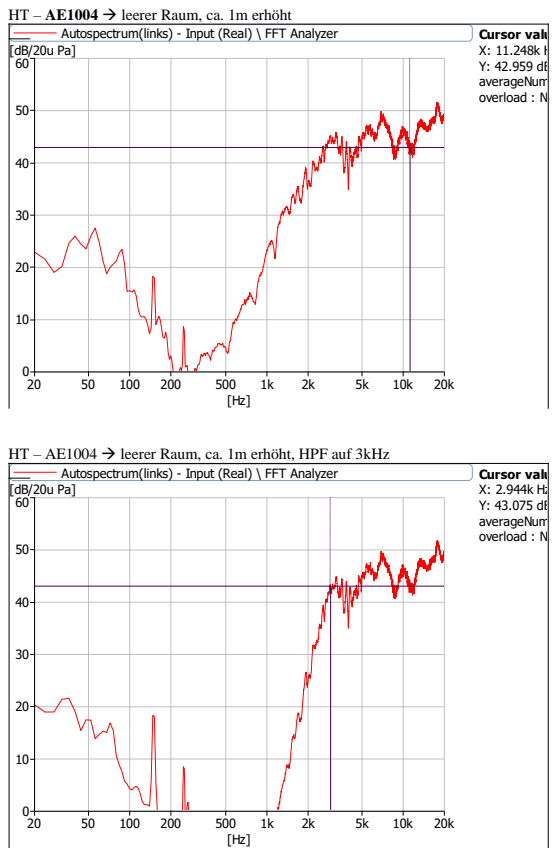
[picture p182: page 13]
Cursor values X: 11.248k Hz Y: 42.959 dB/20u Pa averageNumber : 100 overload : No; Cursor values X: 2.944k Hz Y: 43.075 dB/20u Pa averageNumber : 100 overload : No

HT – AE1004 → leerer Raum, ca. 1m erhöht

Autospectrum(links) - Input (Real) \ FFT Analyzer

HT – AE1004 → leerer Raum, ca. 1m erhöht, HPF auf 3kHz

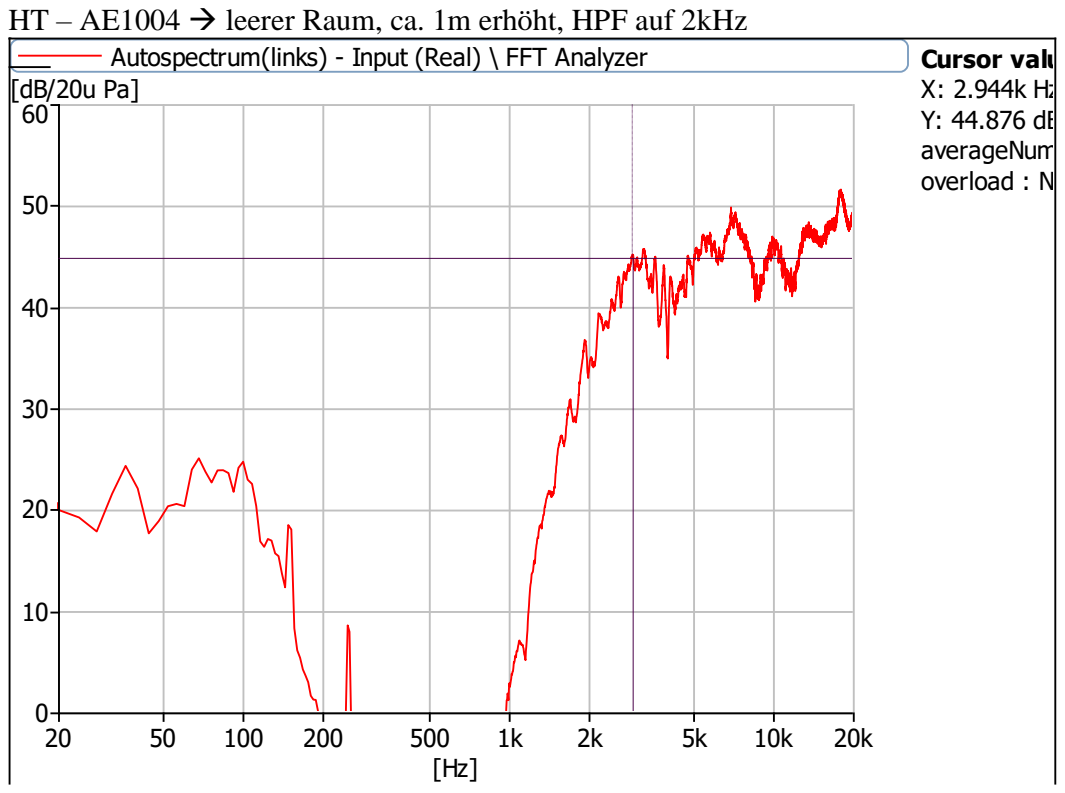
[picture p183: page 14]
Cursor values X: 2.944k Hz Y: 44.876 dB/20u Pa averageNumber : 100 overload : No

HT – AE1004 → leerer Raum, ca. 1m erhöht, HPF auf 2kHz

Autospectrum(links) - Input (Real) \ FFT Analyzer

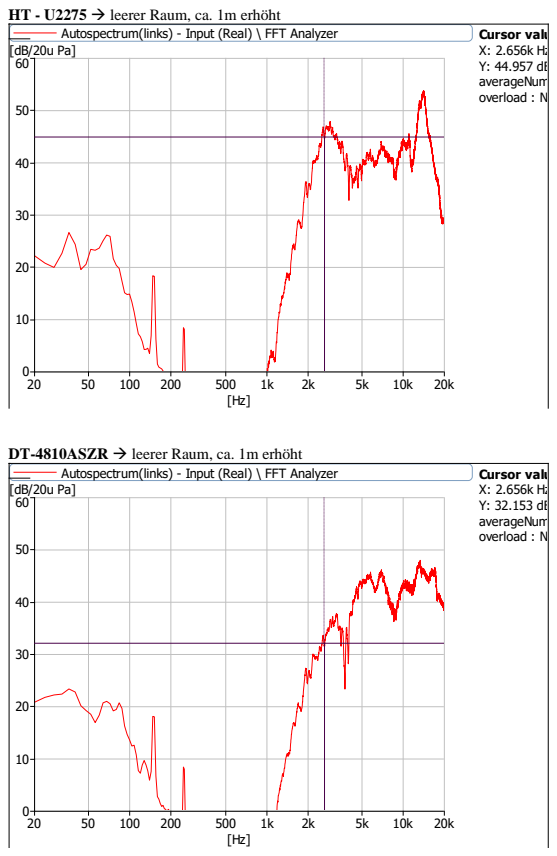
[picture p184: page 15]
Cursor values X: 2.656k Hz Y: 44.957 dB/20u Pa averageNumber : 100 overload : No; Cursor values X: 2.656k Hz Y: 32.153 dB/20u Pa averageNumber : 100 overload : No

HT - U2275 → leerer Raum, ca. 1m erhöht

Autospectrum(links) - Input (Real) \ FFT Analyzer

DT-4810ASZR → leerer Raum, ca. 1m erhöht

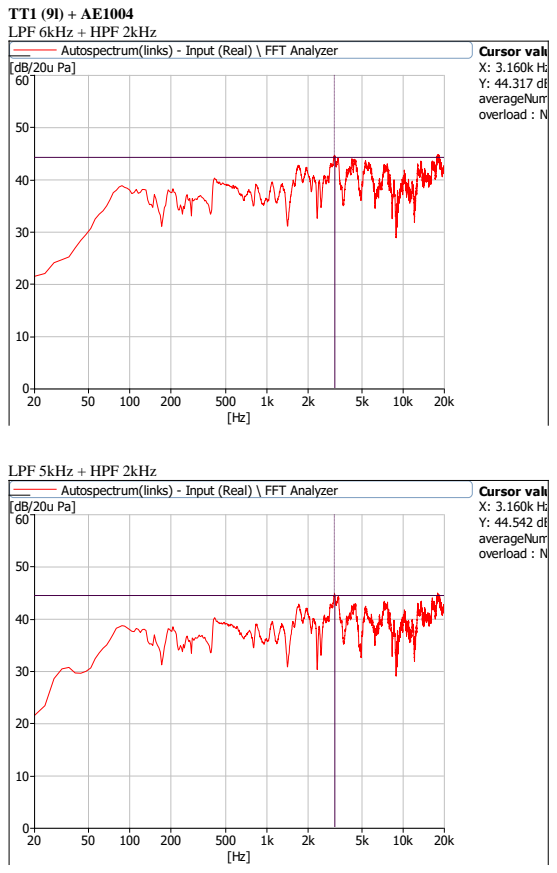
[picture p185: page 17]
TT1 (9l) + AE1004 LPF 6kHz + HPF 2kHz; Cursor values X: 3.160k Hz Y: 44.317 dB/20u Pa averageNumber : 100 overload : No; LPF 5kHz + HPF 2kHz; Cursor values X: 3.160k Hz Y: 44.542 dB/20u Pa averageNumber : 100 overload : No

Autospectrum(links) - Input (Real) \ FFT Analyzer

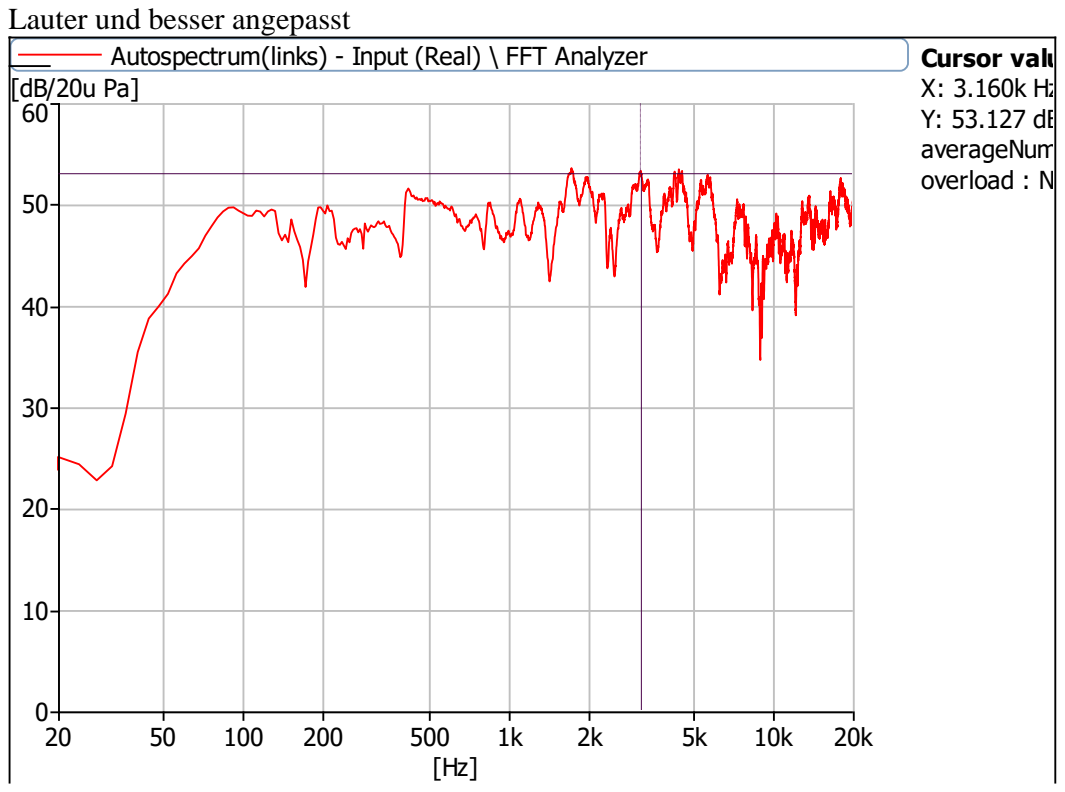
[picture p186: page 18]
Cursor values X: 3.160k Hz Y: 53.127 dB/20u Pa averageNumber : 100 overload : No

Lauter und besser angepasst

Autospectrum(links) - Input (Real) \ FFT Analyzer

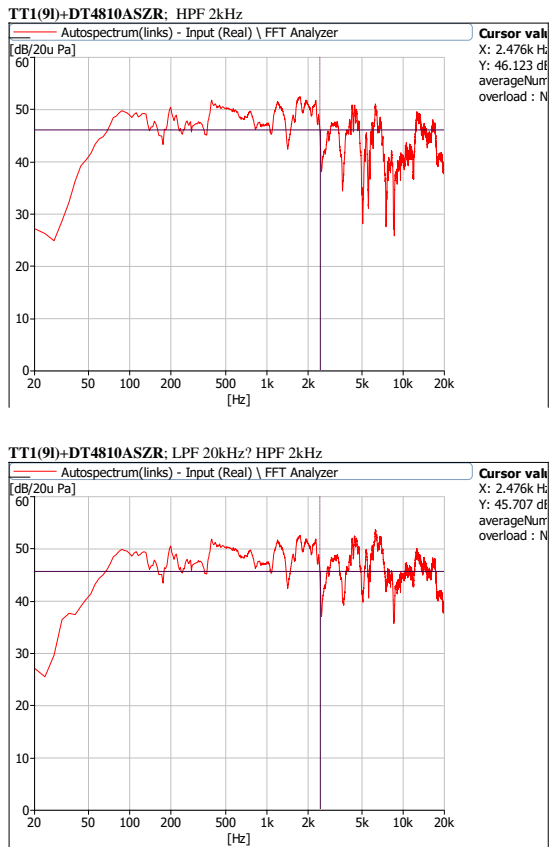
[picture p187: page 19]
TT1(9l)+DT4810ASZR; HPF 2kHz; Cursor values X: 2.476k Hz Y: 46.123 dB/20u Pa averageNumber : 100 overload : No; TT1(9l)+DT4810ASZR; LPF 20kHz? HPF 2kHz; Cursor values X: 2.476k Hz Y: 45.707 dB/20u Pa averageNumber : 100 overload : No

Autospectrum(links) - Input (Real) \ FFT Analyzer
