crazyskater9/Diplomarbeit/CD/Messungen/20170118-Vergleich_Ytong_zu_Styropor.pdf

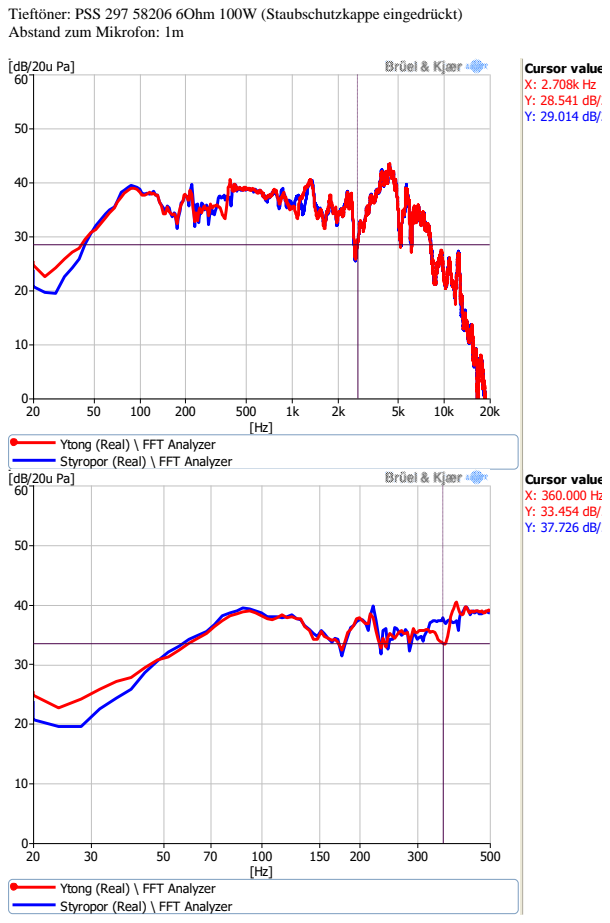
[picture p188: page 1]
Cursor values

Tieftöner: PSS 297 58206 6Ohm 100W (Staubschutzkappe eingedrückt)
Abstand zum Mikrofon: 1m

Ytong (Real) \ FFT Analyzer
Styropor (Real) \ FFT Analyzer

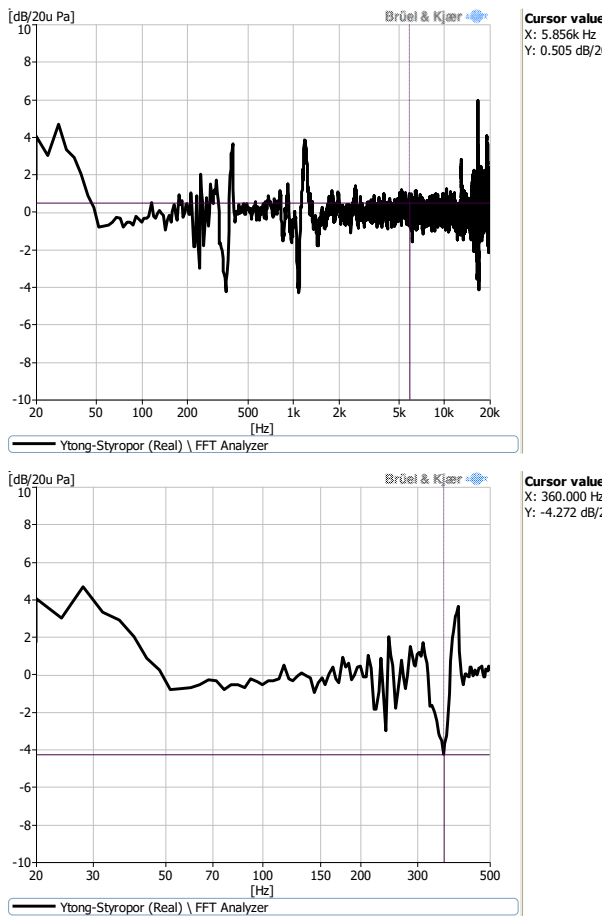
[picture p189: page 2]
Cursor values

Ytong-Styropor (Real) \ FFT Analyzer

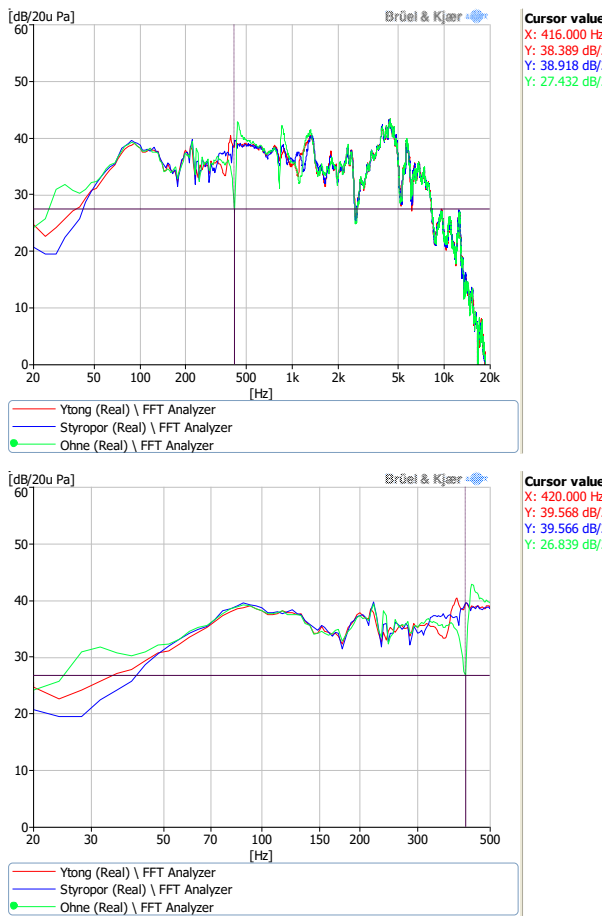
[picture p190: page 3]
Cursor values

Ytong (Real) \ FFT Analyzer
Styropor (Real) \ FFT Analyzer
Ohne (Real) \ FFT Analyzer
