crazyskater9/Diplomarbeit/CD/Messungen/20170201-MessungVisatonHT.pdf

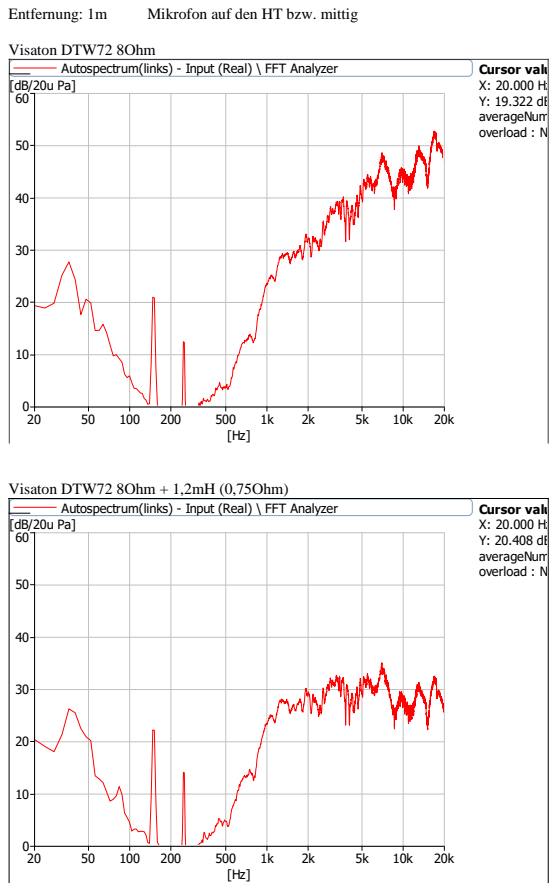
[picture p191: page 1]
Entfernung: 1m; Mikrofon auf den HT bzw. mittig; Visaton DTW72 8Ohm; Cursor values X: 20.000 Hz Y: 19.322 dB/20u Pa averageNumber : 100 overload : No; Visaton DTW72 8Ohm + 1,2mH (0,75Ohm); Cursor values X: 20.000 Hz Y: 20.408 dB/20u Pa averageNumber : 100 overload : No

Autospectrum(links) - Input (Real) \ FFT Analyzer

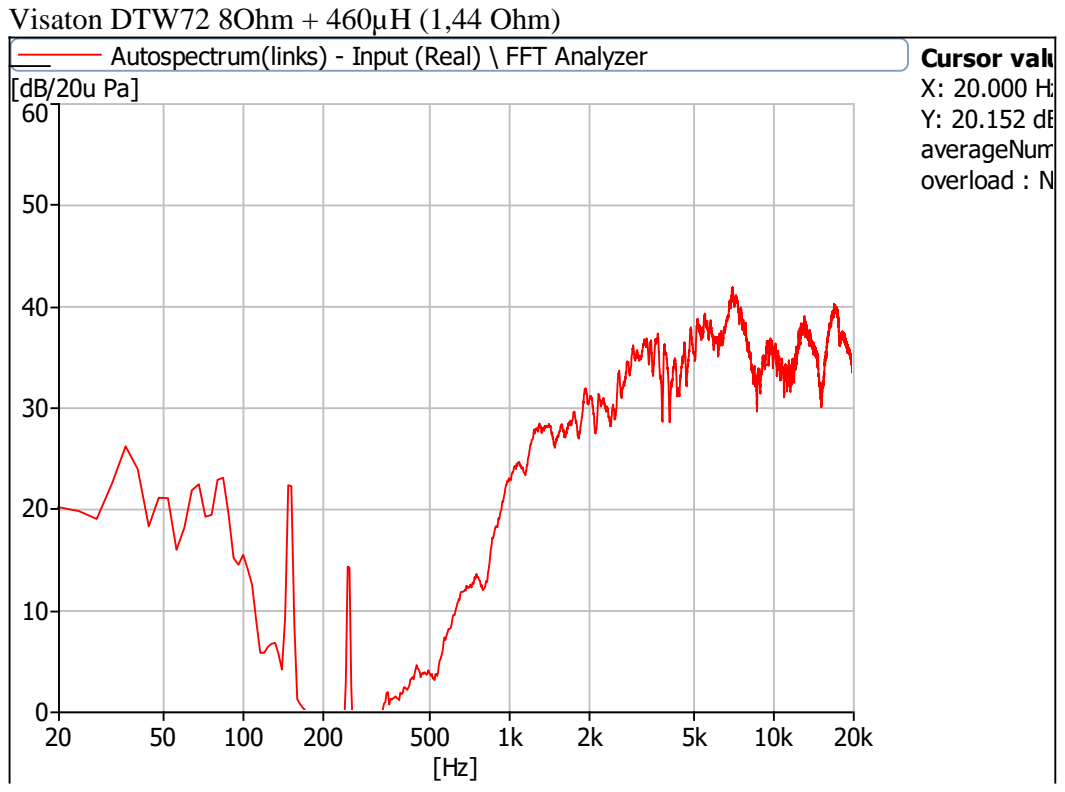
[picture p192: page 2]
Visaton DTW72 8Ohm + 460µH (1,44 Ohm); Cursor values X: 20.000 Hz Y: 20.152 dB/20u Pa averageNumber : 100 overload : No

Autospectrum(links) - Input (Real) \ FFT Analyzer

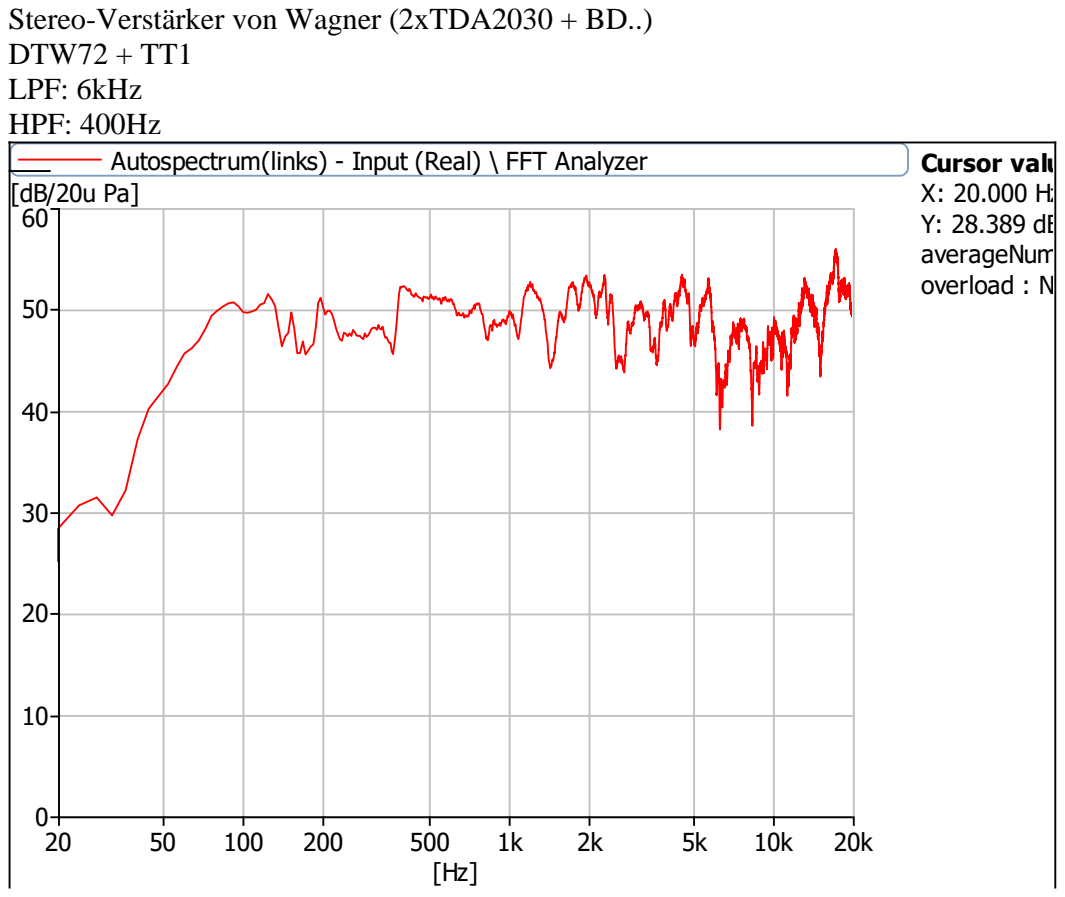
[picture p193: page 3]
Cursor values X: 20.000 Hz Y: 28.389 dB/20u Pa averageNumber : 100 overload : No

Stereo-Verstärker von Wagner (2xTDA2030 + BD..)
DTW72 + TT1
LPF: 6kHz
HPF: 400Hz

Autospectrum(links) - Input (Real) \ FFT Analyzer
