crazyskater9/Diplomarbeit/CD/Messungen/Vergleich_Ziegel_Styropor.pdf

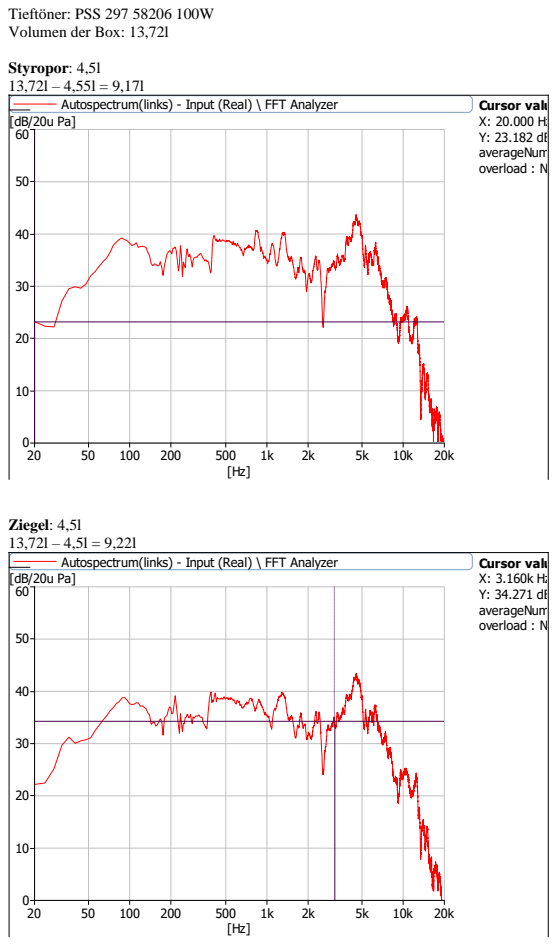
[picture p194: page 1]
Styropor: 4,5l 13,72l – 4,55l = 9,17l; Cursor values X: 20.000 Hz Y: 23.182 dB/20u Pa averageNumber : 100 overload : No; Ziegel: 4,5l 13,72l – 4,5l = 9,22l; Cursor values X: 3.160k Hz Y: 34.271 dB/20u Pa averageNumber : 100 overload : No

Tieftöner: PSS 297 58206 100W
Volumen der Box: 13,72l

Autospectrum(links) - Input (Real) \ FFT Analyzer
