crazyskater9/Diplomarbeit/(list of files, drawings)

Other design files:
CD/AltiumFiles/BlockschaltbildV4.SchDoc
CD/AltiumFiles/BlockschaltbildV4_eng.SchDoc
CD/AltiumFiles/DiplAltiumLib/Dipl_Library.PcbLib
CD/AltiumFiles/DiplAltiumLib/Dipl_Library.SchLib
