crazyskater9/Diplomarbeit/(commit log)

2017-02-06 3_mTTWeich_u_Addierer
    Beginn der Schaltungserklärung
2017-02-07 Inhaltssruktur angepasst
    Mach bitte die captions unter den Bildern ^^
    Sonst super Arbeit, ich schreib morgen was...
2017-02-08 11:50:00-08.02.2017-Print3_u_Print4
    Print3 soweit "beendet"
    Prin4 begonnen
    Bei Label-Verweisstruktur bitte auf Verzeichnis achten. Soll heißen: Im
    Kapitel 5.1.4 das Label des ersten Bildes wäre "\label{fig:abb5.1.4.1}"
    . Thx :)
2017-02-08 Änderungen an 4_TTuHT... Erstellen von 5_TTVerst...
    Wennst Zeit und Nerven hast, irgendwie sind die vielen Bilder dann nicht
    schön geordnet so wie ich es geglaubt habe im Syntax geschrieben zu
    haben... Wenn du eine Idee hast wäre ich dir dankbar ':D
2017-02-10 Fixes und Grundlagen zu Grundlagen
    Hab die Fixes von gestern mit dem \label{kap:2.3.1} weiter geführt weil
    des hab ich in den anderen Dokumenten auch gehabt --> es sollt jetzt
    überall von mir geschriebenen Datein : sec und subsec verwendet worden
    sein.
    Die \begin{figure} sollten danach immer den [H] tag verwendet haben.
    Die Grundlagen wie Filter und TDA2030 und Designregeln hab ich
    hingegeben wo sie hingehören und dementsprechend die Labels angepasst.
    Natürlich hab ich die Grundlagen auch etwas umgeschrieben ^^
2017-02-10 Grundlagen ergänzen
    in 3_mTT... sollte zur Gänze die Grundlagen herausen und verlinkt sein
    4_TTuHT... sollte es aus dem allgemeinen entfernt worden sein
2017-02-10 Gitignore hinzugefügt
    Es werden nur noch die wichtigen Dateien gesynct
    --> Verhindert Merge Fails
2017-02-11 Deutsch-Fixes und Quellenangaben als Fußnote
2017-02-16 BT-Modul hinzugefügt & Documenttype geändert
    Von Report auf book geändert!
    Macht das ganze Dokument zweiseitig (für Kopf und Fußzeile!
    Man muss aber noch ändern, dass Kapitel nicht nur auf der linken Seite
    beginnt!
2017-02-16 Auf Report geändert und zweiseitig gemacht
2017-02-16 BTModul angepasst an Diplomarbeit
    Labels angepasst und kleine Änderungen vorgenommen
2017-02-17 TT_Messungen & Verbesserungen
    Ein Bild ist jetzt Querformat, weils besser ausschaut.
    Subwoofer-Messungen sind hinzugefügt (Bis jetzt nur der Vergleich
    zwischen Renkforce und Visaton)
    Wir sollten noch Messungen mit anderen Volumina hinzufügen
2017-03-01 Dokumentation-de fertiggestellt
2017-03-03 TT_Messungen
    Woofer --> Zeilenende angepasst und kleine Ergänzungen bzw Vorschläge
    vermerkt.
2017-03-05 Versorgungskonzept hinzugefügt & PDF-Größe verringert
    Hab die Qualität der Bilder im Messaufbau verringert, man sieht aber
    keinen Unterschied :+1:
    Von 50MB -> 18MB
2017-03-09 Einrückung des Inhaltsverzeichnis geändert
2017-03-09 Beginnen des Detaillesens
2017-03-11 A lot of changes
    Inhaltsverzeichnis sortieren/anpassen
    Verstärker/Weichen anpassen
    BT-Modul anpassen
    VerwendeteTools erstellen und anpassen
2017-03-11 Inhaltsverzeichnis und Dateien angepasst
2017-03-12 Anpassungen und Verbesserungen bei den Verstärkern und Weichen
    WICHTIGE INFO:
    Wenn Texte und Bilder zu weit auseinander sind, passt das Bild nicht
    mehr auf die Seite auf der es sein sollte!
    Also das Bild kleiner machen oder auf die nächste Seite bringen damit
    die Formatierung wieder normal ist!
2017-03-13 Label-Fixes im Anhang und Grundlagen ausgebessert
2017-03-13 HT-Messungen und Beginn der Optimierung
2017-03-13 Kleinere Adaptionen und anpassen der Labels
    Labels in Verstärker,Weichen,TT_Messungen,"HT-Messungen",Messaufbau und
    BT_Modul angepasst.
    Am Kopf der Tex Datei sollte das jeweilige Grundlabel als ToDo vermärkt
    Bei HT_Messungen hab ich eine Satzstellung angepasst.
    Bei Betriebsw. das LOL raus^^
    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
2017-03-18 Abkürzungen ergänzt und Schem angepasst
2017-03-18 Vergleich StyroZiegel und SubOptimierung
2017-03-18 TTOptimierung, WIR beginnen
2017-03-21 durchlesen und verbessern
2017-03-22 Anfangen des Verbesserns der Grundlagen
2017-03-23 Mini Change und Bilder add
2017-03-23 WIR-TEIL-Materialkosten
    R+C+ELKO hinzugefügt, anderes als Kommentar
2017-03-23 Mehrweg-Lautsprecher-Systeme , Blockschaltbild
    1. Überarbeiten nach Wagner Vorgaben und Wünsche(Vorschläge) bis
    Lautsprecher-Systeme 2.1
    2. Blockschaltbild v4 nach Wagner-Wünsche anpassen und in die
    Dokumentations-Files einbauen.
2017-03-24 Erklärung 5.1 und begin Bluetooth zu erweitern
2017-03-24 Verbesserungen Grundlagen
    wos isn des immer mit dem "zu mindestens" ^^
2017-03-25 WIR-Excel
    Passive Bauelemente von:
    1x mTT-Weiche
    1x HTuTTWeiche
    2x HT-Verstärker
    2x TT-Verstärker
    1x Hauptboard
    1x Frontpanel
    Mach dann später weiter, wenn du vorher was änderst(oder ändern willst)
    gib mir bescheid :)
    [WIR-Teil.xlsx]
2017-03-25 Überarbeiten und WIR-Teil nach Vorlage beginnen
    [WIR-Teil.xlsx]
2017-03-26 Grundlegende Überarbeitung
    und Beginnen von durchlesen und verbessern von Kap. 4
2017-03-26 4.2 und 4.3 Korrekturlesen und ausbessern
2017-03-28 Datenblätter & Blockschaltbild V999
    Datenblatt TDA2030 und DTW 72-8
2017-03-28 Arbeitsnachweis (form) & kleinere Anpassungen
    [Arbeitsnachweis.xlsx, Arbeitsstunden.xlsx, WIR-Teil.xlsx]
2017-03-28 Printpläne hinzugefügt und angepasst
2017-03-28 Arbeitsnachweis einbinden und Diplseminar beginnen
    [Arbeitsnachweis.xlsx, WIR-Teil.xlsx]
2017-03-29 WIR-Teil , Dipl-Seminar
    BTW Stefan(leeb) macht uns die Boxen gscheida in an CAD :+1:
    [WIR-Teil.xlsx]
2017-03-29 Boxen-Design einbaun, verbessern
    [WIR-Teil.csv, WIR-Teil.xlsx]
2017-03-30 Verbesserung
    Nach Phü, Clemens und meiner Mum
    Stunden bei mir anpassen ^^
    [Arbeitsnachweis.xlsx, WIR-Teil.xlsx]
2017-04-02 CD-Files herrichten
    [BlockschaltbildV4.SchDoc, BlockschaltbildV4_eng.SchDoc, Dipl_Library.PcbLib, Dipl_Library.SchLib]
